qman122/thesetupedit/c5-shroud/mockup/renders/2_head_on_sleepy.png

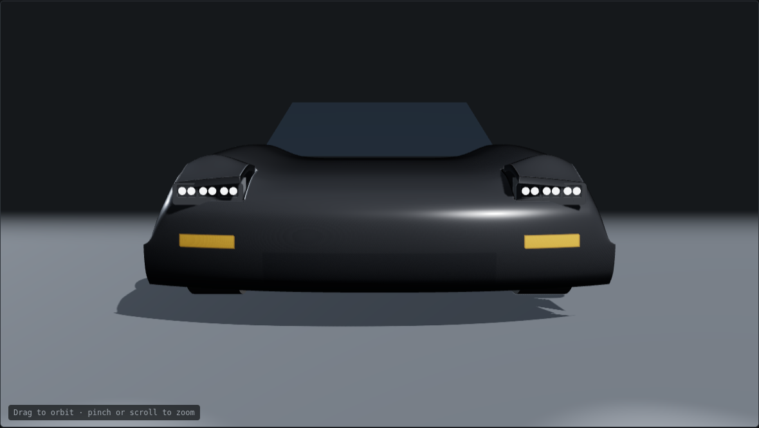
c5-shroud/mockup/renders/2_head_on_sleepy.png
