qman122/thesetupedit/c5-shroud/mockup/renders/4_close_up_full_up.png

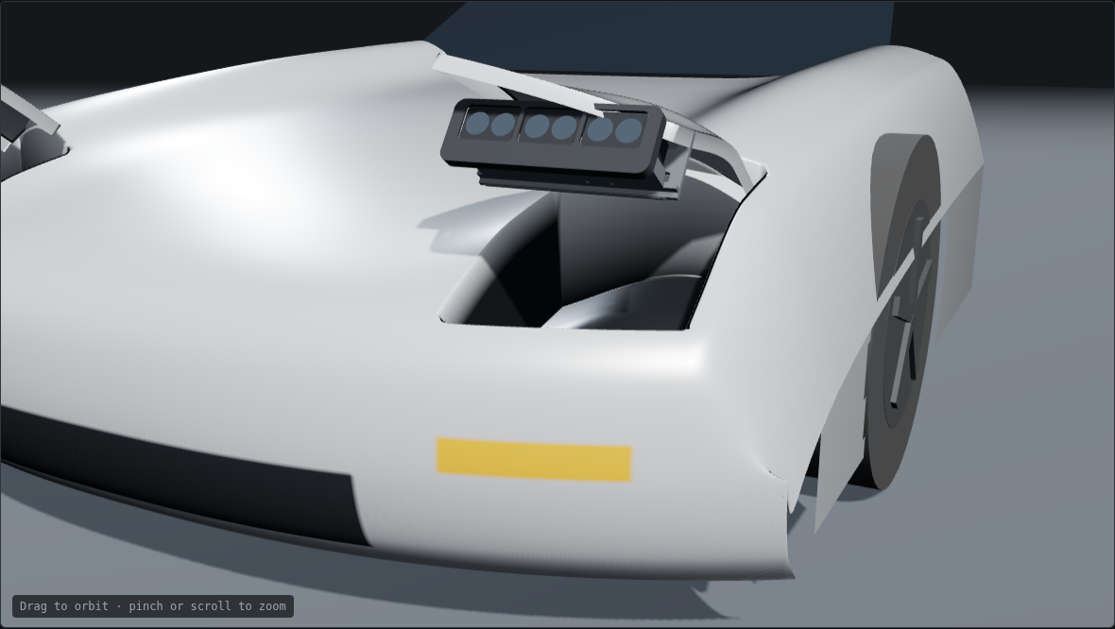
c5-shroud/mockup/renders/4_close_up_full_up.png
