qman122/thesetupedit/c5-shroud/preview/bezel_concepts.png

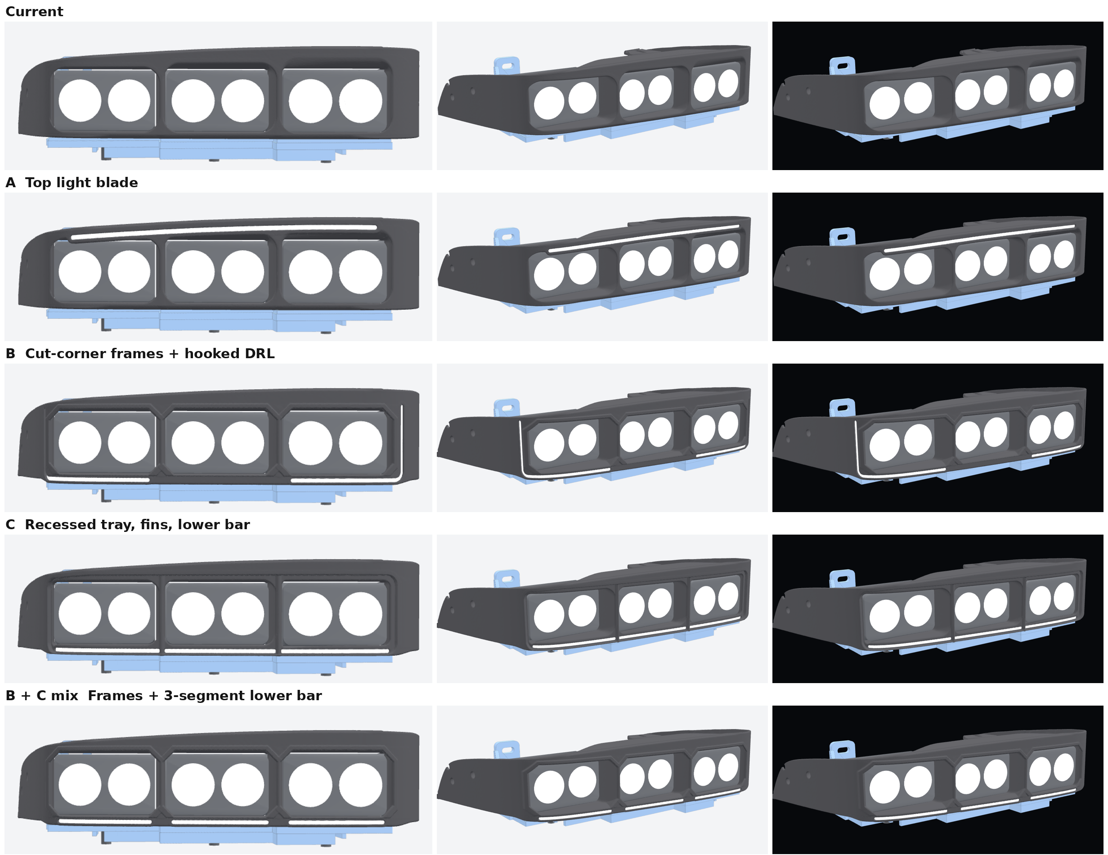
c5-shroud/preview/bezel_concepts.png
