qman122/thesetupedit/docs/img/cable.jpg

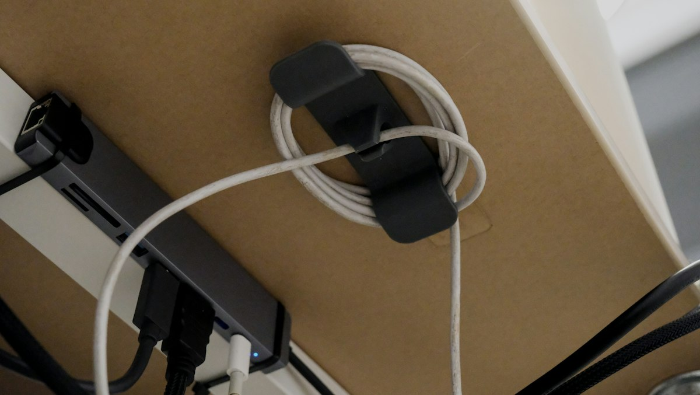
docs/img/cable.jpg
