qman122/thesetupedit/docs/img/hero.jpg

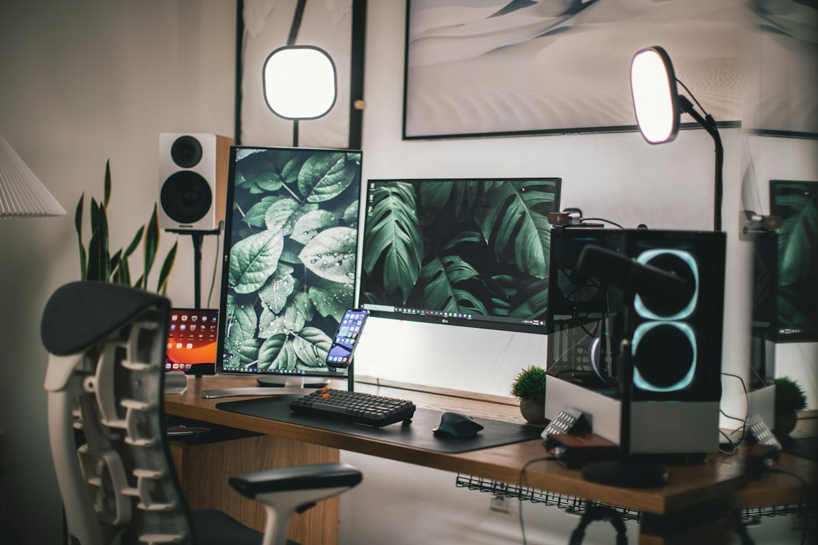
docs/img/hero.jpg
