qman122/thesetupedit/docs/img/minimal.jpg

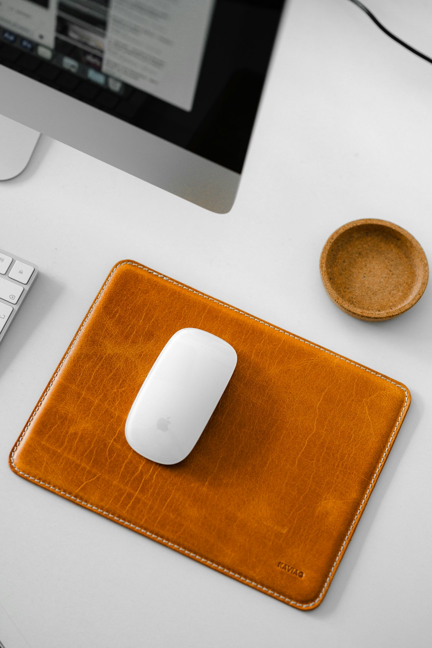
docs/img/minimal.jpg
