qman122/thesetupedit/docs/img/web/backlight-800.jpg

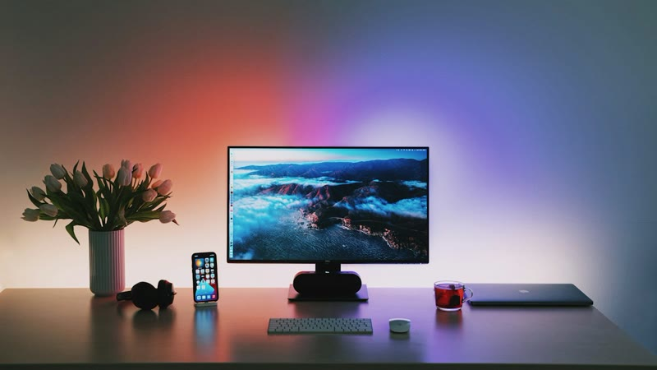
docs/img/web/backlight-800.jpg
