qman122/thesetupedit/docs/img/web/bedroom-480.jpg

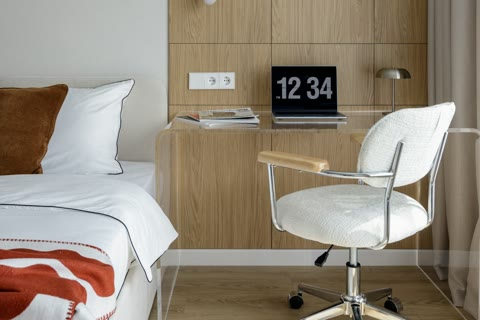
docs/img/web/bedroom-480.jpg
