qman122/thesetupedit/docs/img/web/clean-desk-480.webp

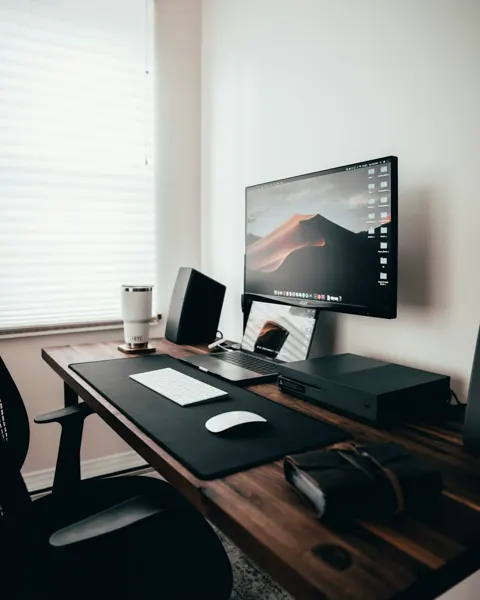
docs/img/web/clean-desk-480.webp
