qman122/thesetupedit/docs/img/web/desk-lamp-480.webp

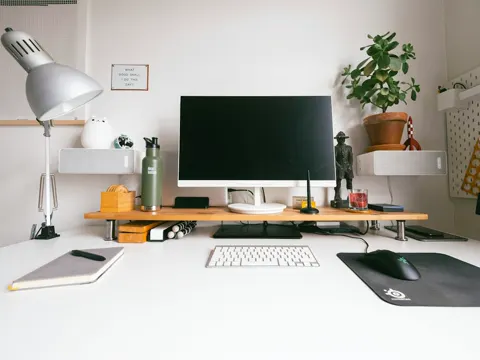
docs/img/web/desk-lamp-480.webp
