qman122/thesetupedit/docs/img/web/small-480.webp

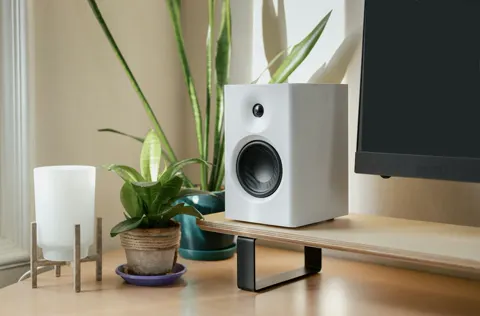
docs/img/web/small-480.webp
