qman122/thesetupedit/docs/img/web/standing-480.jpg

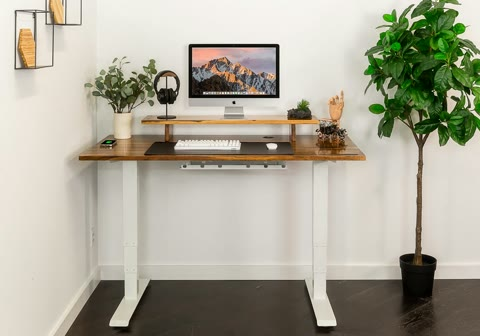
docs/img/web/standing-480.jpg
