qman122/thesetupedit/docs/img/web/trading-800.webp

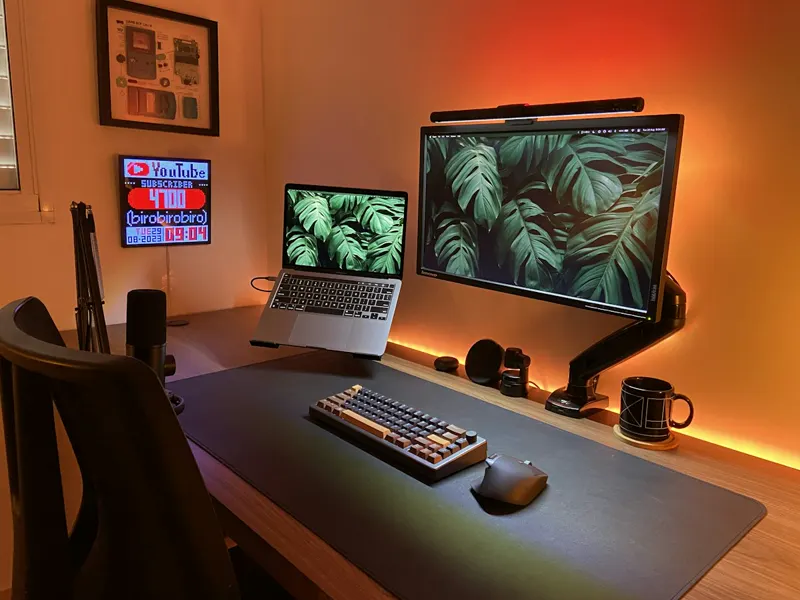
docs/img/web/trading-800.webp
