qman122/thesetupedit/docs/img/web/video-call-480.jpg

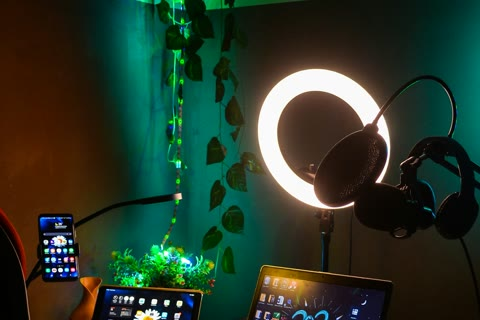
docs/img/web/video-call-480.jpg
