qman122/thesetupedit/docs/img/web/wrist-480.jpg

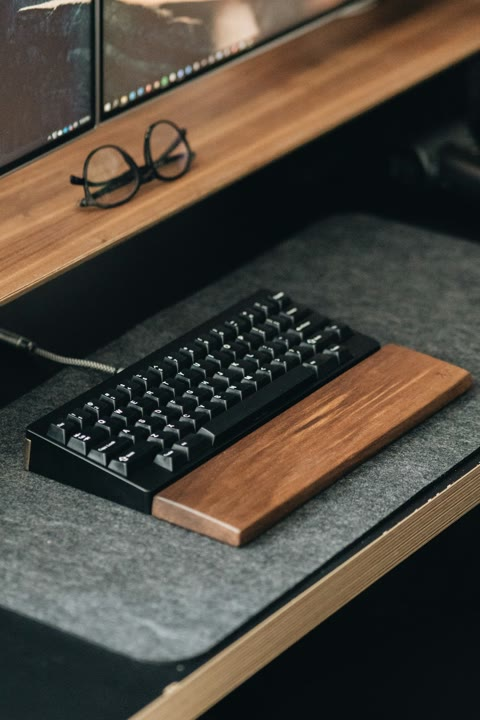
docs/img/web/wrist-480.jpg
