qman122/thesetupedit/docs/media/b3/b3-01-wood-monitor-riser.png

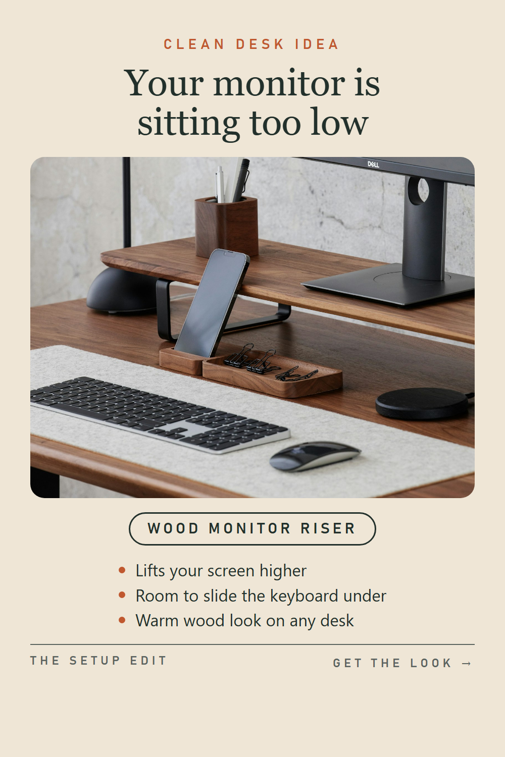
docs/media/b3/b3-01-wood-monitor-riser.png
