qman122/thesetupedit/docs/media/b3/b3-03-ba-stop-hiding-cables.png

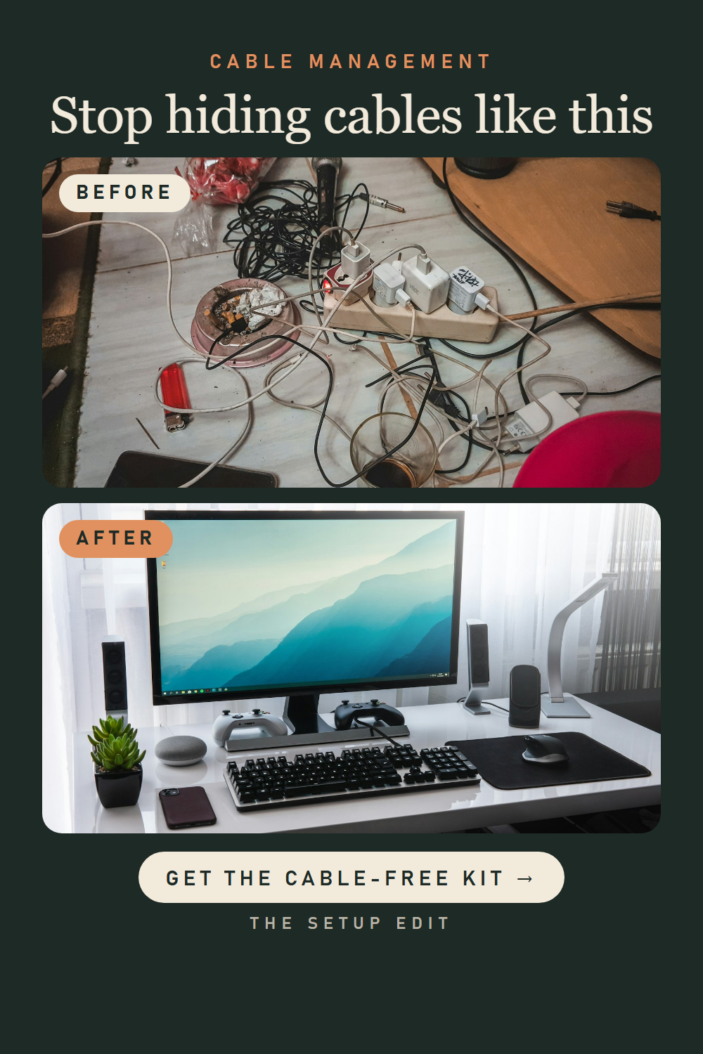
docs/media/b3/b3-03-ba-stop-hiding-cables.png
