qman122/thesetupedit/docs/media/b3/b3-04-75-wireless-keyboard.png

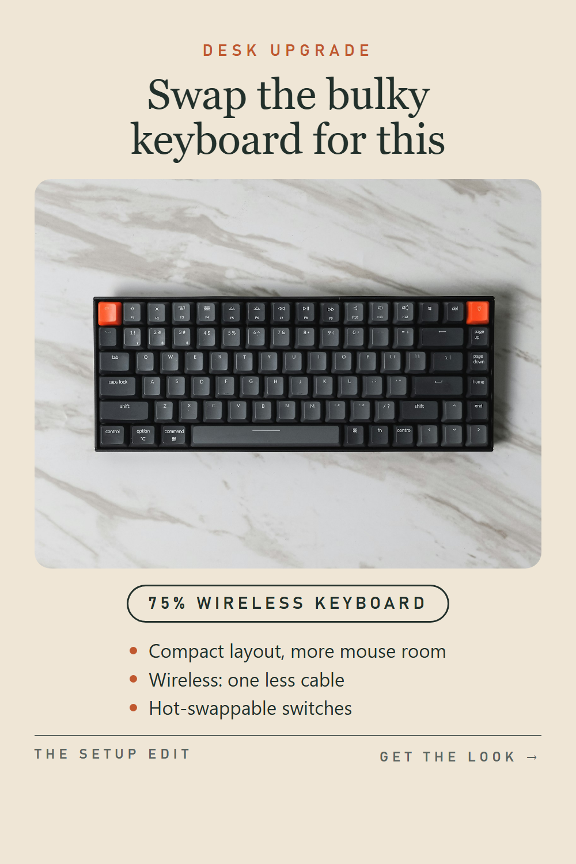
docs/media/b3/b3-04-75-wireless-keyboard.png
