qman122/thesetupedit/docs/media/b3/b3-05-split-cable-sleeve.png

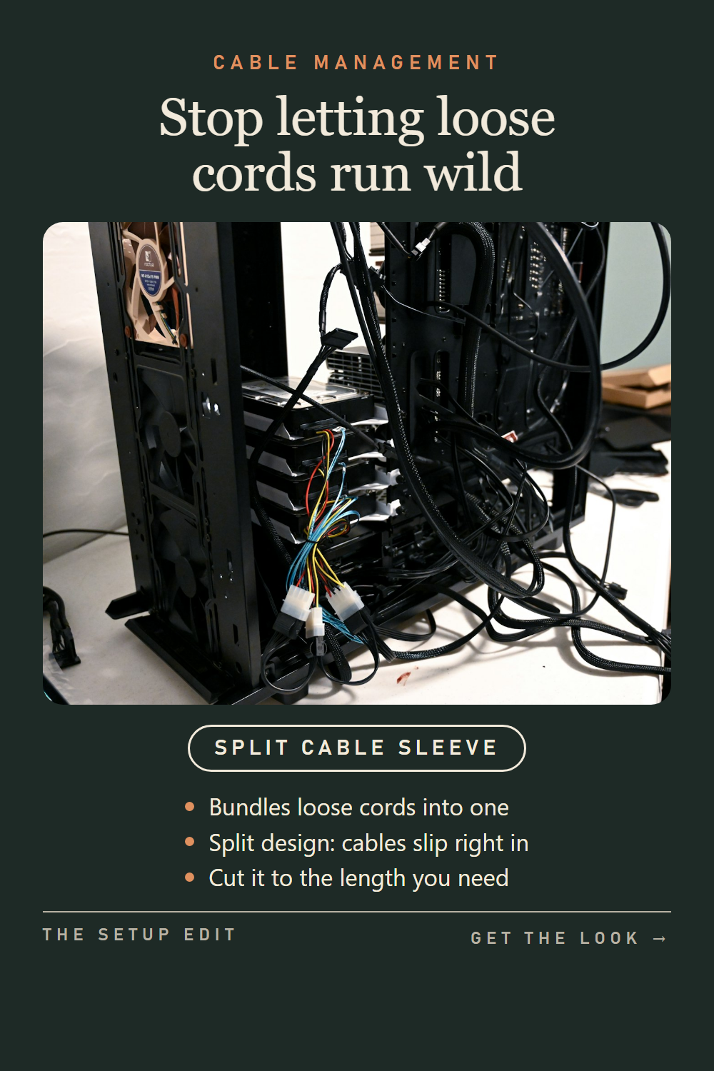
docs/media/b3/b3-05-split-cable-sleeve.png
