qman122/thesetupedit/docs/media/b3/b3-06-small-wall-desk.png

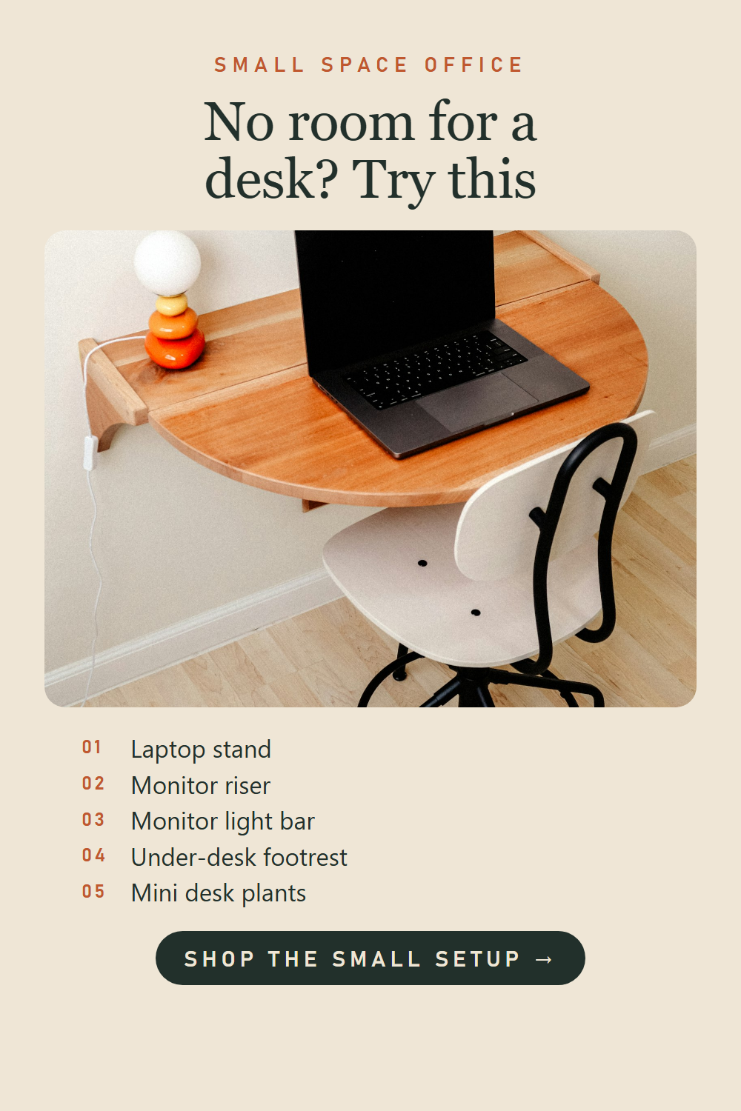
docs/media/b3/b3-06-small-wall-desk.png
