qman122/thesetupedit/docs/media/b3/b3-08-felt-desk-mat.png

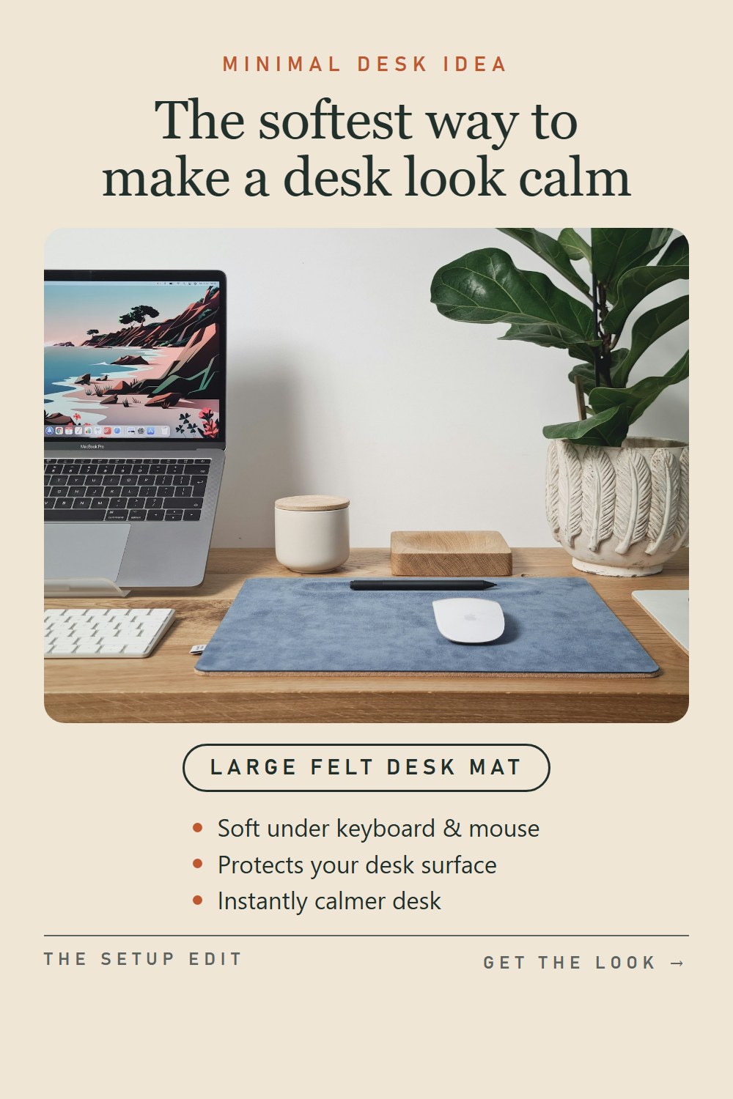
docs/media/b3/b3-08-felt-desk-mat.png
