qman122/thesetupedit/docs/media/b3/b3-14-clean-minimal-desk.png

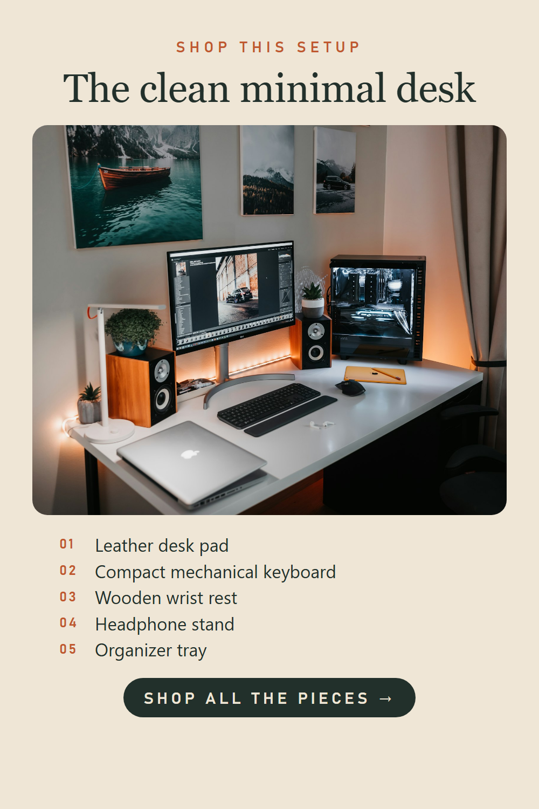
docs/media/b3/b3-14-clean-minimal-desk.png
