qman122/thesetupedit/docs/media/b3/b3-18-trader-checklist.png

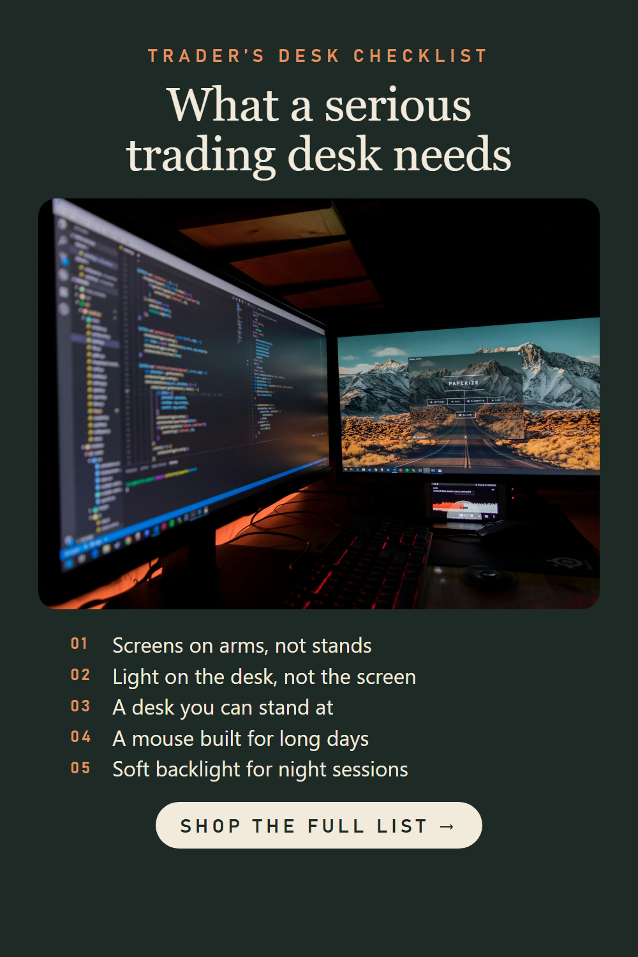
docs/media/b3/b3-18-trader-checklist.png
