qman122/thesetupedit/docs/media/b3/b3-21-bedroom-office.png

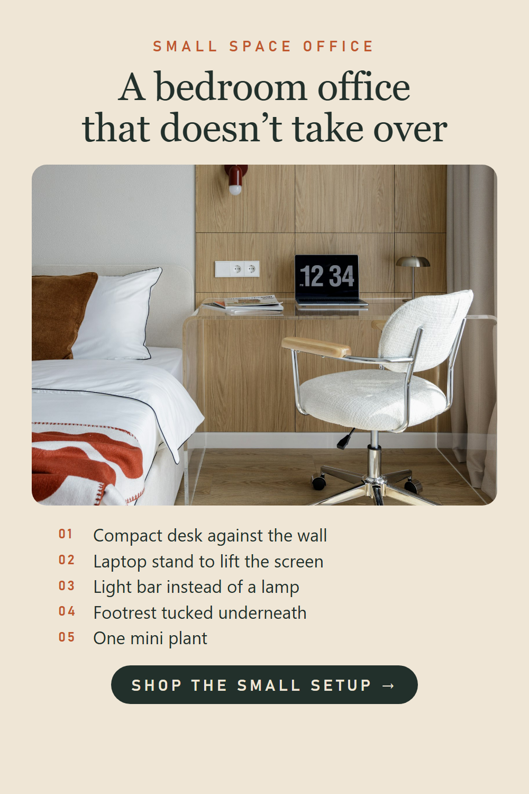
docs/media/b3/b3-21-bedroom-office.png
