qman122/thesetupedit/docs/media/b3/b3-23-two-tier-organizer.png

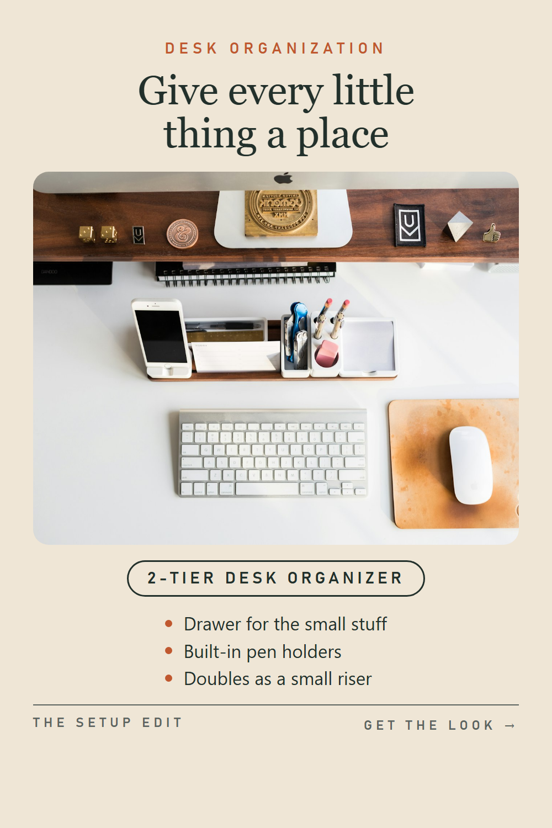
docs/media/b3/b3-23-two-tier-organizer.png
