qman122/thesetupedit/docs/media/b3/b3-24-ba-chaos-to-calm.png

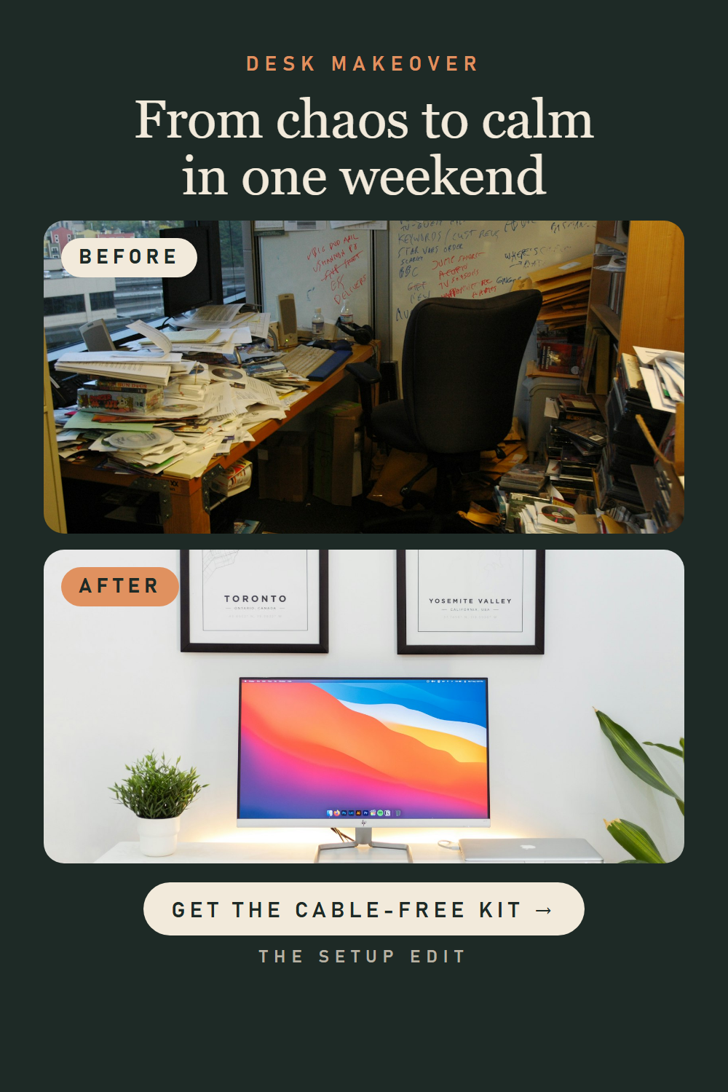
docs/media/b3/b3-24-ba-chaos-to-calm.png
