qman122/thesetupedit/docs/media/b3/b3-25-monitor-light-bar.png

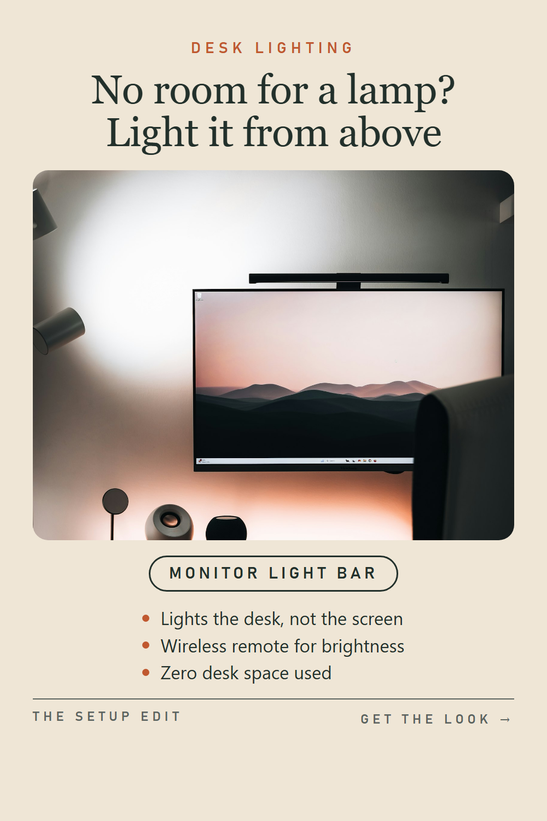
docs/media/b3/b3-25-monitor-light-bar.png
