qman122/thesetupedit/docs/media/b3/b3-26-triple-monitor-base.png

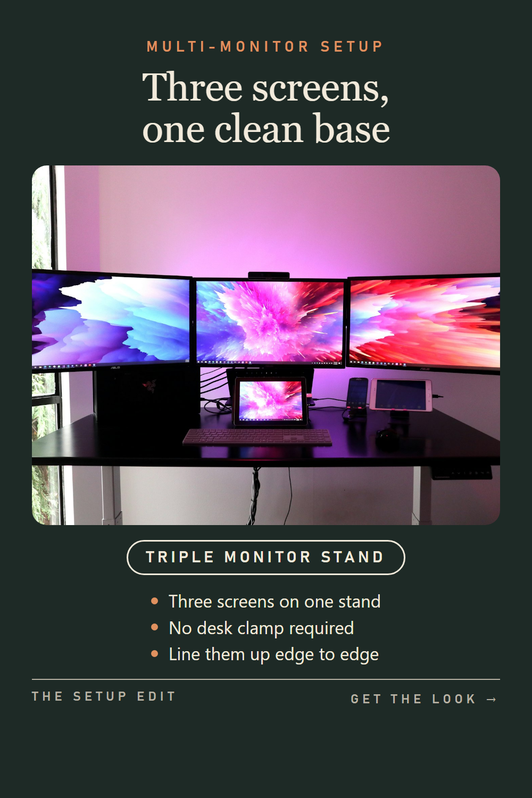
docs/media/b3/b3-26-triple-monitor-base.png
