qman122/thesetupedit/docs/media/b3/b3-28-multi-device-mouse.png

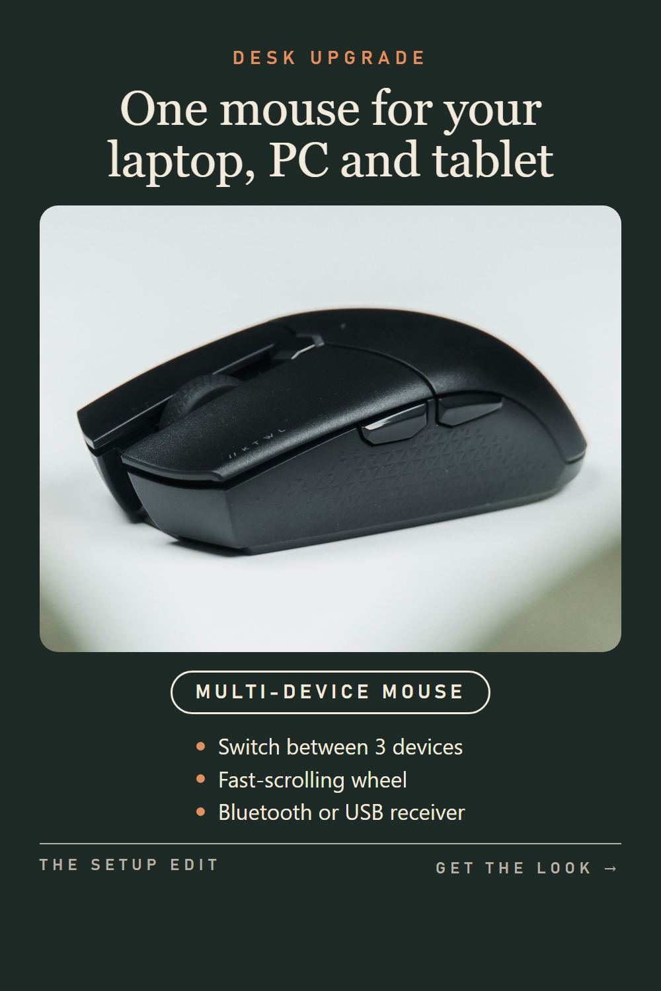
docs/media/b3/b3-28-multi-device-mouse.png
