qman122/thesetupedit/docs/media/b3/b3-30-1080p-webcam.png

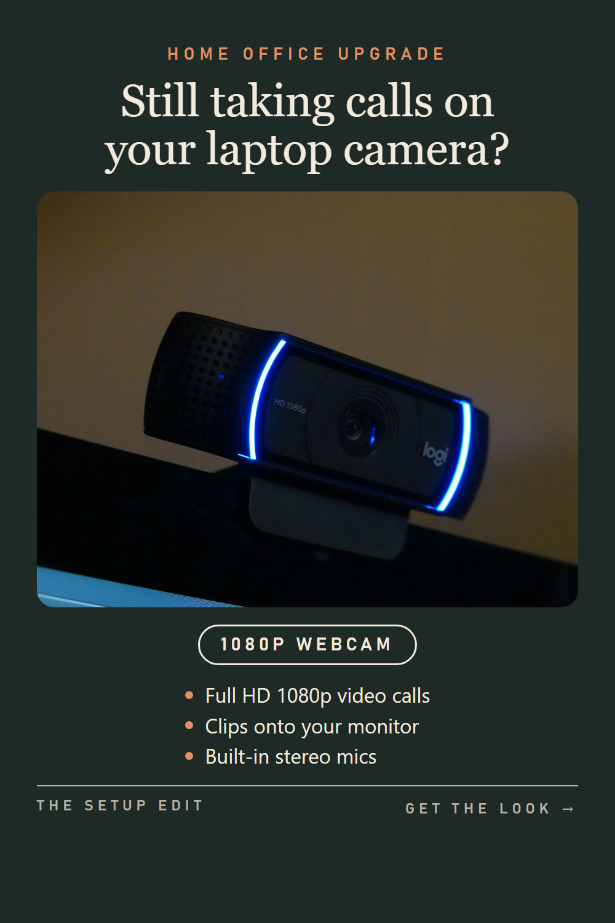
docs/media/b3/b3-30-1080p-webcam.png
