qman122/thesetupedit/docs/media/b3/b3-31-desk-clamp-power-strip.png

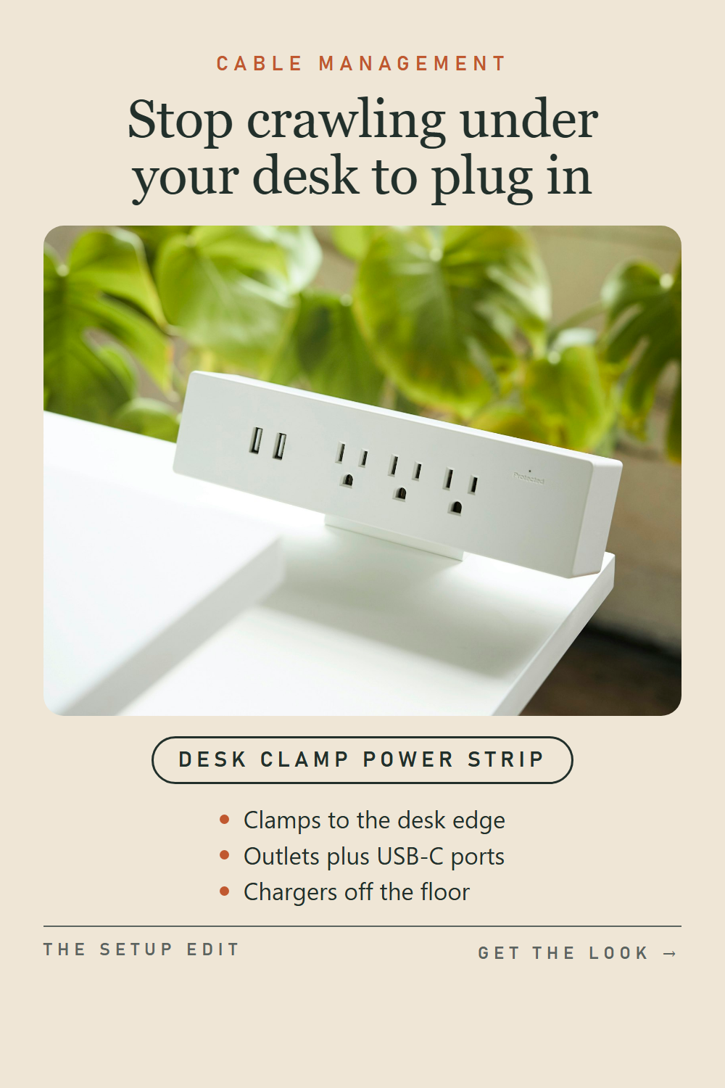
docs/media/b3/b3-31-desk-clamp-power-strip.png
