qman122/thesetupedit/docs/media/b3/b3-33-calm-home-office.png

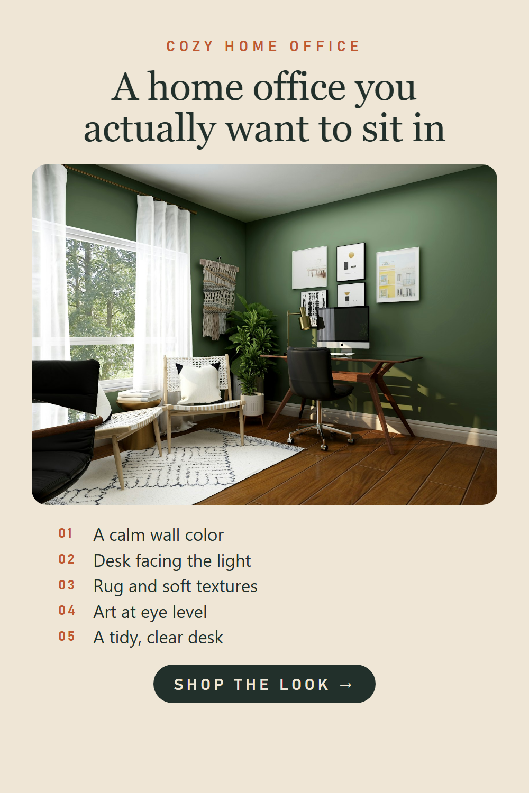
docs/media/b3/b3-33-calm-home-office.png
