qman122/thesetupedit/docs/media/b3/b3-39-home-office-desk-lamp.png

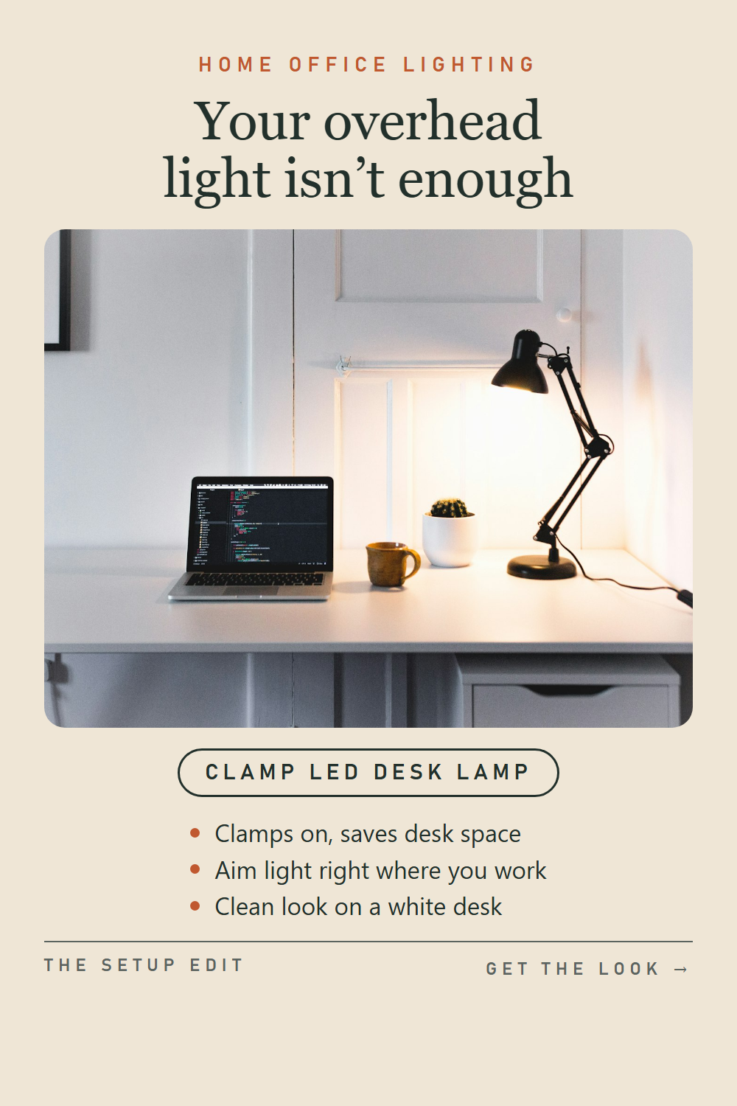
docs/media/b3/b3-39-home-office-desk-lamp.png
