qman122/thesetupedit/docs/media/b3/b3-40-phone-charging-stand.png

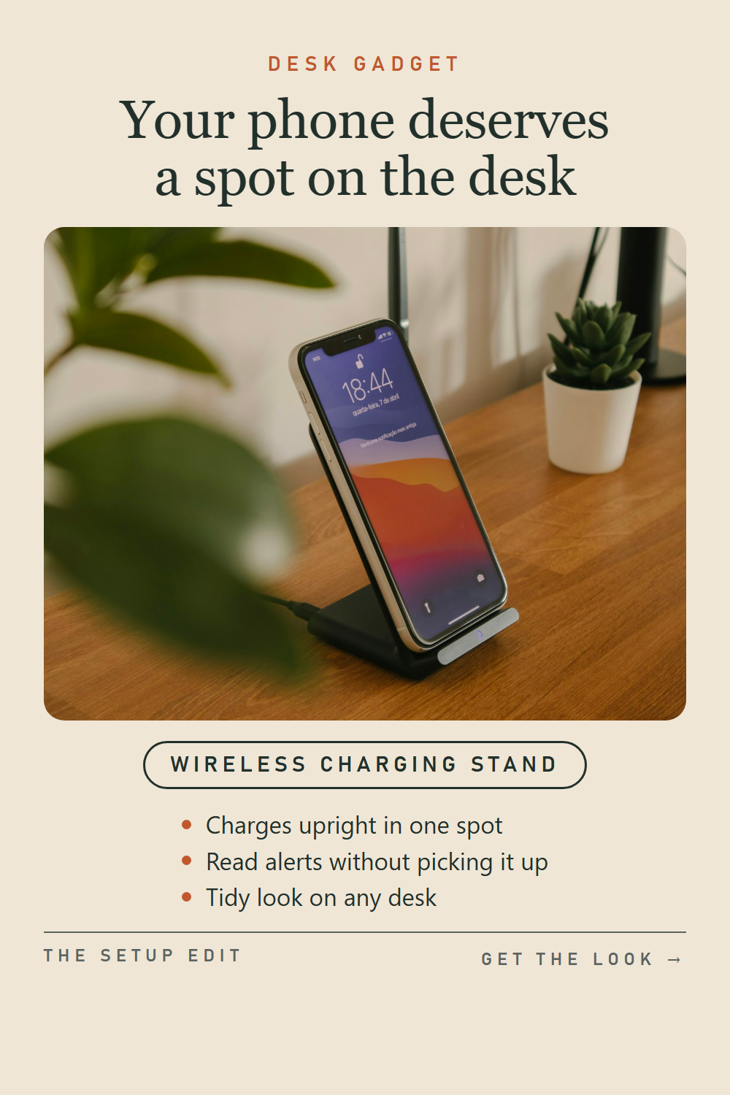
docs/media/b3/b3-40-phone-charging-stand.png
