qman122/thesetupedit/docs/media/b4/b4-01-ergonomic-mesh-chair.png

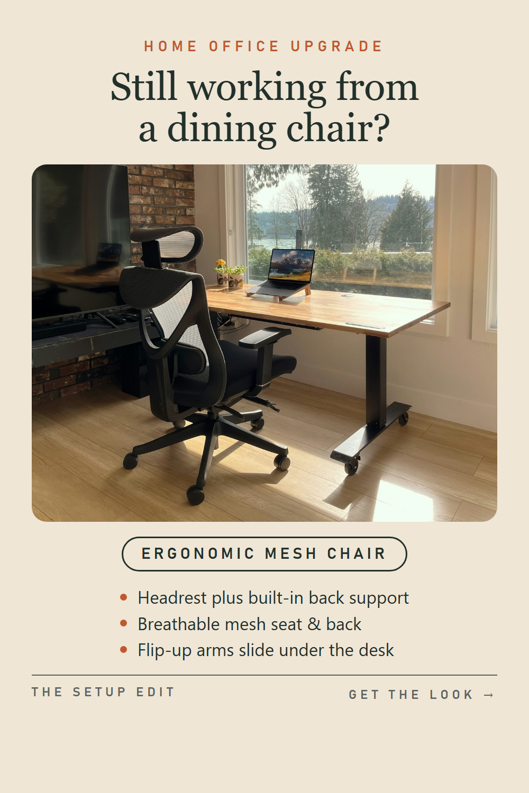
docs/media/b4/b4-01-ergonomic-mesh-chair.png
