qman122/thesetupedit/docs/media/b4/b4-10-keyboard-under-riser.png

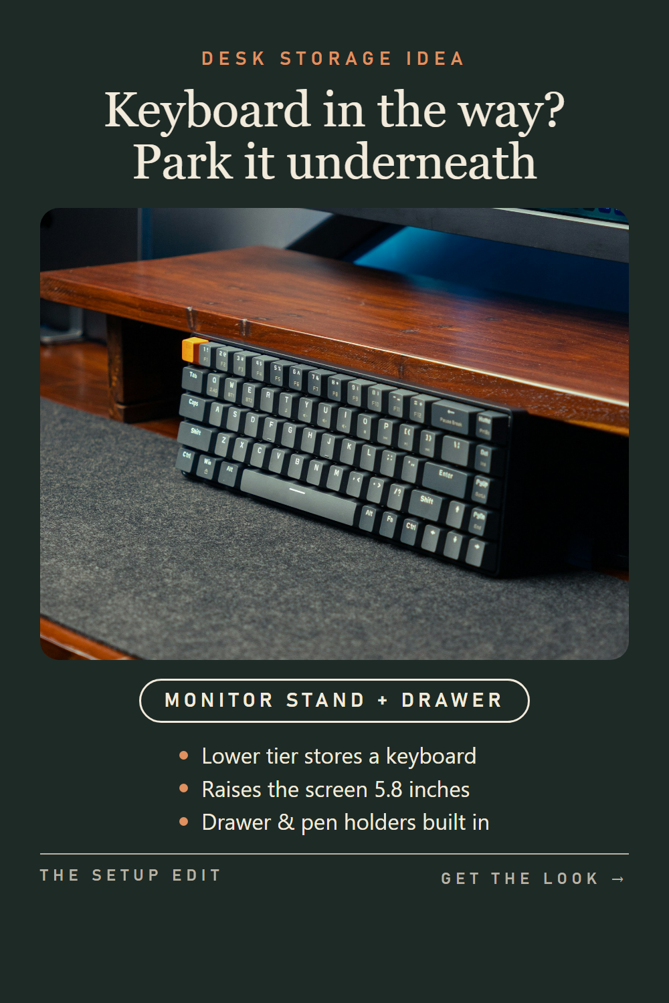
docs/media/b4/b4-10-keyboard-under-riser.png
