qman122/thesetupedit/docs/media/b4/b4-11-free-cable-checklist.png

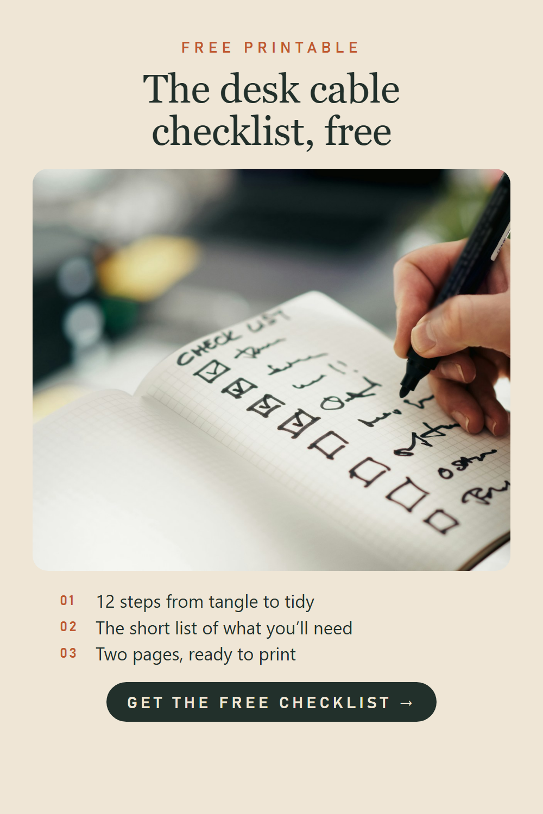
docs/media/b4/b4-11-free-cable-checklist.png
