qman122/thesetupedit/docs/media/b4/b4-12-floating-shelves-above-desk.png

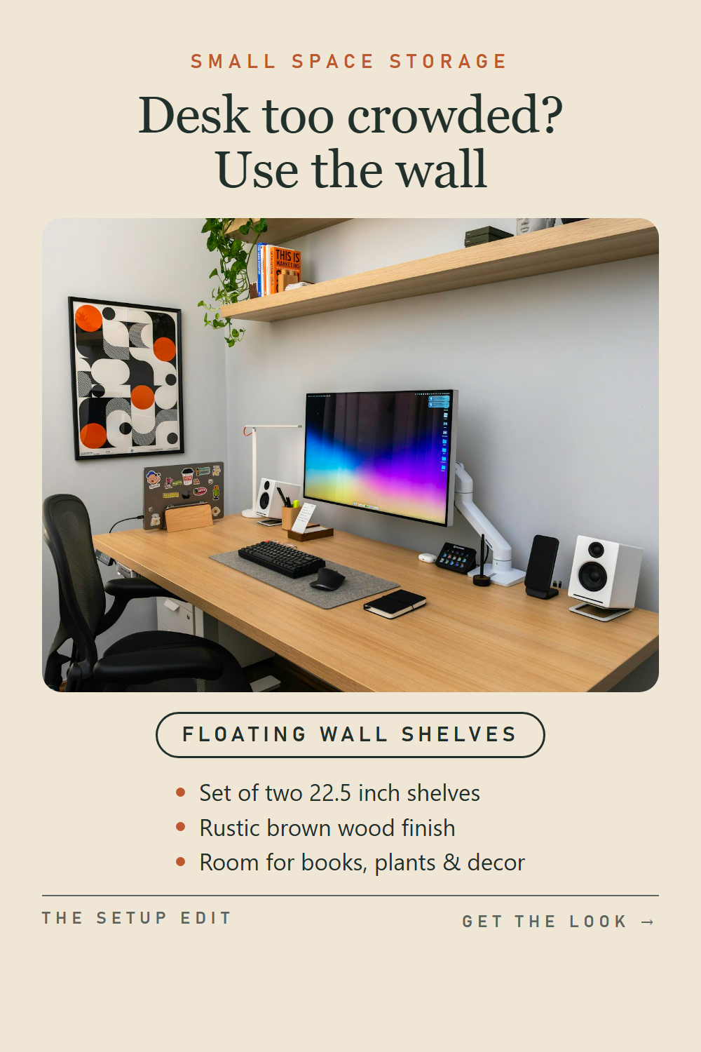
docs/media/b4/b4-12-floating-shelves-above-desk.png
