qman122/thesetupedit/docs/media/b4/b4-17-black-minimal-desk.png

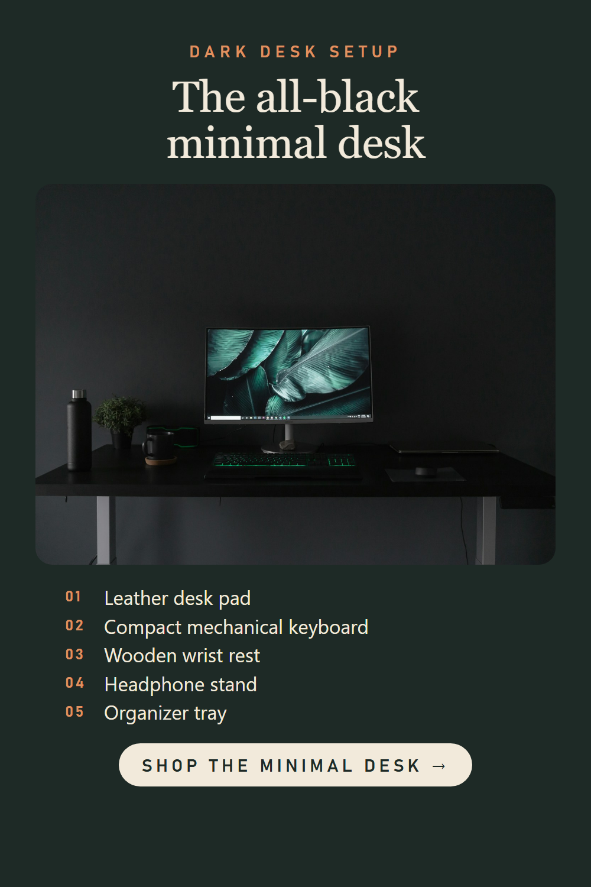
docs/media/b4/b4-17-black-minimal-desk.png
