qman122/thesetupedit/docs/media/b4/b4-19-clip-on-desk-fan.png

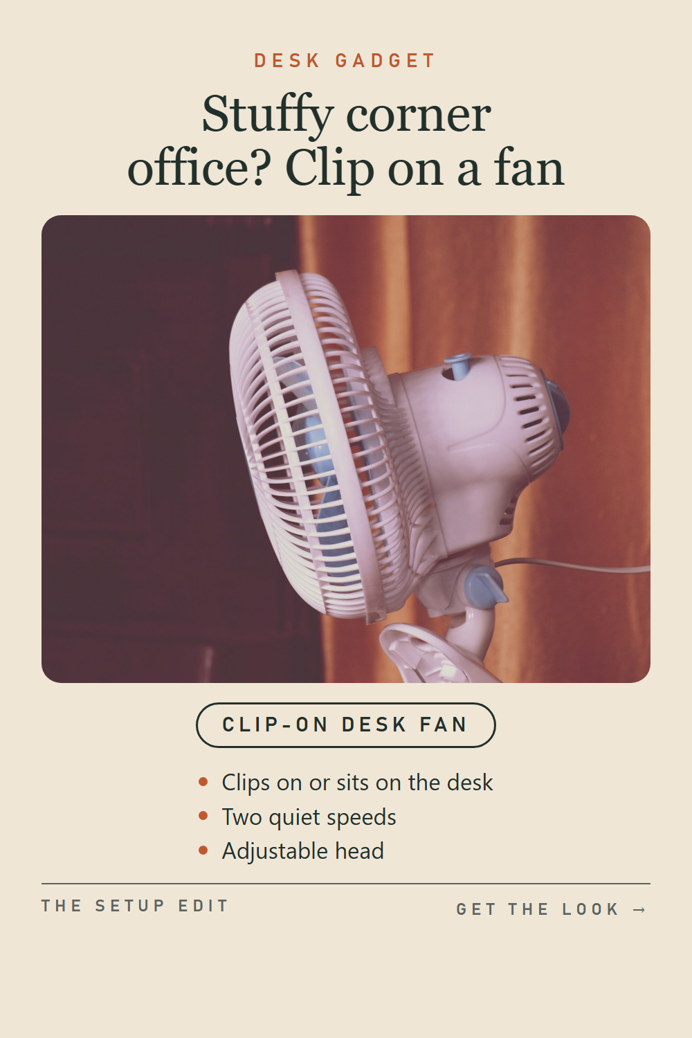
docs/media/b4/b4-19-clip-on-desk-fan.png
