qman122/thesetupedit/docs/media/b4/b4-22-small-air-purifier.png

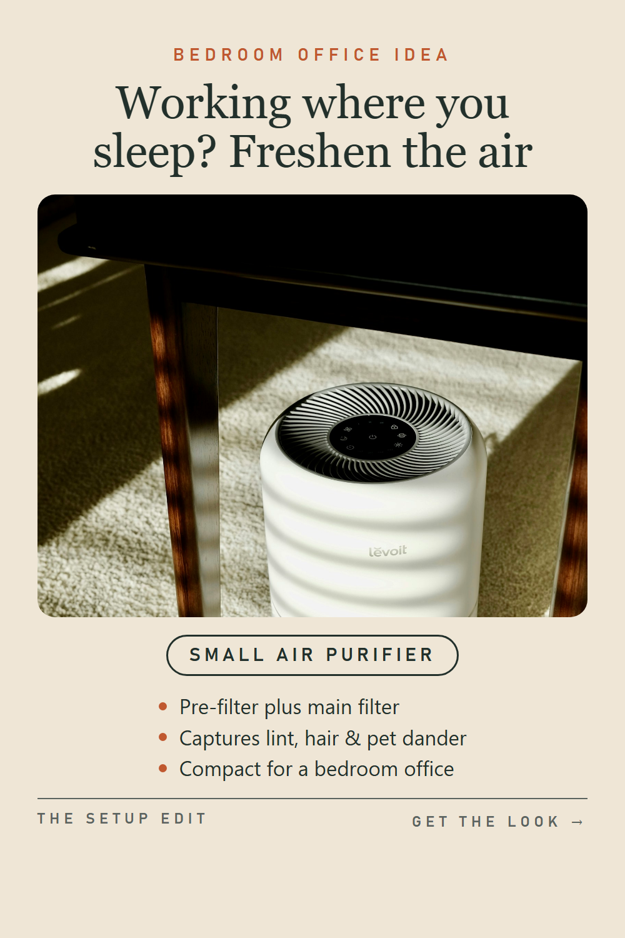
docs/media/b4/b4-22-small-air-purifier.png
