qman122/thesetupedit/docs/media/b4/b4-26-where-cables-hide.png

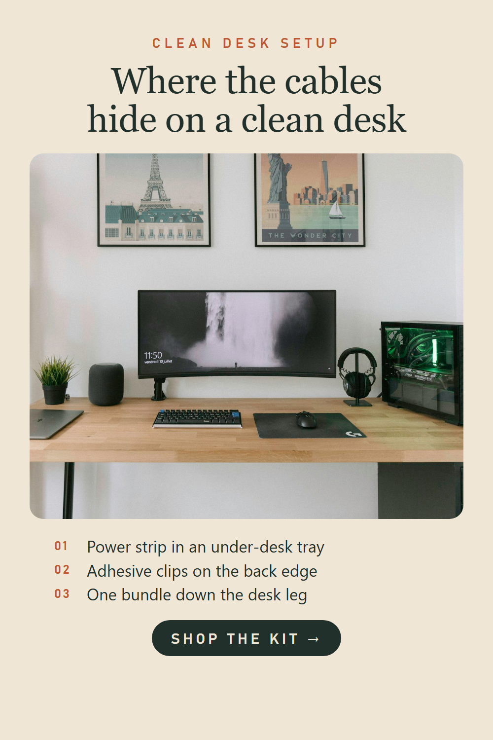
docs/media/b4/b4-26-where-cables-hide.png
