qman122/thesetupedit/docs/media/b4/b4-30-clamp-on-keyboard-tray.png

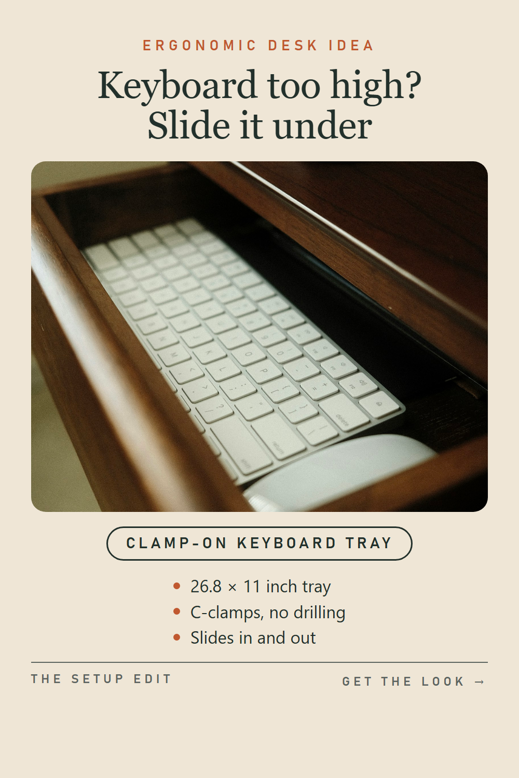
docs/media/b4/b4-30-clamp-on-keyboard-tray.png
