qman122/thesetupedit/docs/media/b4/b4-35-ba-cable-pile.png

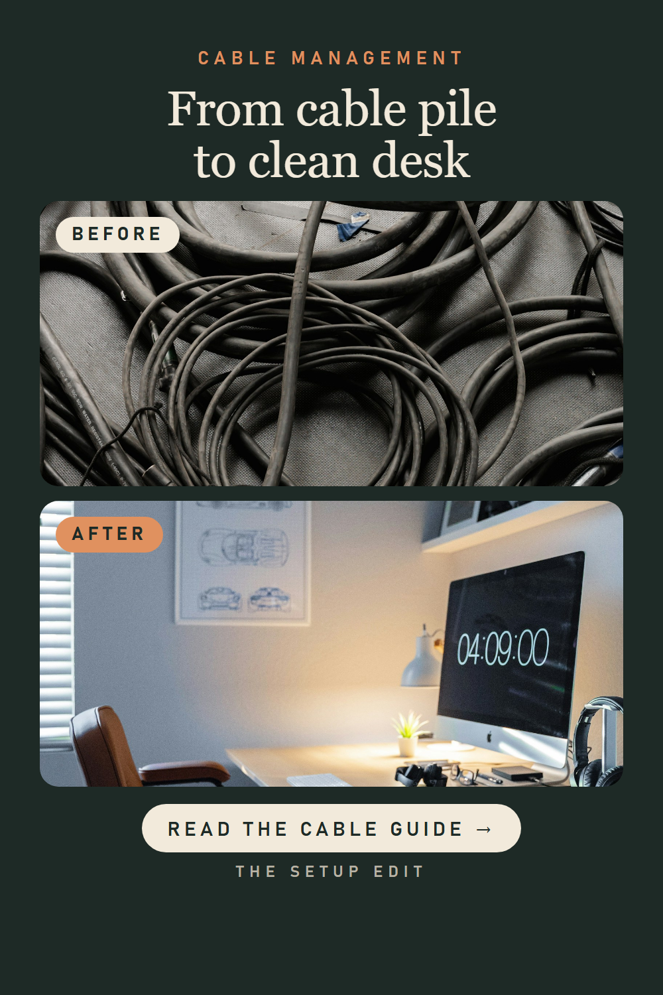
docs/media/b4/b4-35-ba-cable-pile.png
