qman122/thesetupedit/docs/media/b4/b4-36-anc-headphones-deep-work.png

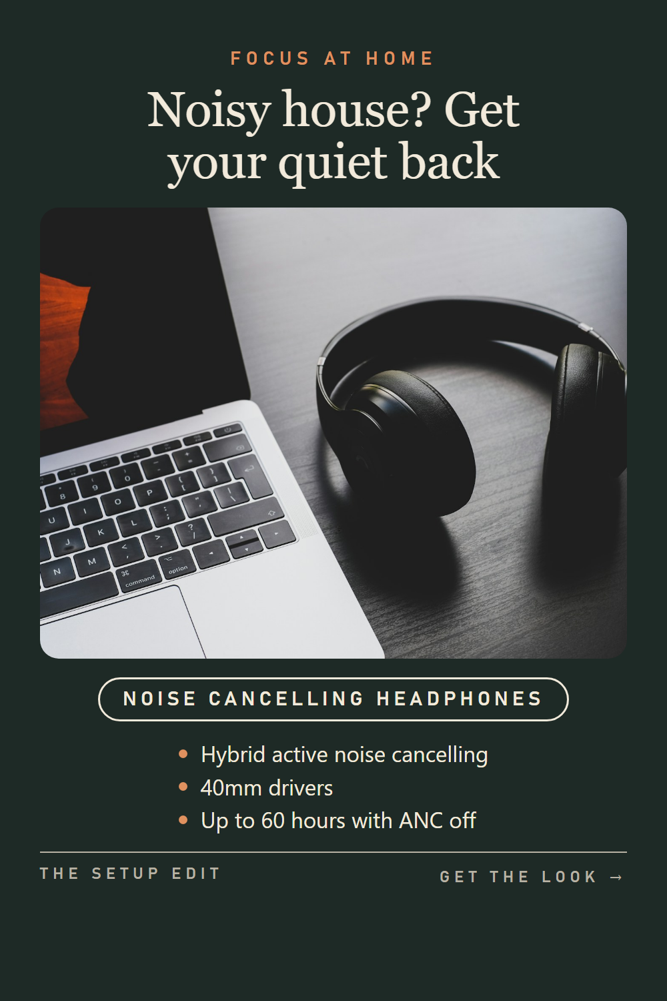
docs/media/b4/b4-36-anc-headphones-deep-work.png
