qman122/thesetupedit/docs/media/b4/b4-37-light-bar-dark-desk.png

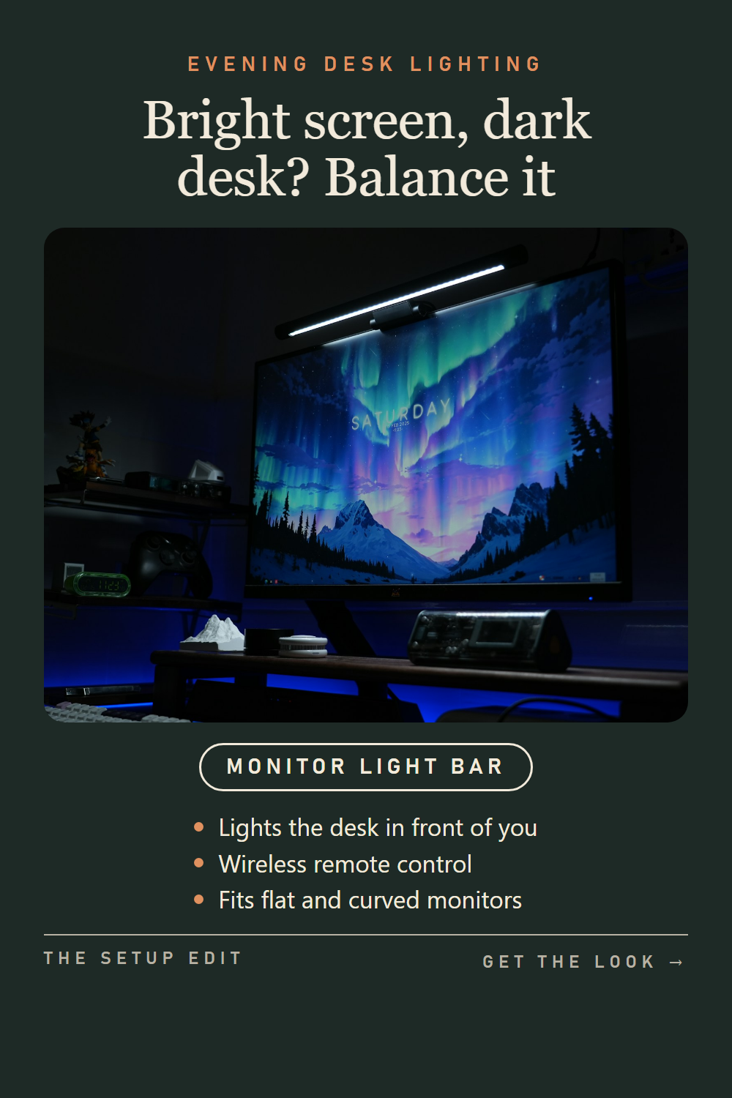
docs/media/b4/b4-37-light-bar-dark-desk.png
