qman122/thesetupedit/docs/media/b4/b4-38-laptop-to-trading-desk.png

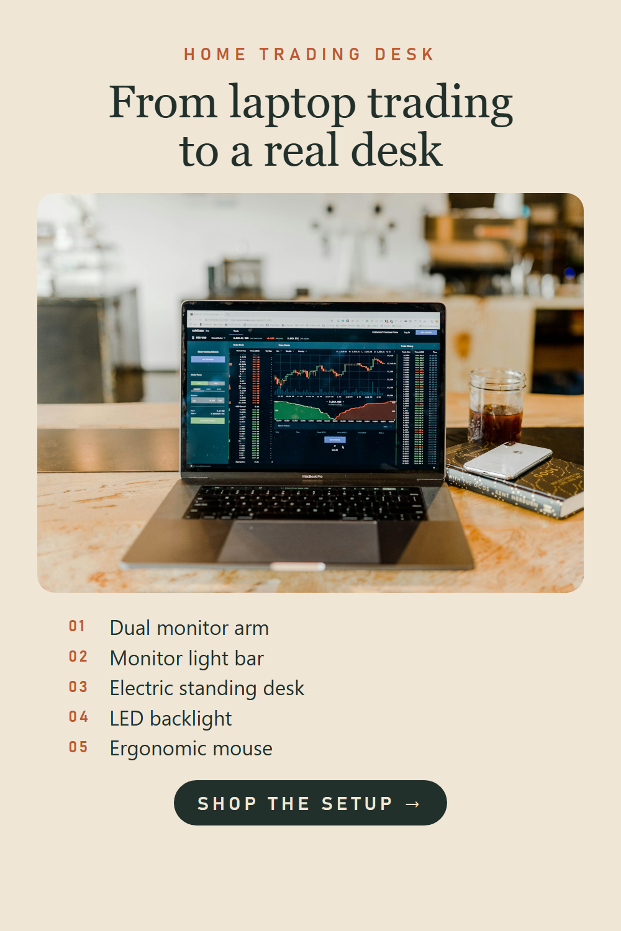
docs/media/b4/b4-38-laptop-to-trading-desk.png
