qman122/thesetupedit/docs/media/b5/b5-07-monitor-arm-desk-refresh.png

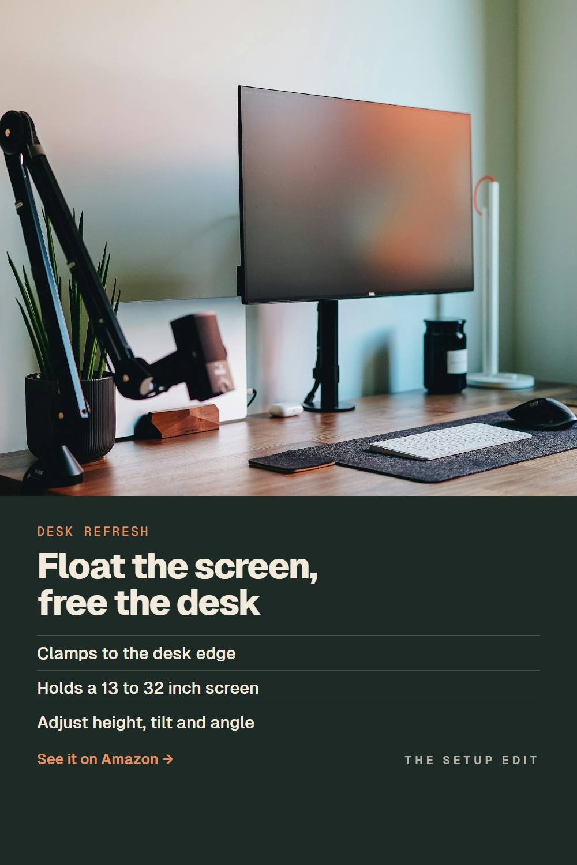
docs/media/b5/b5-07-monitor-arm-desk-refresh.png
