qman122/thesetupedit/docs/media/b5/b5-08-ba-power-strip-clean-desk.png

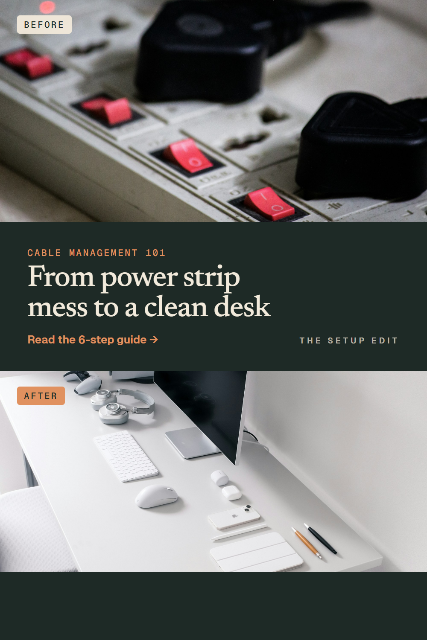
docs/media/b5/b5-08-ba-power-strip-clean-desk.png
