qman122/thesetupedit/docs/media/b5/b5-09-faux-plants-grey-days.png

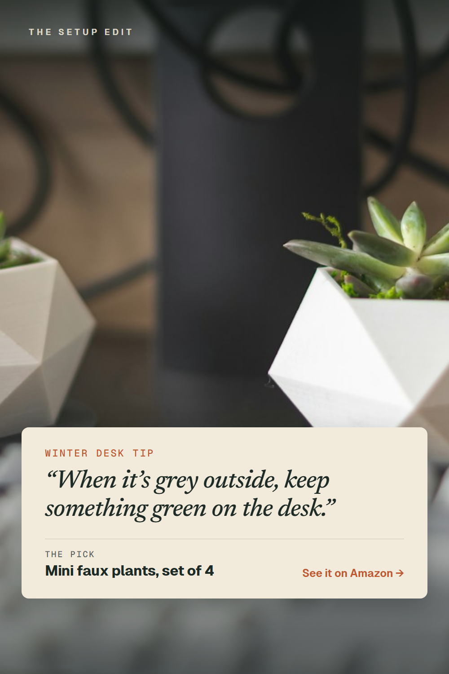
docs/media/b5/b5-09-faux-plants-grey-days.png
