qman122/thesetupedit/docs/media/b5/b5-13-dual-arm-eye-level-tip.png

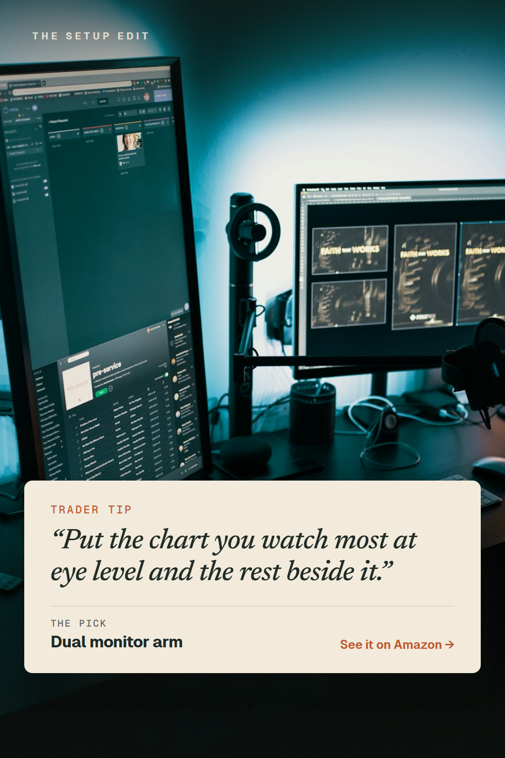
docs/media/b5/b5-13-dual-arm-eye-level-tip.png
