qman122/thesetupedit/docs/media/b5/b5-14-minimal-desk-reset.png

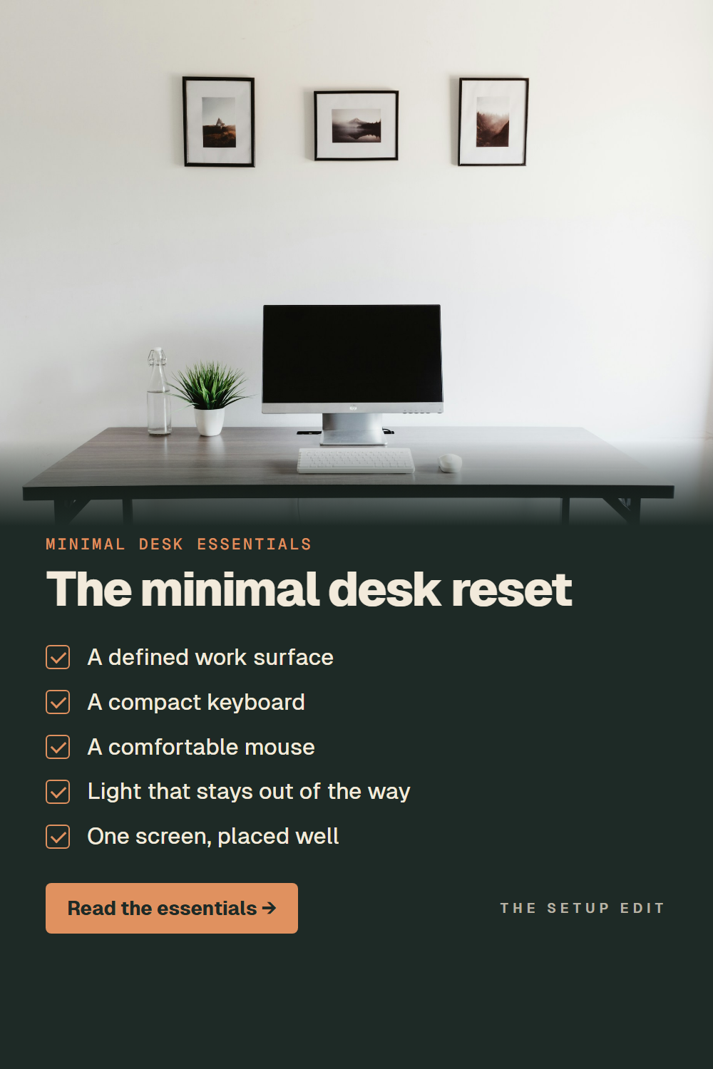
docs/media/b5/b5-14-minimal-desk-reset.png
