qman122/thesetupedit/docs/media/b5/b5-17-trading-desk-one-piece.png

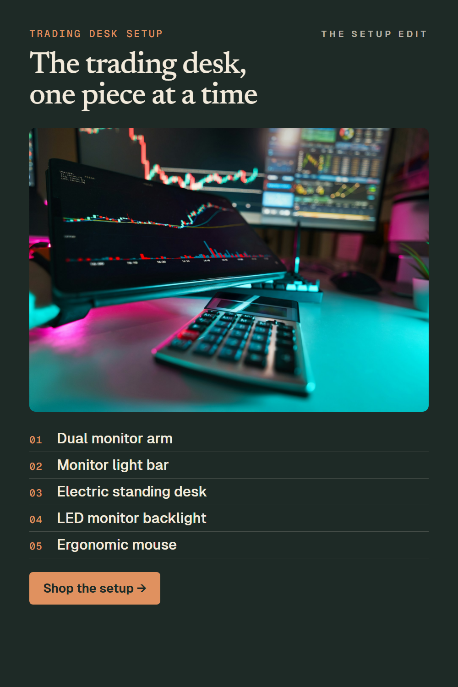
docs/media/b5/b5-17-trading-desk-one-piece.png
