qman122/thesetupedit/docs/media/b5/b5-23-free-checklist-new-year.png

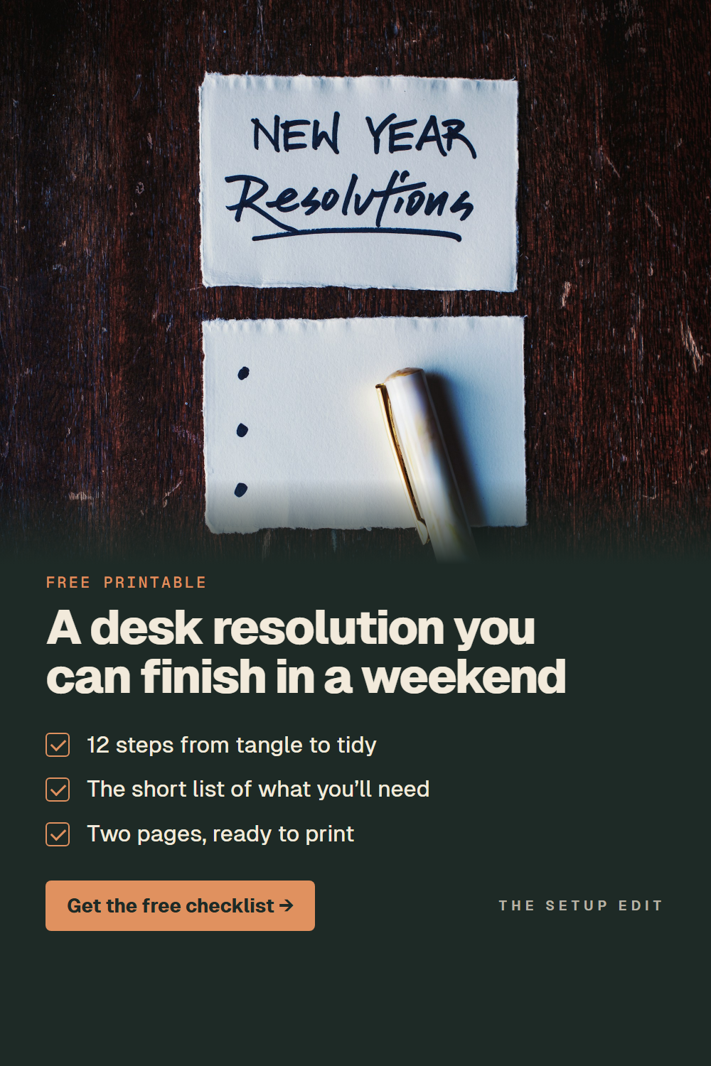
docs/media/b5/b5-23-free-checklist-new-year.png
