qman122/thesetupedit/docs/media/b5/b5-25-aluminum-laptop-stand-small.png

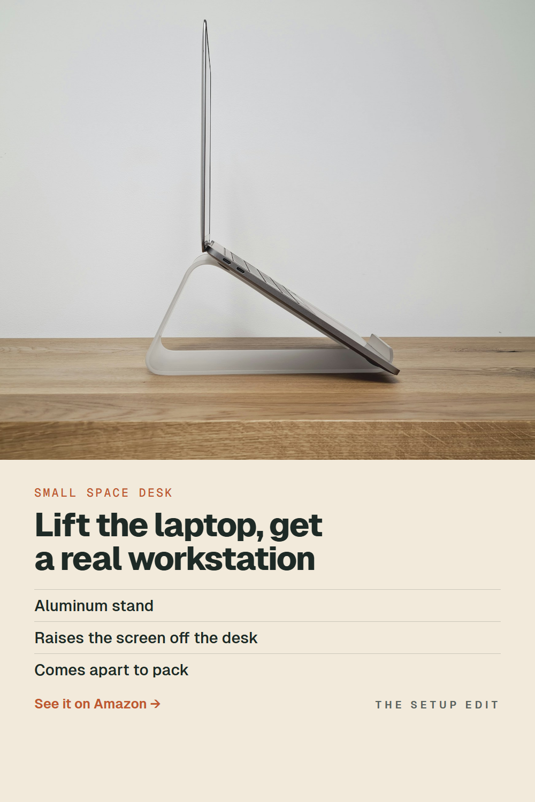
docs/media/b5/b5-25-aluminum-laptop-stand-small.png
