qman122/thesetupedit/docs/media/b5/b5-29-ba-tangle-to-tidy.png

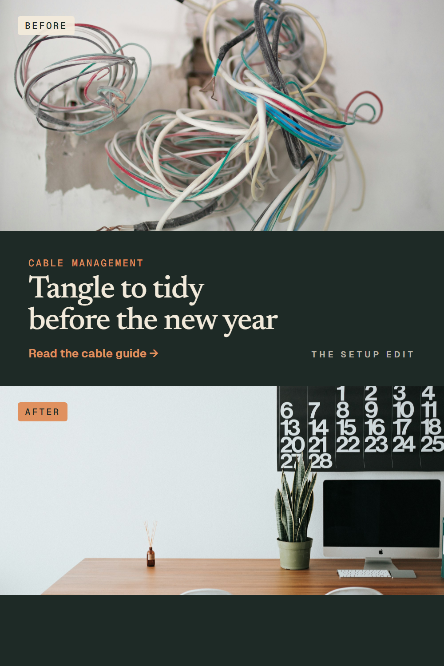
docs/media/b5/b5-29-ba-tangle-to-tidy.png
