qman122/thesetupedit/docs/media/b5/b5-31-felt-mat-calm-desk-tip.png

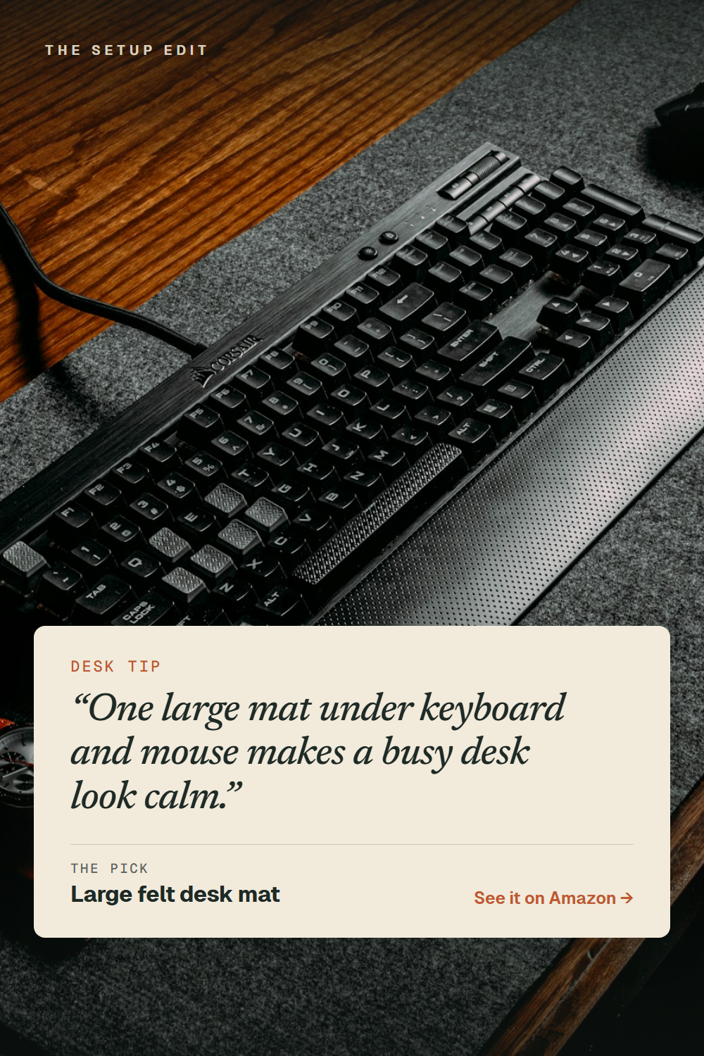
docs/media/b5/b5-31-felt-mat-calm-desk-tip.png
