qman122/thesetupedit/docs/media/b5/b5-36-lamp-early-dark-tip.png

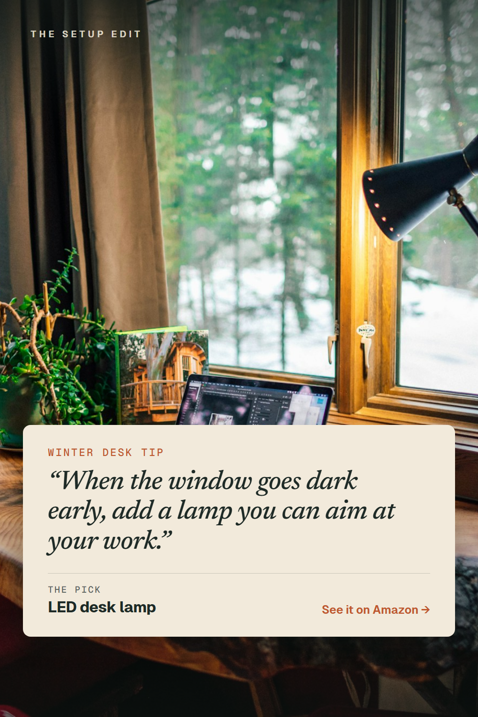
docs/media/b5/b5-36-lamp-early-dark-tip.png
