qman122/thesetupedit/docs/media/b5/b5-37-charging-stand-tidy-gift.png

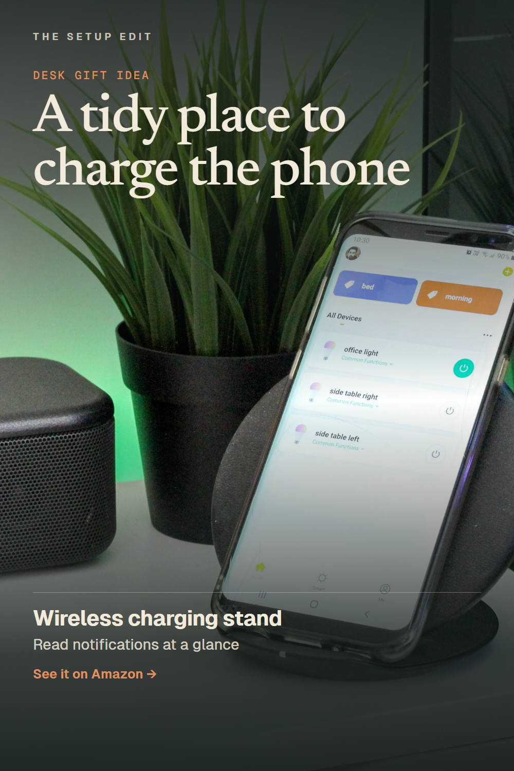
docs/media/b5/b5-37-charging-stand-tidy-gift.png
