qman122/thesetupedit/docs/media/b5/b5-38-gift-ideas-for-traders.png

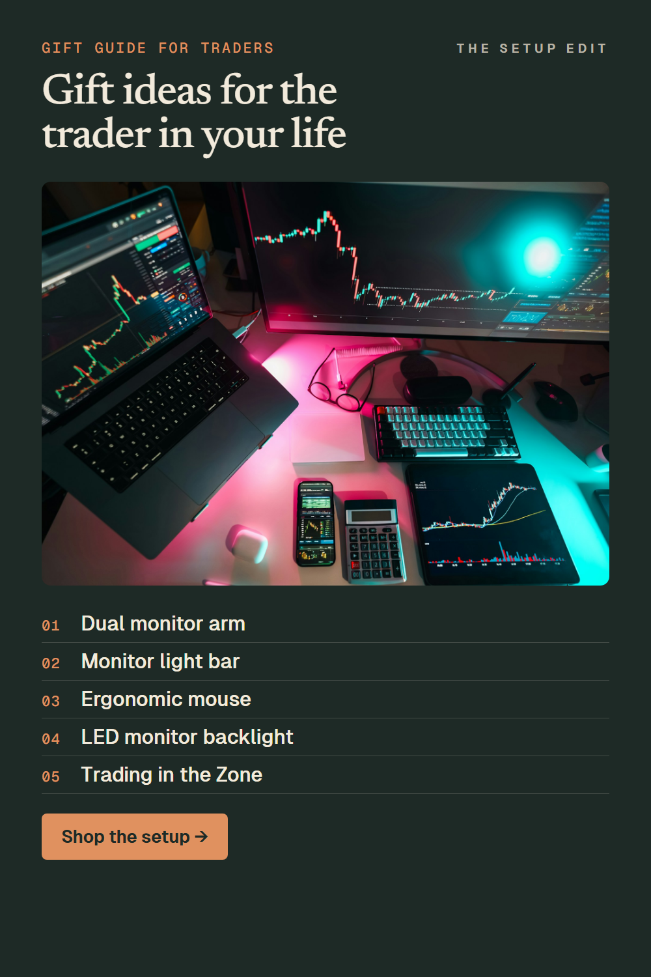
docs/media/b5/b5-38-gift-ideas-for-traders.png
