qman122/thesetupedit/docs/media/b5/b5-39-monitor-arm-trading-notes.png

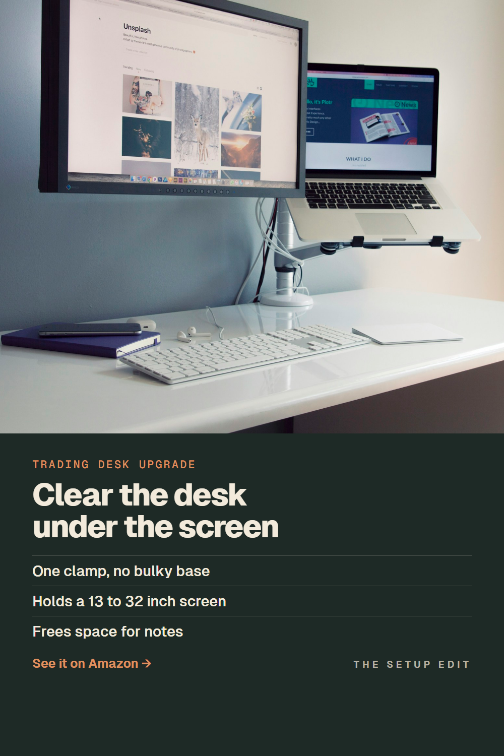
docs/media/b5/b5-39-monitor-arm-trading-notes.png
