qman122/thesetupedit/docs/media/b5/b5-40-dark-pad-white-desk-tip.png

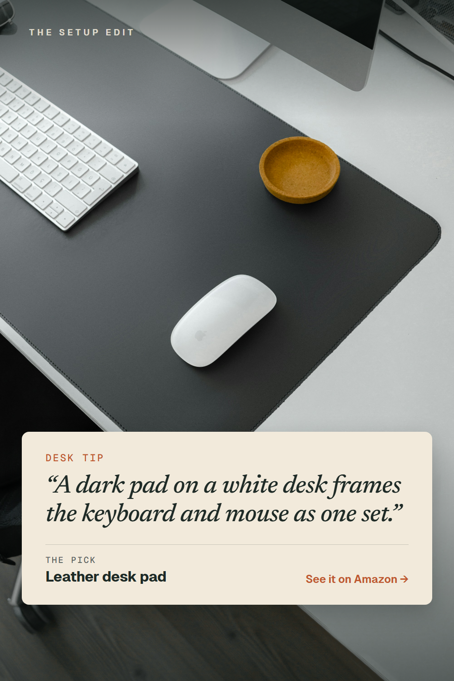
docs/media/b5/b5-40-dark-pad-white-desk-tip.png
