qman122/thesetupedit/docs/media/b5/b5-41-where-power-strip-lives.png

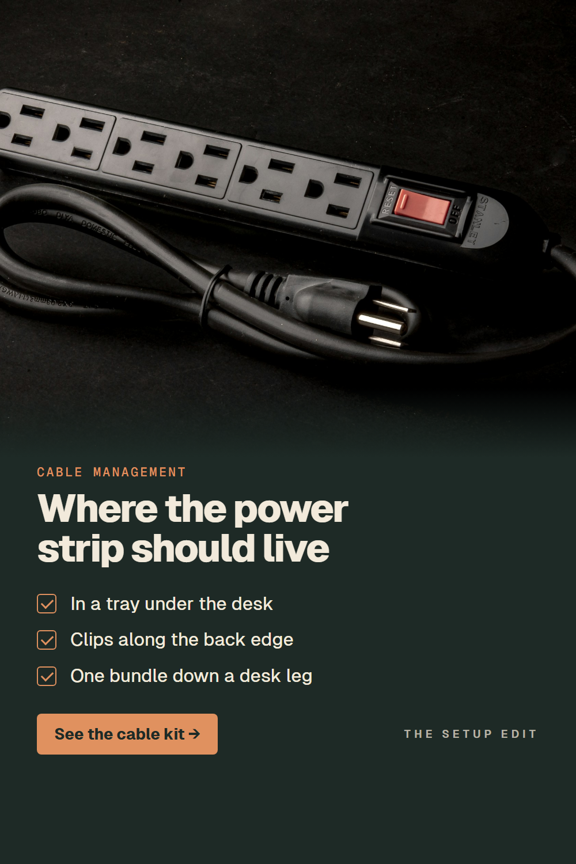
docs/media/b5/b5-41-where-power-strip-lives.png
