qman122/thesetupedit/media/b3/b3-07-triple-monitor-stand.png

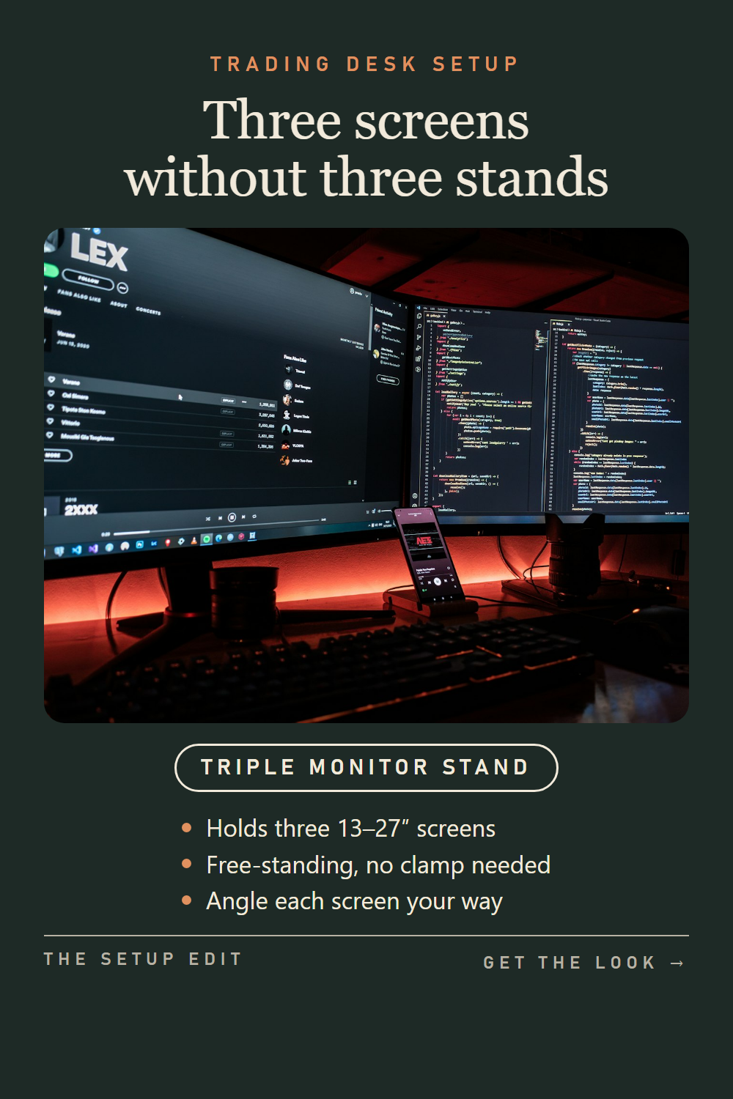
media/b3/b3-07-triple-monitor-stand.png
