qman122/thesetupedit/media/b3/b3-10-wireless-charging-stand.png

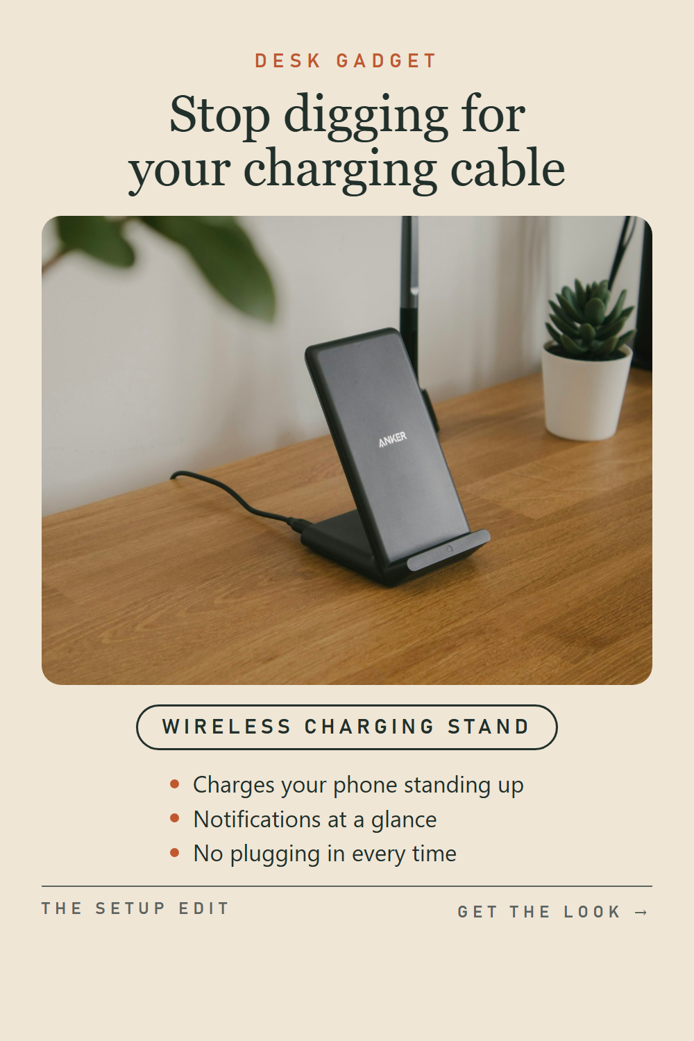
media/b3/b3-10-wireless-charging-stand.png
