qman122/thesetupedit/media/b3/b3-16-usb-desk-speakers.png

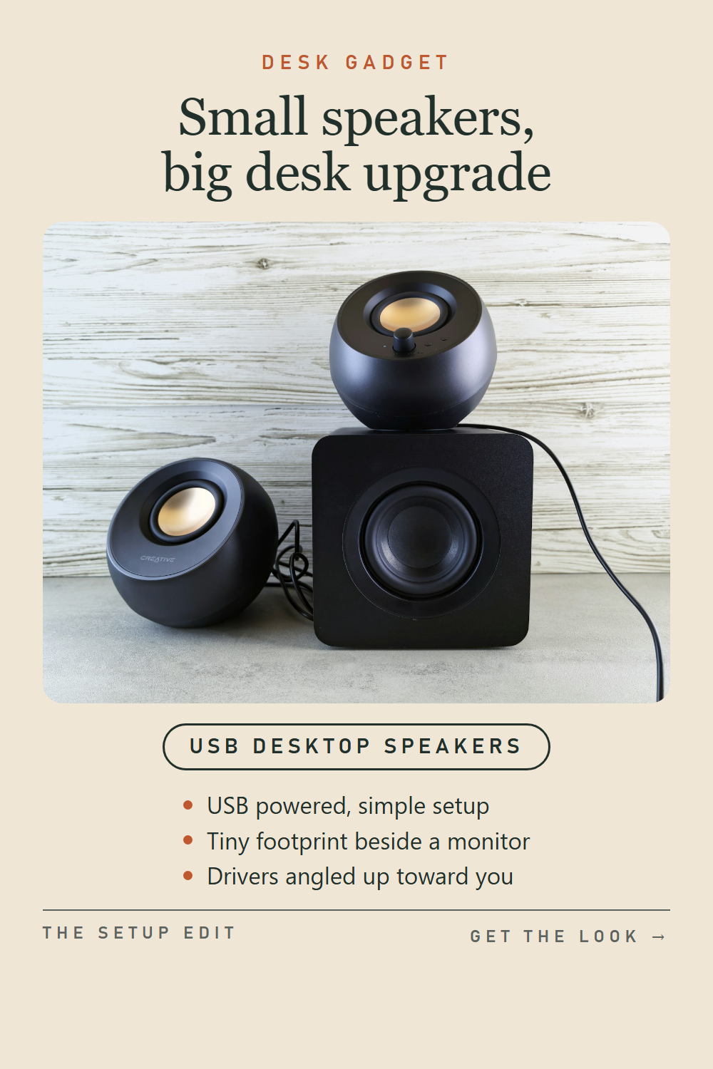
media/b3/b3-16-usb-desk-speakers.png
