qman122/thesetupedit/media/b3/b3-17-adjustable-laptop-stand.png

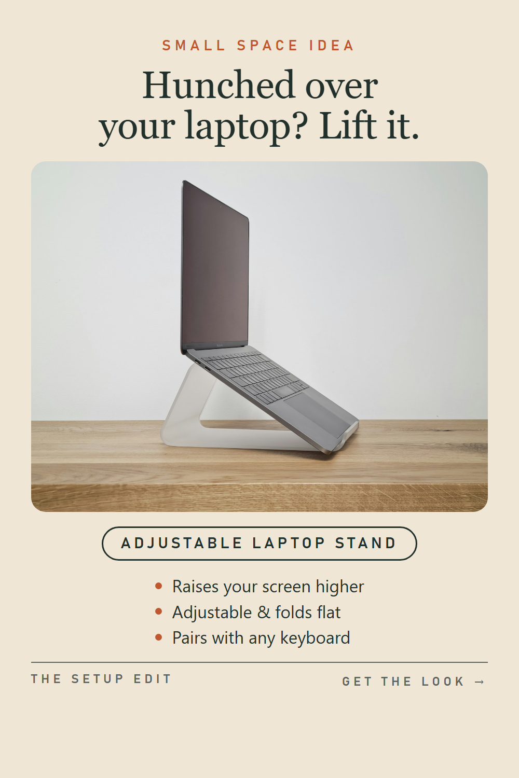
media/b3/b3-17-adjustable-laptop-stand.png
