qman122/thesetupedit/media/b3/b3-34-desk-mat-aesthetic.png

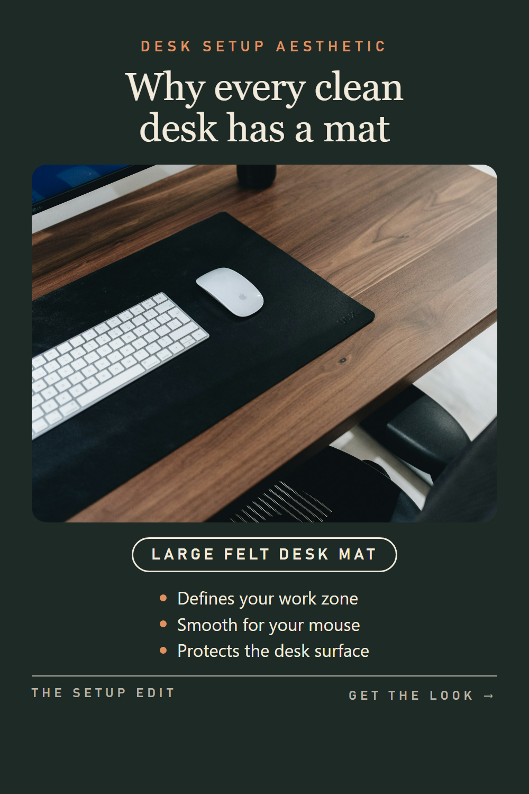
media/b3/b3-34-desk-mat-aesthetic.png
