qman122/thesetupedit/media/b3/b3-41-home-trading-desk.png

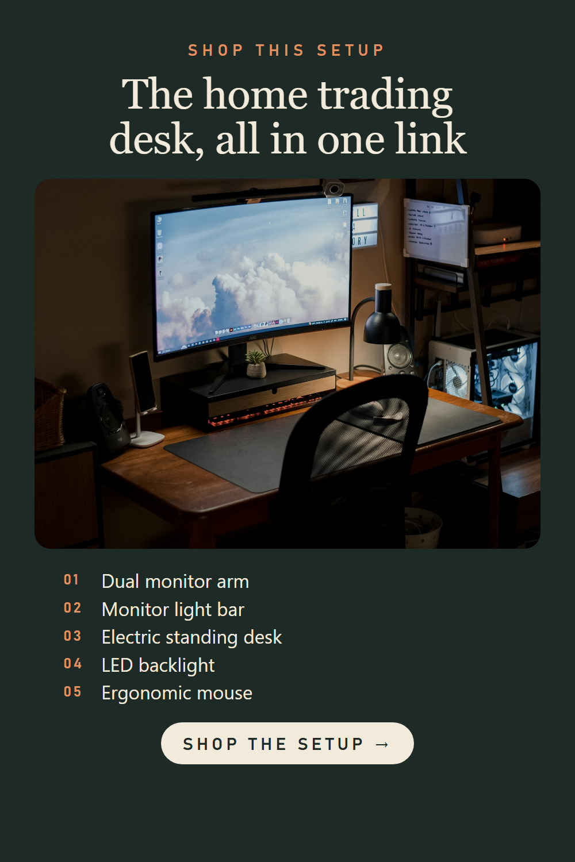
media/b3/b3-41-home-trading-desk.png
