qman122/thesetupedit/media/b4/b4-03-mini-faux-desk-plants.png

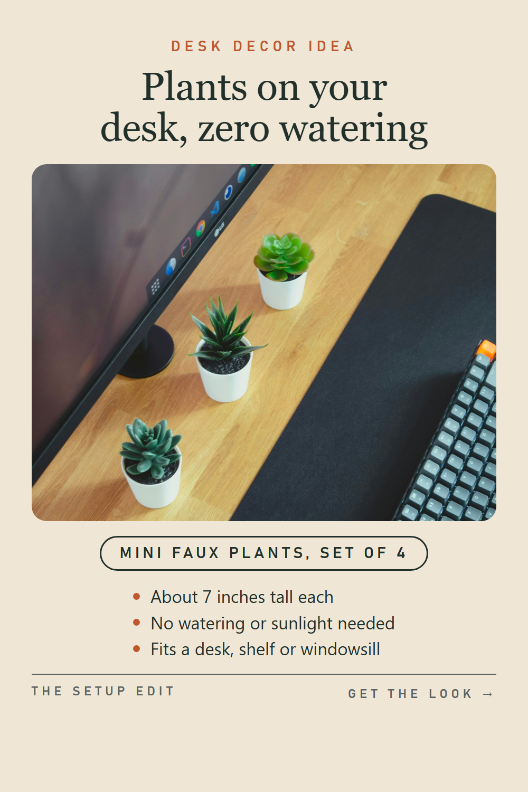
media/b4/b4-03-mini-faux-desk-plants.png
