qman122/thesetupedit/media/b4/b4-05-ba-hide-desk-cables.png

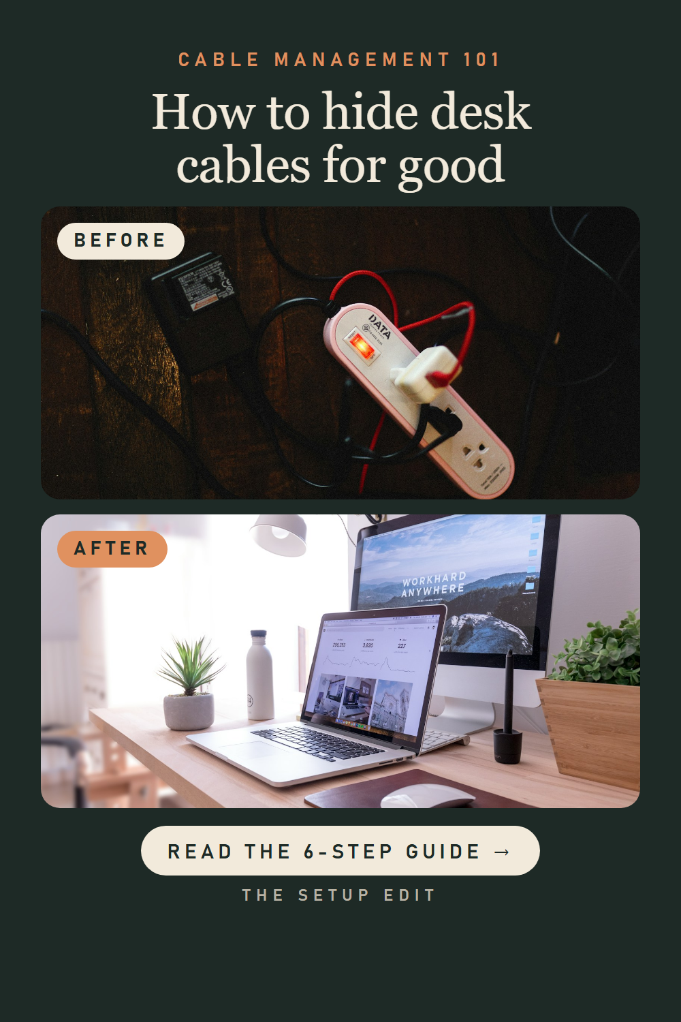
media/b4/b4-05-ba-hide-desk-cables.png
