qman122/thesetupedit/media/b4/b4-07-felt-desk-mat-keyboard.png

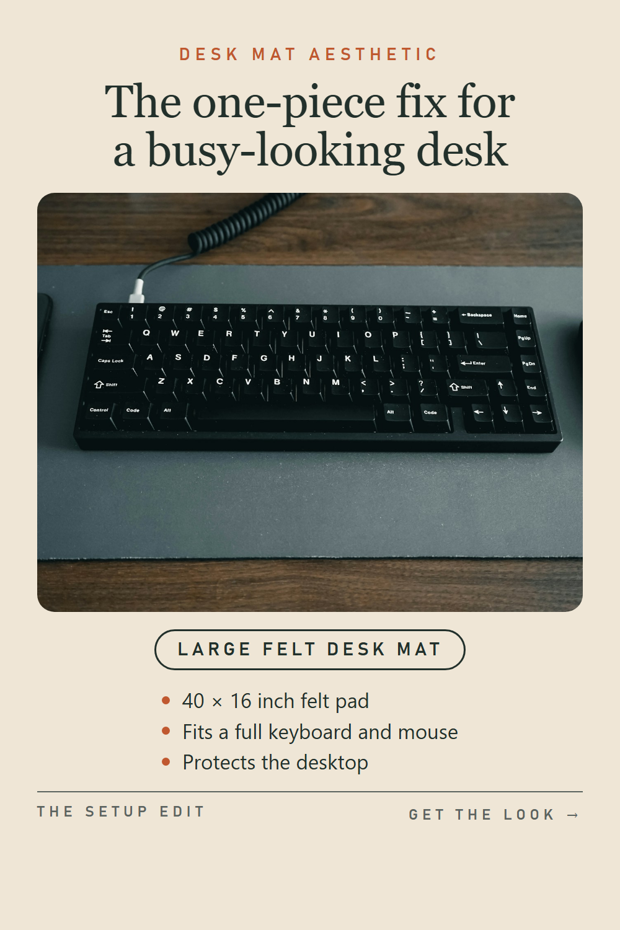
media/b4/b4-07-felt-desk-mat-keyboard.png
