qman122/thesetupedit/media/b4/b4-08-desk-ring-light.png

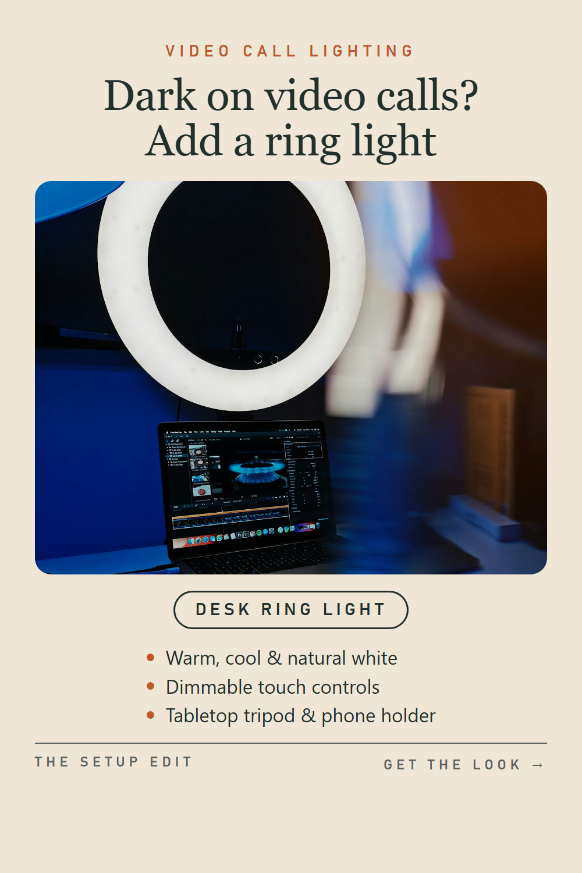
media/b4/b4-08-desk-ring-light.png
