qman122/thesetupedit/media/b4/b4-09-trading-desk-essentials.png

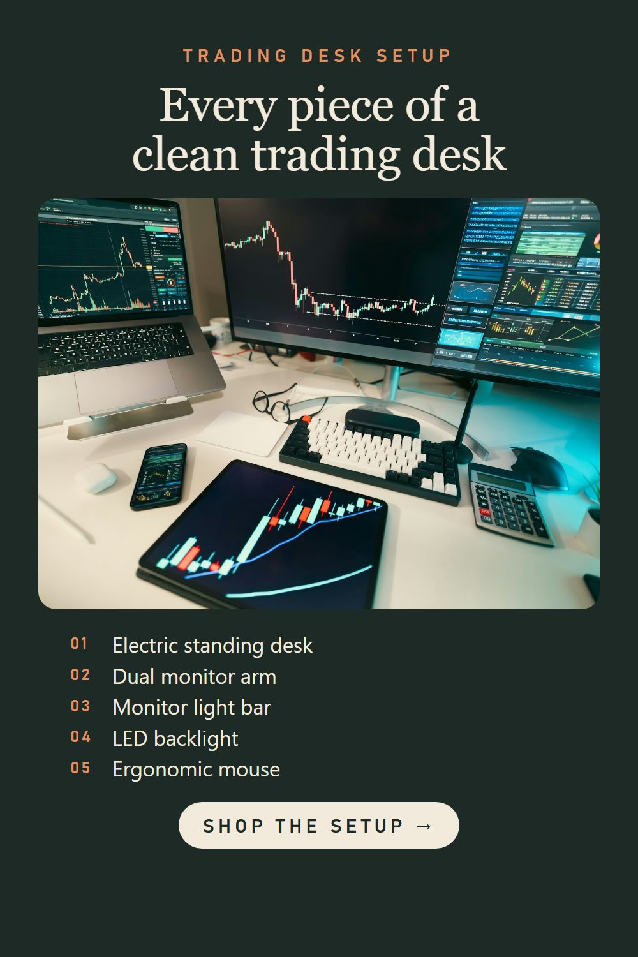
media/b4/b4-09-trading-desk-essentials.png
