qman122/thesetupedit/media/b4/b4-13-technical-analysis-book.png

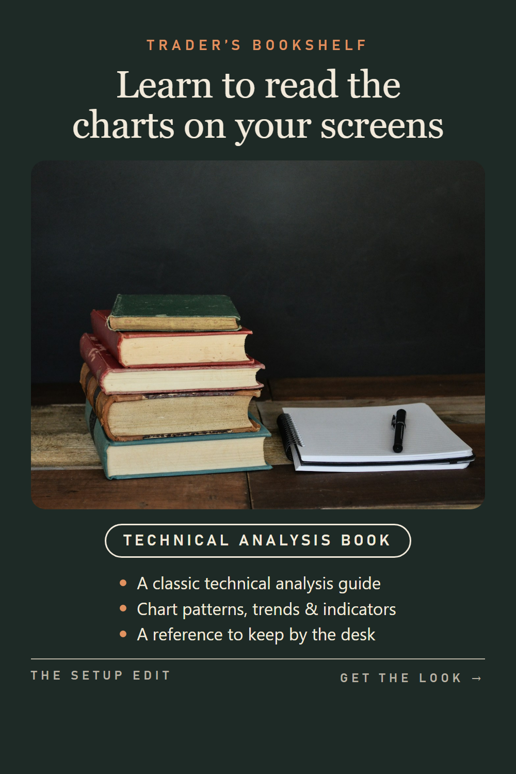
media/b4/b4-13-technical-analysis-book.png
