qman122/thesetupedit/media/b4/b4-16-monitor-stand-drawer.png

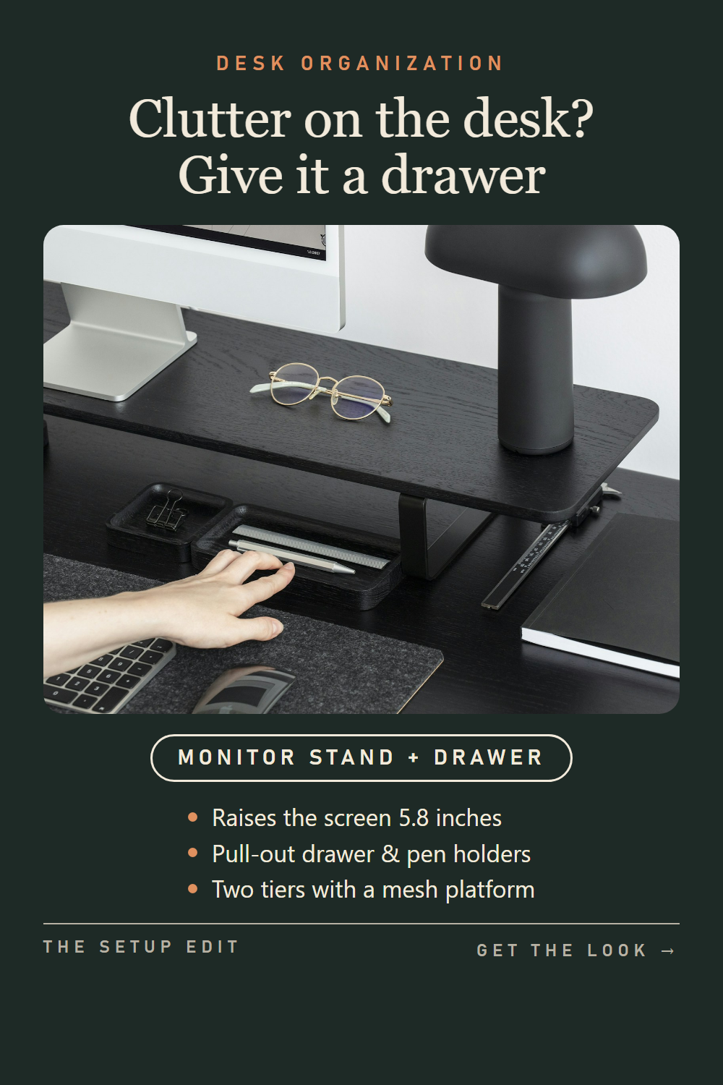
media/b4/b4-16-monitor-stand-drawer.png
