qman122/thesetupedit/media/b4/b4-25-high-back-office-chair.png

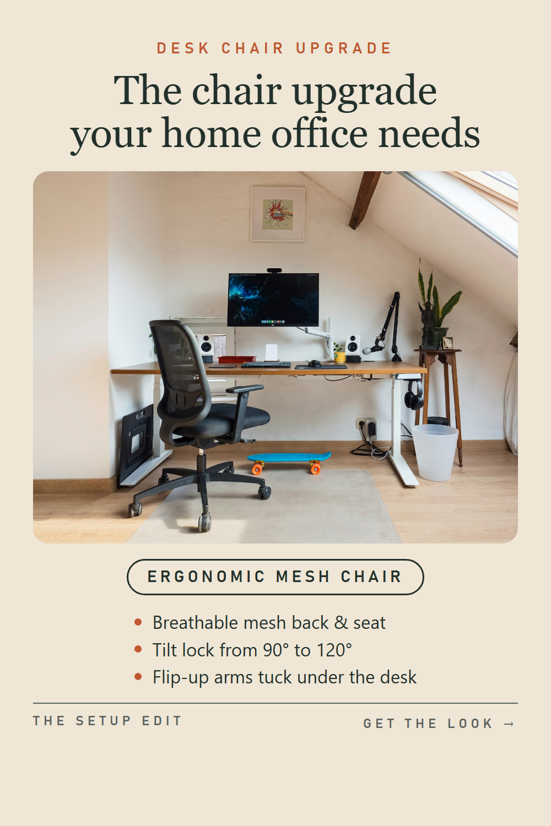
media/b4/b4-25-high-back-office-chair.png
