qman122/thesetupedit/media/b4/b4-28-stock-operator-book.png

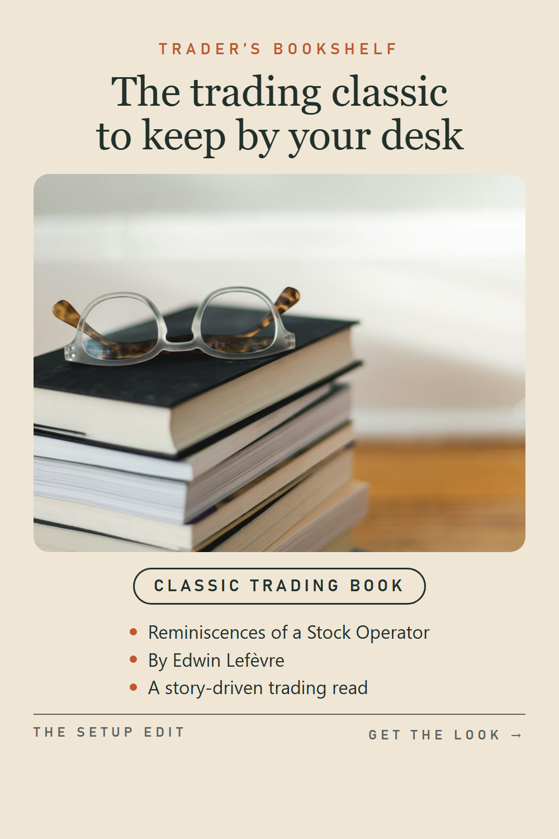
media/b4/b4-28-stock-operator-book.png
