qman122/thesetupedit/media/b4/b4-34-minimal-floating-shelf.png

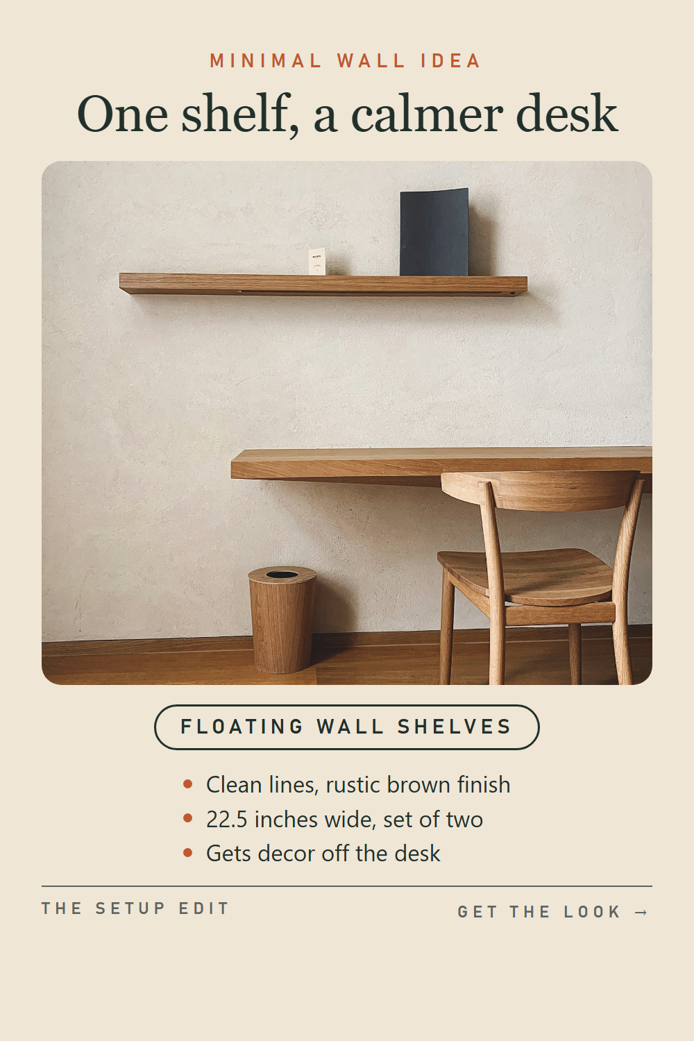
media/b4/b4-34-minimal-floating-shelf.png
