qman122/thesetupedit/media/b4/b4-39-dual-monitor-desk-mount.png

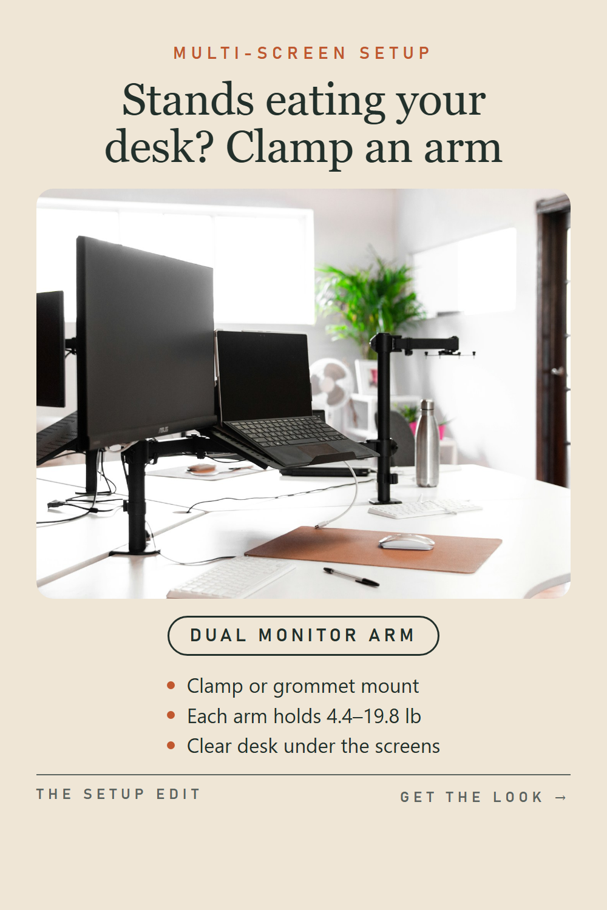
media/b4/b4-39-dual-monitor-desk-mount.png
