qman122/thesetupedit/media/b5/b5-01-desk-lamp-dark-evenings.png

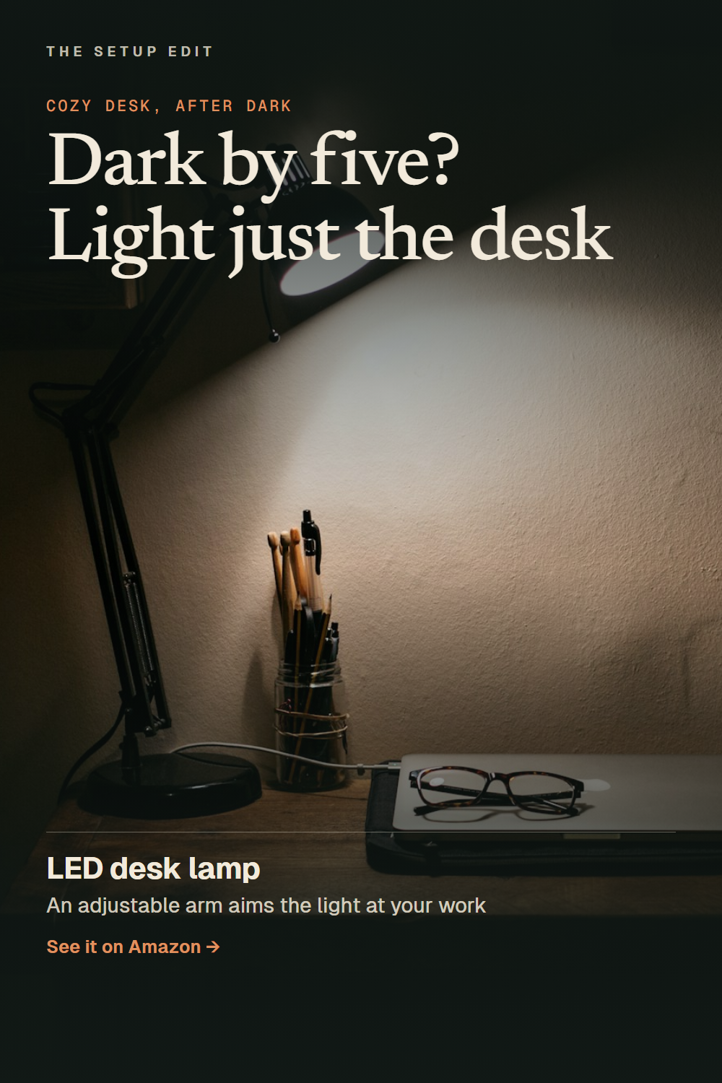
media/b5/b5-01-desk-lamp-dark-evenings.png
