qman122/thesetupedit/media/b5/b5-02-small-office-one-corner.png

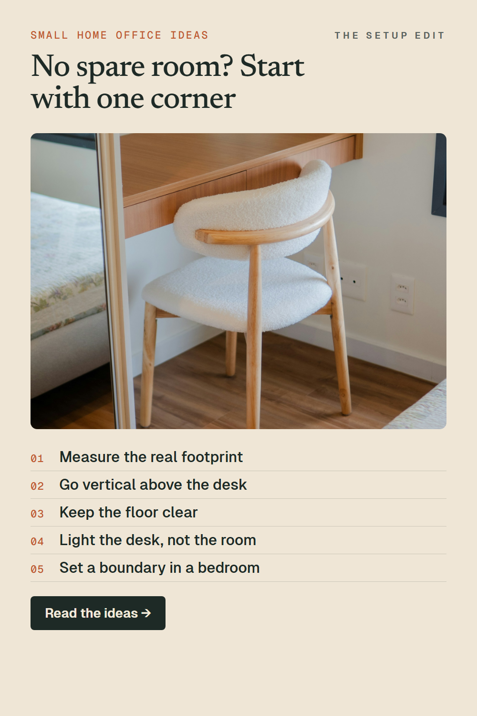
media/b5/b5-02-small-office-one-corner.png
