qman122/thesetupedit/media/b5/b5-04-walnut-wrist-rest-tip.png

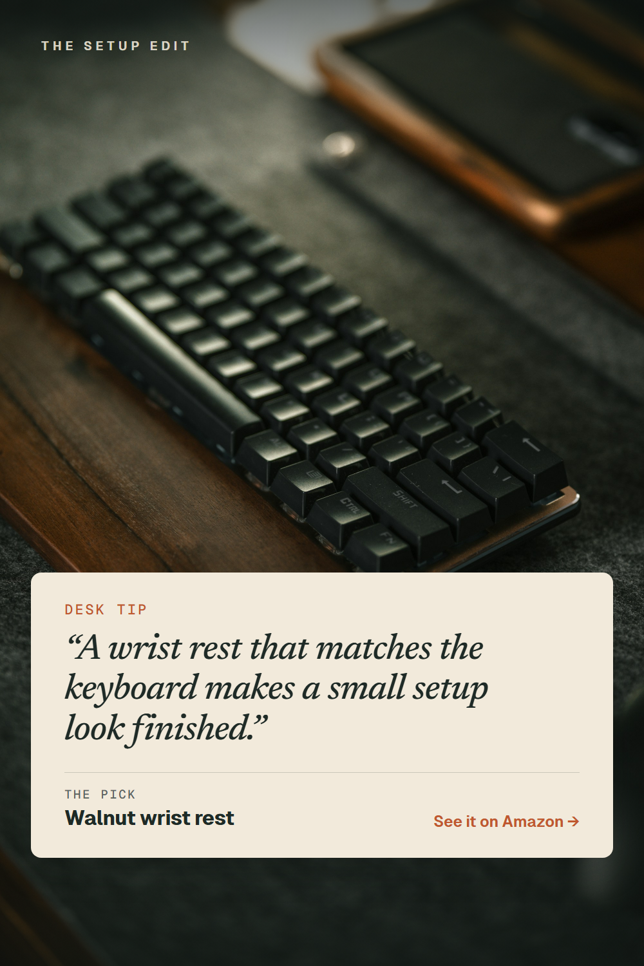
media/b5/b5-04-walnut-wrist-rest-tip.png
