qman122/thesetupedit/media/b5/b5-06-gift-compact-keyboard.png

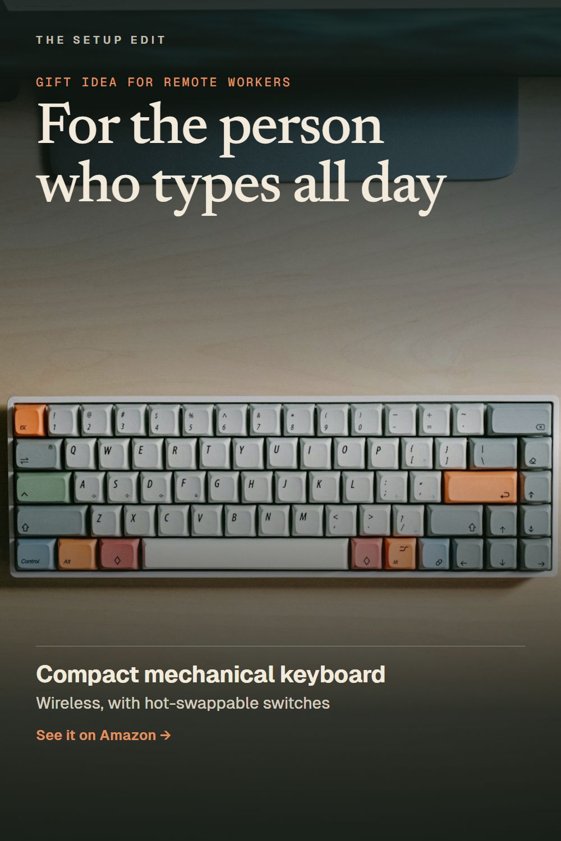
media/b5/b5-06-gift-compact-keyboard.png
