qman122/thesetupedit/media/b5/b5-10-stocking-stuffer-charger.png

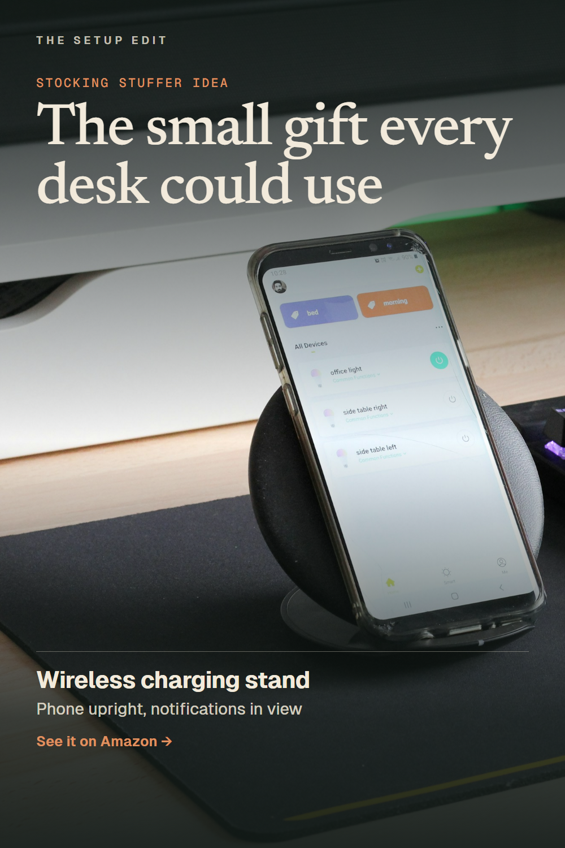
media/b5/b5-10-stocking-stuffer-charger.png
