qman122/thesetupedit/media/b5/b5-12-leather-desk-pad-warmer.png

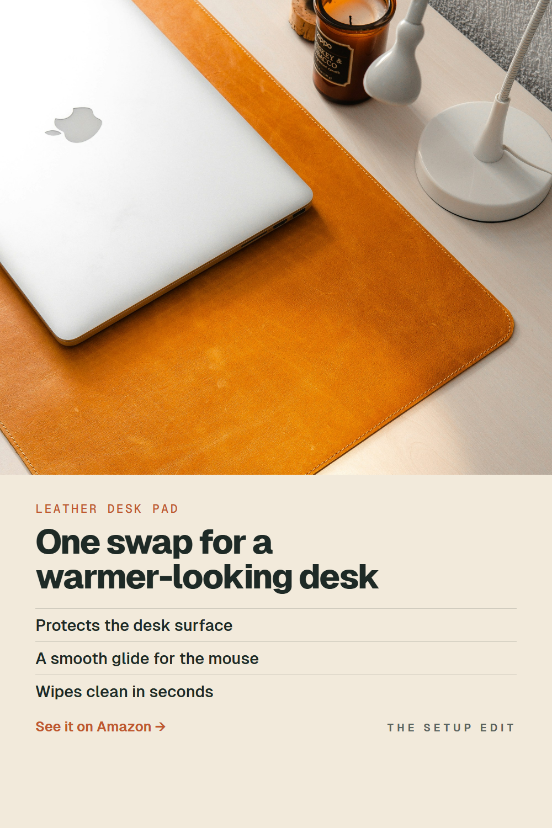
media/b5/b5-12-leather-desk-pad-warmer.png
