qman122/thesetupedit/media/b5/b5-18-ergonomic-mouse-gift-tip.png

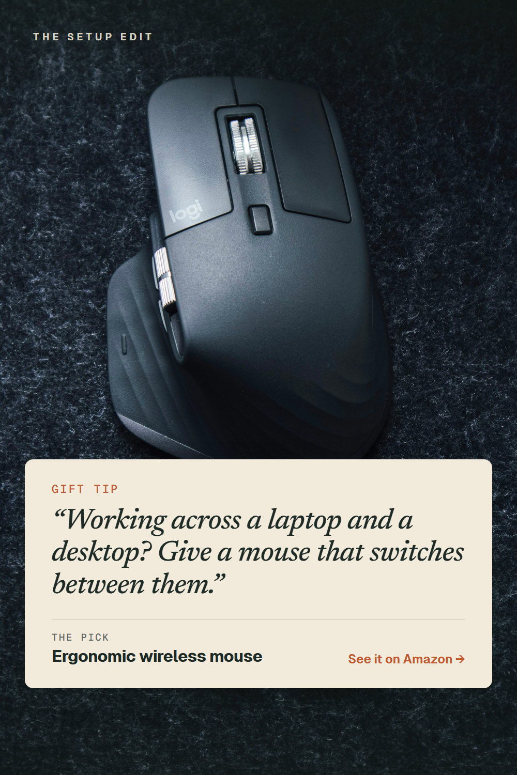
media/b5/b5-18-ergonomic-mouse-gift-tip.png
