qman122/thesetupedit/media/b5/b5-20-ba-cords-off-floor.png

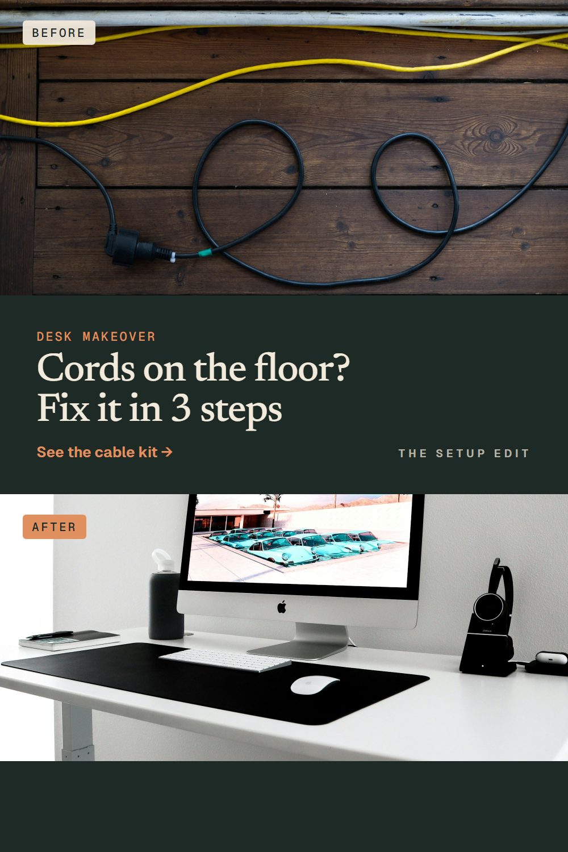
media/b5/b5-20-ba-cords-off-floor.png
