qman122/thesetupedit/media/b5/b5-24-gift-book-new-traders.png

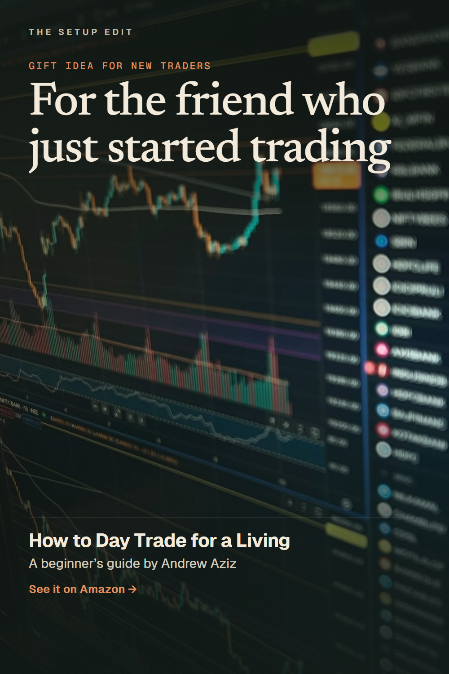
media/b5/b5-24-gift-book-new-traders.png
