qman122/thesetupedit/media/b5/b5-27-mesh-chair-first-upgrade.png

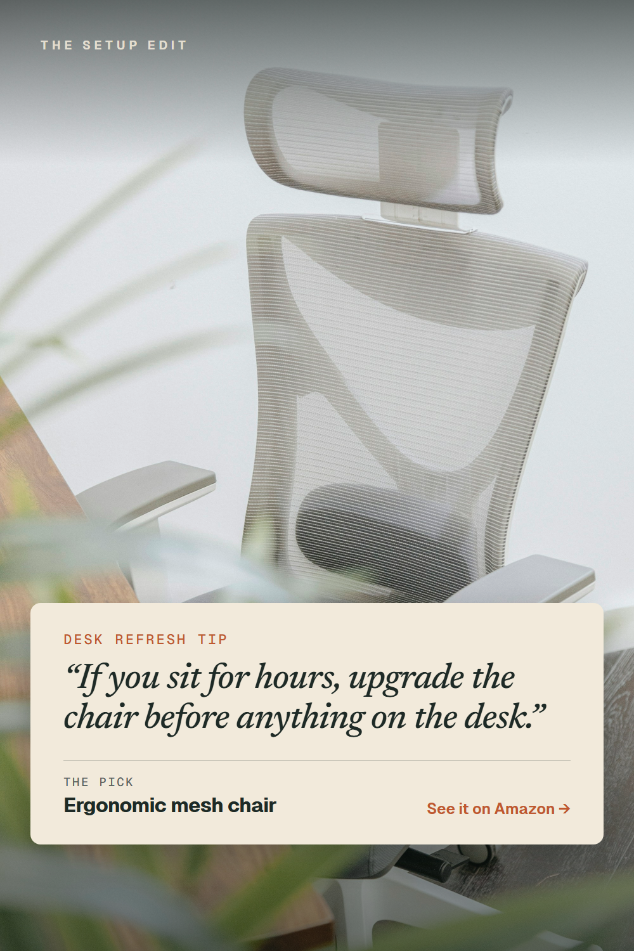
media/b5/b5-27-mesh-chair-first-upgrade.png
