qman122/thesetupedit/media/b5/b5-30-headphone-stand-own-spot.png

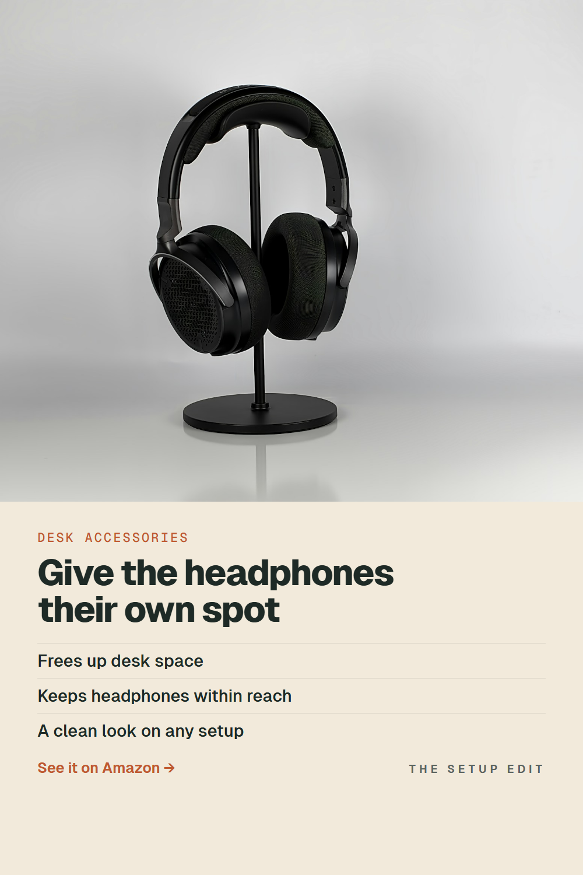
media/b5/b5-30-headphone-stand-own-spot.png
