qman122/thesetupedit/media/b5/b5-33-anc-headphones-focus-gift.png

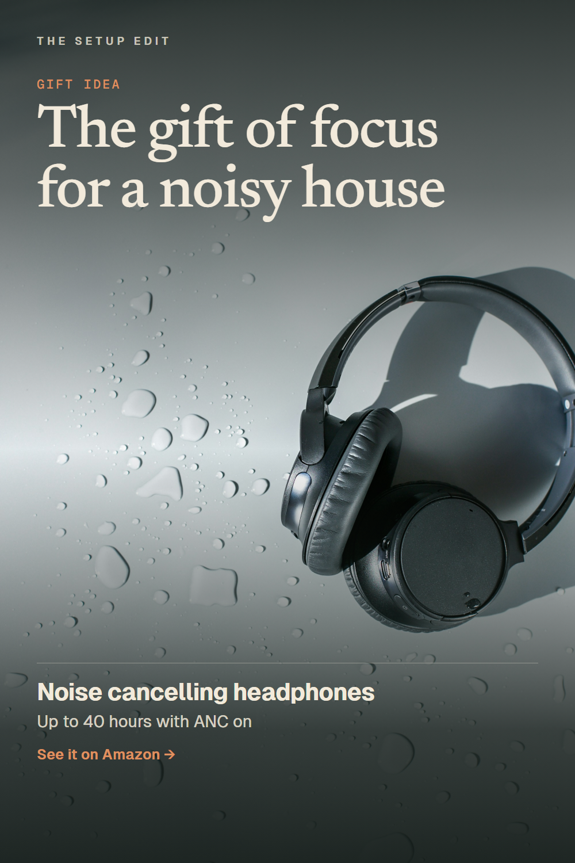
media/b5/b5-33-anc-headphones-focus-gift.png
