qman122/thesetupedit/media/b5/b5-42-night-owl-light-bar-gift.png

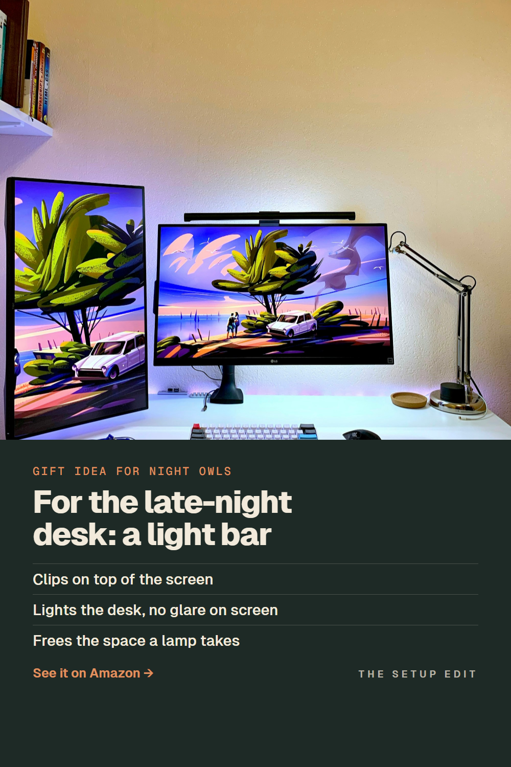
media/b5/b5-42-night-owl-light-bar-gift.png
