qman122/thesetupedit/media/b6/b6-001-dual-monitor-arm.jpg

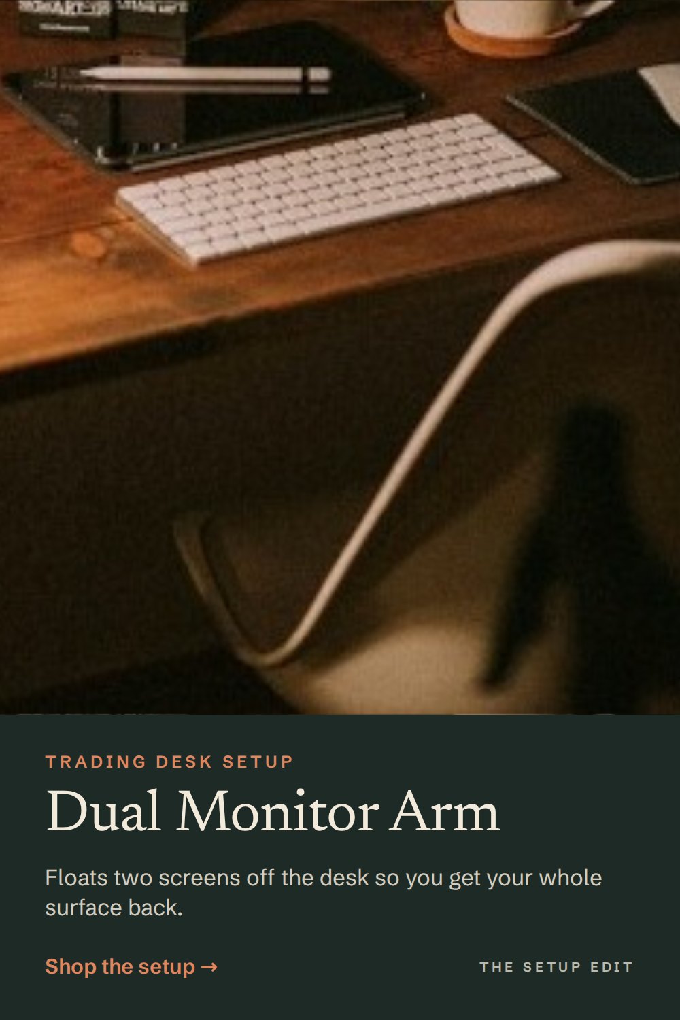
media/b6/b6-001-dual-monitor-arm.jpg
