qman122/thesetupedit/media/b6/b6-005-monitor-riser.jpg

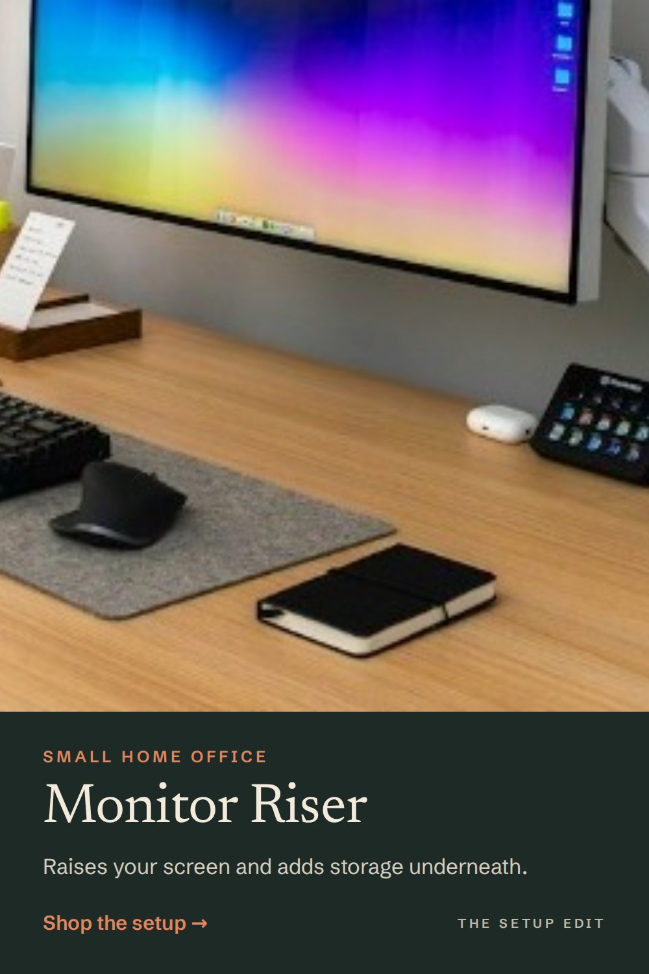
media/b6/b6-005-monitor-riser.jpg
