qman122/thesetupedit/media/b6/b6-006-light-your-desk-for-video-calls.jpg

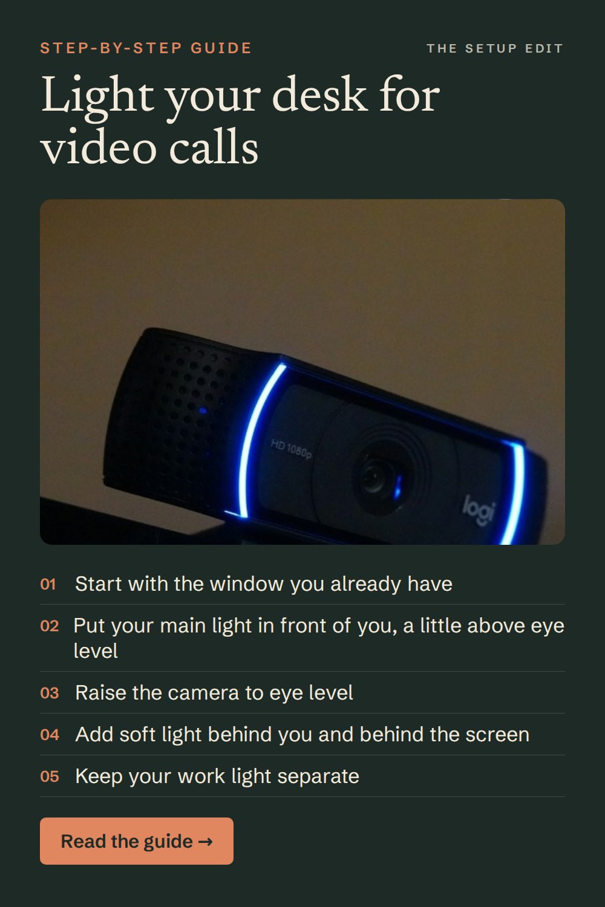
media/b6/b6-006-light-your-desk-for-video-calls.jpg
