qman122/thesetupedit/media/b6/b6-009-the-case-for-the-dual-monitor-arm.jpg

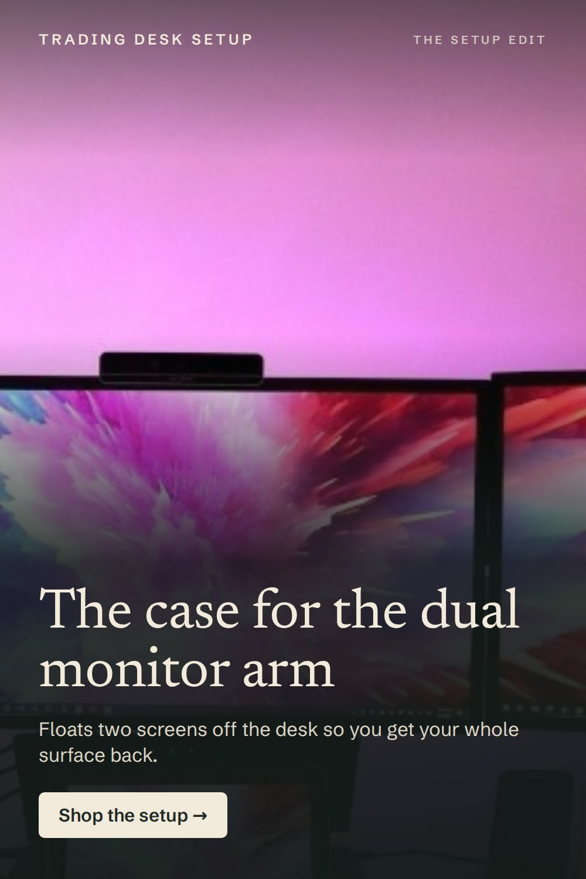
media/b6/b6-009-the-case-for-the-dual-monitor-arm.jpg
