qman122/thesetupedit/media/b6/b6-010-better-light-no-glare.jpg

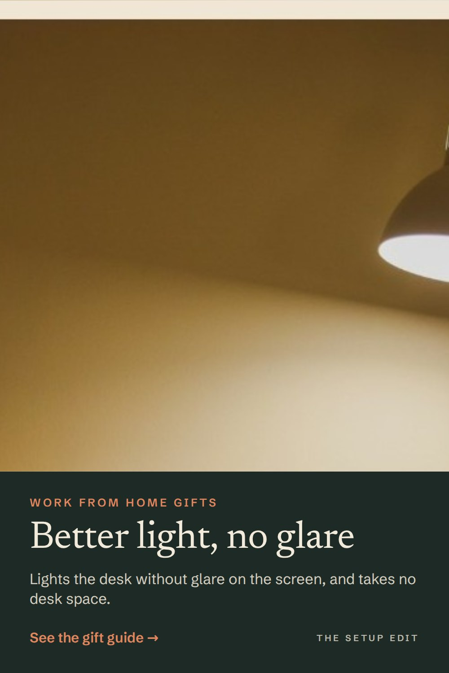
media/b6/b6-010-better-light-no-glare.jpg
