qman122/thesetupedit/media/b6/b6-012-the-case-for-the-monitor-riser.jpg

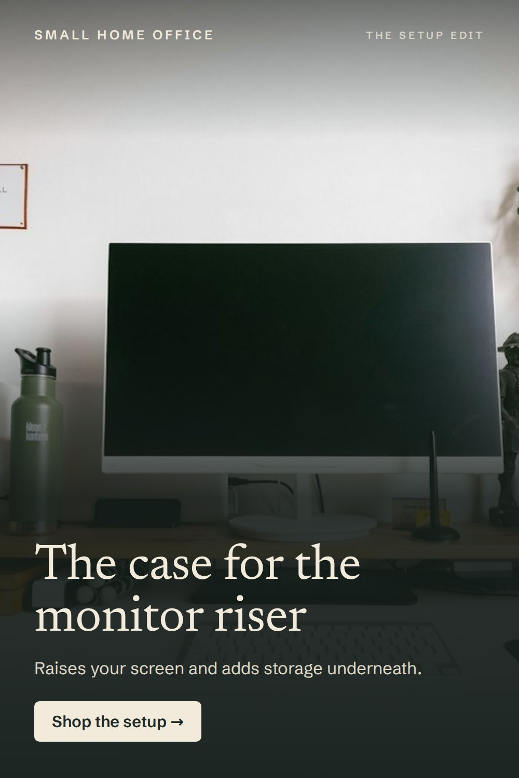
media/b6/b6-012-the-case-for-the-monitor-riser.jpg
