qman122/thesetupedit/media/b6/b6-017-laptop-stand.jpg

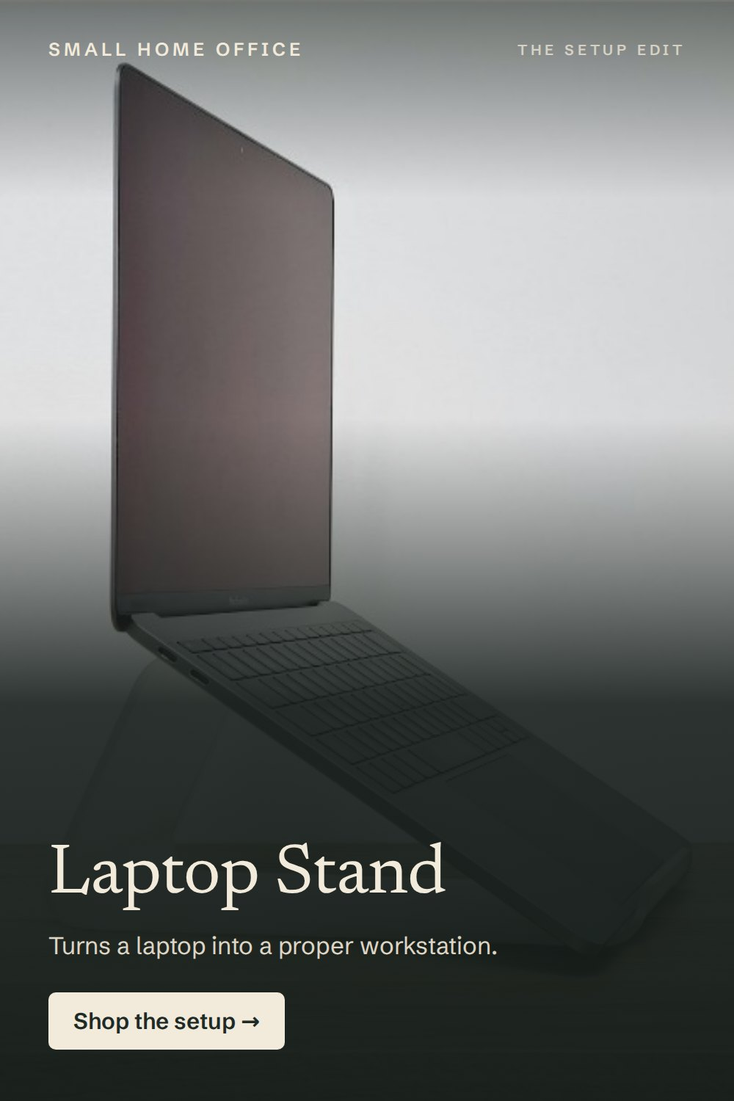
media/b6/b6-017-laptop-stand.jpg
