qman122/thesetupedit/media/b6/b6-018-cables-that-stay-put.jpg

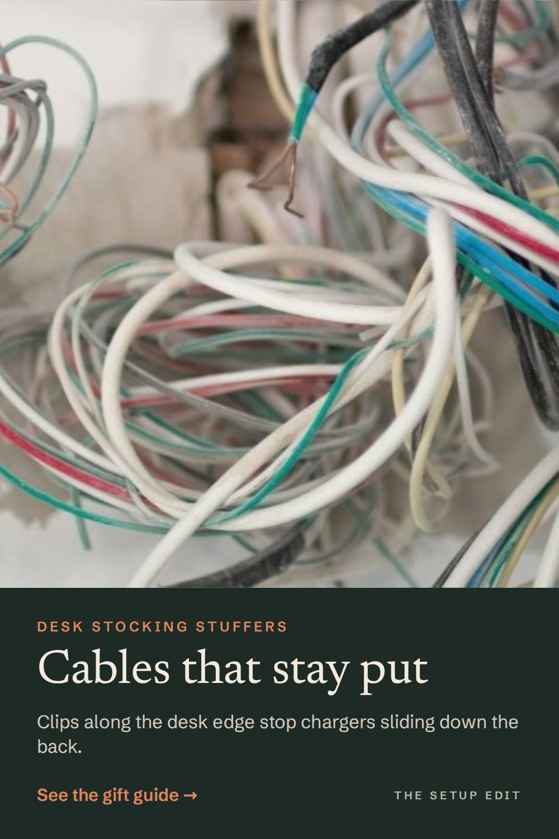
media/b6/b6-018-cables-that-stay-put.jpg
