qman122/thesetupedit/media/b6/b6-021-monitor-light-bar-light-for-late-sessions.jpg

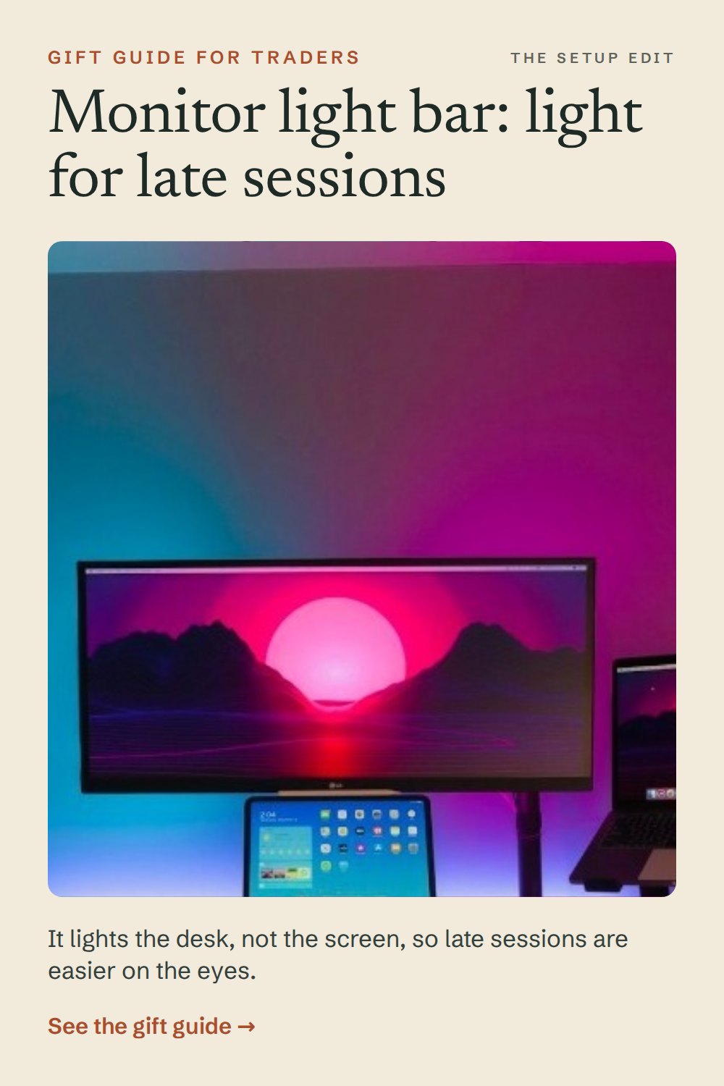
media/b6/b6-021-monitor-light-bar-light-for-late-sessions.jpg
