qman122/thesetupedit/media/b6/b6-022-the-case-for-the-laptop-stand.jpg

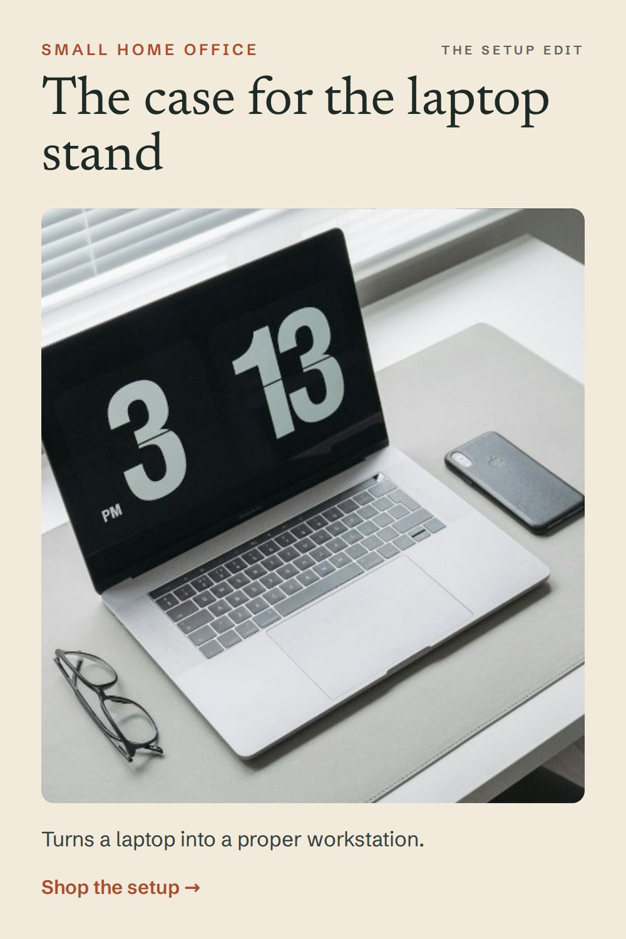
media/b6/b6-022-the-case-for-the-laptop-stand.jpg
