qman122/thesetupedit/media/b6/b6-023-an-evening-glow.jpg

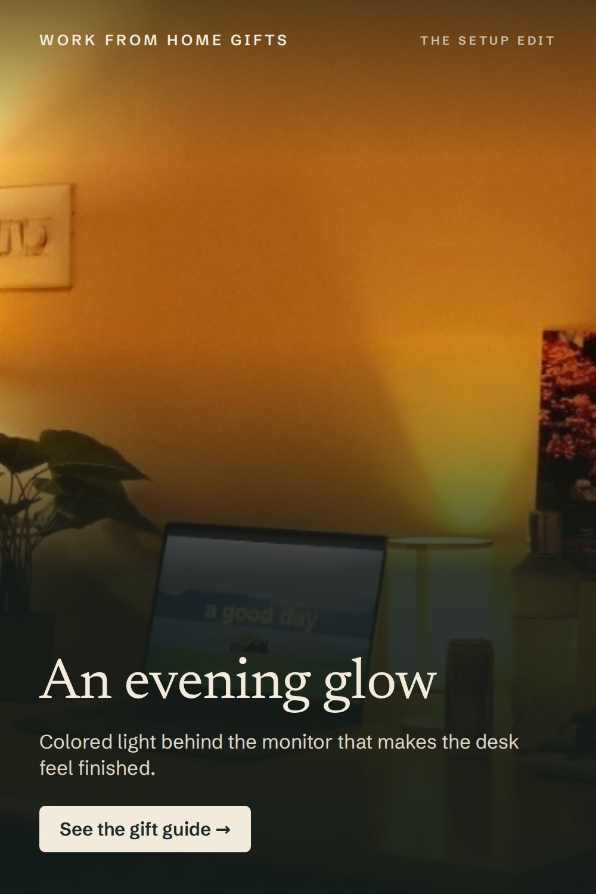
media/b6/b6-023-an-evening-glow.jpg
