qman122/thesetupedit/media/b6/b6-025-gift-idea-adhesive-cable-clips.jpg

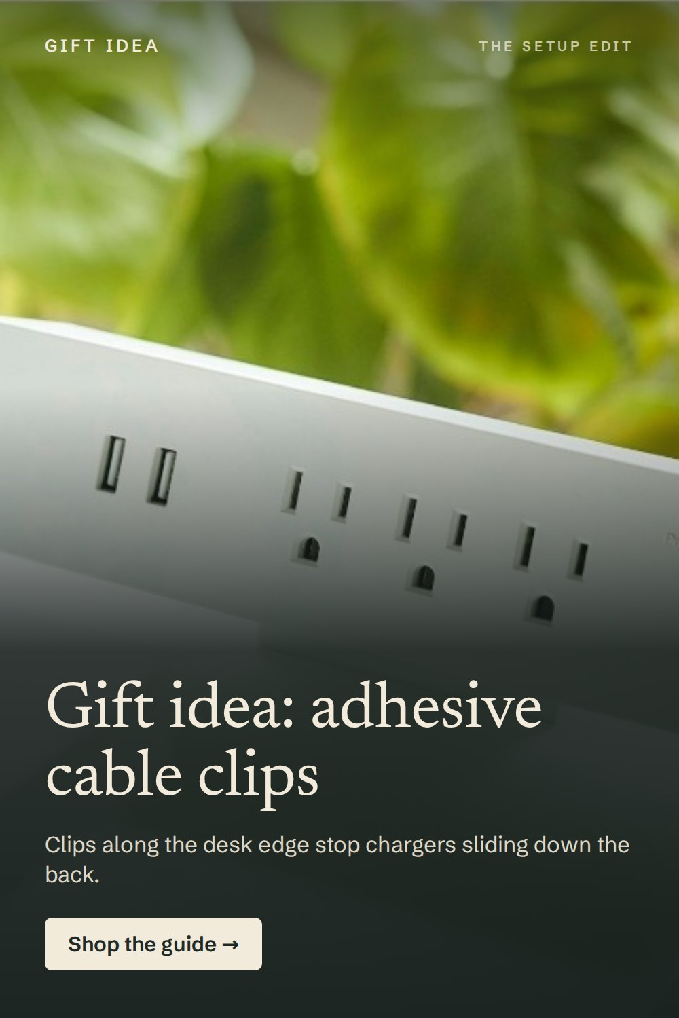
media/b6/b6-025-gift-idea-adhesive-cable-clips.jpg
