qman122/thesetupedit/media/b6/b6-026-gift-idea-smart-light-bars.jpg

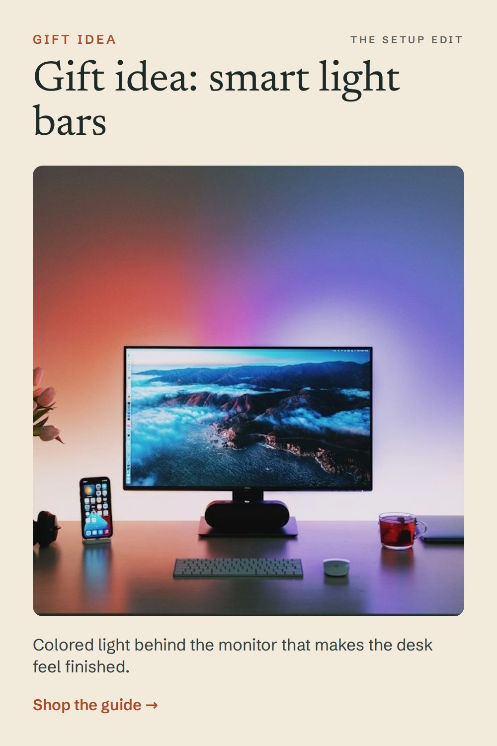
media/b6/b6-026-gift-idea-smart-light-bars.jpg
