qman122/thesetupedit/media/b6/b6-031-1080p-webcam-clearer-video-calls.jpg

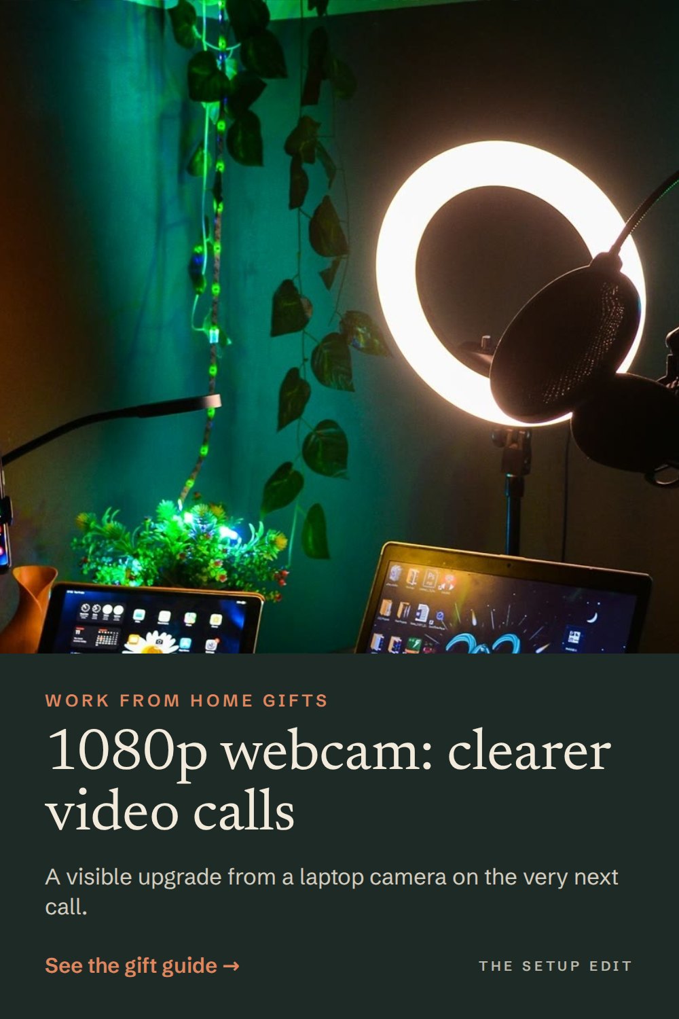
media/b6/b6-031-1080p-webcam-clearer-video-calls.jpg
