qman122/thesetupedit/media/b6/b6-039-the-case-for-the-electric-standing-desk.jpg

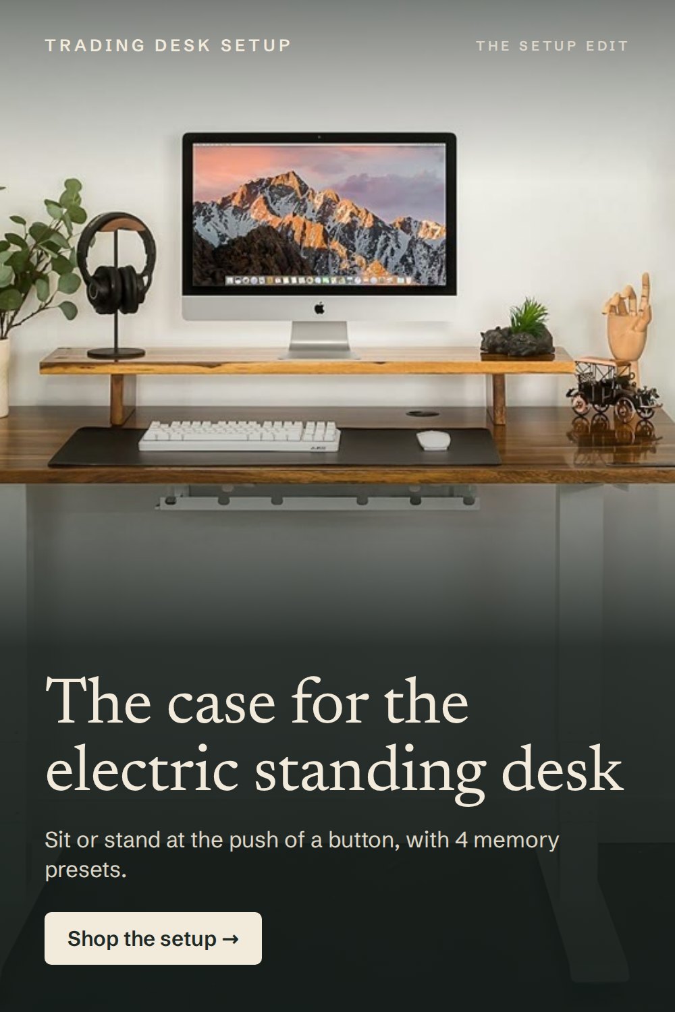
media/b6/b6-039-the-case-for-the-electric-standing-desk.jpg
