qman122/thesetupedit/media/b6/b6-042-floating-shelves.jpg

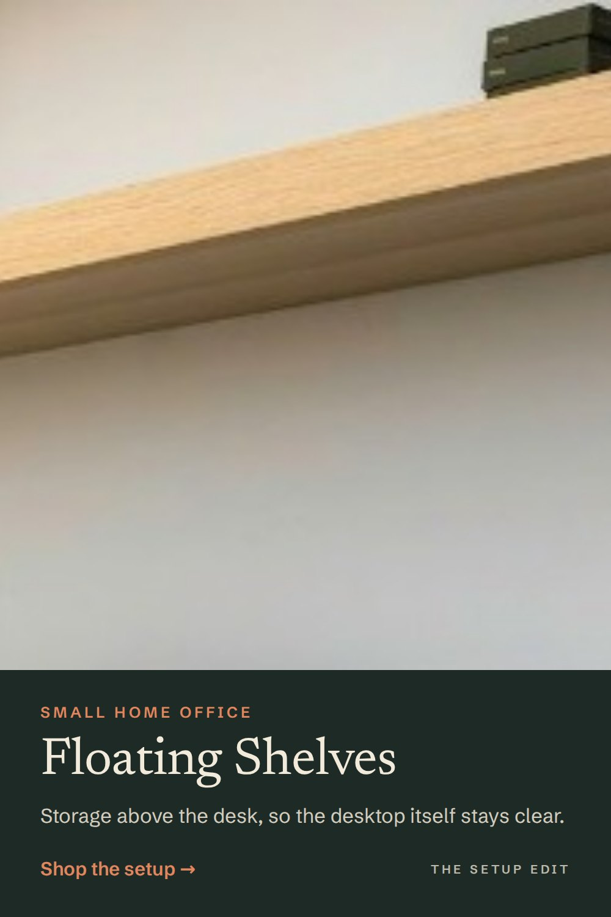
media/b6/b6-042-floating-shelves.jpg
