qman122/thesetupedit/media/b6/b6-045-gift-idea-a-wireless-charging-stand.jpg

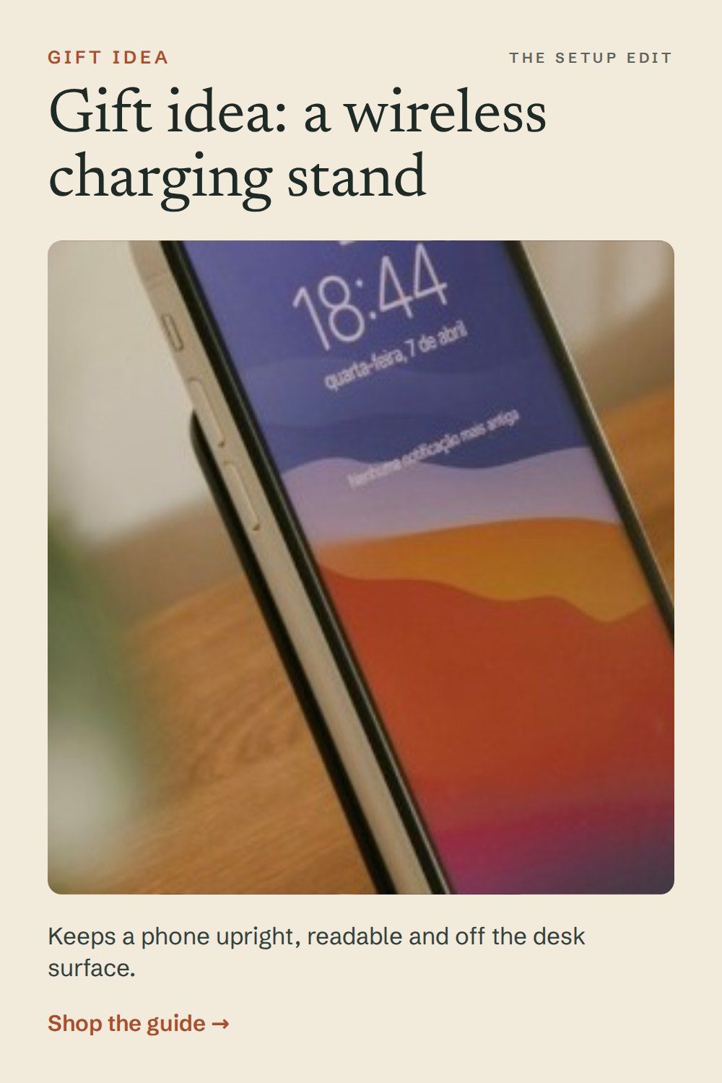
media/b6/b6-045-gift-idea-a-wireless-charging-stand.jpg
