qman122/thesetupedit/media/b6/b6-047-choose-a-frame-that-suits-what-sits-on-it.jpg

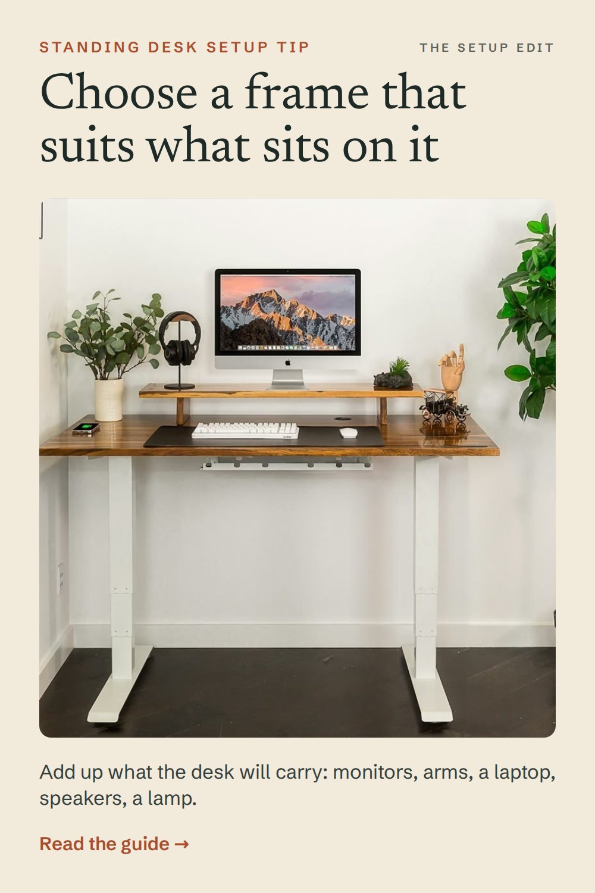
media/b6/b6-047-choose-a-frame-that-suits-what-sits-on-it.jpg
