qman122/thesetupedit/media/b6/b6-049-the-case-for-the-led-monitor-backlight.jpg

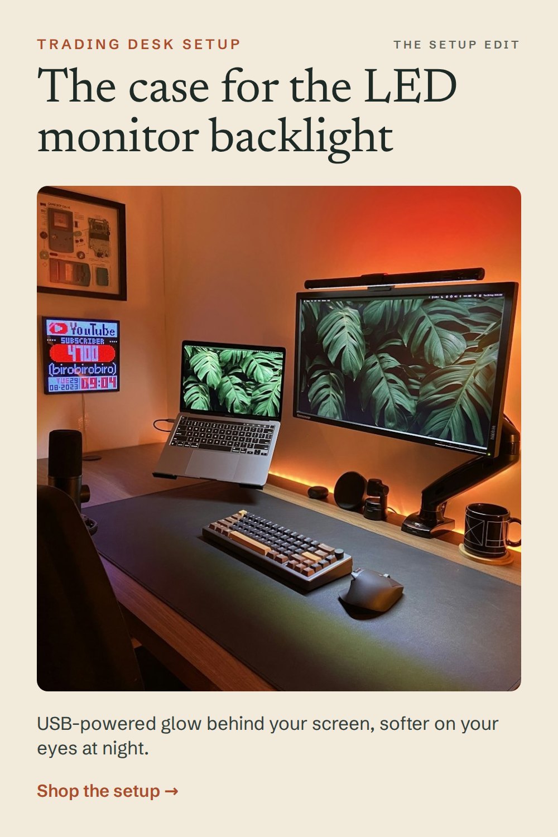
media/b6/b6-049-the-case-for-the-led-monitor-backlight.jpg
