qman122/thesetupedit/media/b6/b6-051-leather-desk-pad-the-desk-put-together.jpg

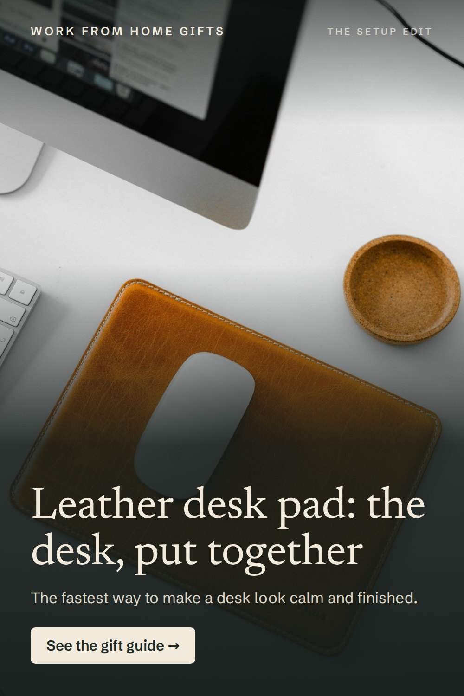
media/b6/b6-051-leather-desk-pad-the-desk-put-together.jpg
