qman122/thesetupedit/media/b6/b6-053-quiet-for-market-open.jpg

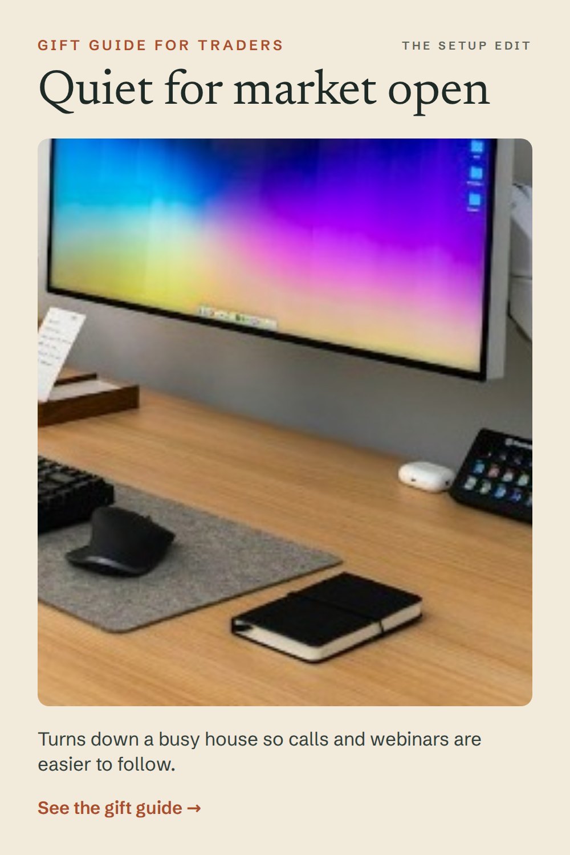
media/b6/b6-053-quiet-for-market-open.jpg
