qman122/thesetupedit/media/b6/b6-055-gift-idea-a-bamboo-organizer-tray.jpg

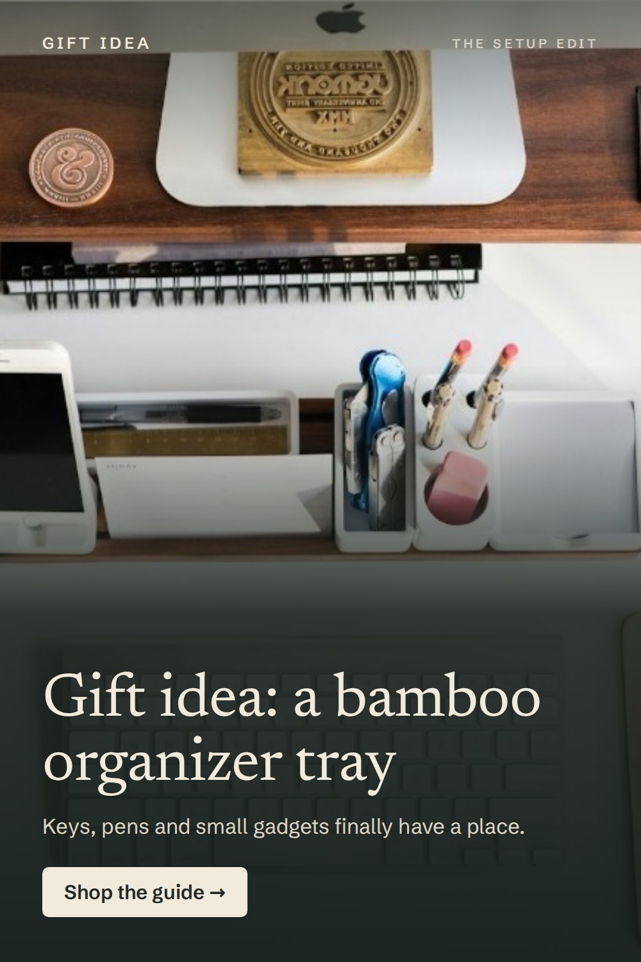
media/b6/b6-055-gift-idea-a-bamboo-organizer-tray.jpg
