qman122/thesetupedit/media/b6/b6-058-gift-idea-noise-cancelling-headphones.jpg

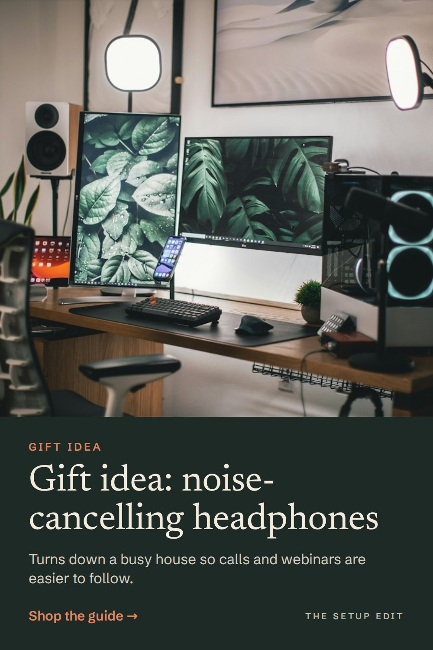
media/b6/b6-058-gift-idea-noise-cancelling-headphones.jpg
