qman122/thesetupedit/media/b6/b6-061-more-room-one-less-cable.jpg

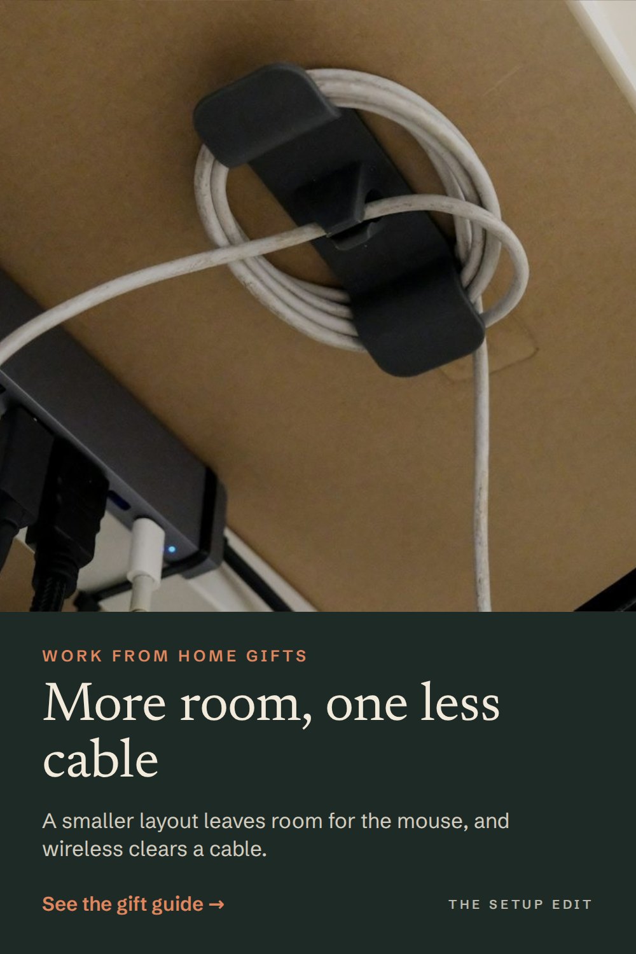
media/b6/b6-061-more-room-one-less-cable.jpg
