qman122/thesetupedit/media/b6/b6-063-wireless-charging-stand-alerts-always-in-view.jpg

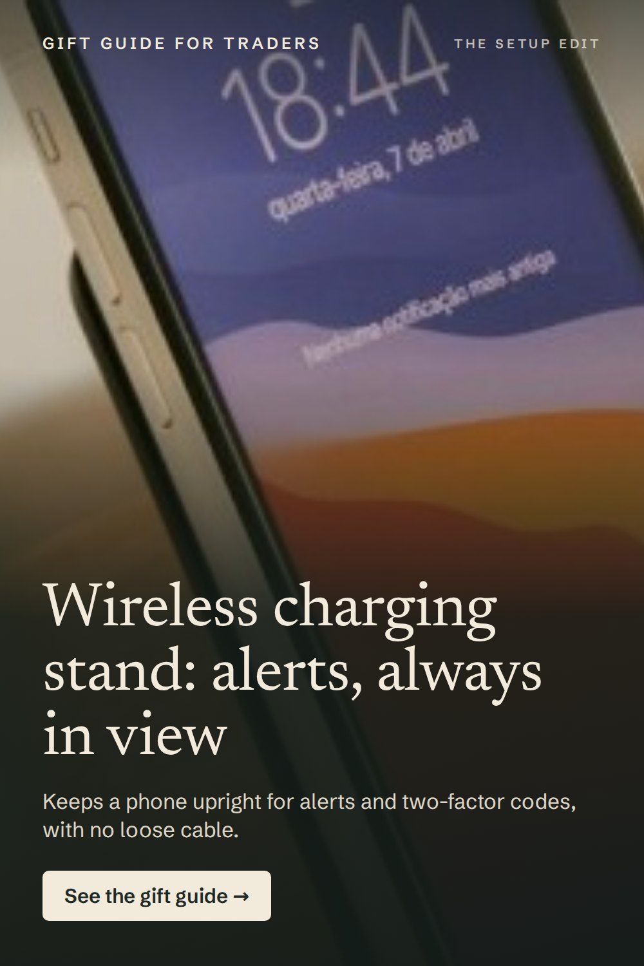
media/b6/b6-063-wireless-charging-stand-alerts-always-in-view.jpg
