qman122/thesetupedit/media/b6/b6-064-the-case-for-the-floating-shelves.jpg

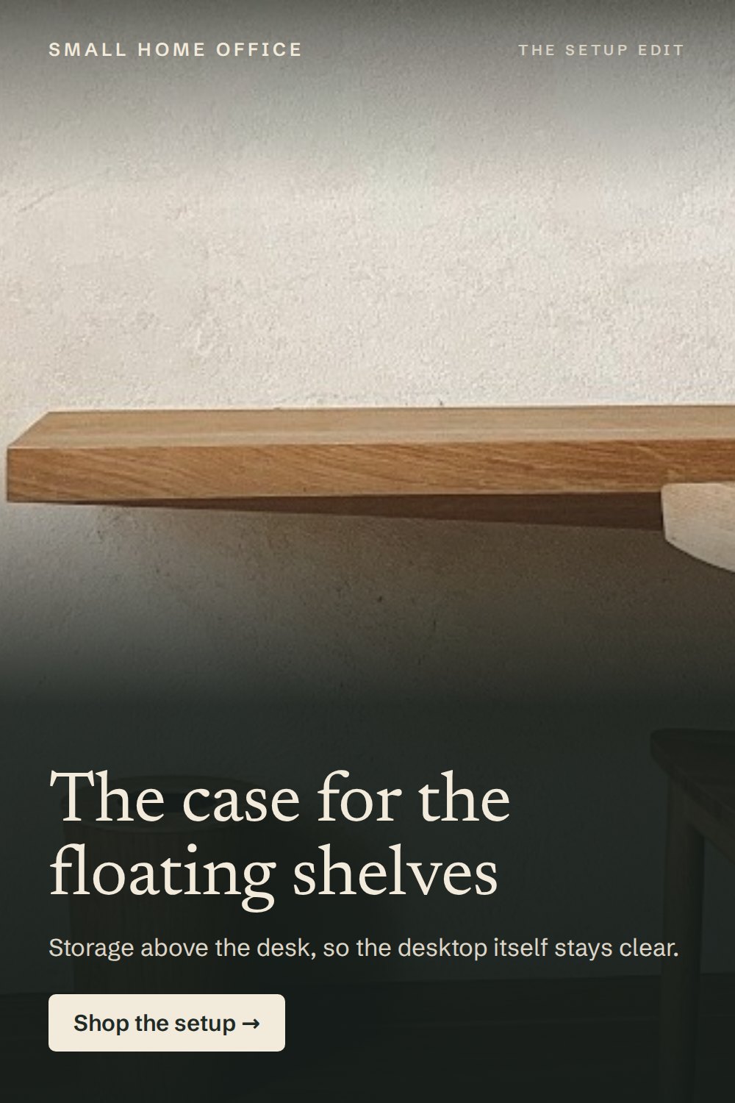
media/b6/b6-064-the-case-for-the-floating-shelves.jpg
