qman122/thesetupedit/media/b6/b6-065-gift-idea-a-headphone-stand.jpg

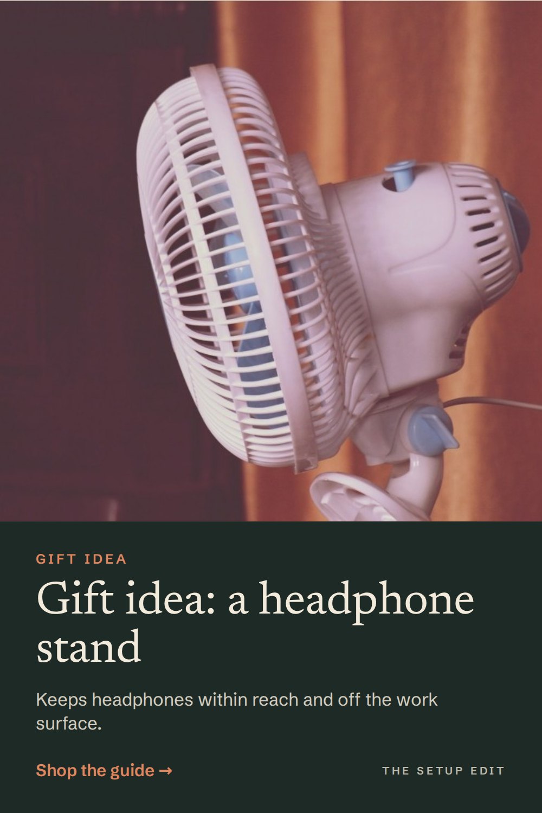
media/b6/b6-065-gift-idea-a-headphone-stand.jpg
