qman122/thesetupedit/media/b6/b6-067-find-your-two-heights.jpg

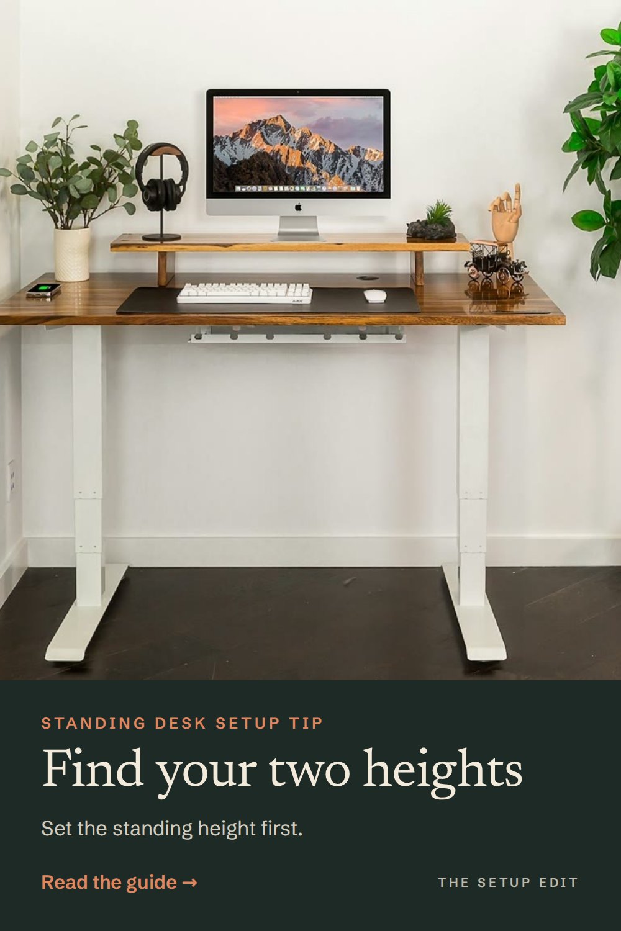
media/b6/b6-067-find-your-two-heights.jpg
