qman122/thesetupedit/media/b6/b6-069-pick-a-desk-that-can-carry-the-load.jpg

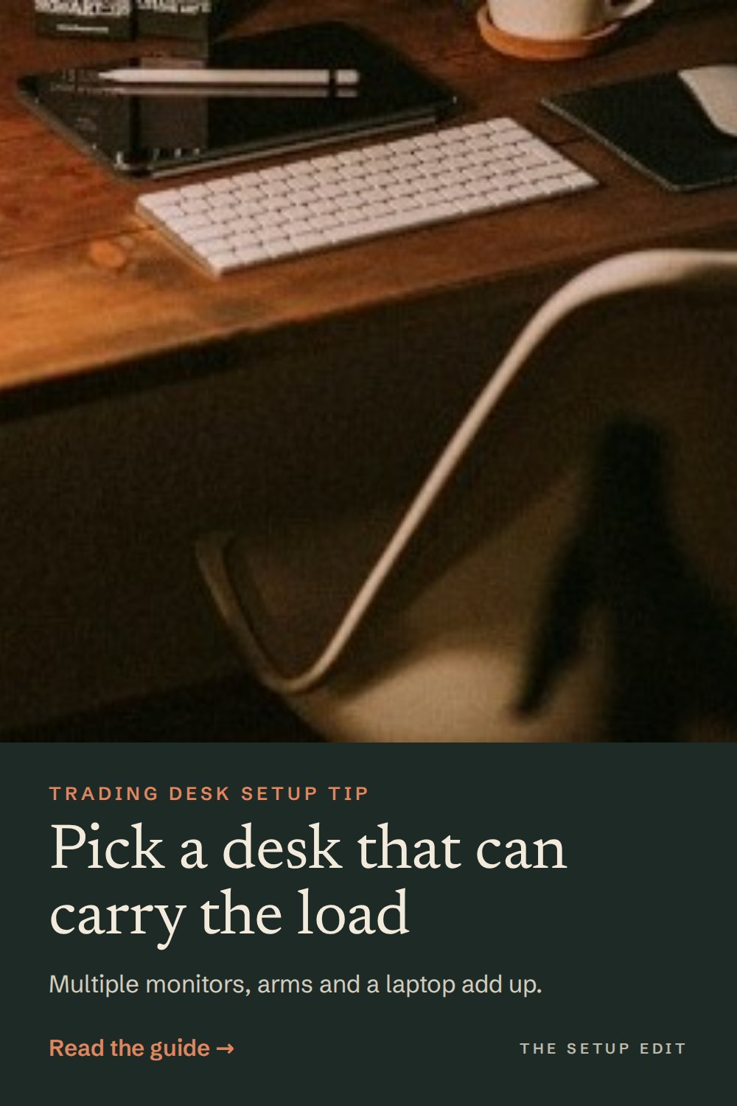
media/b6/b6-069-pick-a-desk-that-can-carry-the-load.jpg
