qman122/thesetupedit/media/b6/b6-072-the-psychology-classic.jpg

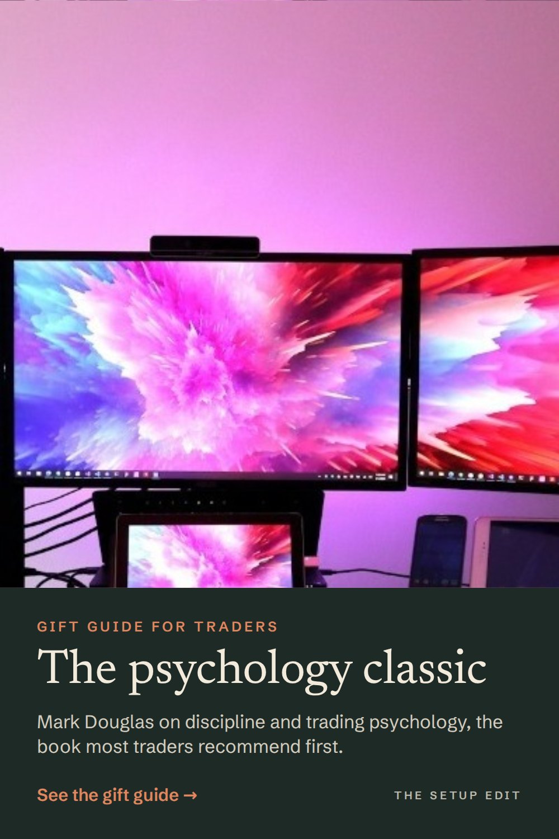
media/b6/b6-072-the-psychology-classic.jpg
