qman122/thesetupedit/media/b6/b6-075-gift-idea-a-walnut-headphone-stand.jpg

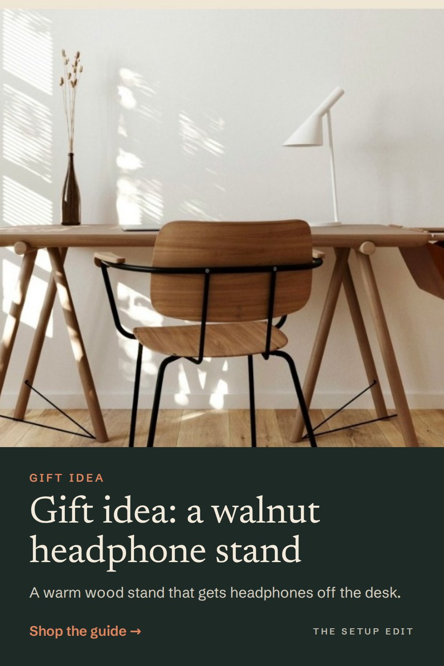
media/b6/b6-075-gift-idea-a-walnut-headphone-stand.jpg
