qman122/thesetupedit/media/b6/b6-076-gift-idea-trading-in-the-zone.jpg

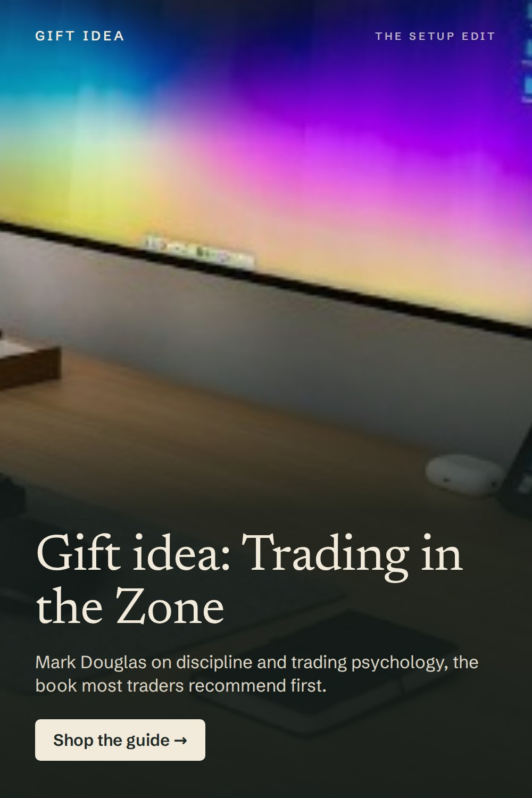
media/b6/b6-076-gift-idea-trading-in-the-zone.jpg
