qman122/thesetupedit/media/b6/b6-079-pick-the-spot-before-you-pick-the-desk.jpg

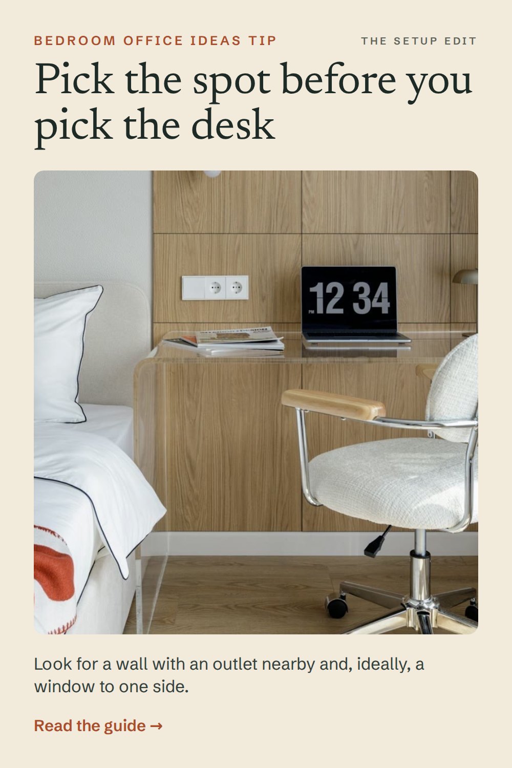
media/b6/b6-079-pick-the-spot-before-you-pick-the-desk.jpg
