qman122/thesetupedit/media/b6/b6-081-gift-idea-a-clip-on-fan.jpg

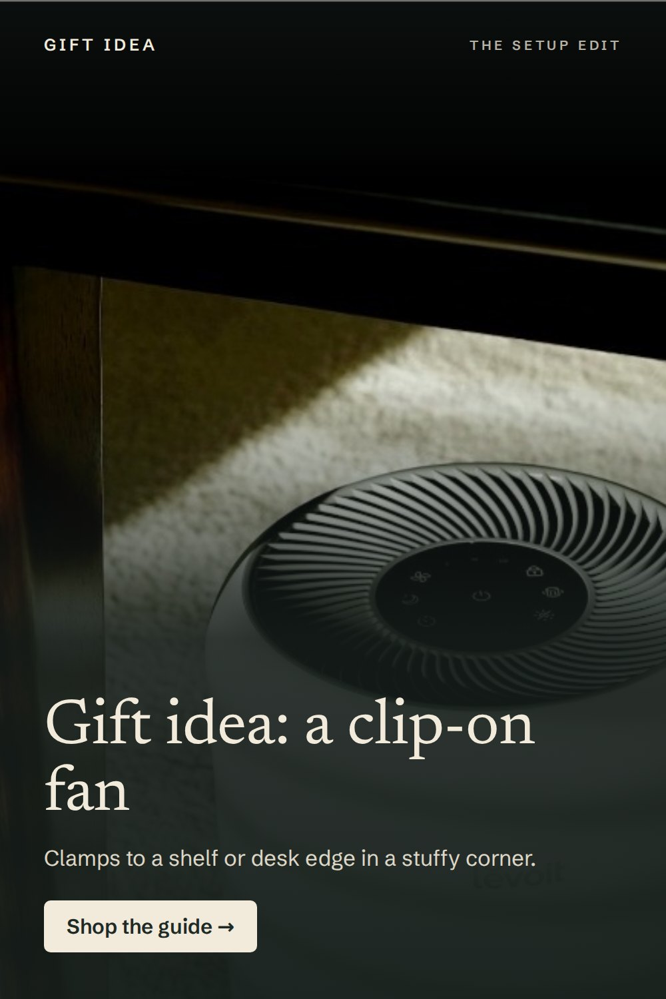
media/b6/b6-081-gift-idea-a-clip-on-fan.jpg
