qman122/thesetupedit/media/b6/b6-085-mini-faux-plants-green-nothing-to-water.jpg

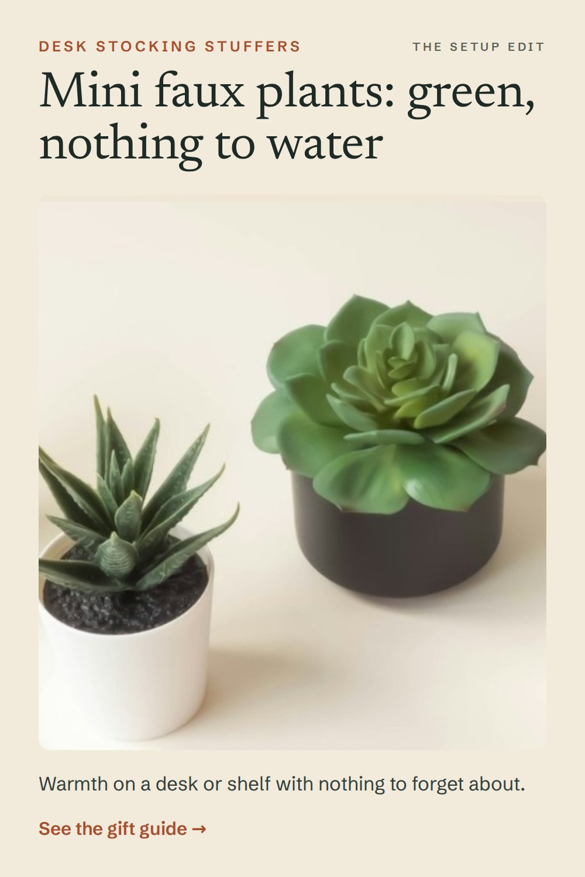
media/b6/b6-085-mini-faux-plants-green-nothing-to-water.jpg
