qman122/thesetupedit/media/b6/b6-086-multi-device-mouse-one-mouse-three-devices.jpg

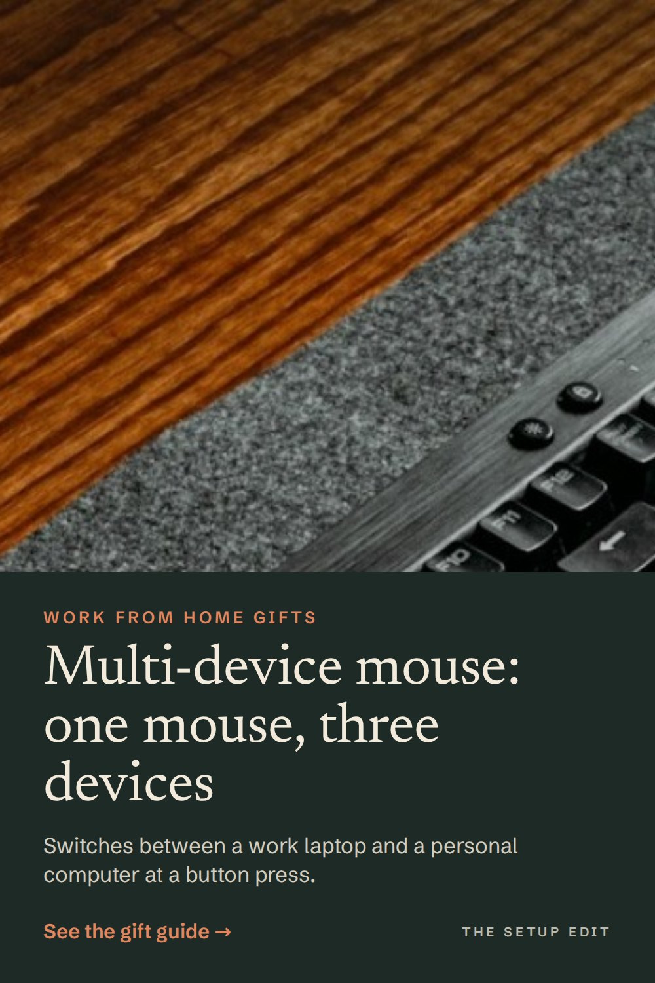
media/b6/b6-086-multi-device-mouse-one-mouse-three-devices.jpg
