qman122/thesetupedit/media/b6/b6-088-gift-idea-mini-faux-plants.jpg

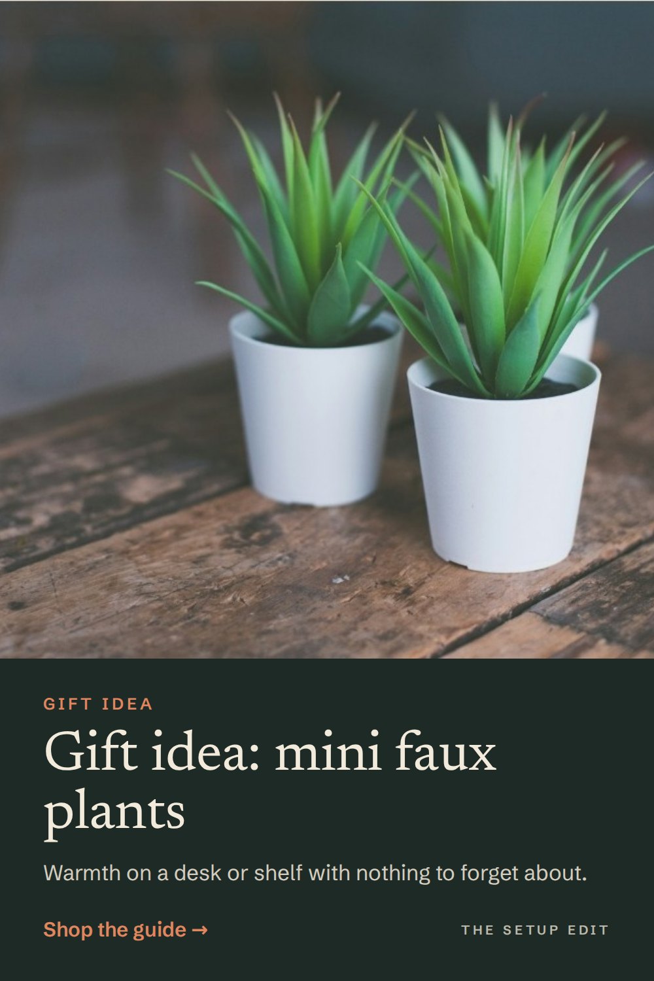
media/b6/b6-088-gift-idea-mini-faux-plants.jpg
