qman122/thesetupedit/media/b6/b6-089-minimalist-desk-essentials.jpg

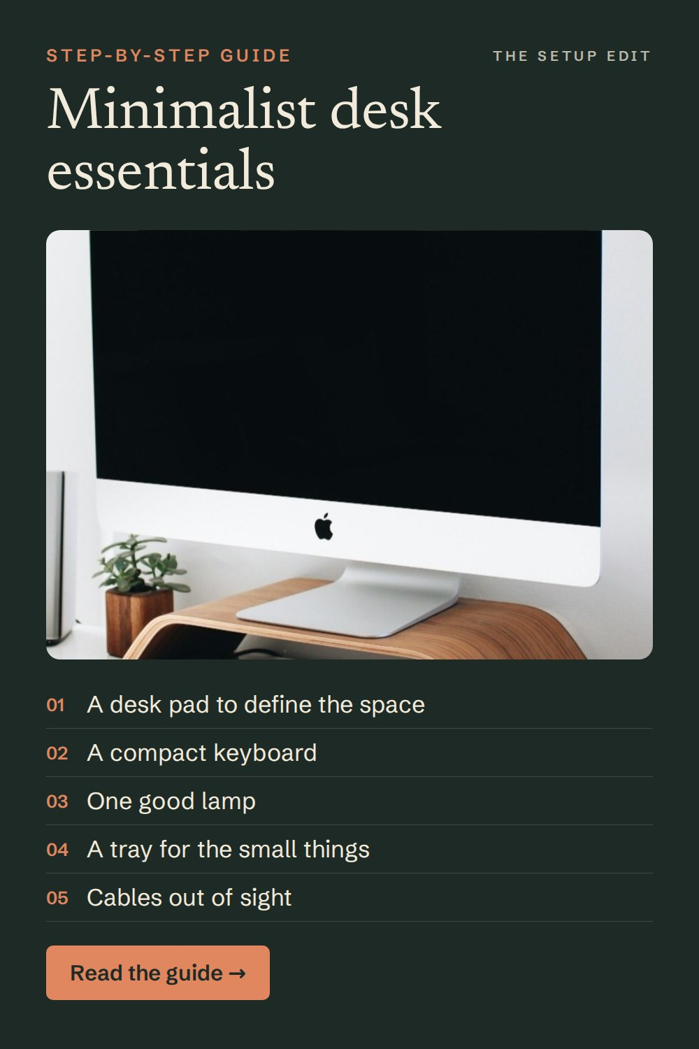
media/b6/b6-089-minimalist-desk-essentials.jpg
