qman122/thesetupedit/media/b6/b6-090-gift-idea-a-multi-device-mouse.jpg

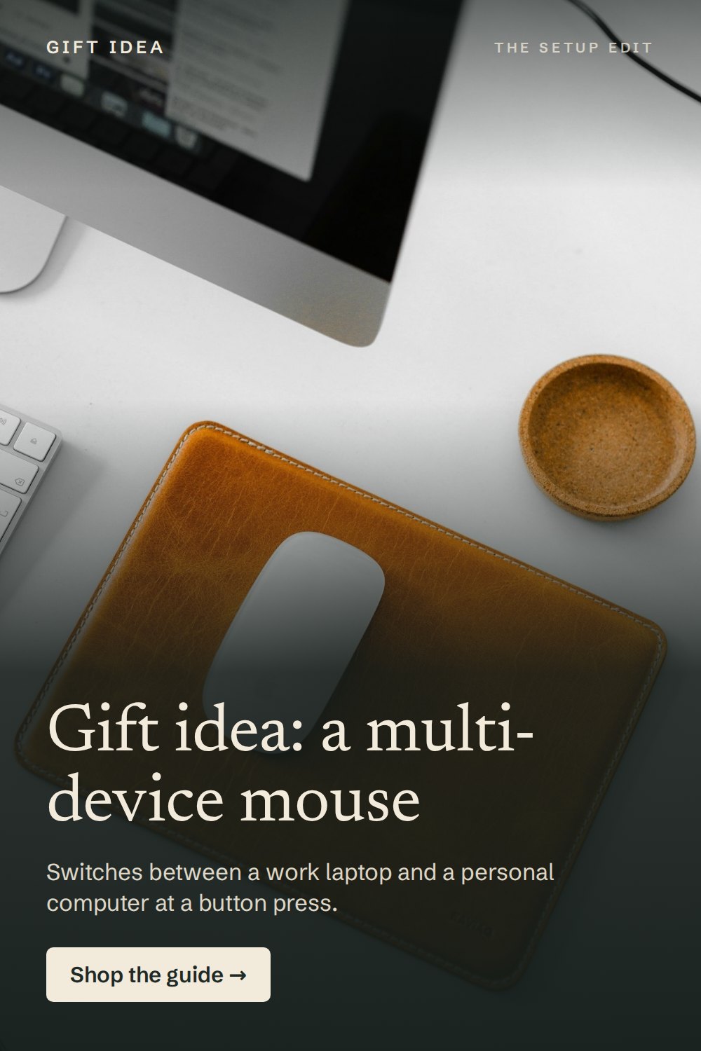
media/b6/b6-090-gift-idea-a-multi-device-mouse.jpg
