qman122/thesetupedit/media/b6/b6-094-ergonomic-mesh-chair.jpg

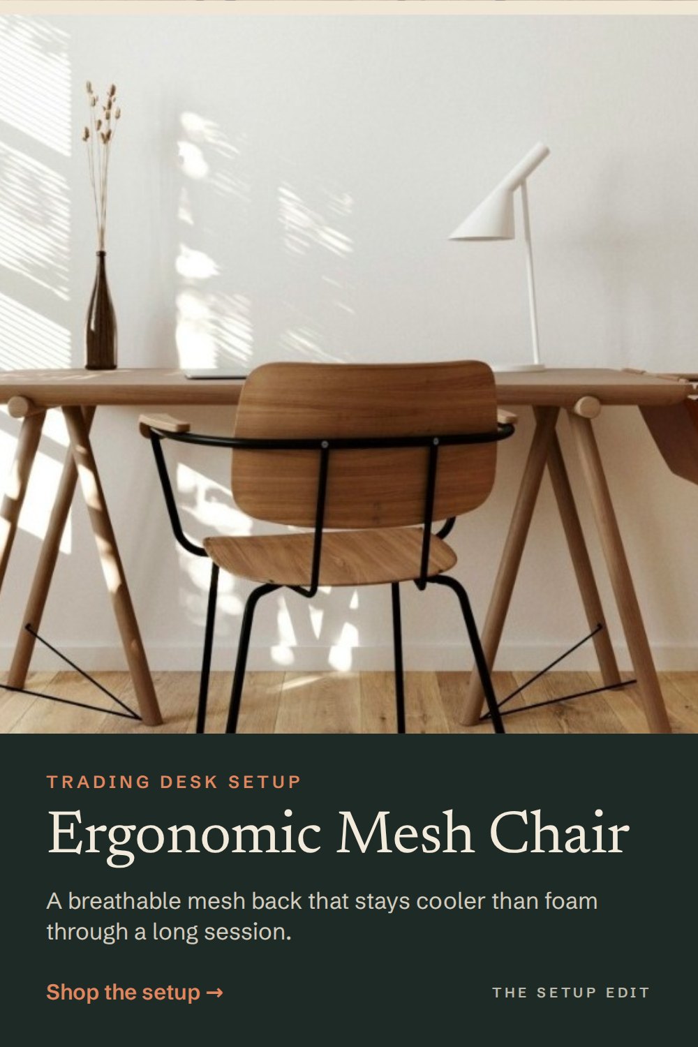
media/b6/b6-094-ergonomic-mesh-chair.jpg
