qman122/thesetupedit/media/b6/b6-095-technical-analysis-of-the-financial-markets-the-.jpg

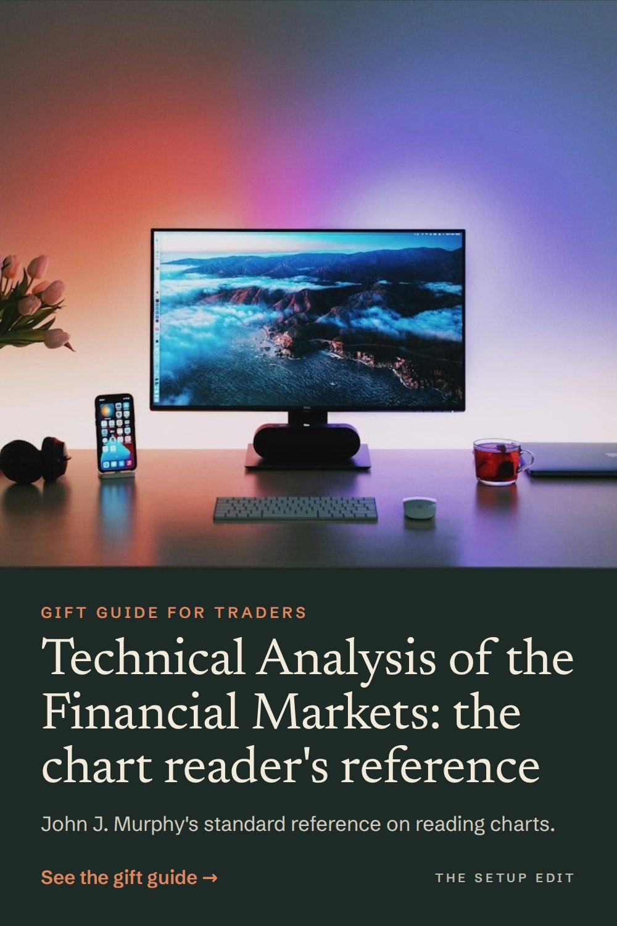
media/b6/b6-095-technical-analysis-of-the-financial-markets-the-.jpg
