qman122/thesetupedit/media/b6/b6-098-gift-idea-technical-analysis-of-the-financial-ma.jpg

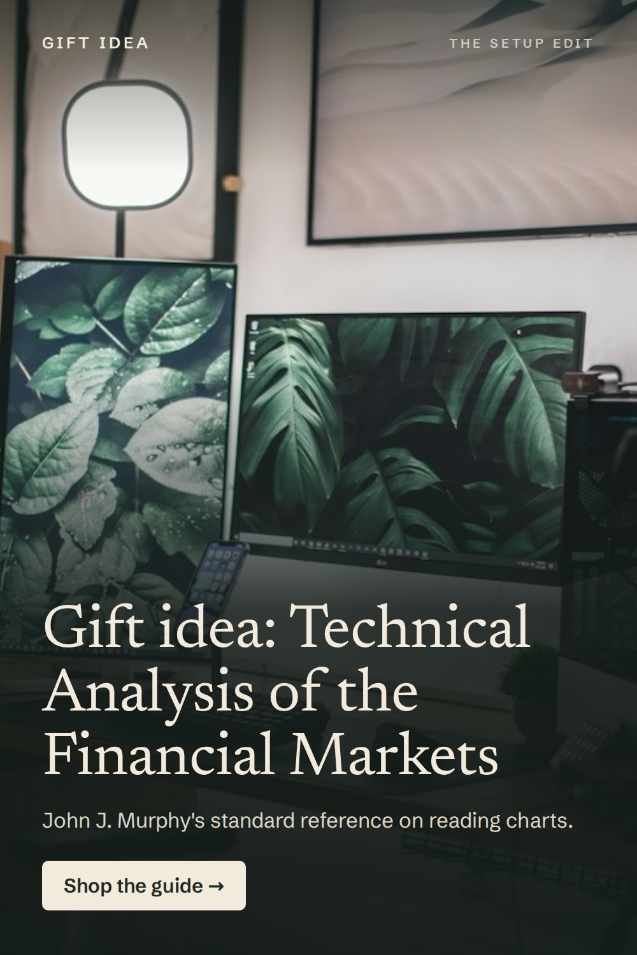
media/b6/b6-098-gift-idea-technical-analysis-of-the-financial-ma.jpg
