qman122/thesetupedit/media/b6/b6-100-stocking-stuffers-for-a-better-desk.jpg

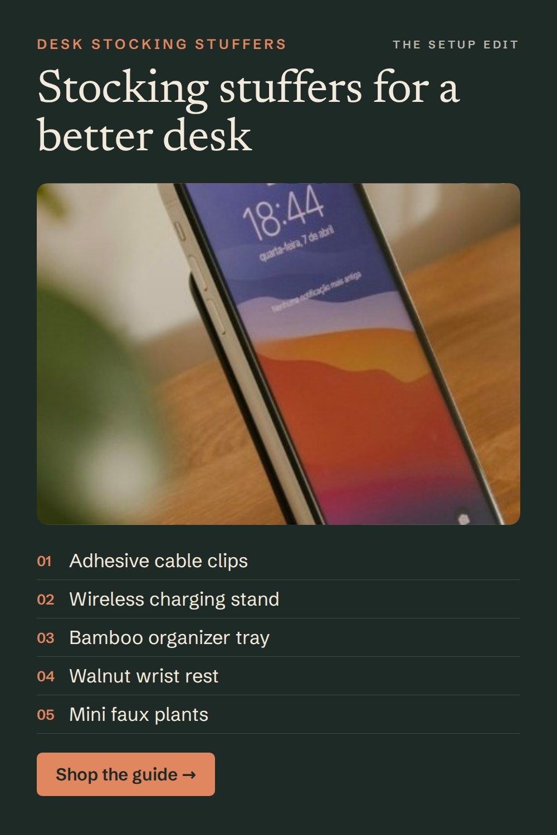
media/b6/b6-100-stocking-stuffers-for-a-better-desk.jpg
