qman122/thesetupedit/media/b6/b6-103-small-desk-gifts-they-will-actually-use.jpg

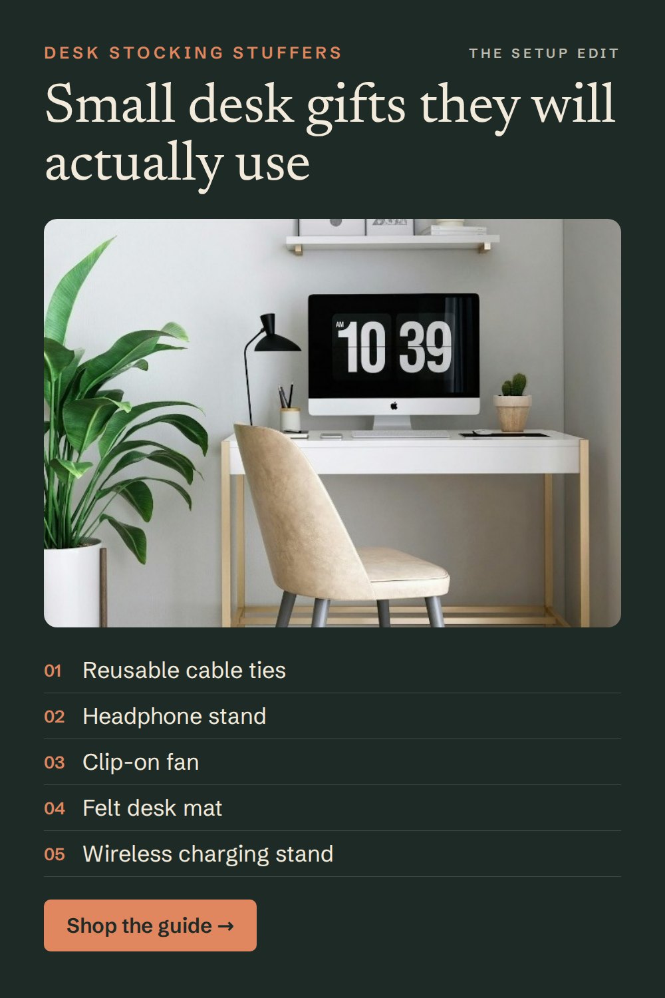
media/b6/b6-103-small-desk-gifts-they-will-actually-use.jpg
