qman122/thesetupedit/media/b6/b6-107-stocking-stuffers-for-a-messy-desk.jpg

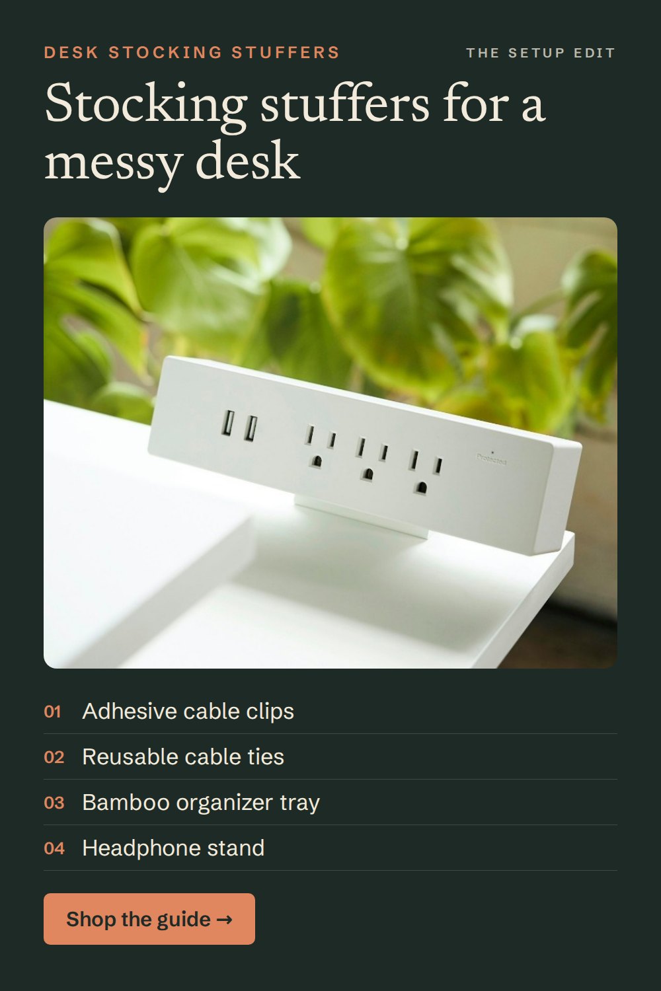
media/b6/b6-107-stocking-stuffers-for-a-messy-desk.jpg
