qman122/thesetupedit/media/b6/b6-110-4-books-to-gift-a-trader.jpg

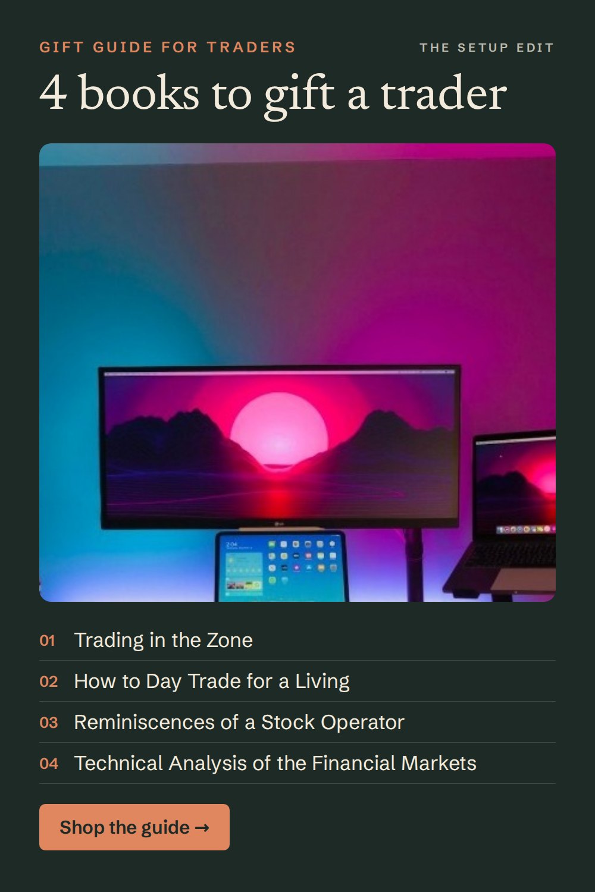
media/b6/b6-110-4-books-to-gift-a-trader.jpg
