qman122/thesetupedit/media/b6/b6-116-gift-ideas-for-remote-workers.jpg

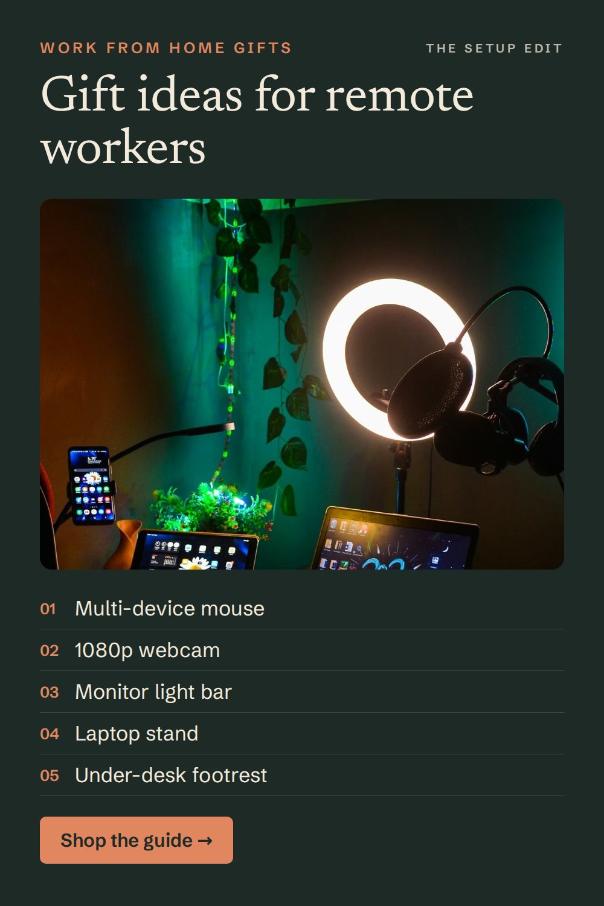
media/b6/b6-116-gift-ideas-for-remote-workers.jpg
