qman122/thesetupedit/media/b6/b6-118-small-gifts-for-anyone-with-a-desk.jpg

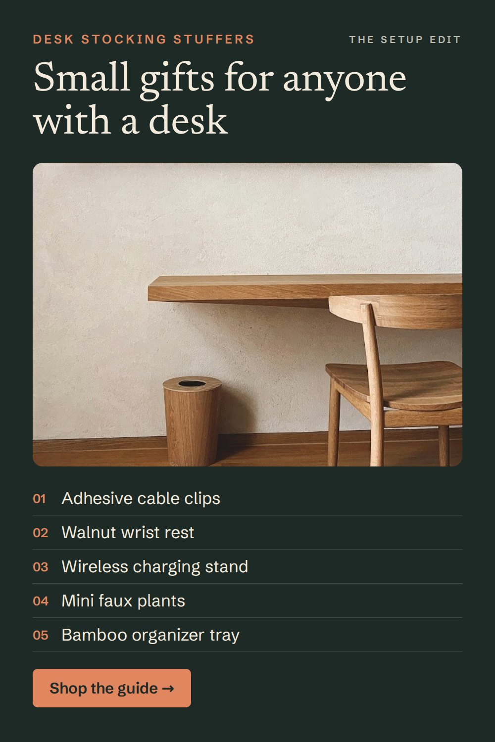
media/b6/b6-118-small-gifts-for-anyone-with-a-desk.jpg
