qman122/thesetupedit/media/b6/b6-125-not-sure-what-to-get-a-trader.jpg

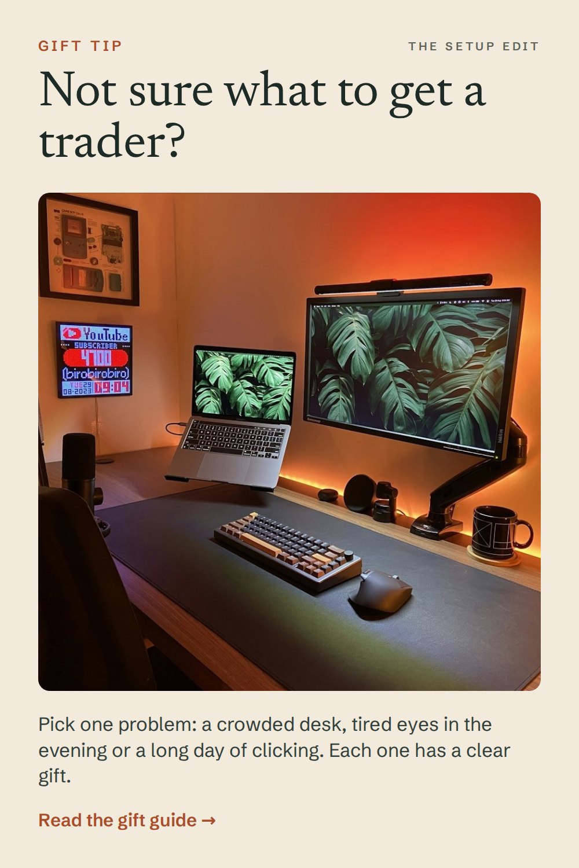
media/b6/b6-125-not-sure-what-to-get-a-trader.jpg
