qman122/thesetupedit/media/b6/b6-127-skip-the-furniture.jpg

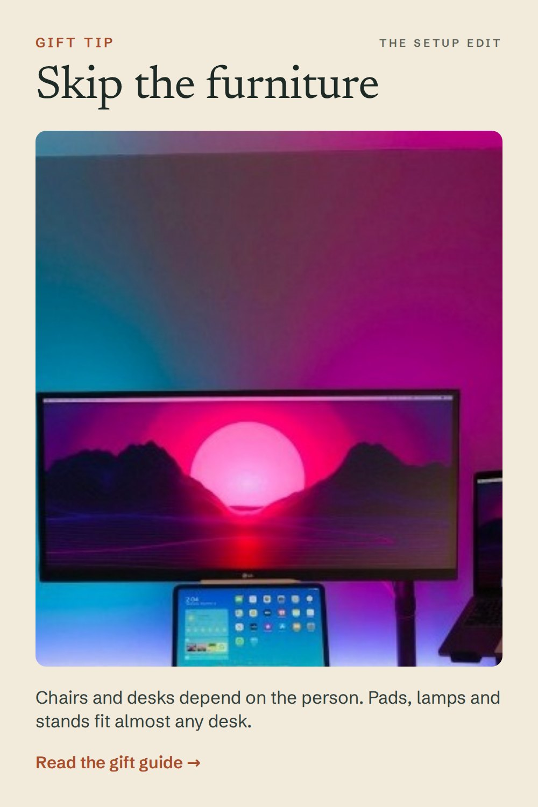
media/b6/b6-127-skip-the-furniture.jpg
