qman122/thesetupedit/media/b6/b6-129-the-principle-function-first-then-fewer-and-bett.jpg

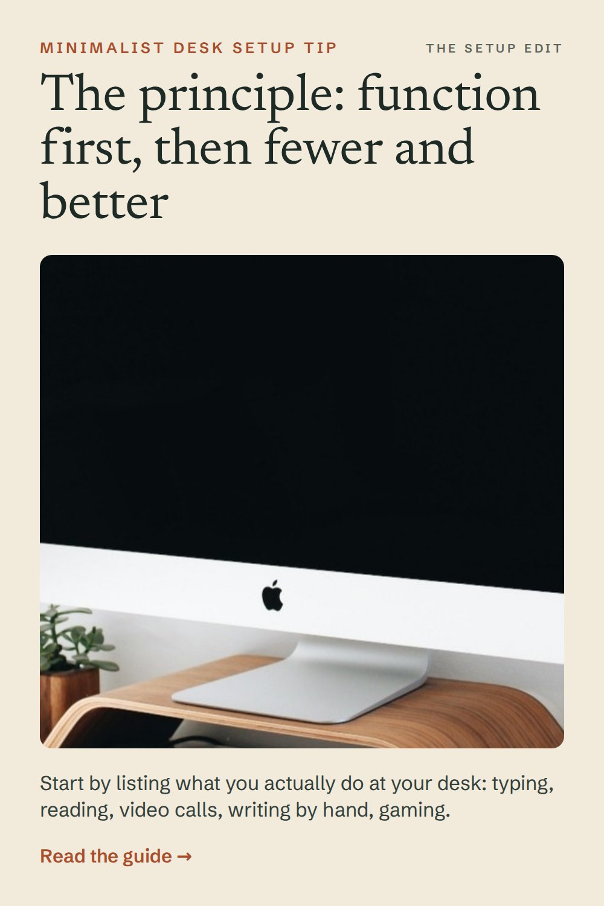
media/b6/b6-129-the-principle-function-first-then-fewer-and-bett.jpg
