qman122/thesetupedit/media/b6/b6-130-stick-to-neutral-colors.jpg

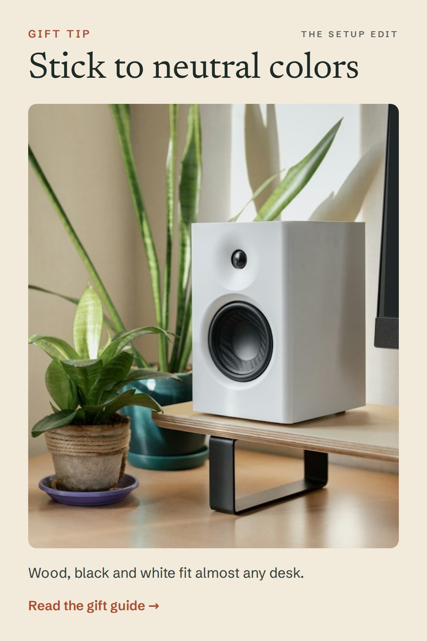
media/b6/b6-130-stick-to-neutral-colors.jpg
