qman122/thesetupedit/media/b6/b6-133-the-stocking-stuffer-they-will-use-daily.jpg

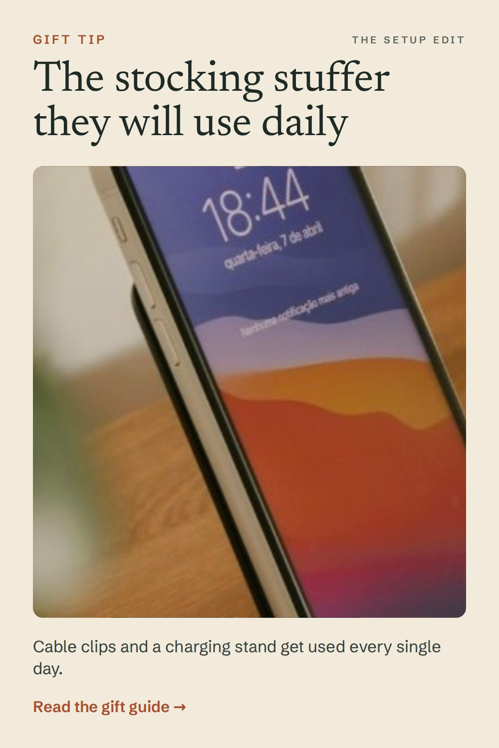
media/b6/b6-133-the-stocking-stuffer-they-will-use-daily.jpg
