qman122/thesetupedit/media/b6/b6-136-trader-gifts-that-are-not-gadgets.jpg

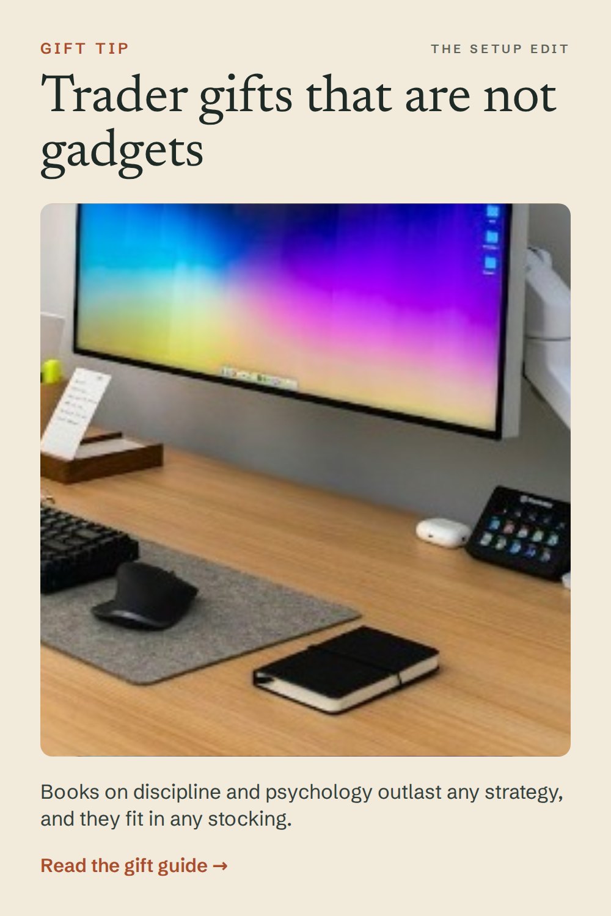
media/b6/b6-136-trader-gifts-that-are-not-gadgets.jpg
