qman122/thesetupedit/media/b6/b6-139-keep-the-keyboard-at-elbow-height.jpg

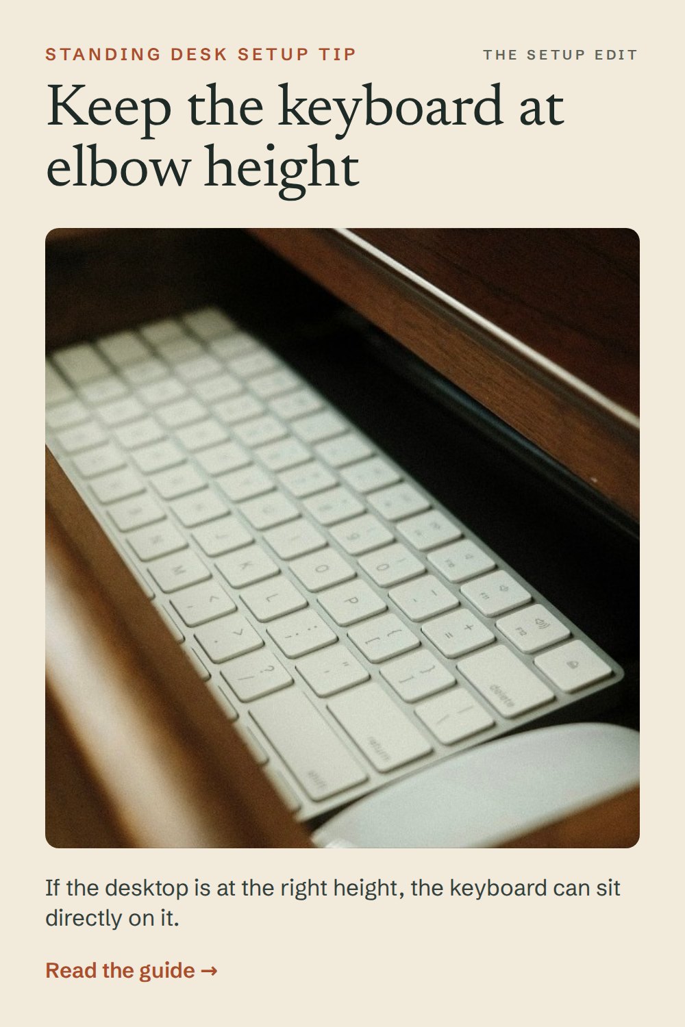
media/b6/b6-139-keep-the-keyboard-at-elbow-height.jpg
