qman122/thesetupedit/media/b6/b6-141-add-soft-light-behind-you-and-behind-the-screen.jpg

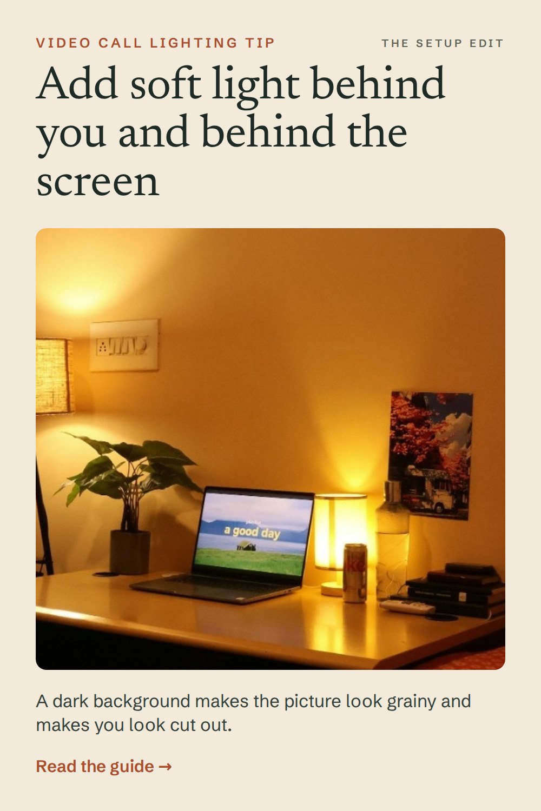
media/b6/b6-141-add-soft-light-behind-you-and-behind-the-screen.jpg
