qman122/thesetupedit/media/b6/b6-145-trading-in-the-zone.jpg

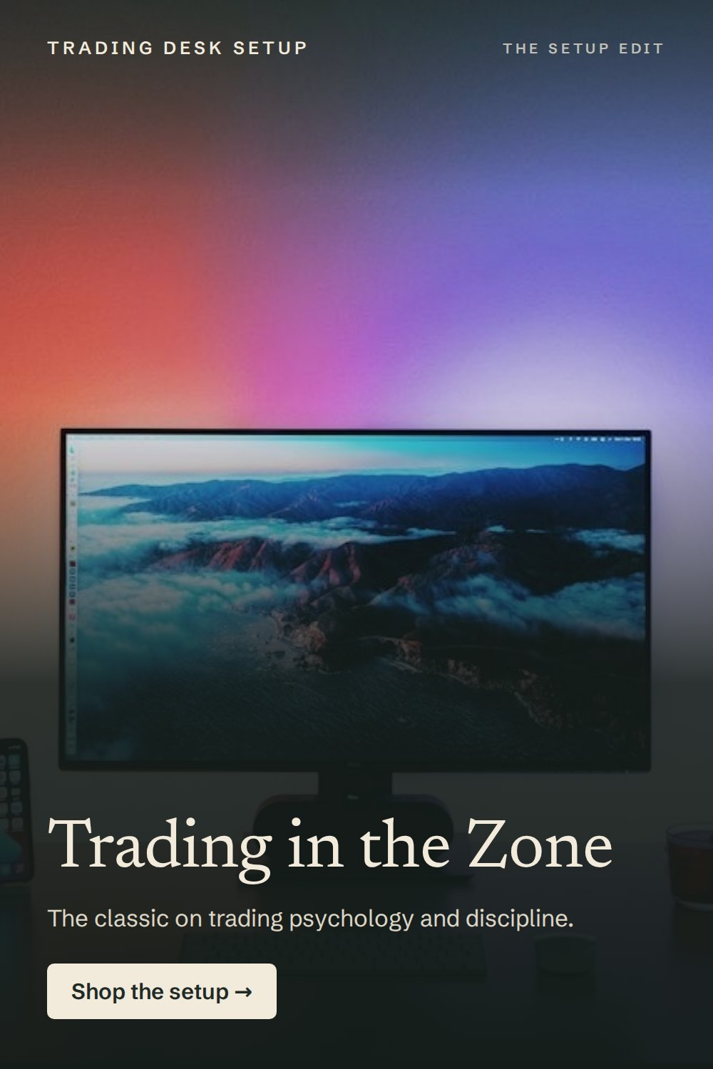
media/b6/b6-145-trading-in-the-zone.jpg
