qman122/thesetupedit/media/b6/b6-150-light-the-desk-not-the-bed.jpg

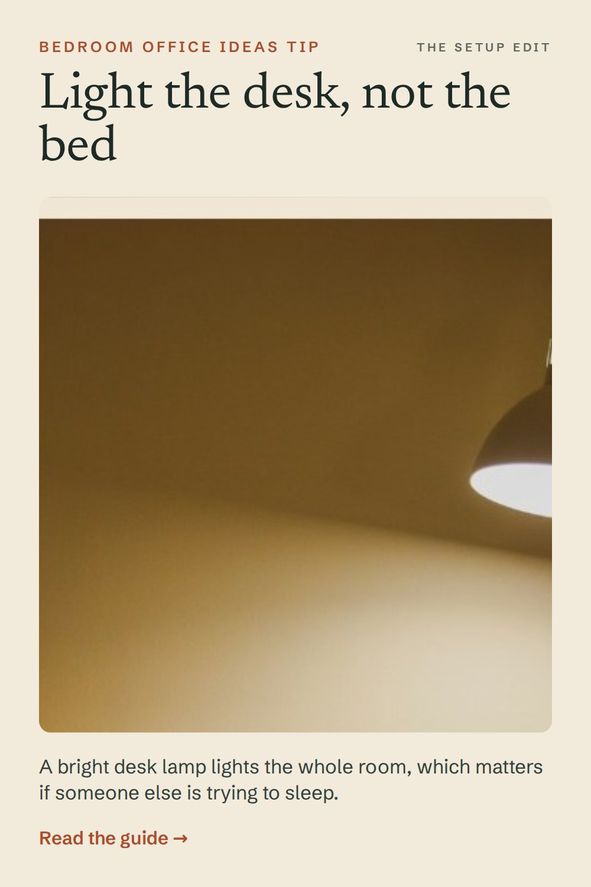
media/b6/b6-150-light-the-desk-not-the-bed.jpg
