qman122/thesetupedit/media/b6/b6-151-add-comfort-you-do-not-have-to-look-at.jpg

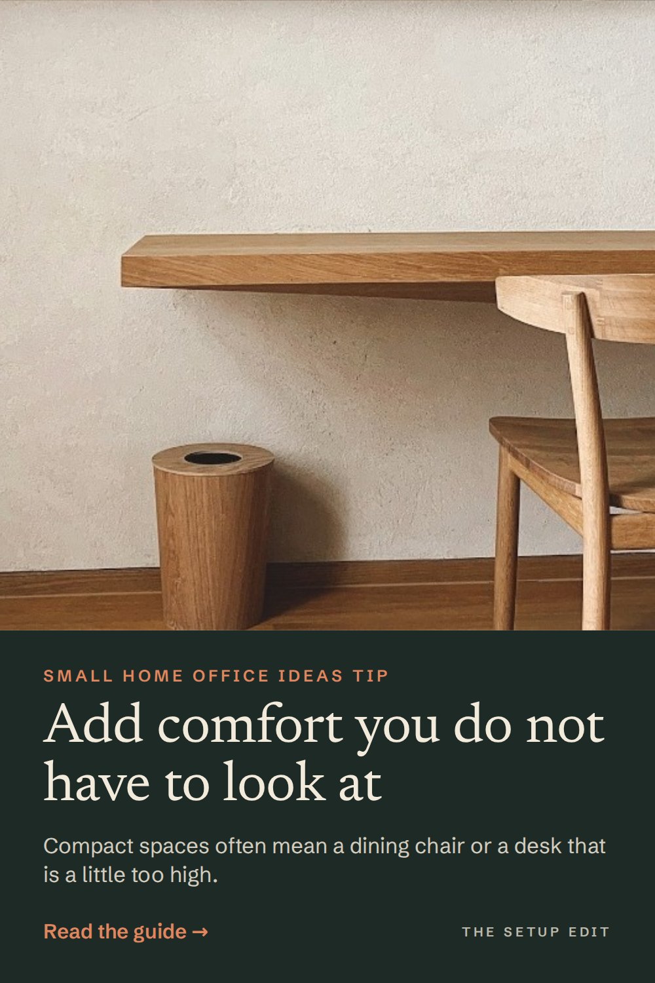
media/b6/b6-151-add-comfort-you-do-not-have-to-look-at.jpg
