qman122/thesetupedit/media/b6/b6-153-read-this-before-your-next-trade.jpg

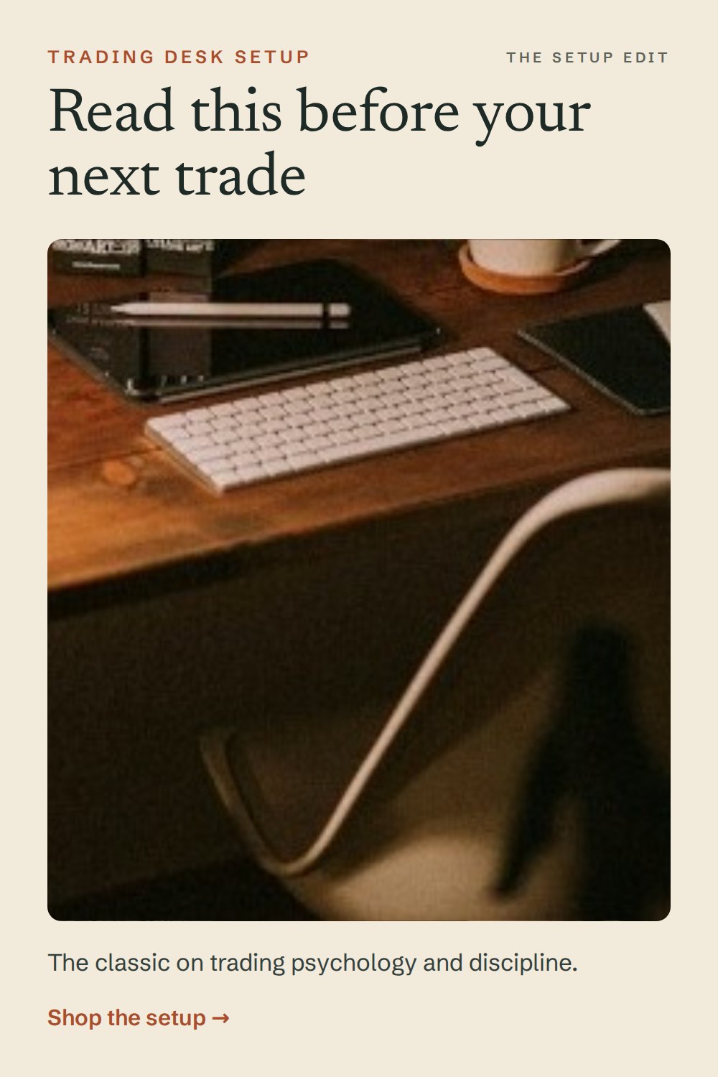
media/b6/b6-153-read-this-before-your-next-trade.jpg
