qman122/thesetupedit/media/b6/b6-154-the-case-for-the-mini-desk-plants.jpg

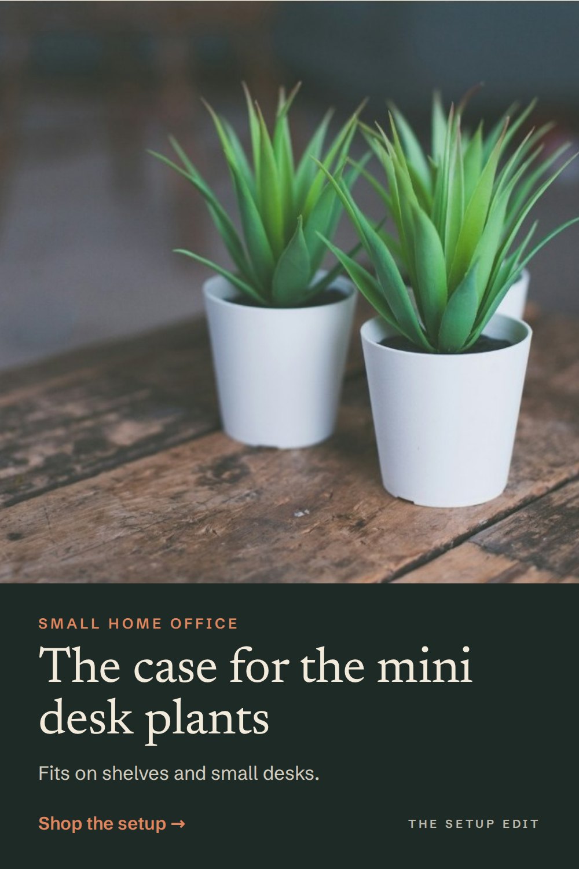
media/b6/b6-154-the-case-for-the-mini-desk-plants.jpg
