qman122/thesetupedit/media/b6/b6-155-do-not-skip-the-chair.jpg

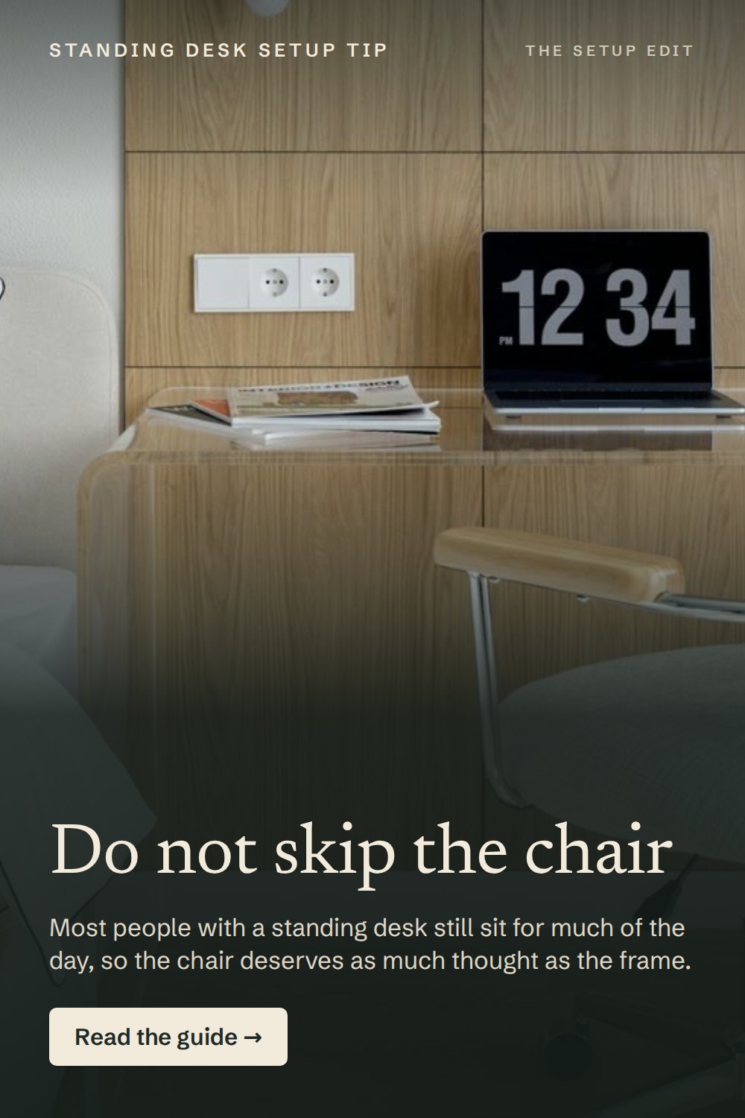
media/b6/b6-155-do-not-skip-the-chair.jpg
