qman122/thesetupedit/media/b6/b6-163-75-mechanical-keyboard.jpg

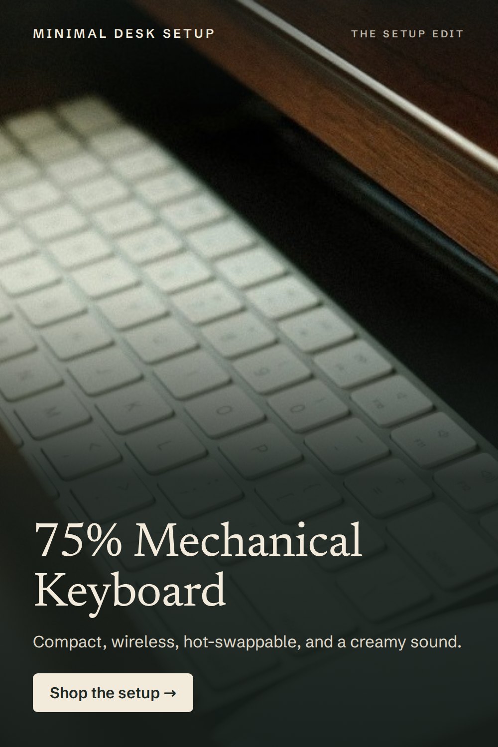
media/b6/b6-163-75-mechanical-keyboard.jpg
