qman122/thesetupedit/media/b6/b6-165-the-case-for-the-75-mechanical-keyboard.jpg

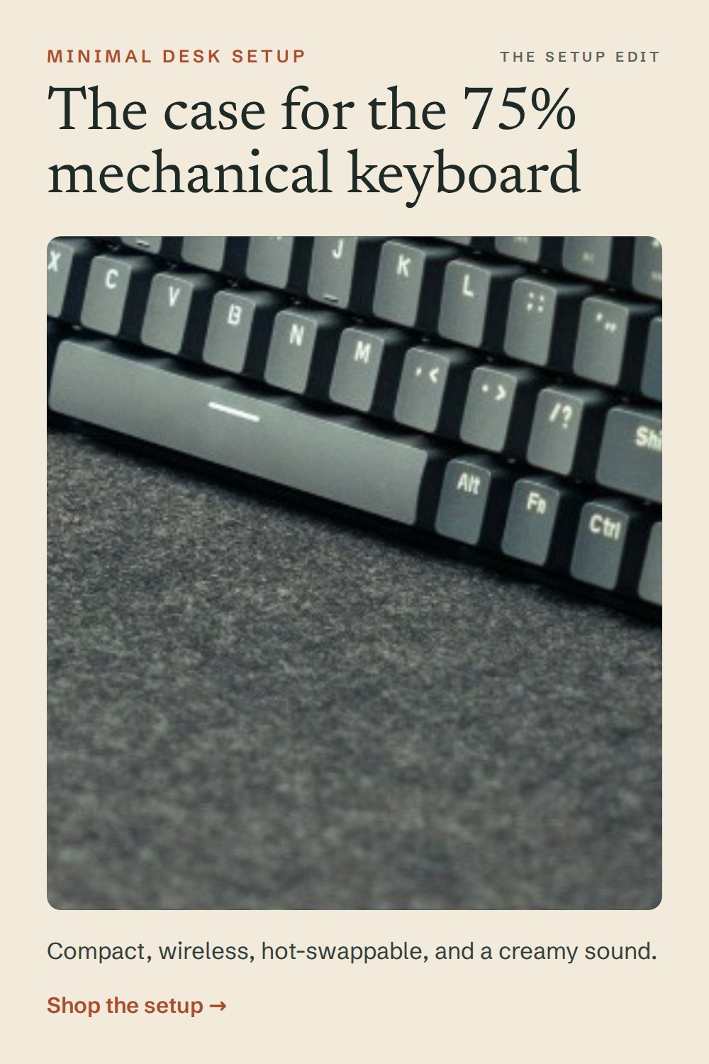
media/b6/b6-165-the-case-for-the-75-mechanical-keyboard.jpg
