qman122/thesetupedit/media/b6/b6-167-wooden-wrist-rest.jpg

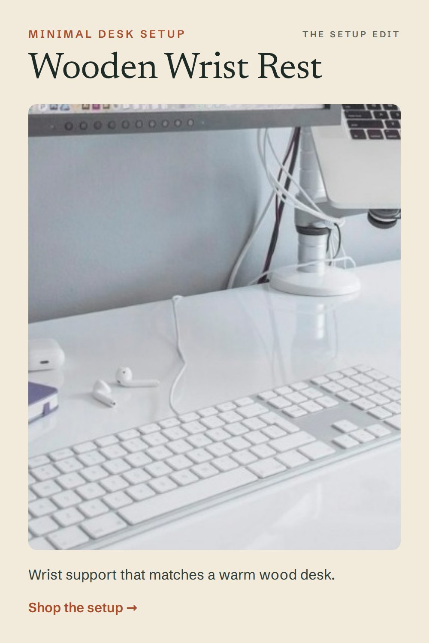
media/b6/b6-167-wooden-wrist-rest.jpg
