qman122/thesetupedit/media/b6/b6-168-a-clean-desk-for-the-new-year.jpg

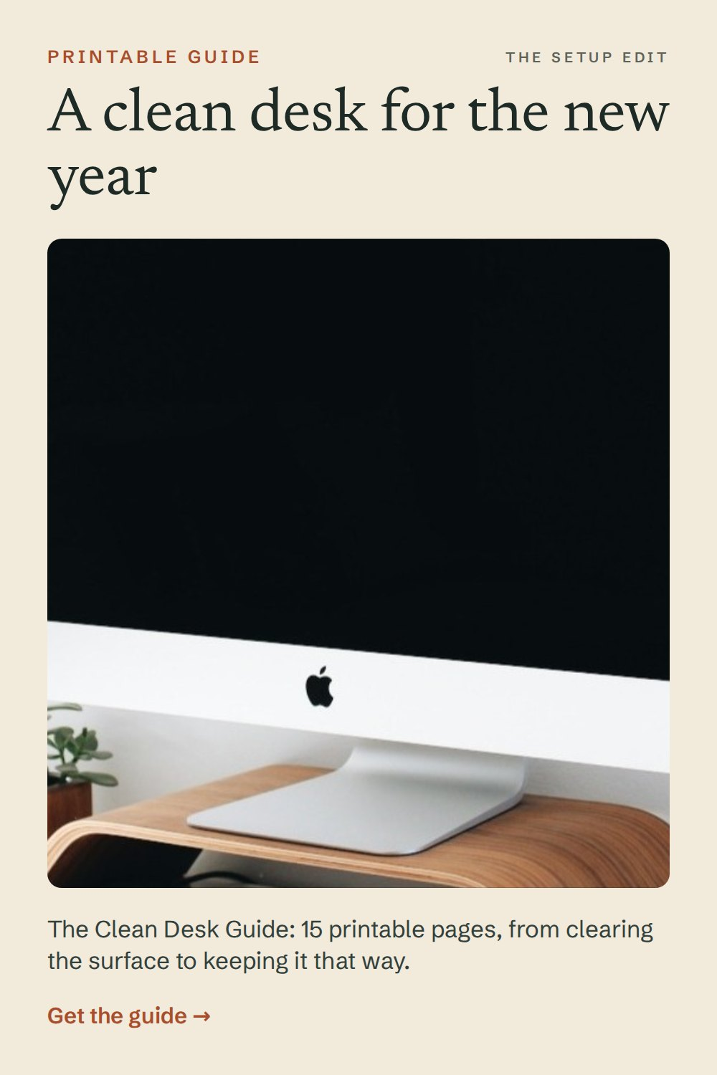
media/b6/b6-168-a-clean-desk-for-the-new-year.jpg
