qman122/thesetupedit/media/b6/b6-174-unplug-everything-and-take-stock.jpg

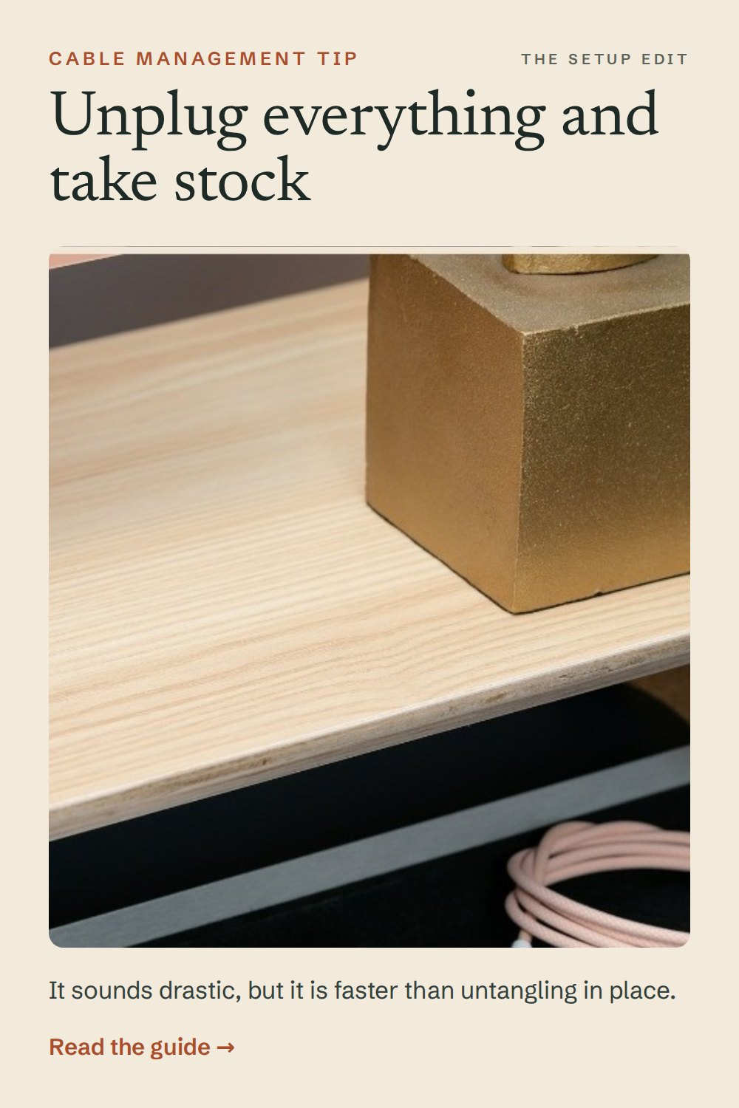
media/b6/b6-174-unplug-everything-and-take-stock.jpg
