qman122/thesetupedit/media/b6/b6-175-bamboo-organizer-tray.jpg

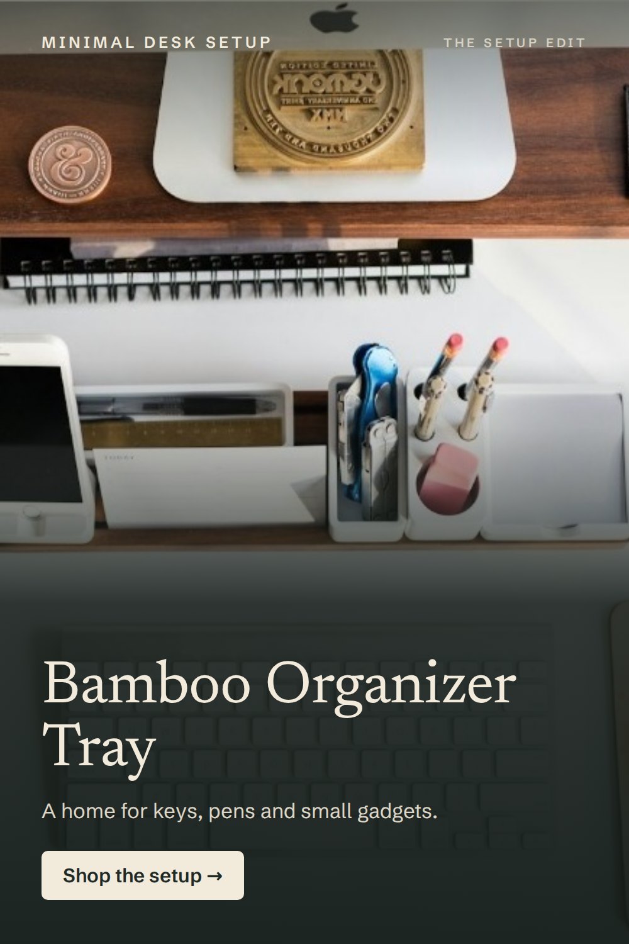
media/b6/b6-175-bamboo-organizer-tray.jpg
