qman122/thesetupedit/media/b6/b6-176-start-with-the-adhesive-cable-clips.jpg

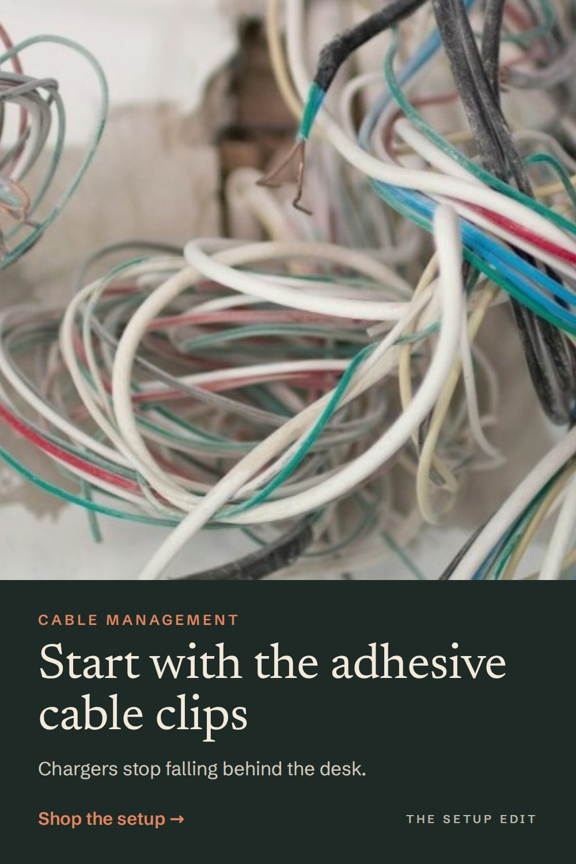
media/b6/b6-176-start-with-the-adhesive-cable-clips.jpg
