qman122/thesetupedit/media/b6/b6-180-the-case-for-the-bamboo-organizer-tray.jpg

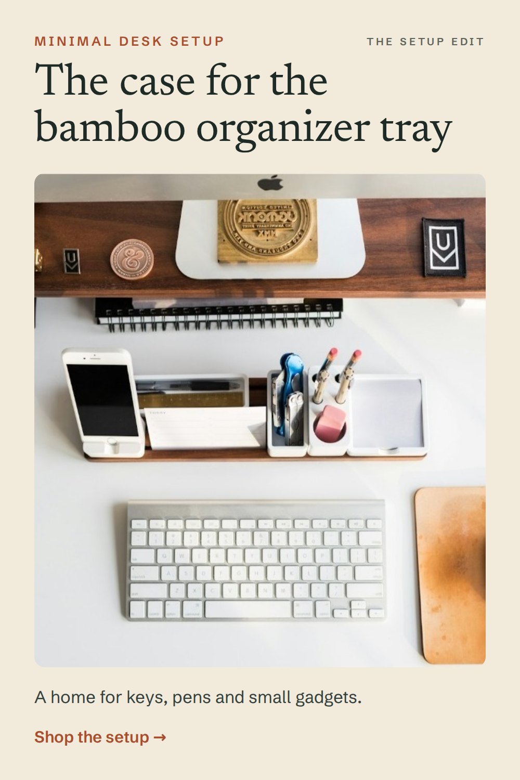
media/b6/b6-180-the-case-for-the-bamboo-organizer-tray.jpg
