qman122/thesetupedit/media/b6/b6-182-start-the-year-at-a-calm-desk.jpg

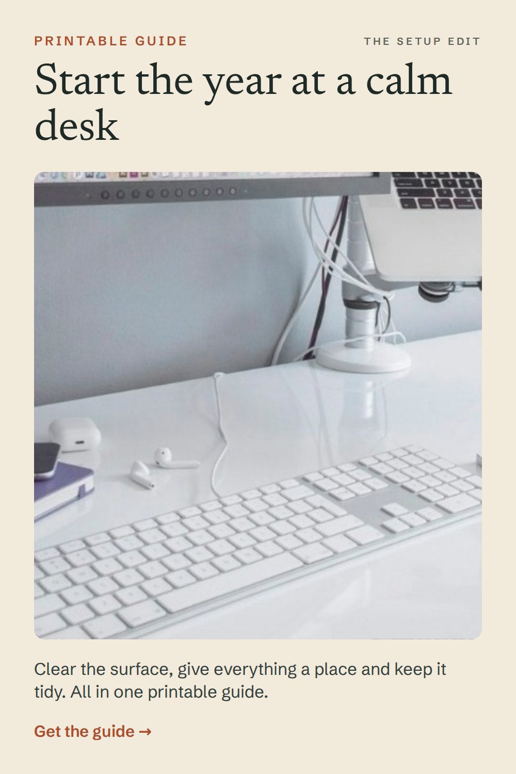
media/b6/b6-182-start-the-year-at-a-calm-desk.jpg
