qman122/thesetupedit/media/b6/b6-183-route-everything-along-one-path.jpg

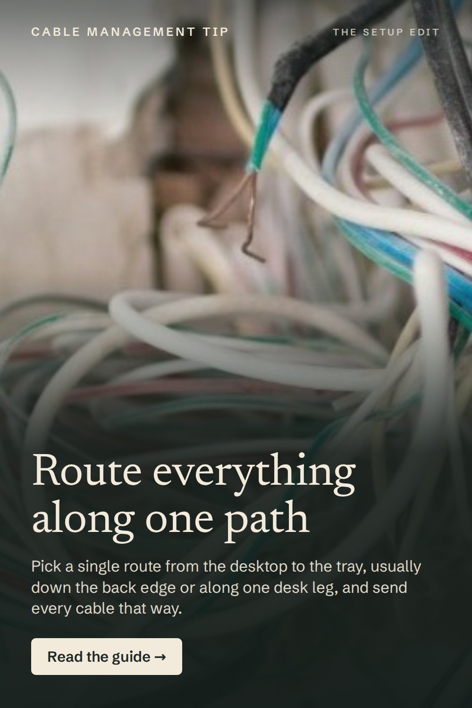
media/b6/b6-183-route-everything-along-one-path.jpg
