qman122/thesetupedit/media/b6/b6-185-quiet-wallpapers-for-a-calm-desk.jpg

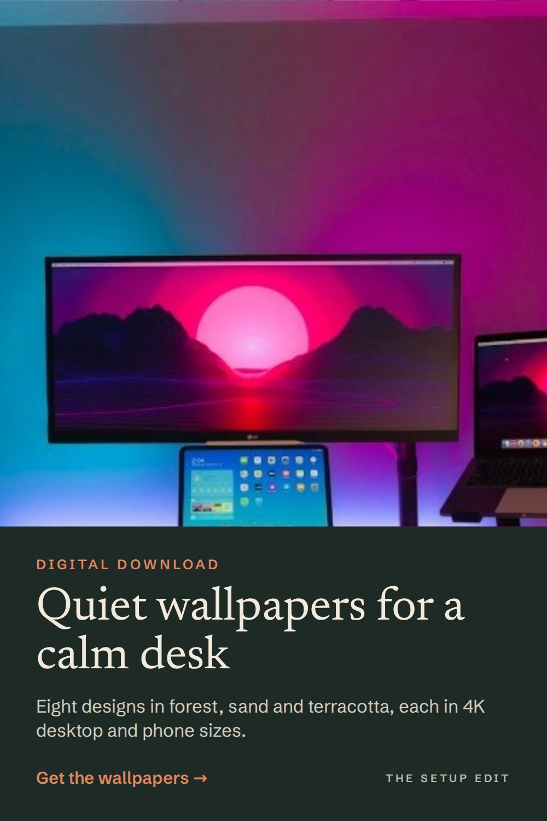
media/b6/b6-185-quiet-wallpapers-for-a-calm-desk.jpg
