qman122/thesetupedit/media/b6/b6-190-a-tidy-desk-for-the-new-year-free.jpg

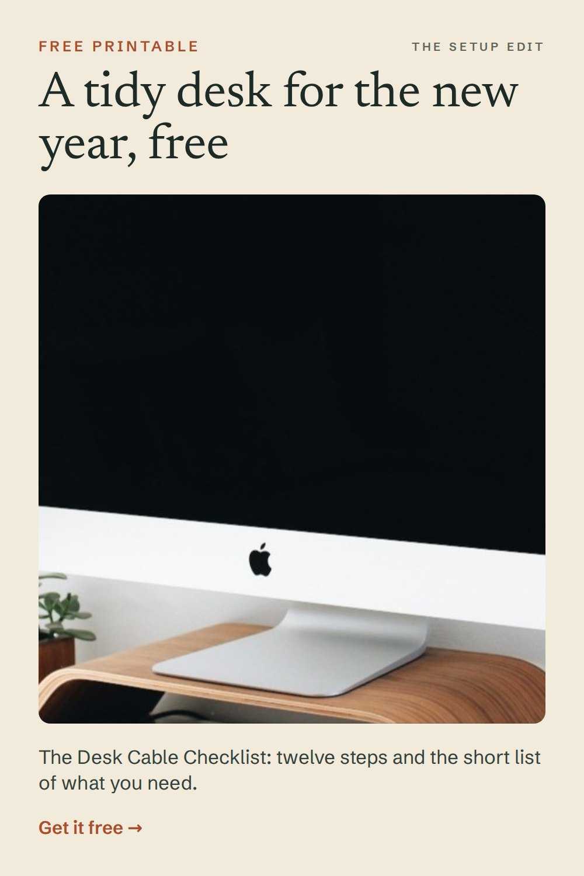
media/b6/b6-190-a-tidy-desk-for-the-new-year-free.jpg
