qman122/thesetupedit/media/b6/b6-191-a-new-wallpaper-for-a-new-year.jpg

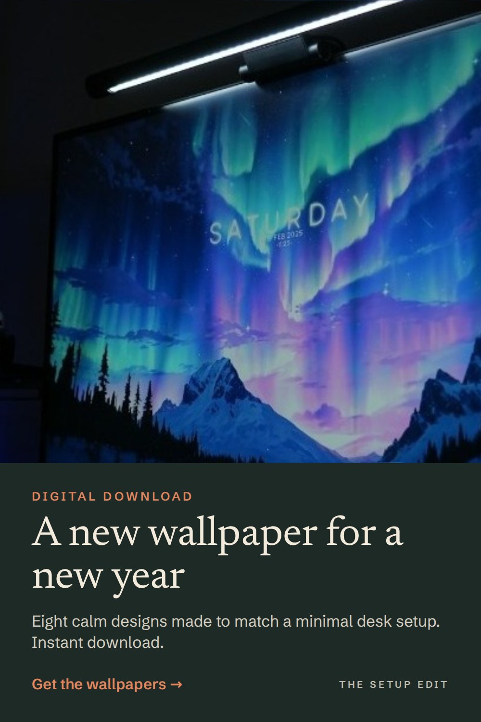
media/b6/b6-191-a-new-wallpaper-for-a-new-year.jpg
