qman122/thesetupedit/media/b6/b6-193-the-cheapest-desk-upgrade.jpg

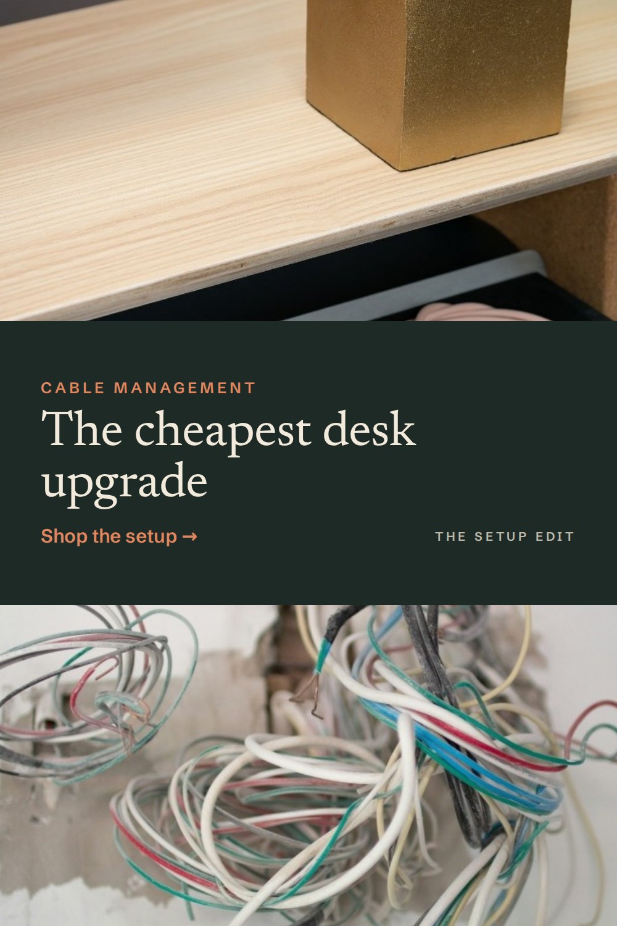
media/b6/b6-193-the-cheapest-desk-upgrade.jpg
