qman122/thesetupedit/media/b6/b6-194-a-calm-desk-in-15-pages.jpg

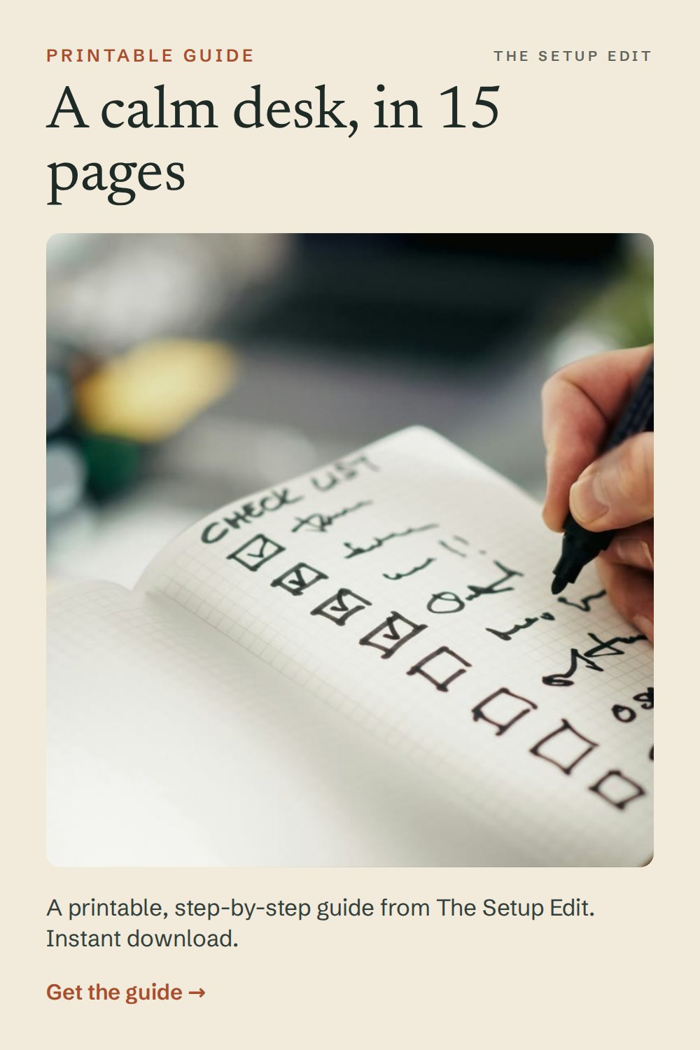
media/b6/b6-194-a-calm-desk-in-15-pages.jpg
