qman122/thesetupedit/media/b6/b6-200-declutter-your-desk-this-weekend.jpg

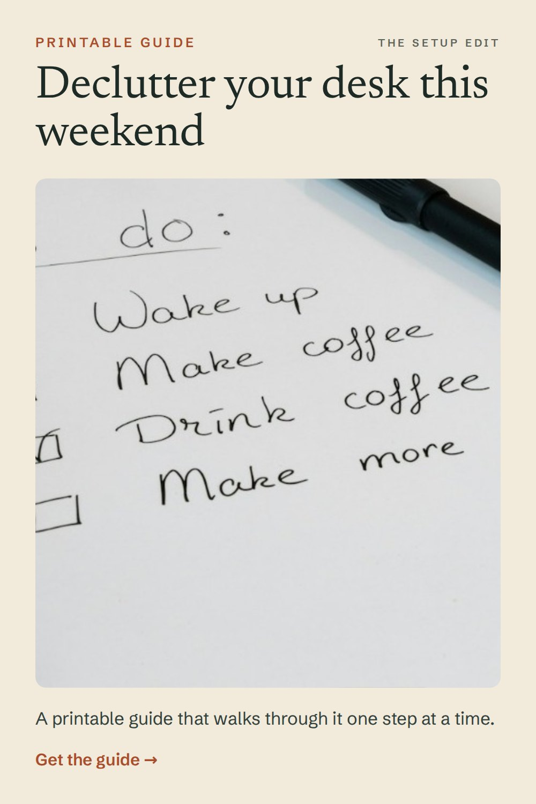
media/b6/b6-200-declutter-your-desk-this-weekend.jpg
