qman122/thesetupedit/media/b6/b6-201-label-and-leave-some-slack.jpg

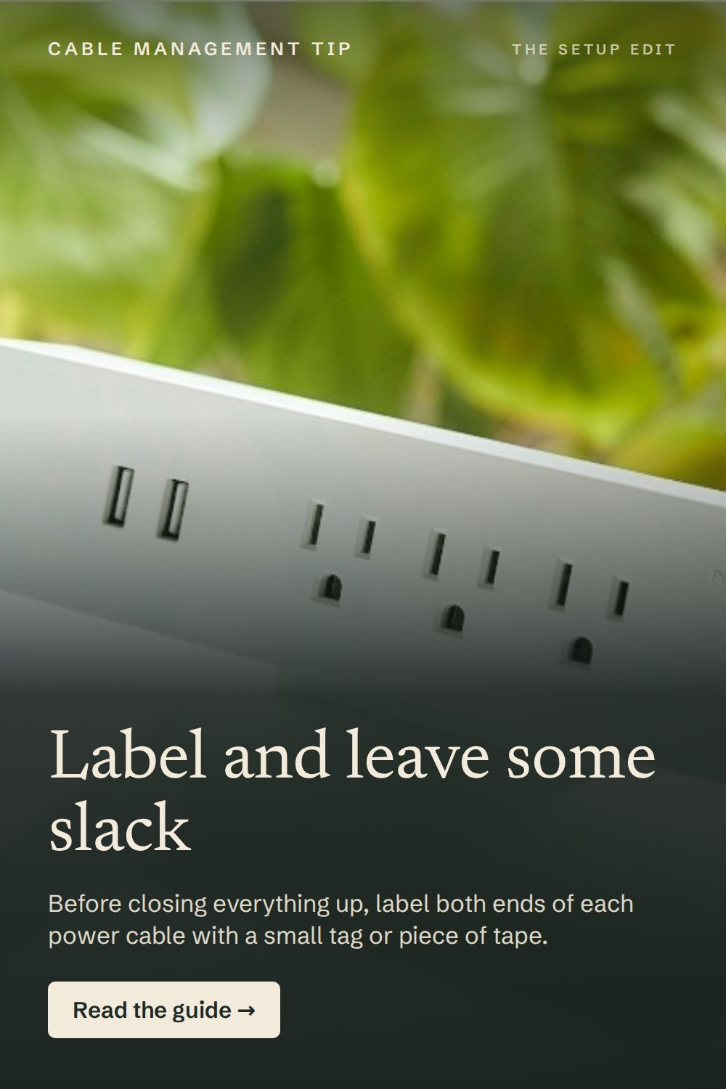
media/b6/b6-201-label-and-leave-some-slack.jpg
