qman122/thesetupedit/media/pin-s07-cable-free-desk.png

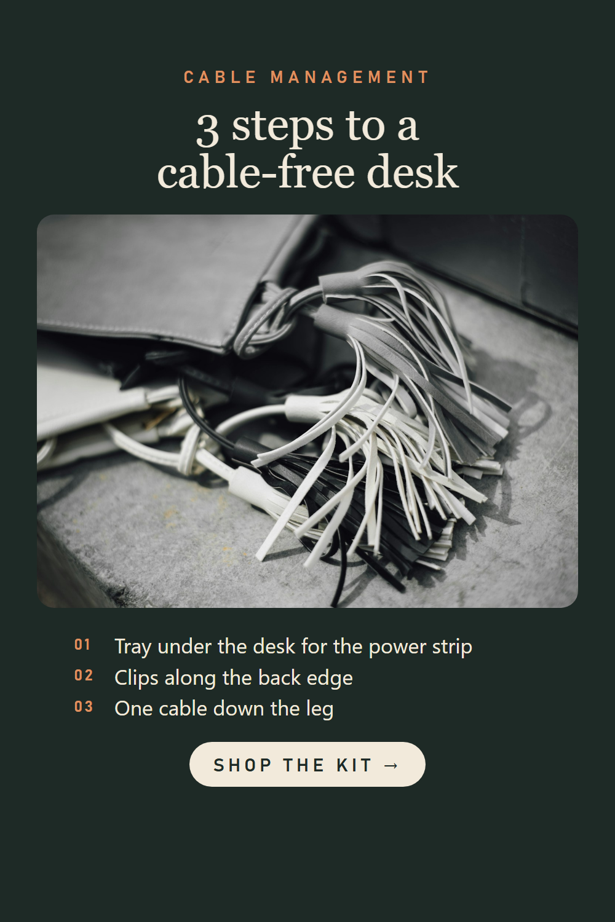
media/pin-s07-cable-free-desk.png
