qman122/thesetupedit/c5-shroud/mockup/renders/3_close_up_parts_highlighted.png

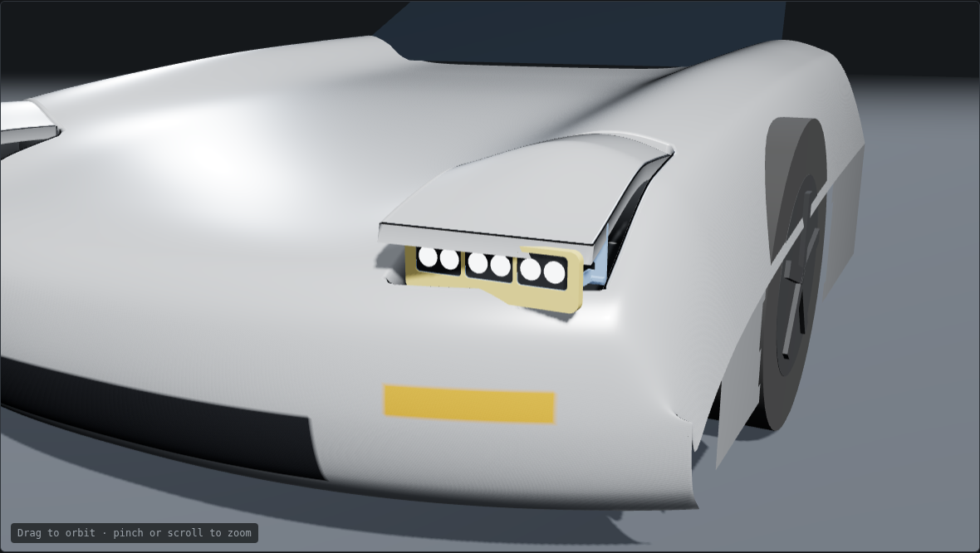
c5-shroud/mockup/renders/3_close_up_parts_highlighted.png
