qman122/thesetupedit/media/b6/b6-131-match-the-materials.jpg

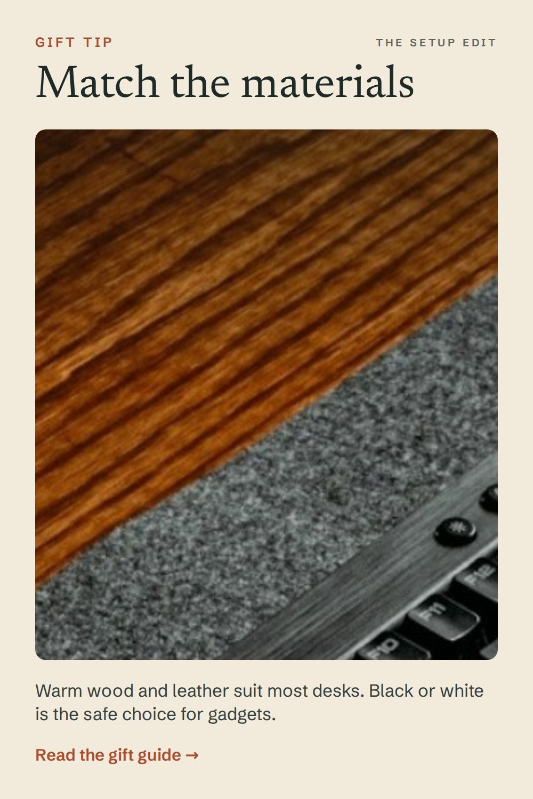
media/b6/b6-131-match-the-materials.jpg
