qman122/thesetupedit/media/b6/b6-187-two-parts-one-tidy-desk.jpg

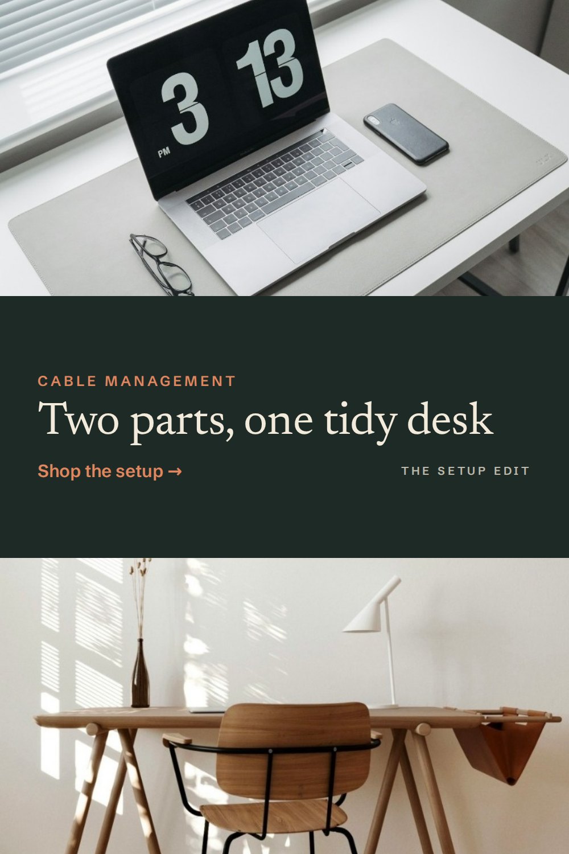
media/b6/b6-187-two-parts-one-tidy-desk.jpg
