qman122/thesetupedit/c5-shroud/stl/assembled/assembly_passenger.stl

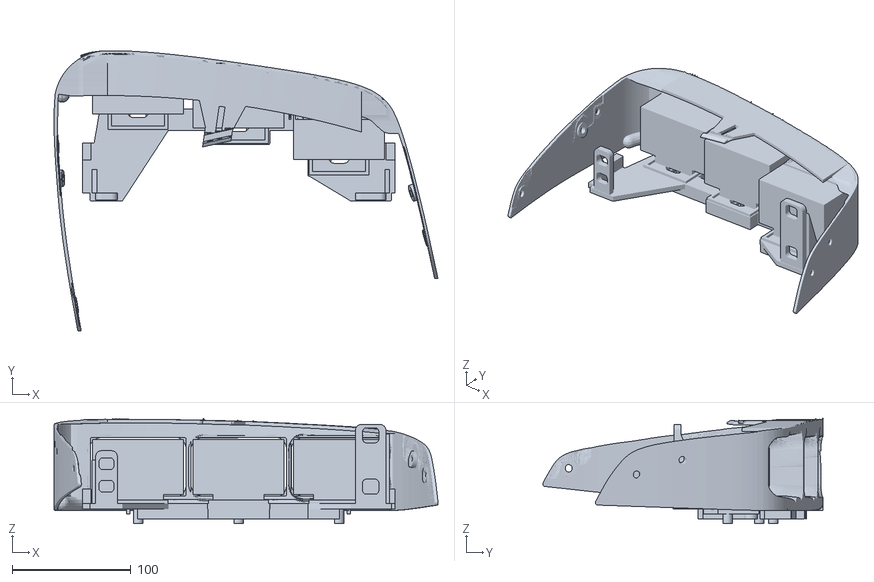
[picture p184: CAD file, 2026-09-29]
c5-shroud/stl/assembled/assembly_passenger.stl
323.1 x 236.0 x 88.4
