qman122/thesetupedit/c5-shroud/stl/cad/drl_inserts_passenger_P3D.stl

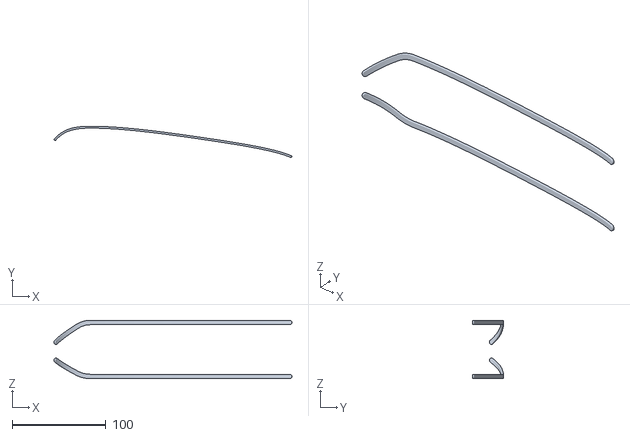
[picture p185: CAD file, 2026-10-03]
c5-shroud/stl/cad/drl_inserts_passenger_P3D.stl
254.2 x 33.6 x 62.3
