qman122/thesetupedit/c5-shroud/stl/fit_test_blade_passenger_one_piece.stl

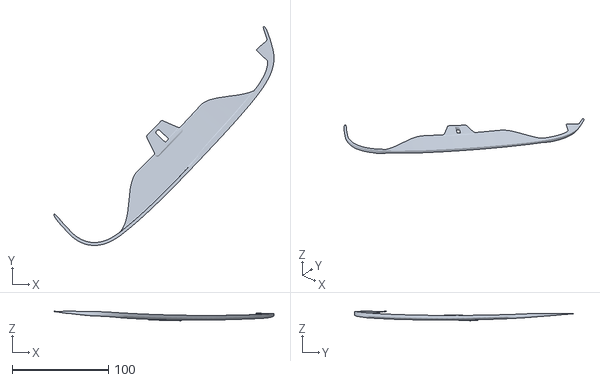
[picture p186: CAD file, 2026-10-02]
c5-shroud/stl/fit_test_blade_passenger_one_piece.stl
228.7 x 227.5 x 9.91
