qman122/thesetupedit/c5-shroud/stl/projectors_P3C/bezel_passenger_hood_piece.stl

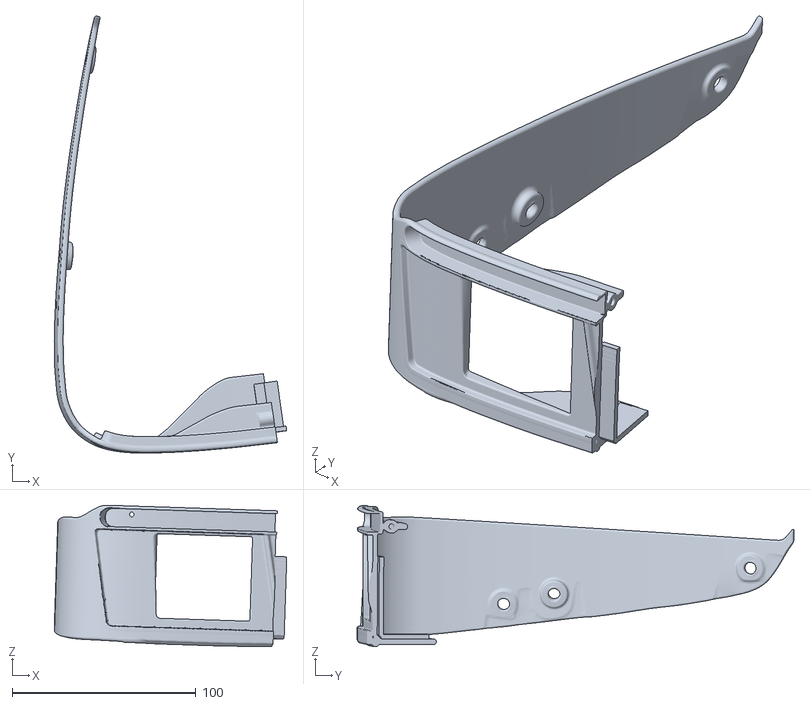
[picture p187: CAD file, 2026-10-03]
c5-shroud/stl/projectors_P3C/bezel_passenger_hood_piece.stl
126.6 x 237.9 x 77.0
