qman122/thesetupedit/c5-shroud/stl/projectors_P3D/bezel_joint_test_driver.stl

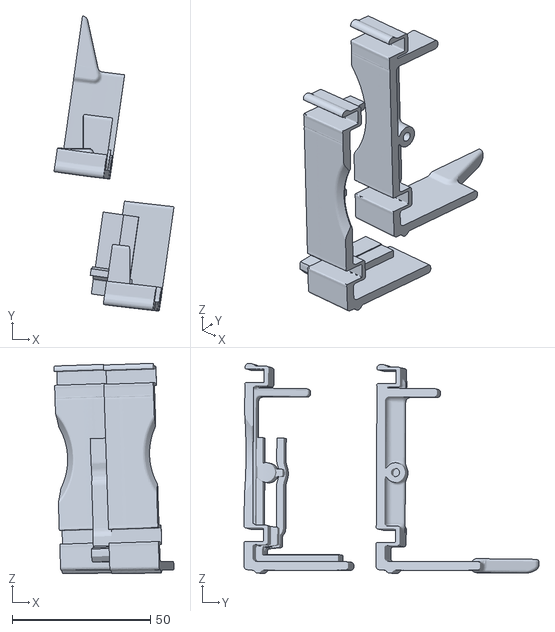
[picture p188: CAD file, 2026-10-03]
c5-shroud/stl/projectors_P3D/bezel_joint_test_driver.stl
43.4 x 106.9 x 76.2
