qman122/thesetupedit/c5-shroud/stl/projectors_P3R/bezel_driver_hood_piece.stl

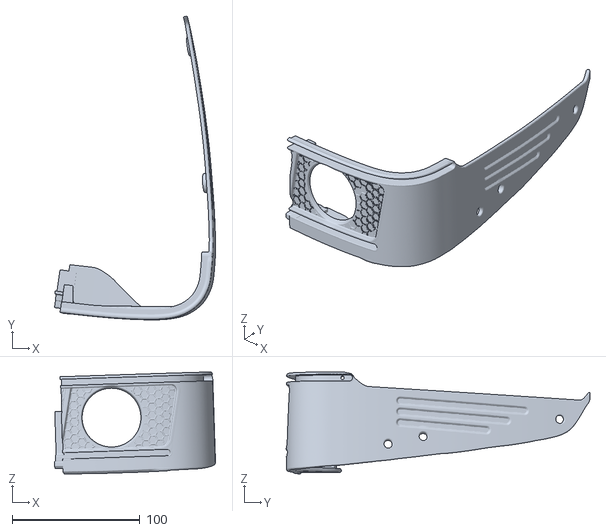
[picture p189: CAD file, 2026-10-03]
c5-shroud/stl/projectors_P3R/bezel_driver_hood_piece.stl
126.2 x 238.0 x 79.9
