qman122/thesetupedit/c5-shroud/stl/bezel_passenger_hood_piece.stl

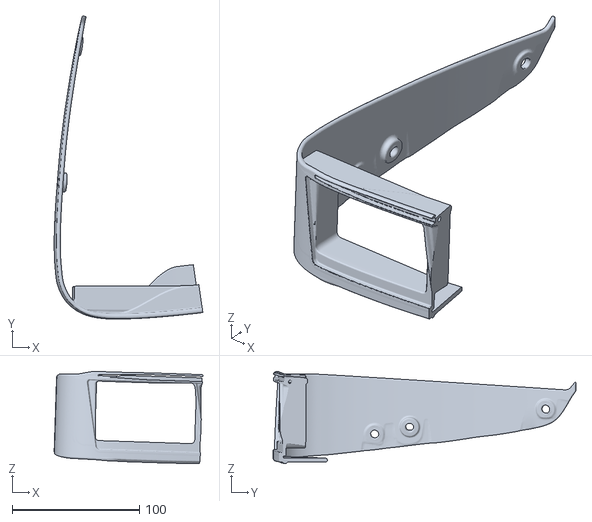
[picture p191: CAD file, 2026-10-02]
c5-shroud/stl/bezel_passenger_hood_piece.stl
116.8 x 237.9 x 72.3
