qman122/thesetupedit/c5-shroud/stl/cad/drl_inserts_passenger_P3J.stl

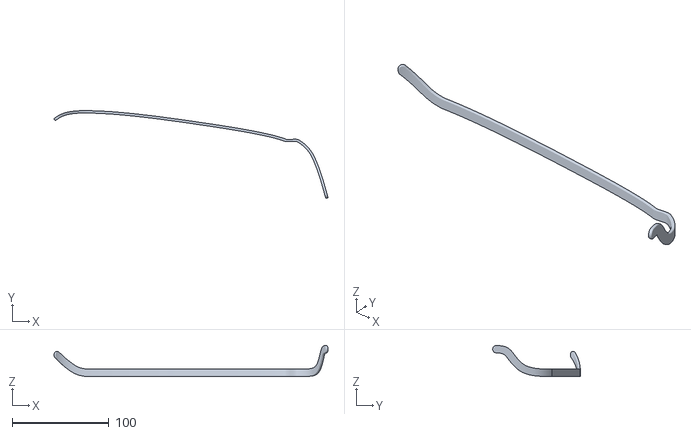
[picture p192: CAD file, 2026-10-02]
c5-shroud/stl/cad/drl_inserts_passenger_P3J.stl
283.3 x 90.6 x 32.2
