qman122/thesetupedit/c5-shroud/stl/projectors_P3D/bezel_passenger_hood_piece.stl

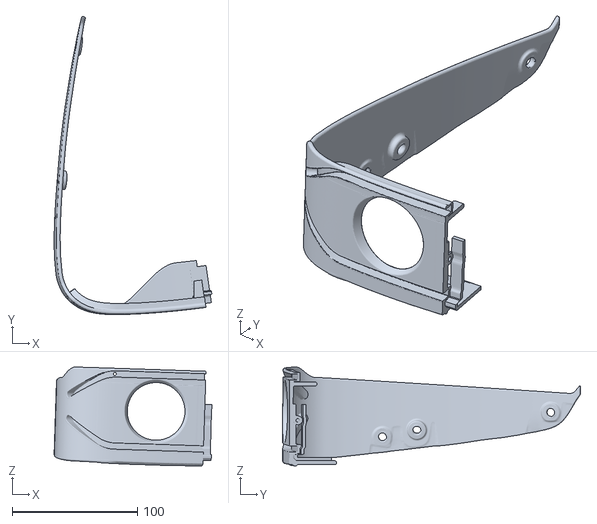
[picture p193: CAD file, 2026-10-03]
c5-shroud/stl/projectors_P3D/bezel_passenger_hood_piece.stl
126.0 x 237.9 x 79.0
