qman122/thesetupedit/c5-shroud/stl/projectors_P3J/bezel_joint_test_passenger.stl

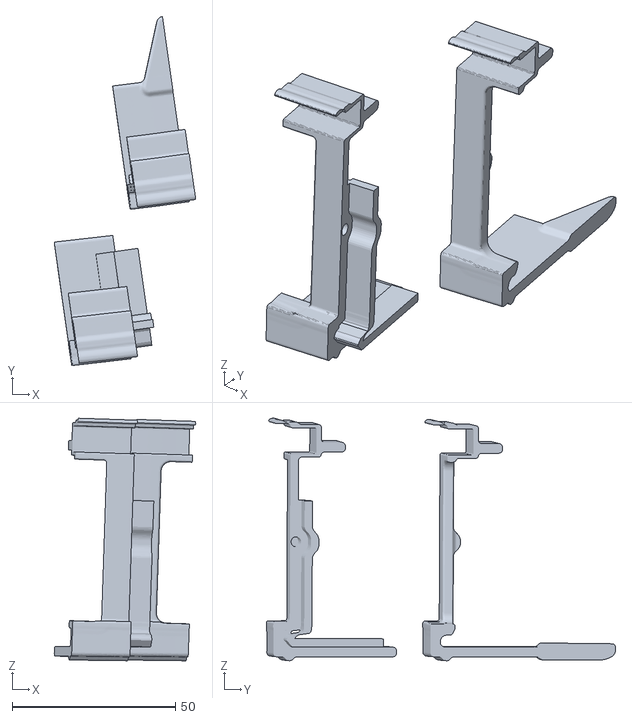
[picture p194: CAD file, 2026-10-03]
c5-shroud/stl/projectors_P3J/bezel_joint_test_passenger.stl
43.3 x 106.9 x 74.3
