qman122/thesetupedit/c5-shroud/stl/projectors_P3R/bezel_passenger_fender_piece.stl

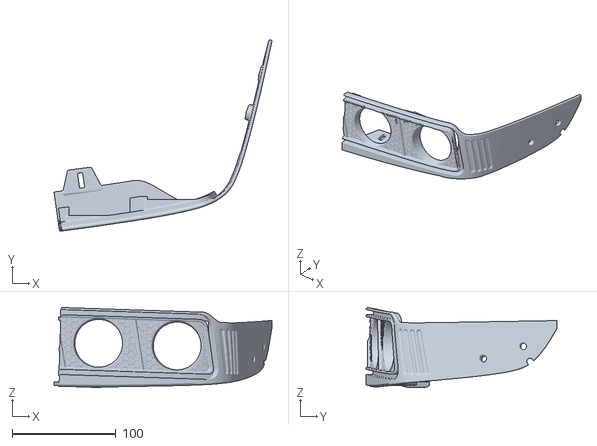
[picture p195: CAD file, 2026-10-03]
c5-shroud/stl/projectors_P3R/bezel_passenger_fender_piece.stl
210.2 x 184.5 x 77.2
