qman122/thesetupedit/c5-shroud/stl/projectors_P3V/bezel_passenger_hood_piece.stl

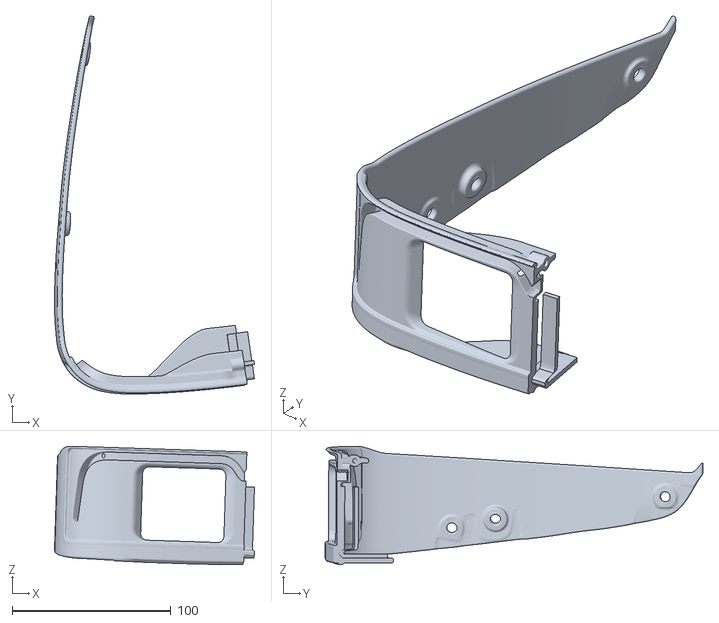
[picture p196: CAD file, 2026-10-03]
c5-shroud/stl/projectors_P3V/bezel_passenger_hood_piece.stl
125.9 x 238.0 x 74.6
