qman122/thesetupedit/c5-shroud/stl/cad/drl_inserts_passenger_P3V.stl

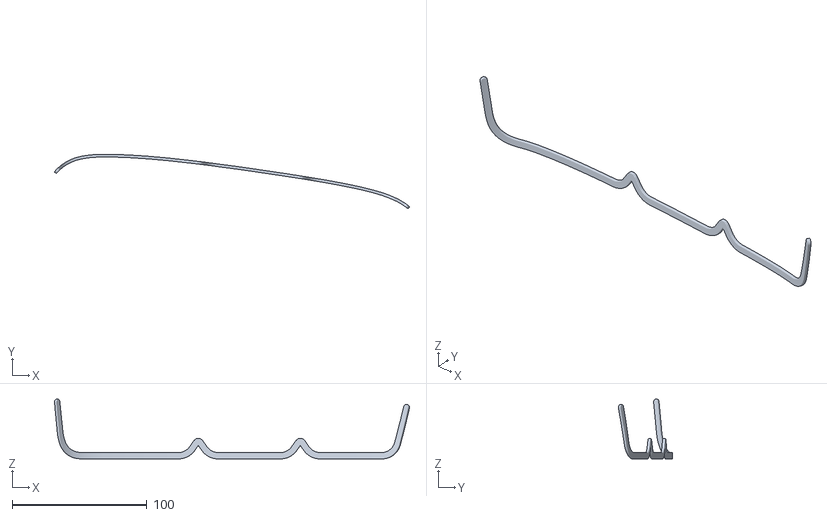
[picture p197: CAD file, 2026-10-02]
c5-shroud/stl/cad/drl_inserts_passenger_P3V.stl
263.1 x 40.2 x 44.4
