qman122/thesetupedit/c5-shroud/stl/drl_diffusers_passenger.stl

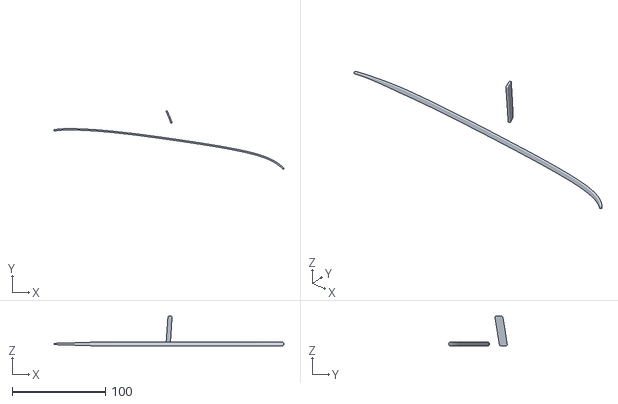
[picture p198: CAD file, 2026-10-02]
c5-shroud/stl/drl_diffusers_passenger.stl
246.9 x 63.0 x 31.8
