qman122/thesetupedit/c5-shroud/stl/projectors_P3C/bezel_joint_test_driver.stl

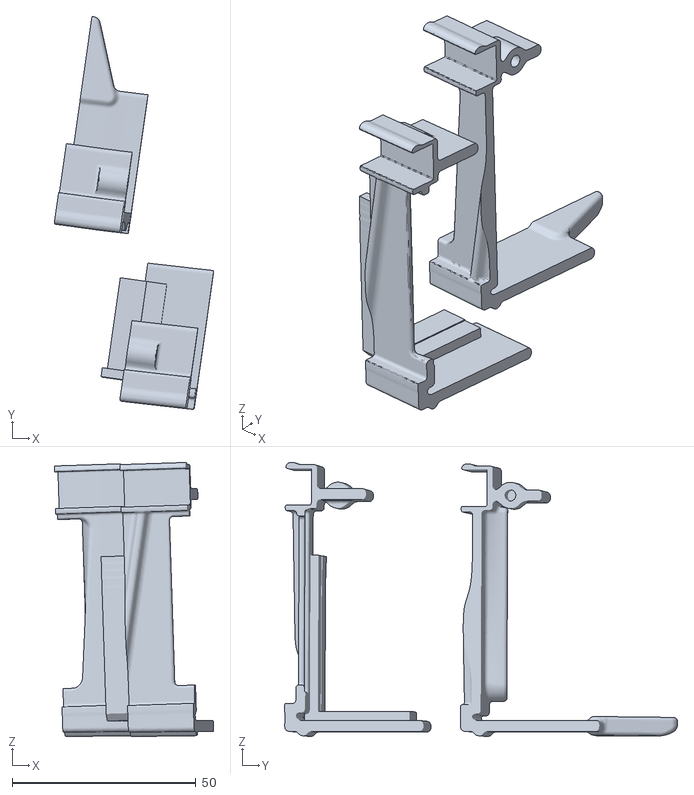
[picture p199: CAD file, 2026-10-03]
c5-shroud/stl/projectors_P3C/bezel_joint_test_driver.stl
43.4 x 106.9 x 74.6
