qman122/thesetupedit/c5-shroud/stl/cad/drl_inserts_passenger.stl

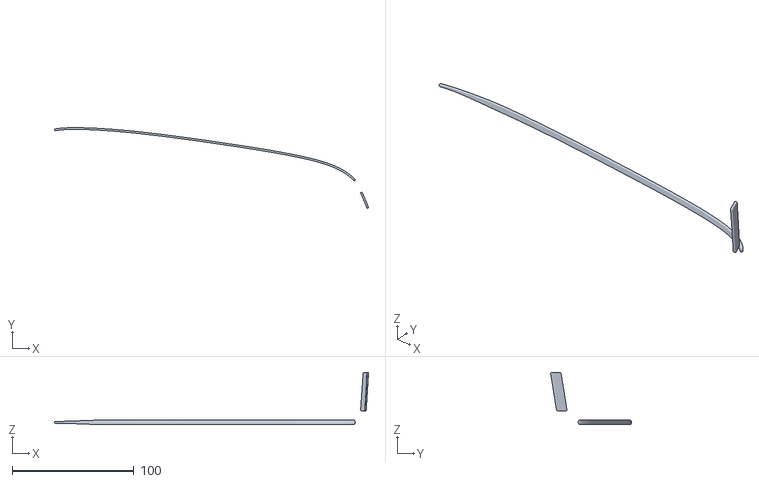
[picture p200: CAD file, 2026-10-02]
c5-shroud/stl/cad/drl_inserts_passenger.stl
257.7 x 66.2 x 43.0
