qman122/thesetupedit/c5-shroud/stl/fit_test_blade_passenger_fender_piece.stl

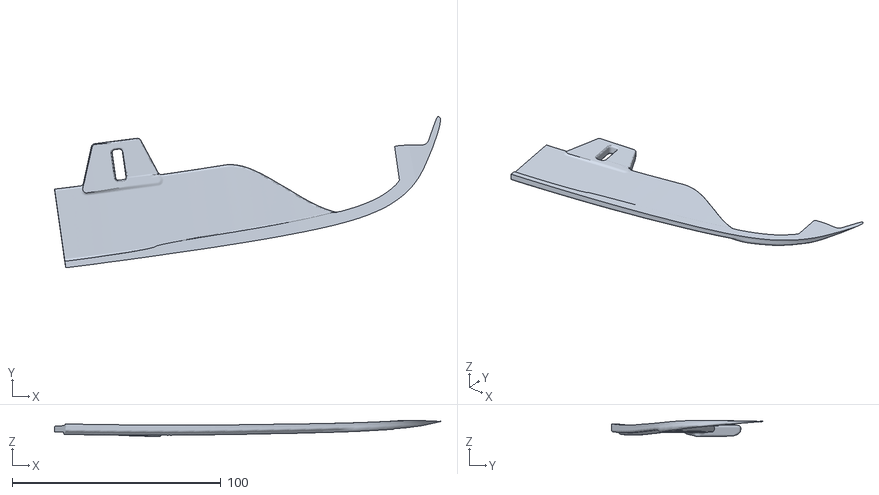
[picture p201: CAD file, 2026-10-02]
c5-shroud/stl/fit_test_blade_passenger_fender_piece.stl
185.1 x 72.6 x 7.77
