qman122/thesetupedit/c5-shroud/stl/projectors_P3R/bezel_joint_test_driver.stl

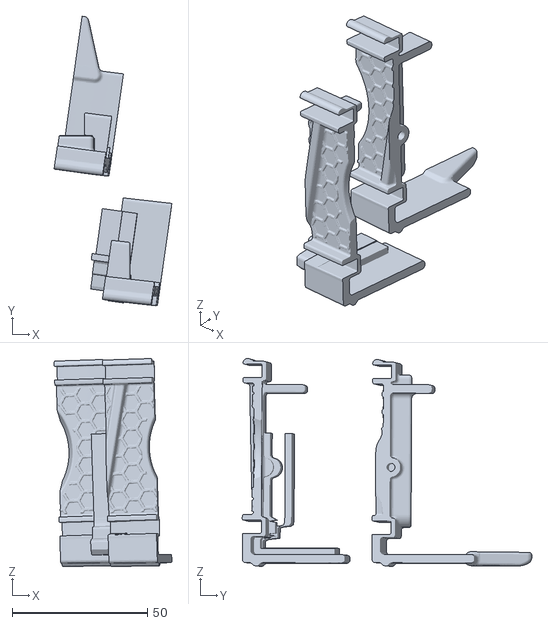
[picture p202: CAD file, 2026-10-03]
c5-shroud/stl/projectors_P3R/bezel_joint_test_driver.stl
43.5 x 106.9 x 76.8
