qman122/thesetupedit/c5-shroud/stl/projectors_P3C/carrier_passenger.stl

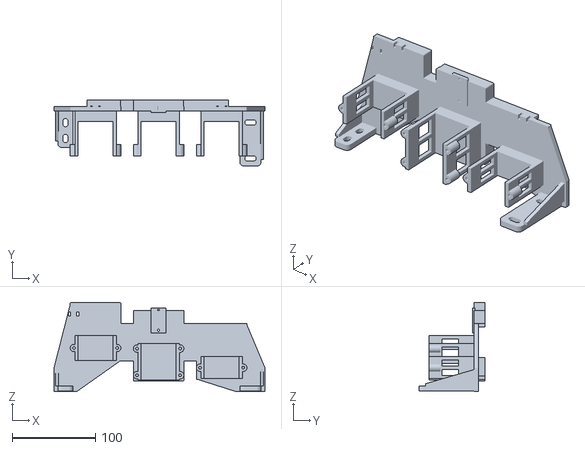
[picture p203: CAD file, 2026-10-02]
c5-shroud/stl/projectors_P3C/carrier_passenger.stl
253.5 x 79.3 x 107.4
