qman122/thesetupedit/c5-shroud/stl/projectors_P3D/drl_diffusers_driver.stl

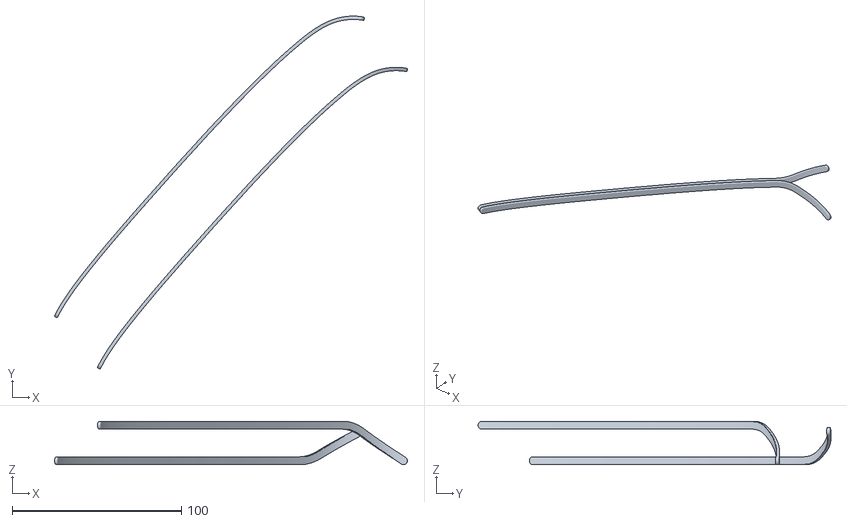
[picture p204: CAD file, 2026-10-03]
c5-shroud/stl/projectors_P3D/drl_diffusers_driver.stl
208.8 x 208.7 x 25.7
