qman122/thesetupedit/c5-shroud/stl/projectors_P3V/bezel_driver_fender_piece.stl

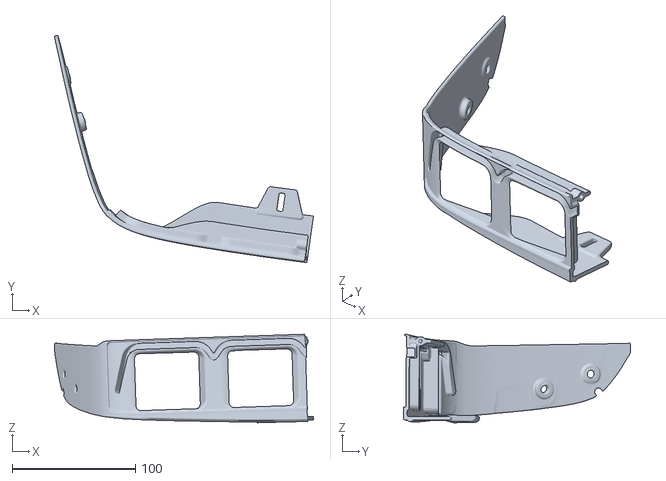
[picture p205: CAD file, 2026-10-02]
c5-shroud/stl/projectors_P3V/bezel_driver_fender_piece.stl
210.5 x 184.5 x 72.0
