qman122/thesetupedit/c5-shroud/stl/fit_test_blade_passenger_hood_piece.stl

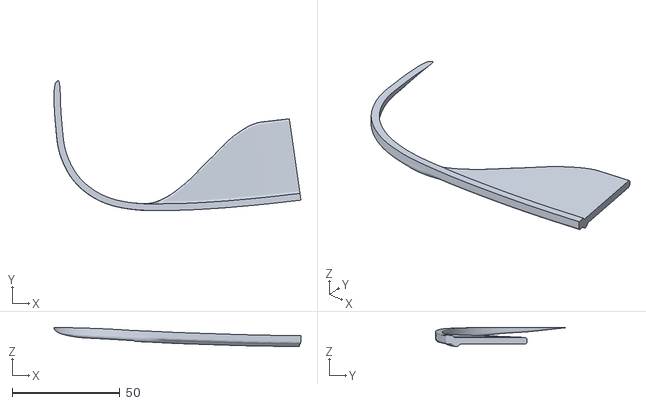
[picture p206: CAD file, 2026-10-02]
c5-shroud/stl/fit_test_blade_passenger_hood_piece.stl
114.6 x 60.4 x 8.90
