qman122/thesetupedit/c5-shroud/stl/projectors_P3J/projector_straps_driver.stl

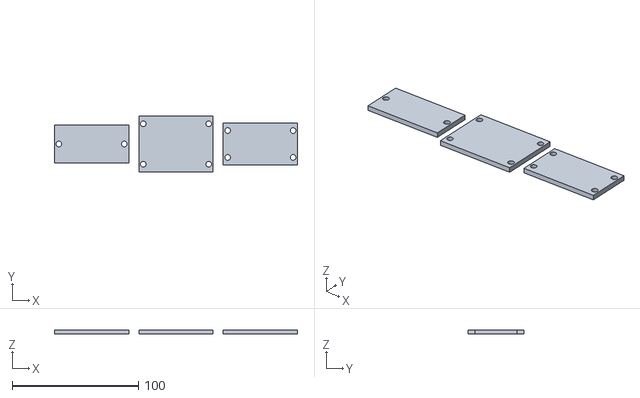
[picture p207: CAD file, 2026-10-02]
c5-shroud/stl/projectors_P3J/projector_straps_driver.stl
192.4 x 44.0 x 3.50
