qman122/thesetupedit/c5-shroud/stl/projectors_P3V/drl_diffusers_passenger.stl

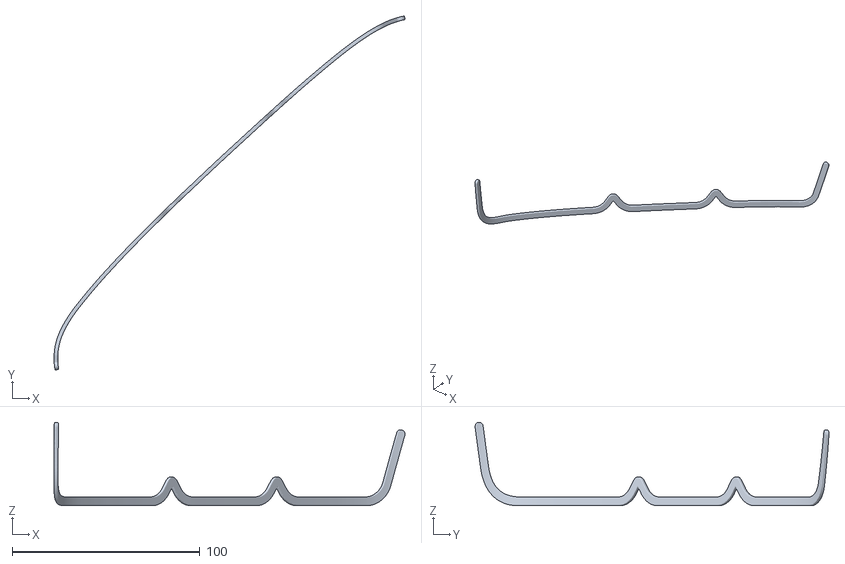
[picture p208: CAD file, 2026-10-02]
c5-shroud/stl/projectors_P3V/drl_diffusers_passenger.stl
186.8 x 188.3 x 44.4
