qman122/thesetupedit/c5-shroud/stl/bezel_passenger_fender_piece.stl

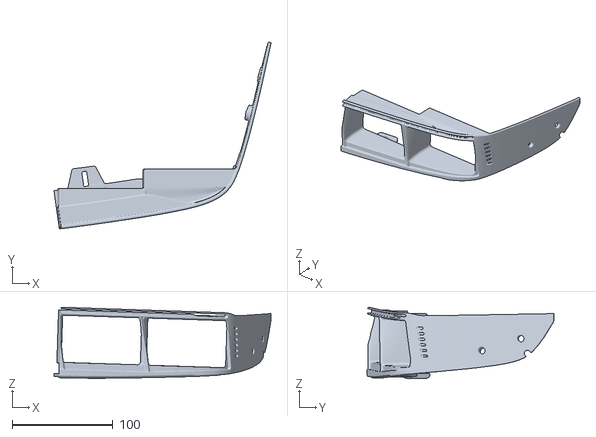
[picture p209: CAD file, 2026-10-02]
c5-shroud/stl/bezel_passenger_fender_piece.stl
215.0 x 185.1 x 70.9
