qman122/thesetupedit/c5-shroud/stl/projectors_P3D/bezel_passenger_fender_piece.stl

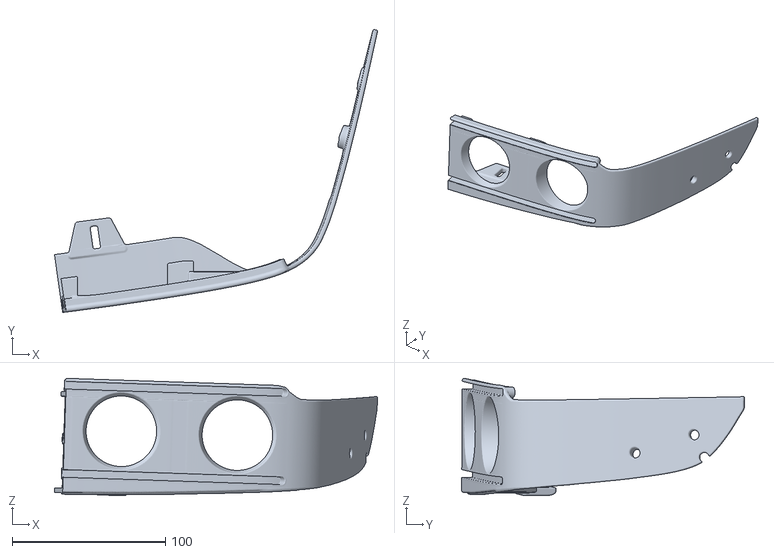
[picture p210: CAD file, 2026-10-02]
c5-shroud/stl/projectors_P3D/bezel_passenger_fender_piece.stl
210.8 x 184.5 x 76.6
