qman122/thesetupedit/c5-shroud/stl/projectors_P3R/projector_straps_passenger.stl

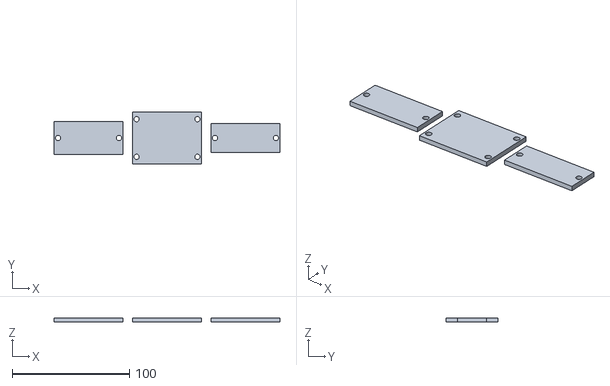
[picture p211: CAD file, 2026-10-03]
c5-shroud/stl/projectors_P3R/projector_straps_passenger.stl
192.4 x 44.0 x 3.50
