qman122/thesetupedit/c5-shroud/stl/carrier_passenger.stl

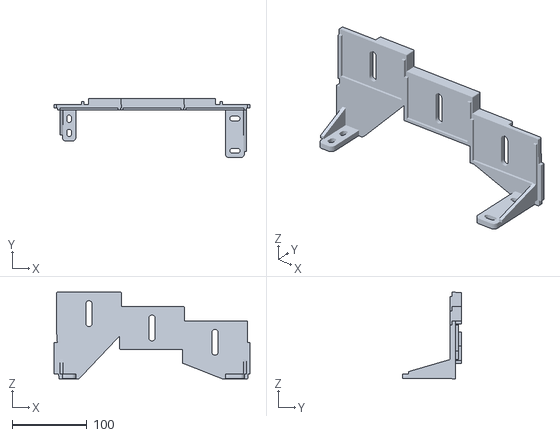
[picture p212: CAD file, 2026-10-02]
c5-shroud/stl/carrier_passenger.stl
262.8 x 79.3 x 116.2
