qman122/thesetupedit/c5-shroud/stl/projectors_P3R/carrier_driver.stl

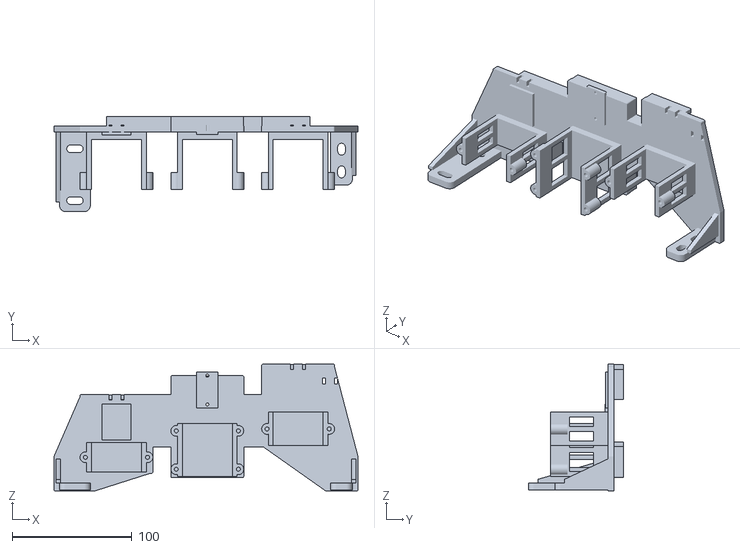
[picture p213: CAD file, 2026-10-03]
c5-shroud/stl/projectors_P3R/carrier_driver.stl
253.5 x 79.3 x 105.6
