qman122/thesetupedit/c5-shroud/stl/projectors_P3D/carrier_driver.stl

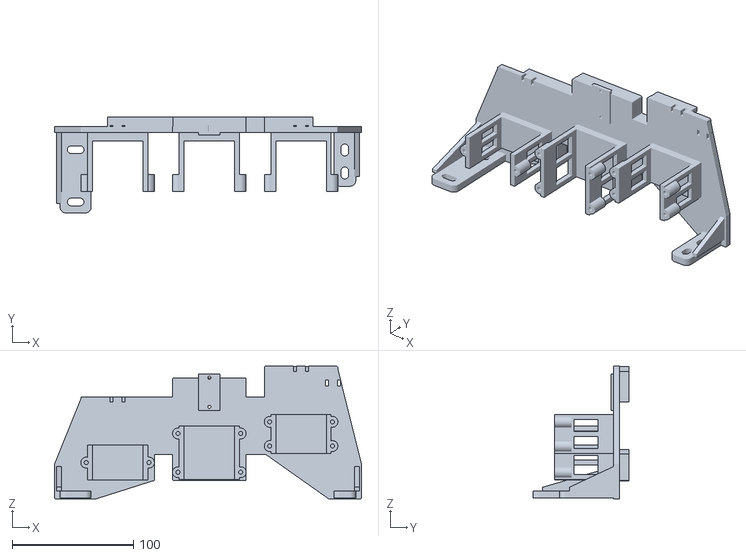
[picture p214: CAD file, 2026-10-02]
c5-shroud/stl/projectors_P3D/carrier_driver.stl
253.5 x 79.3 x 109.6
