qman122/thesetupedit/c5-shroud/stl/projectors_P3J/drl_diffusers_driver.stl

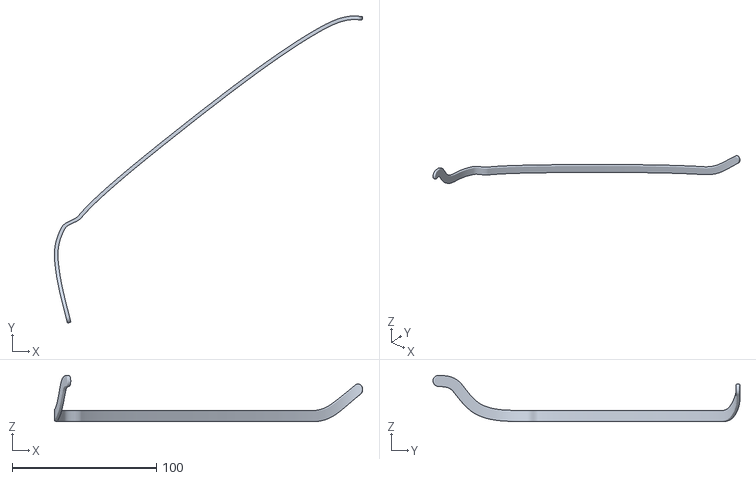
[picture p215: CAD file, 2026-10-02]
c5-shroud/stl/projectors_P3J/drl_diffusers_driver.stl
213.8 x 212.9 x 32.2
