qman122/thesetupedit/c5-shroud/stl/projectors_P3J/bezel_driver_fender_piece.stl

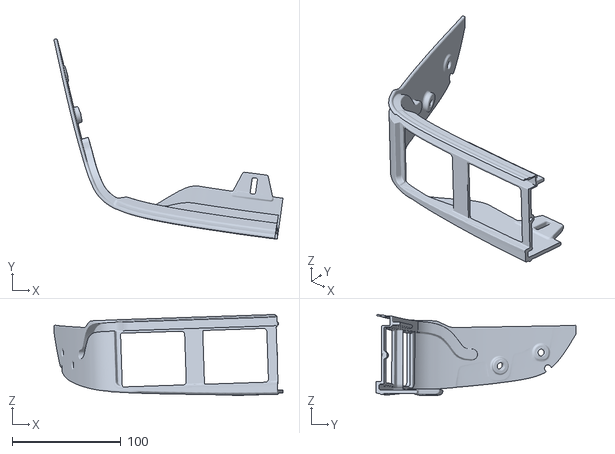
[picture p216: CAD file, 2026-10-02]
c5-shroud/stl/projectors_P3J/bezel_driver_fender_piece.stl
210.9 x 184.6 x 74.7
