qman122/thesetupedit/c5-shroud/stl/projectors_P3V/projector_straps_passenger.stl

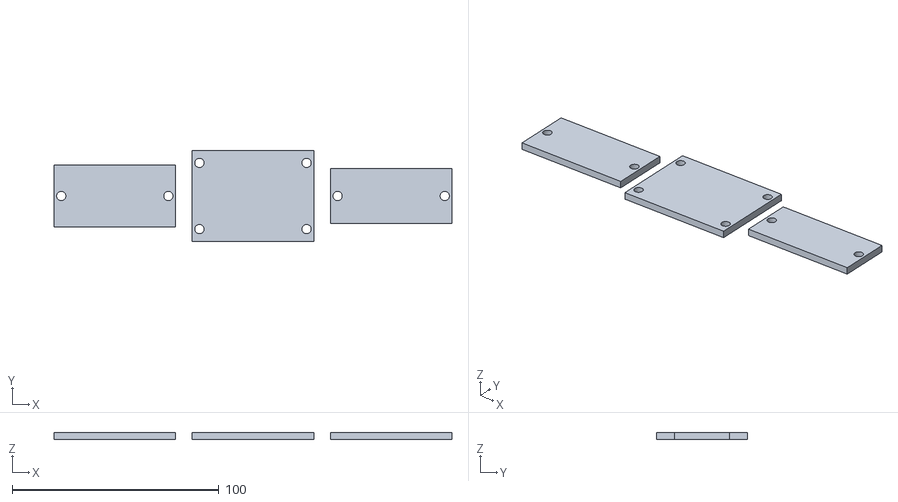
[picture p217: CAD file, 2026-10-02]
c5-shroud/stl/projectors_P3V/projector_straps_passenger.stl
192.4 x 44.0 x 3.50
