qman122/thesetupedit/c5-shroud/stl/fit_test_mount_passenger.stl

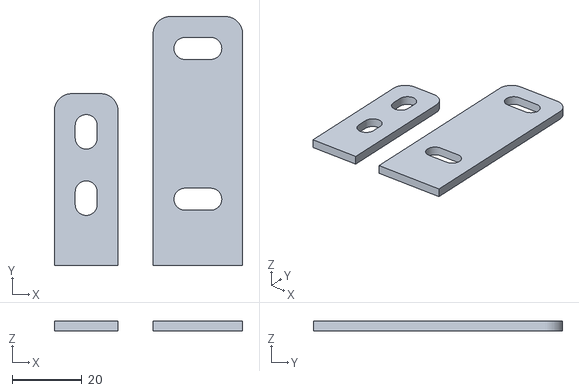
[picture p218: CAD file, 2026-09-29]
c5-shroud/stl/fit_test_mount_passenger.stl
54.0 x 71.3 x 3.00
