qman122/thesetupedit/c5-shroud/stl/bezel_driver_one_piece.stl

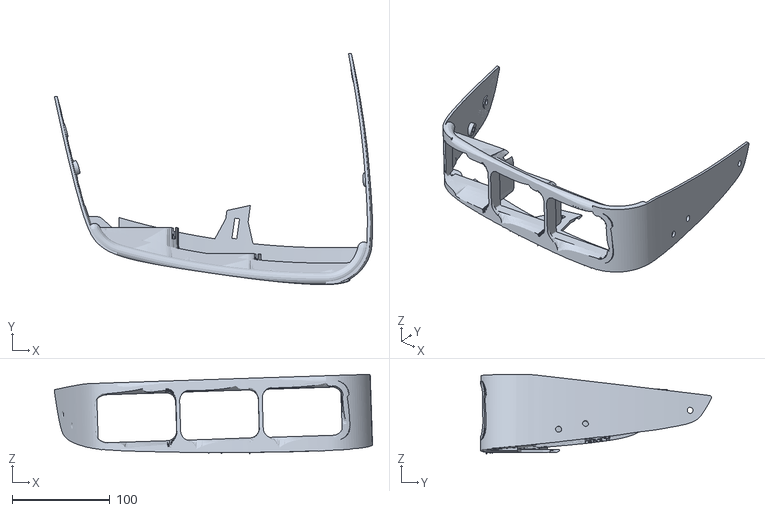
[picture p219: CAD file, 2026-09-29]
c5-shroud/stl/bezel_driver_one_piece.stl
325.0 x 236.2 x 80.9
