qman122/thesetupedit/c5-shroud/stl/fit_test_window.stl

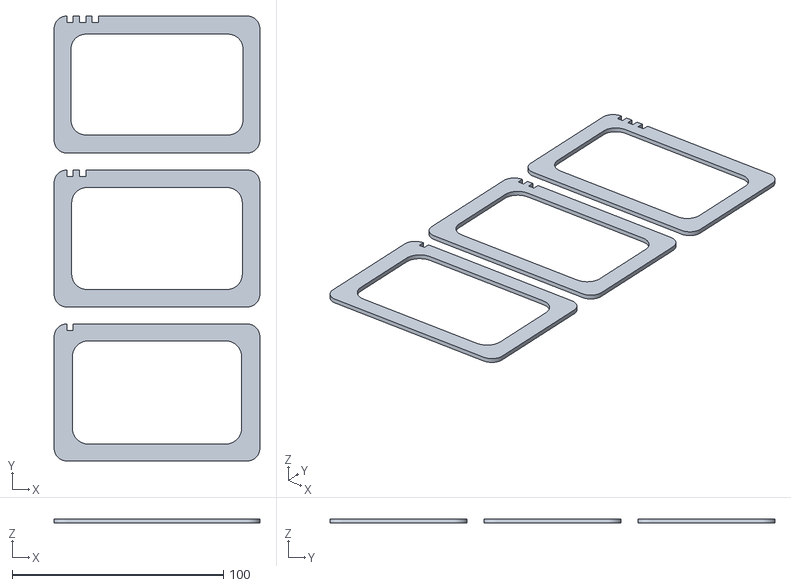
[picture p220: CAD file, 2026-09-28]
c5-shroud/stl/fit_test_window.stl
97.4 x 210.7 x 2.00
