qman122/thesetupedit/(list of files, cad)

Other CAD files:
c5-shroud/stl/assembled/assembly_driver.stl
c5-shroud/stl/projectors_P3J/bezel_passenger_hood_piece.stl
c5-shroud/stl/projectors_P3C/bezel_driver_hood_piece.stl
c5-shroud/stl/projectors_P3D/bezel_joint_test_passenger.stl
c5-shroud/stl/projectors_P3J/bezel_driver_hood_piece.stl
c5-shroud/stl/projectors_P3R/bezel_passenger_hood_piece.stl
c5-shroud/stl/projectors_P3V/bezel_driver_hood_piece.stl
c5-shroud/stl/projectors_P3C/bezel_joint_test_passenger.stl
c5-shroud/stl/projectors_P3D/bezel_driver_hood_piece.stl
c5-shroud/stl/projectors_P3J/bezel_joint_test_driver.stl
c5-shroud/stl/projectors_P3V/bezel_joint_test_driver.stl
c5-shroud/stl/fit_test_blade_driver_one_piece.stl
c5-shroud/stl/projectors_P3J/carrier_driver.stl
c5-shroud/stl/projectors_P3R/bezel_driver_fender_piece.stl
c5-shroud/stl/projectors_P3C/carrier_driver.stl
c5-shroud/stl/projectors_P3D/drl_diffusers_passenger.stl
c5-shroud/stl/projectors_P3R/bezel_joint_test_passenger.stl
c5-shroud/stl/projectors_P3J/projector_straps_passenger.stl
c5-shroud/stl/projectors_P3V/bezel_passenger_fender_piece.stl
c5-shroud/stl/projectors_P3D/bezel_driver_fender_piece.stl
c5-shroud/stl/projectors_P3J/carrier_passenger.stl
c5-shroud/stl/projectors_P3V/drl_diffusers_driver.stl
c5-shroud/stl/fit_test_blade_driver_hood_piece.stl
c5-shroud/stl/projectors_P3R/projector_straps_driver.stl
c5-shroud/stl/fit_test_blade_driver_fender_piece.stl
c5-shroud/stl/projectors_P3D/carrier_passenger.stl
c5-shroud/stl/projectors_P3R/carrier_passenger.stl
c5-shroud/stl/projectors_P3V/carrier_driver.stl
c5-shroud/stl/carrier_driver.stl
c5-shroud/stl/projectors_P3J/drl_diffusers_passenger.stl
c5-shroud/stl/drl_diffusers_driver.stl
c5-shroud/stl/projectors_P3J/bezel_passenger_fender_piece.stl
c5-shroud/stl/projectors_P3V/projector_straps_driver.stl
c5-shroud/stl/bezel_driver_hood_piece.stl
c5-shroud/stl/bezel_driver_fender_piece.stl
c5-shroud/stl/fit_test_mount_driver.stl
c5-shroud/stl/bezel_passenger_one_piece.stl
c5-shroud/stl/spacer_washers.stl
