qman122/thesetupedit/docs/setups/cable-management.html

Skip to content Free printable: the 12-step desk cable checklist. Get the free checklist: 12 steps, 2 pages ↗ (https://payhip.com/b/XAPfb)

The Setup Edit

# The Cable Management Kit

Hide the mess in an afternoon. The cheapest upgrade with the biggest before-and-after.

Shop the list of 2 picks

Disclosure. The Setup Edit is reader-supported. As an Amazon Associate I earn from qualifying purchases. Links to Amazon are affiliate links: if you buy through them, I may earn a small commission at no extra cost to you.

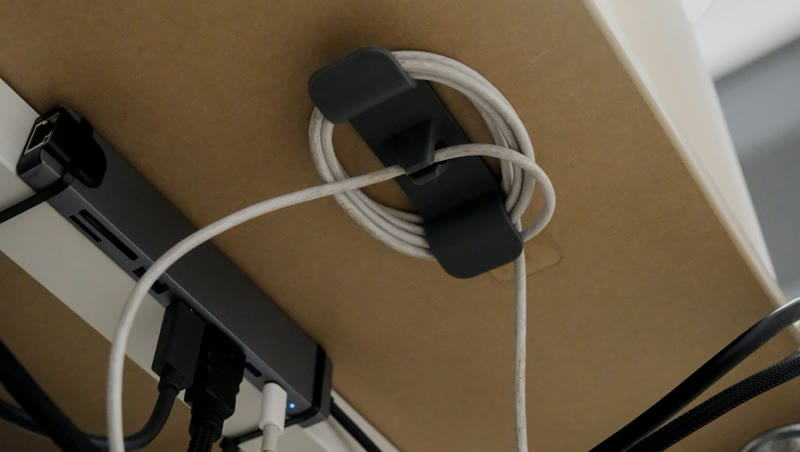
[picture p221: docs/img/web/cable-800.jpg]
Cables coiled and clipped to the underside of a desk


Products shown in photos may differ from the linked items.Photo: Bedirhan Gül (https://unsplash.com/photos/I_3D0pVrMhY) on Unsplash

## How this desk works

Two parts do most of the work. A tray under the desk holds the power strip and the chargers, so only one cable runs down to the wall. Clips along the desk edge keep the cables you touch every day from sliding off the back.

The rest is method: route every cable along one path, bundle them with reusable ties and label the ends. The cable management guide walks through it, and the free checklist below puts it on paper.

Good for: Any desk with a power strip on the floor.

## The list

Research-based picks, not hands-on tested. Links go to Amazon, and as an Amazon Associate I earn from qualifying purchases.

1. Start hereCables

### Under-Desk Cable Tray

  Scanfield no-screw tray (2-pack)
  Power strips and chargers go under the desk, off the floor.
  Getting the power strip off the floor is the single biggest step, and everything else routes to it.
  View on Amazon: Under-Desk Cable Tray ↗ (https://www.amazon.com/dp/B09J5HH2LR?tag=thesetupedi0e-20)
2. Cables

### Adhesive Cable Clips

  OHill cable clips (16-pack)
  Chargers stop falling behind the desk.
  View on Amazon: Adhesive Cable Clips ↗ (https://www.amazon.com/dp/B071FXZBMV?tag=thesetupedi0e-20)

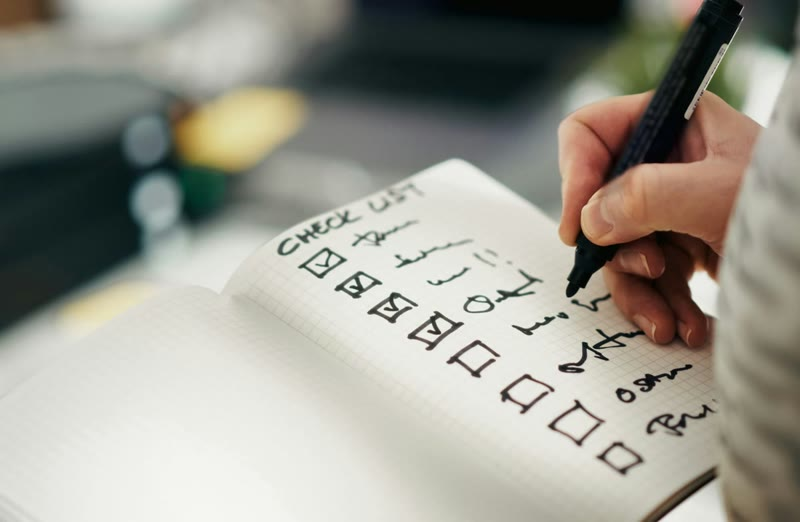
[picture p222: docs/img/web/checklist-800.jpg]
A hand ticking boxes on a handwritten checklist in a notebook


Free printable

The desk cable checklist

Twelve steps from a tangle to a tidy desk, plus the short list of what you will need. Two pages, ready to print.

Get the free checklist↗ (https://payhip.com/b/XAPfb)

## Read the guides

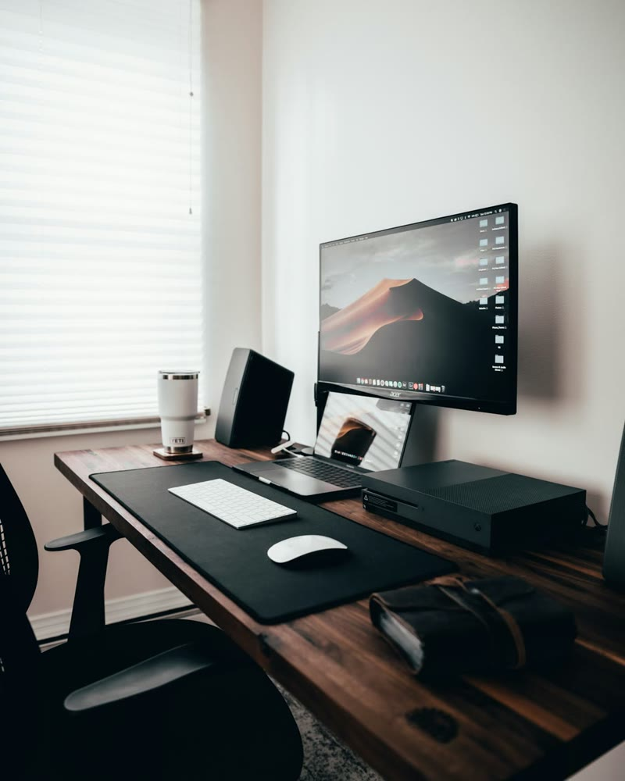
[picture p223: docs/img/web/clean-desk-800.jpg]
A clean desk with a monitor, speakers and a large desk mat
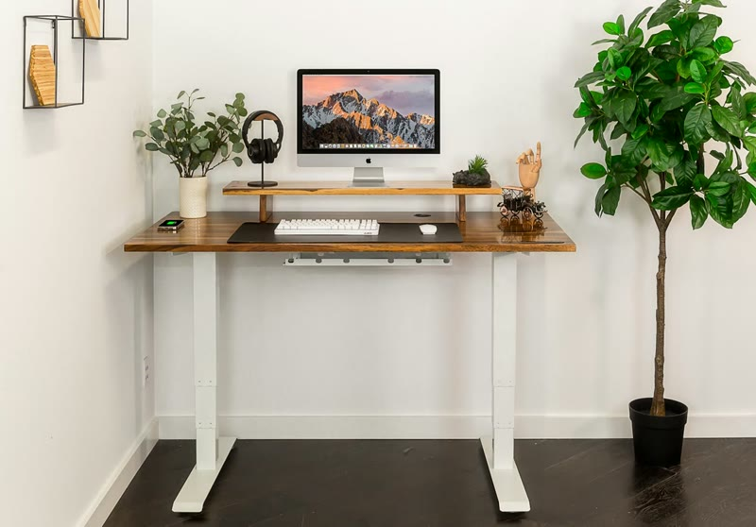
[picture p224: docs/img/web/standing-800.jpg]
A white standing desk with a monitor, a desk shelf and plants
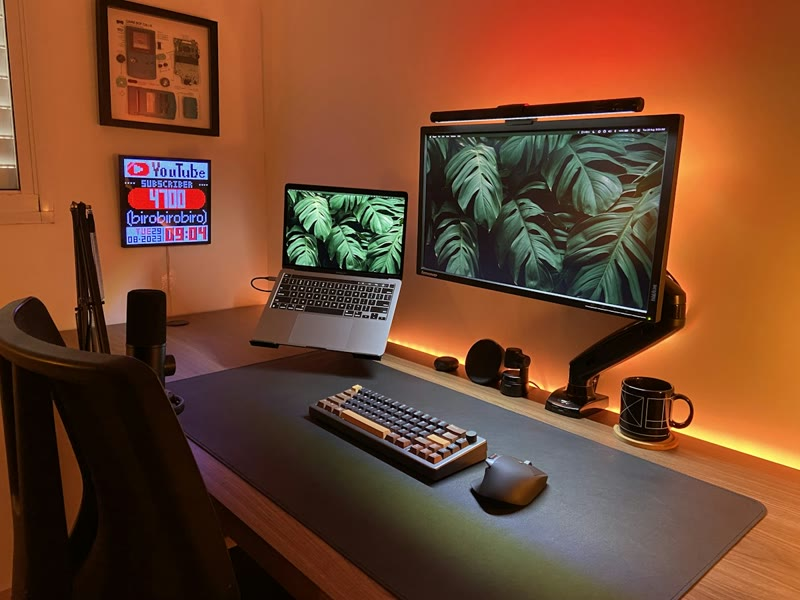
[picture p225: docs/img/web/trading-800.jpg]
A trading desk with a monitor on an arm, a laptop on a stand and warm backlighting
 Gift guide, 2 min readDesk Stocking Stuffers: Small Gifts for a Better Desk  Standing desk guide, 4 min readStanding Desk Setup Guide: Heights, Screens and Cables  Trading desk guide, 5 min readHow to Build a Trading Desk Setup (Step by Step) Cables coiled and clipped to the underside of a desk Cable management guide, 4 min readCable Management 101: How to Hide Desk Cables for Good

## More setups

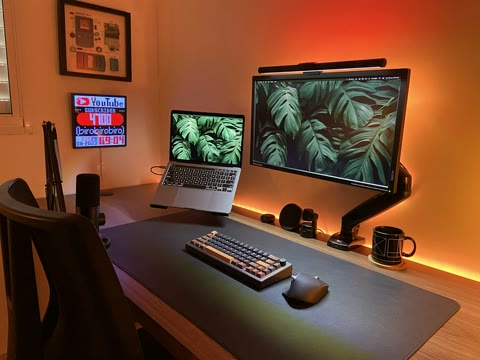
[picture p226: docs/img/web/trading-480.jpg]
A trading desk with a monitor on an arm, a laptop on a stand and warm backlighting
-  The Trading Desk Setup9 picks
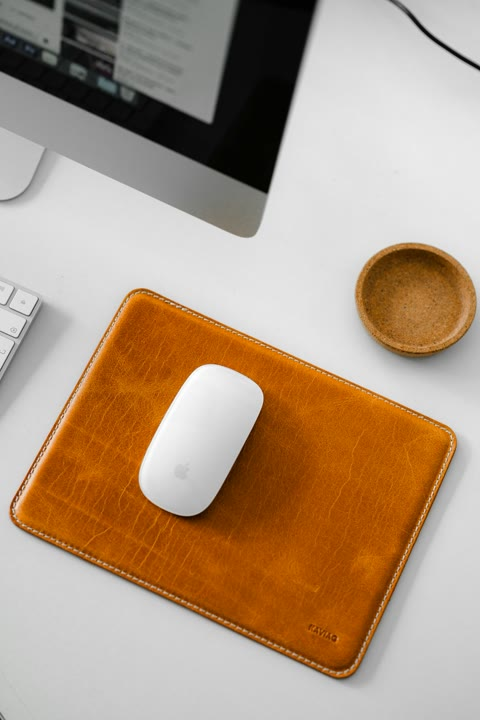
[picture p227: docs/img/web/minimal-480.jpg]
A minimal desk with a leather desk pad, a white mouse and a wooden tray
-  The Clean Minimal Desk7 picks
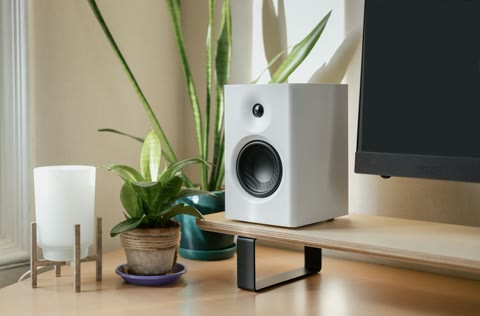
[picture p228: docs/img/web/small-480.jpg]
A compact home office desk with a raised monitor in a small room
-  The Small Space Office6 picks

The Setup Edit

Curated desk setups, home office ideas and trading desks, researched and written by one independent editor.

Setups

- The Trading Desk Setup
- The Clean Minimal Desk
- The Small Space Office
- The Cable Management Kit

Guides

- Gift Ideas for Traders
- Work From Home Gift Ideas That Upgrade Their Desk
- Desk Stocking Stuffers
- Standing Desk Setup Guide
- How to Light a Desk for Video Calls
- The Best Desk Setup for Small Bedrooms
- How to Build a Trading Desk Setup
- Cable Management 101
- Small Home Office Ideas That Actually Work
- Minimalist Desk Setup

Shop

- Desk Cable Checklist (https://payhip.com/b/XAPfb)
- The Clean Desk Guide (https://payhip.com/b/3MK0F)
- Minimalist Wallpaper Pack (https://payhip.com/b/XqrMo)

The Edit

- About & disclosure
- Sitemap

The Setup Edit is reader-supported. As an Amazon Associate I earn from qualifying purchases. Links to Amazon are affiliate links: if you buy through them, I may earn a small commission at no extra cost to you. Picks come from research, not hands-on testing.

Photos from Unsplash (https://unsplash.com): Roberto Nickson (https://unsplash.com/photos/Gvm2wM3V5PA), João Inácio (https://unsplash.com/photos/Wk_6p1TuhRE), Muhammet Sain (https://unsplash.com/photos/_g0SLFllfBY), Behnam Norouzi (https://unsplash.com/photos/j3b15qP-ckc), Bedirhan Gül (https://unsplash.com/photos/I_3D0pVrMhY), Aleksandra Dementeva (https://unsplash.com/photos/GzR2KS4ABYA), Adeniji Abdullahi A (https://unsplash.com/photos/F5FrFqwIKAI), EFFYDESK (https://unsplash.com/photos/aDZ-UZSvhE4), Jakub Żerdzicki (https://unsplash.com/photos/weJ7qyjHYwk), Max Andrey (https://unsplash.com/photos/-8-2YWKt8Ag). Products shown in photos may differ from the linked items.

© 2026 The Setup EditBack to top

12-step desk cable checklistFree, two pages, ready to print

Get the free checklist↗ (https://payhip.com/b/XAPfb)×
