qman122/thesetupedit/docs/setups/minimal-desk-setup.html

Skip to content Free printable: the 12-step desk cable checklist. Get the free checklist: 12 steps, 2 pages ↗ (https://payhip.com/b/XAPfb)

The Setup Edit

# The Clean Minimal Desk

Fewer things, better things. Warm materials and a desk that looks calm every time you sit down.

Shop the list of 7 picks

Disclosure. The Setup Edit is reader-supported. As an Amazon Associate I earn from qualifying purchases. Links to Amazon are affiliate links: if you buy through them, I may earn a small commission at no extra cost to you.

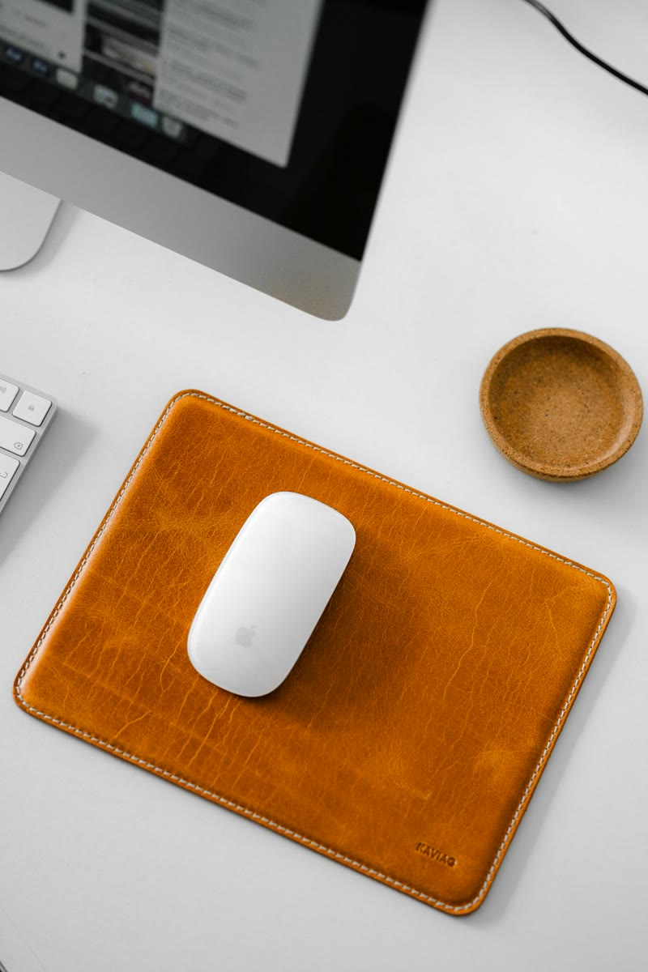
[picture p229: docs/img/web/minimal-800.jpg]
A minimal desk with a leather desk pad, a white mouse and a wooden tray


Products shown in photos may differ from the linked items.Photo: Muhammet Sain (https://unsplash.com/photos/_g0SLFllfBY) on Unsplash

## How this desk works

A calm desk is mostly about what you leave off. This one sticks to a few warm materials (leather, walnut and bamboo) and gives every loose item a place to live: a tray for the small things, a stand for the headphones.

The compact wireless keyboard and the clamp lamp keep the surface open, so the desk still looks tidy in the middle of a working day.

Good for: Anyone who wants a desk that looks calm every time they sit down.

## The list

Research-based picks, not hands-on tested. Links go to Amazon, and as an Amazon Associate I earn from qualifying purchases.

1. Start hereSurface

### Leather Desk Pad

  Aothia leather desk pad
  The fastest way to make a desk look put together.
  It defines the working area, and the rest of the desk is arranged on top of it.
  View on Amazon: Leather Desk Pad ↗ (https://www.amazon.com/dp/B082F5ZLS5?tag=thesetupedi0e-20)
2. Input

### 75% Mechanical Keyboard

  AULA F75 wireless
  Compact, wireless, hot-swappable, and a creamy sound.
  View on Amazon: 75% Mechanical Keyboard ↗ (https://www.amazon.com/dp/B0CNT61VMZ?tag=thesetupedi0e-20)
3. Comfort

### Wooden Wrist Rest

  Faluber walnut wrist rest
  Wrist support that matches a warm wood desk.
  View on Amazon: Wooden Wrist Rest ↗ (https://www.amazon.com/dp/B09DPGVPG1?tag=thesetupedi0e-20)
4. Storage

### Headphone Stand

  New Bee headphone stand
  Gets your headphones off the desk and within reach.
  View on Amazon: Headphone Stand ↗ (https://www.amazon.com/dp/B01GJQ7N94?tag=thesetupedi0e-20)
5. Storage

### Bamboo Organizer Tray

  Lipper bamboo tray
  A home for keys, pens and small gadgets.
  View on Amazon: Bamboo Organizer Tray ↗ (https://www.amazon.com/dp/B00KAZ12OS?tag=thesetupedi0e-20)
6. Greenery

### Mini Desk Plants

  Der Rose artificial plants (3-pack)
  Warmth without watering.
  View on Amazon: Mini Desk Plants ↗ (https://www.amazon.com/dp/B07VKJKFN2?tag=thesetupedi0e-20)
7. Light

### Swing Arm Desk Lamp

  LEPOWER clamp lamp
  Clamps on, saves space, and aims light where you need it.
  View on Amazon: Swing Arm Desk Lamp ↗ (https://www.amazon.com/dp/B07R56PTMS?tag=thesetupedi0e-20)

A hand ticking boxes on a handwritten checklist in a notebook

Free printable

The desk cable checklist

Twelve steps from a tangle to a tidy desk, plus the short list of what you will need. Two pages, ready to print.

Get the free checklist↗ (https://payhip.com/b/XAPfb)

## Read the guides

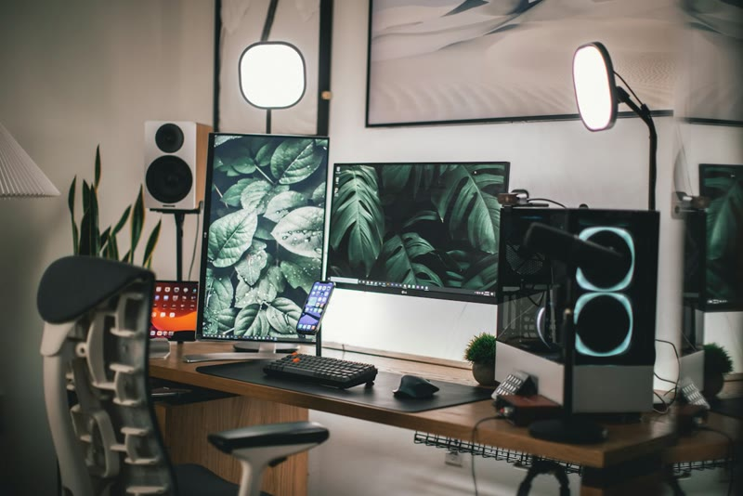
[picture p230: docs/img/web/hero-800.jpg]
A dual-monitor desk with plants, warm lamps and a wooden desktop
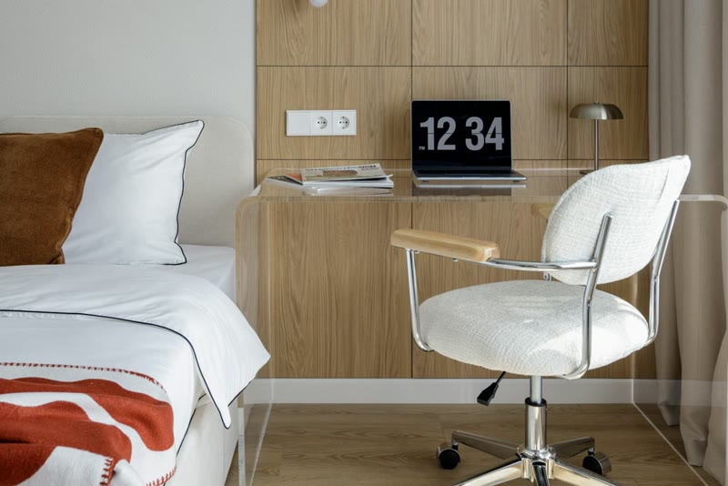
[picture p231: docs/img/web/bedroom-800.jpg]
A small bedroom desk beside a bed, with a laptop and a white chair
A trading desk with a monitor on an arm, a laptop on a stand and warm backlighting Gift guide, 3 min readGift Ideas for Traders: Desk Upgrades and Books They Will Use  Gift guide, 3 min readWork From Home Gift Ideas That Upgrade Their Desk A clean desk with a monitor, speakers and a large desk mat Gift guide, 2 min readDesk Stocking Stuffers: Small Gifts for a Better Desk  Bedroom office guide, 4 min readThe Best Desk Setup for Small Bedrooms

## More setups

- A trading desk with a monitor on an arm, a laptop on a stand and warm backlighting The Trading Desk Setup9 picks
- A compact home office desk with a raised monitor in a small room The Small Space Office6 picks
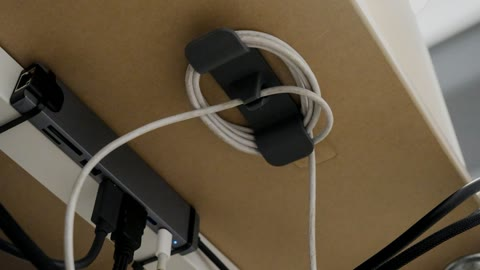
[picture p232: docs/img/web/cable-480.jpg]
Cables coiled and clipped to the underside of a desk
-  The Cable Management Kit2 picks

The Setup Edit

Curated desk setups, home office ideas and trading desks, researched and written by one independent editor.

Setups

- The Trading Desk Setup
- The Clean Minimal Desk
- The Small Space Office
- The Cable Management Kit

Guides

- Gift Ideas for Traders
- Work From Home Gift Ideas That Upgrade Their Desk
- Desk Stocking Stuffers
- Standing Desk Setup Guide
- How to Light a Desk for Video Calls
- The Best Desk Setup for Small Bedrooms
- How to Build a Trading Desk Setup
- Cable Management 101
- Small Home Office Ideas That Actually Work
- Minimalist Desk Setup

Shop

- Desk Cable Checklist (https://payhip.com/b/XAPfb)
- The Clean Desk Guide (https://payhip.com/b/3MK0F)
- Minimalist Wallpaper Pack (https://payhip.com/b/XqrMo)

The Edit

- About & disclosure
- Sitemap

The Setup Edit is reader-supported. As an Amazon Associate I earn from qualifying purchases. Links to Amazon are affiliate links: if you buy through them, I may earn a small commission at no extra cost to you. Picks come from research, not hands-on testing.

Photos from Unsplash (https://unsplash.com): Roberto Nickson (https://unsplash.com/photos/Gvm2wM3V5PA), João Inácio (https://unsplash.com/photos/Wk_6p1TuhRE), Muhammet Sain (https://unsplash.com/photos/_g0SLFllfBY), Behnam Norouzi (https://unsplash.com/photos/j3b15qP-ckc), Bedirhan Gül (https://unsplash.com/photos/I_3D0pVrMhY), Aleksandra Dementeva (https://unsplash.com/photos/GzR2KS4ABYA), Adeniji Abdullahi A (https://unsplash.com/photos/F5FrFqwIKAI), EFFYDESK (https://unsplash.com/photos/aDZ-UZSvhE4), Jakub Żerdzicki (https://unsplash.com/photos/weJ7qyjHYwk), Max Andrey (https://unsplash.com/photos/-8-2YWKt8Ag). Products shown in photos may differ from the linked items.

© 2026 The Setup EditBack to top

12-step desk cable checklistFree, two pages, ready to print

Get the free checklist↗ (https://payhip.com/b/XAPfb)×
