qman122/thesetupedit/docs/setups/small-space-office.html

Skip to content Free printable: the 12-step desk cable checklist. Get the free checklist: 12 steps, 2 pages ↗ (https://payhip.com/b/XAPfb)

The Setup Edit

# The Small Space Office

A full workstation for a corner, a bedroom or an apartment. Every item earns its space.

Shop the list of 6 picks

Disclosure. The Setup Edit is reader-supported. As an Amazon Associate I earn from qualifying purchases. Links to Amazon are affiliate links: if you buy through them, I may earn a small commission at no extra cost to you.

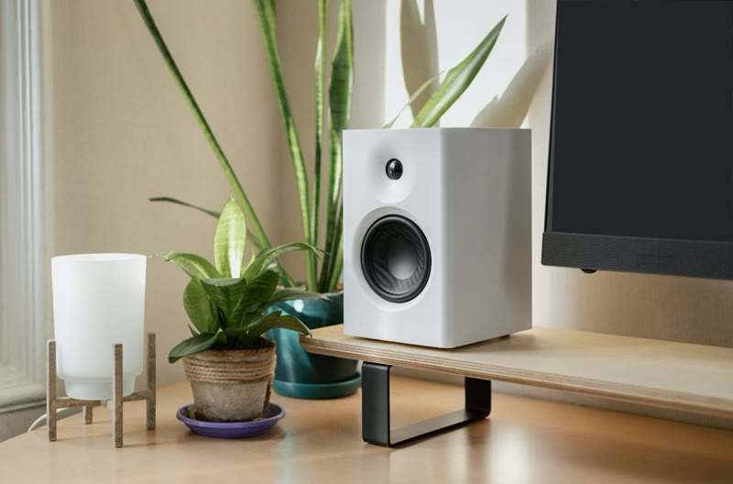
[picture p233: docs/img/web/small-800.jpg]
A compact home office desk with a raised monitor in a small room


Products shown in photos may differ from the linked items.Photo: Behnam Norouzi (https://unsplash.com/photos/j3b15qP-ckc) on Unsplash

## How this desk works

Every item here either lifts something off the desk or hides it underneath. The riser and the laptop stand raise screens to a better height and free the surface below them. The light bar and the floating shelves use space that was going to waste.

The footrest solves the usual small-space compromise: a chair or a desk that is not quite the right height.

Good for: Bedrooms, corners and apartments where the desk has to stay small.

## The list

Research-based picks, not hands-on tested. Links go to Amazon, and as an Amazon Associate I earn from qualifying purchases.

1. Start hereScreens

### Monitor Riser

  WALI adjustable monitor stand
  Raises your screen and adds storage underneath.
  It lifts the screen and adds a shelf underneath, which frees more surface than anything else here.
  View on Amazon: Monitor Riser ↗ (https://www.amazon.com/dp/B094QTGHNZ?tag=thesetupedi0e-20)
2. Screens

### Laptop Stand

  BESIGN LS03 aluminum stand
  Turns a laptop into a proper workstation.
  View on Amazon: Laptop Stand ↗ (https://www.amazon.com/dp/B08BRCT4JH?tag=thesetupedi0e-20)
3. Light

### Monitor Light Bar

  Quntis monitor lamp
  Desk light with zero footprint.
  View on Amazon: Monitor Light Bar ↗ (https://www.amazon.com/dp/B08DKQ3JG1?tag=thesetupedi0e-20)
4. Storage

### Floating Shelves

  Wall-mounted floating shelves
  Storage above the desk, so the desktop itself stays clear.
  View on Amazon: Floating Shelves ↗ (https://www.amazon.com/dp/B0DZWXJ9VZ?tag=thesetupedi0e-20)
5. Comfort

### Under-Desk Footrest

  Everlasting Comfort memory foam
  The comfort upgrade nobody sees.
  View on Amazon: Under-Desk Footrest ↗ (https://www.amazon.com/dp/B07PGLBCFG?tag=thesetupedi0e-20)
6. Greenery

### Mini Desk Plants

  Der Rose artificial plants (3-pack)
  Fits on shelves and small desks.
  View on Amazon: Mini Desk Plants ↗ (https://www.amazon.com/dp/B07VKJKFN2?tag=thesetupedi0e-20)

A hand ticking boxes on a handwritten checklist in a notebook

Free printable

The desk cable checklist

Twelve steps from a tangle to a tidy desk, plus the short list of what you will need. Two pages, ready to print.

Get the free checklist↗ (https://payhip.com/b/XAPfb)

## Read the guides

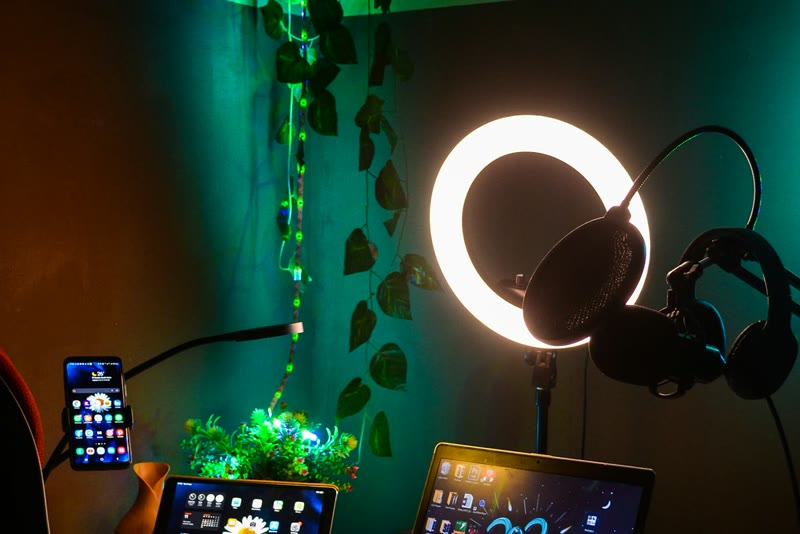
[picture p234: docs/img/web/video-call-800.jpg]
A desk lit by a ring light, with a laptop, a tablet and plants
A dual-monitor desk with plants, warm lamps and a wooden desktop Gift guide, 3 min readWork From Home Gift Ideas That Upgrade Their Desk  Lighting guide, 4 min readHow to Light a Desk for Video Calls A small bedroom desk beside a bed, with a laptop and a white chair Bedroom office guide, 4 min readThe Best Desk Setup for Small Bedrooms A compact home office desk with a raised monitor in a small room Small space guide, 4 min readSmall Home Office Ideas That Actually Work

## More setups

- A trading desk with a monitor on an arm, a laptop on a stand and warm backlighting The Trading Desk Setup9 picks
- A minimal desk with a leather desk pad, a white mouse and a wooden tray The Clean Minimal Desk7 picks
- Cables coiled and clipped to the underside of a desk The Cable Management Kit2 picks

The Setup Edit

Curated desk setups, home office ideas and trading desks, researched and written by one independent editor.

Setups

- The Trading Desk Setup
- The Clean Minimal Desk
- The Small Space Office
- The Cable Management Kit

Guides

- Gift Ideas for Traders
- Work From Home Gift Ideas That Upgrade Their Desk
- Desk Stocking Stuffers
- Standing Desk Setup Guide
- How to Light a Desk for Video Calls
- The Best Desk Setup for Small Bedrooms
- How to Build a Trading Desk Setup
- Cable Management 101
- Small Home Office Ideas That Actually Work
- Minimalist Desk Setup

Shop

- Desk Cable Checklist (https://payhip.com/b/XAPfb)
- The Clean Desk Guide (https://payhip.com/b/3MK0F)
- Minimalist Wallpaper Pack (https://payhip.com/b/XqrMo)

The Edit

- About & disclosure
- Sitemap

The Setup Edit is reader-supported. As an Amazon Associate I earn from qualifying purchases. Links to Amazon are affiliate links: if you buy through them, I may earn a small commission at no extra cost to you. Picks come from research, not hands-on testing.

Photos from Unsplash (https://unsplash.com): Roberto Nickson (https://unsplash.com/photos/Gvm2wM3V5PA), João Inácio (https://unsplash.com/photos/Wk_6p1TuhRE), Muhammet Sain (https://unsplash.com/photos/_g0SLFllfBY), Behnam Norouzi (https://unsplash.com/photos/j3b15qP-ckc), Bedirhan Gül (https://unsplash.com/photos/I_3D0pVrMhY), Aleksandra Dementeva (https://unsplash.com/photos/GzR2KS4ABYA), Adeniji Abdullahi A (https://unsplash.com/photos/F5FrFqwIKAI), EFFYDESK (https://unsplash.com/photos/aDZ-UZSvhE4), Jakub Żerdzicki (https://unsplash.com/photos/weJ7qyjHYwk), Max Andrey (https://unsplash.com/photos/-8-2YWKt8Ag). Products shown in photos may differ from the linked items.

© 2026 The Setup EditBack to top

12-step desk cable checklistFree, two pages, ready to print

Get the free checklist↗ (https://payhip.com/b/XAPfb)×
