qman122/thesetupedit/docs/setups/trading-desk-setup.html

Skip to content Free printable: the 12-step desk cable checklist. Get the free checklist: 12 steps, 2 pages ↗ (https://payhip.com/b/XAPfb)

The Setup Edit

# The Trading Desk Setup

A multi-monitor desk built for long sessions: floating screens, good light, and room to think.

Shop the list of 9 picks

Disclosure. The Setup Edit is reader-supported. As an Amazon Associate I earn from qualifying purchases. Links to Amazon are affiliate links: if you buy through them, I may earn a small commission at no extra cost to you.

A trading desk with a monitor on an arm, a laptop on a stand and warm backlighting

Products shown in photos may differ from the linked items.Photo: João Inácio (https://unsplash.com/photos/Wk_6p1TuhRE) on Unsplash

## How this desk works

This desk is built around two screens at the same height, straight in front of you, with the space under them left clear. Arms carry the monitors, a light bar lights the desk without glare, and bias lighting softens the contrast during evening sessions.

The standing frame, the chair and the mouse are there for long days. The two books are the one part of the setup that has nothing to do with hardware.

Good for: Traders, and anyone who works across two screens for hours.

## The list

Research-based picks, not hands-on tested. Links go to Amazon, and as an Amazon Associate I earn from qualifying purchases.

1. Start hereScreens

### Dual Monitor Arm

  VIVO dual monitor desk mount
  Floats two screens off the desk so you get your whole surface back.
  Everything else on this desk is placed around the screens, so mount them first.
  View on Amazon: Dual Monitor Arm ↗ (https://www.amazon.com/dp/B009S750LA?tag=thesetupedi0e-20)
2. Screens

### Single Monitor Arm

  VIVO single monitor arm
  One screen, fully adjustable height, tilt and swivel.
  View on Amazon: Single Monitor Arm ↗ (https://www.amazon.com/dp/B00B21TLQU?tag=thesetupedi0e-20)
3. Light

### Monitor Light Bar

  BenQ ScreenBar
  Lights your desk, not your screen. No glare on late-night charts.
  View on Amazon: Monitor Light Bar ↗ (https://www.amazon.com/dp/B076VNFZJG?tag=thesetupedi0e-20)
4. Desk

### Electric Standing Desk

  FLEXISPOT EN1
  Sit or stand at the push of a button, with 4 memory presets.
  View on Amazon: Electric Standing Desk ↗ (https://www.amazon.com/dp/B08BHPMYGK?tag=thesetupedi0e-20)
5. Light

### LED Monitor Backlight

  Luminoodle bias lighting
  USB-powered glow behind your screen, softer on your eyes at night.
  View on Amazon: LED Monitor Backlight ↗ (https://www.amazon.com/dp/B01LG99NW4?tag=thesetupedi0e-20)
6. Input

### Ergonomic Mouse

  Logitech MX Master 3S
  Shaped for long days, with an ultra-fast scroll wheel.
  View on Amazon: Ergonomic Mouse ↗ (https://www.amazon.com/dp/B0B11LJ69K?tag=thesetupedi0e-20)
7. Seating

### Ergonomic Mesh Chair

  Ergonomic mesh office chair
  A breathable mesh back that stays cooler than foam through a long session.
  View on Amazon: Ergonomic Mesh Chair ↗ (https://www.amazon.com/dp/B07Y8BXBX8?tag=thesetupedi0e-20)
8. Reading

### Trading in the Zone

  Book by Mark Douglas
  The classic on trading psychology and discipline.
  View on Amazon: Trading in the Zone ↗ (https://www.amazon.com/dp/0735201447?tag=thesetupedi0e-20)
9. Reading

### How to Day Trade for a Living

  Book by Andrew Aziz
  A beginner’s guide to day trading tools and risk management.
  View on Amazon: How to Day Trade for a Living ↗ (https://www.amazon.com/dp/1535585951?tag=thesetupedi0e-20)

A hand ticking boxes on a handwritten checklist in a notebook

Free printable

The desk cable checklist

Twelve steps from a tangle to a tidy desk, plus the short list of what you will need. Two pages, ready to print.

Get the free checklist↗ (https://payhip.com/b/XAPfb)

## Read the guides

A trading desk with a monitor on an arm, a laptop on a stand and warm backlighting Gift guide, 3 min readGift Ideas for Traders: Desk Upgrades and Books They Will Use A white standing desk with a monitor, a desk shelf and plants Standing desk guide, 4 min readStanding Desk Setup Guide: Heights, Screens and Cables A desk lit by a ring light, with a laptop, a tablet and plants Lighting guide, 4 min readHow to Light a Desk for Video Calls A trading desk with a monitor on an arm, a laptop on a stand and warm backlighting Trading desk guide, 5 min readHow to Build a Trading Desk Setup (Step by Step)

## More setups

- A minimal desk with a leather desk pad, a white mouse and a wooden tray The Clean Minimal Desk7 picks
- A compact home office desk with a raised monitor in a small room The Small Space Office6 picks
- Cables coiled and clipped to the underside of a desk The Cable Management Kit2 picks

The Setup Edit

Curated desk setups, home office ideas and trading desks, researched and written by one independent editor.

Setups

- The Trading Desk Setup
- The Clean Minimal Desk
- The Small Space Office
- The Cable Management Kit

Guides

- Gift Ideas for Traders
- Work From Home Gift Ideas That Upgrade Their Desk
- Desk Stocking Stuffers
- Standing Desk Setup Guide
- How to Light a Desk for Video Calls
- The Best Desk Setup for Small Bedrooms
- How to Build a Trading Desk Setup
- Cable Management 101
- Small Home Office Ideas That Actually Work
- Minimalist Desk Setup

Shop

- Desk Cable Checklist (https://payhip.com/b/XAPfb)
- The Clean Desk Guide (https://payhip.com/b/3MK0F)
- Minimalist Wallpaper Pack (https://payhip.com/b/XqrMo)

The Edit

- About & disclosure
- Sitemap

The Setup Edit is reader-supported. As an Amazon Associate I earn from qualifying purchases. Links to Amazon are affiliate links: if you buy through them, I may earn a small commission at no extra cost to you. Picks come from research, not hands-on testing.

Photos from Unsplash (https://unsplash.com): Roberto Nickson (https://unsplash.com/photos/Gvm2wM3V5PA), João Inácio (https://unsplash.com/photos/Wk_6p1TuhRE), Muhammet Sain (https://unsplash.com/photos/_g0SLFllfBY), Behnam Norouzi (https://unsplash.com/photos/j3b15qP-ckc), Bedirhan Gül (https://unsplash.com/photos/I_3D0pVrMhY), Aleksandra Dementeva (https://unsplash.com/photos/GzR2KS4ABYA), Adeniji Abdullahi A (https://unsplash.com/photos/F5FrFqwIKAI), EFFYDESK (https://unsplash.com/photos/aDZ-UZSvhE4), Jakub Żerdzicki (https://unsplash.com/photos/weJ7qyjHYwk), Max Andrey (https://unsplash.com/photos/-8-2YWKt8Ag). Products shown in photos may differ from the linked items.

© 2026 The Setup EditBack to top

12-step desk cable checklistFree, two pages, ready to print

Get the free checklist↗ (https://payhip.com/b/XAPfb)×
