qman122/thesetupedit/c5-shroud/diagrams/step_options.png

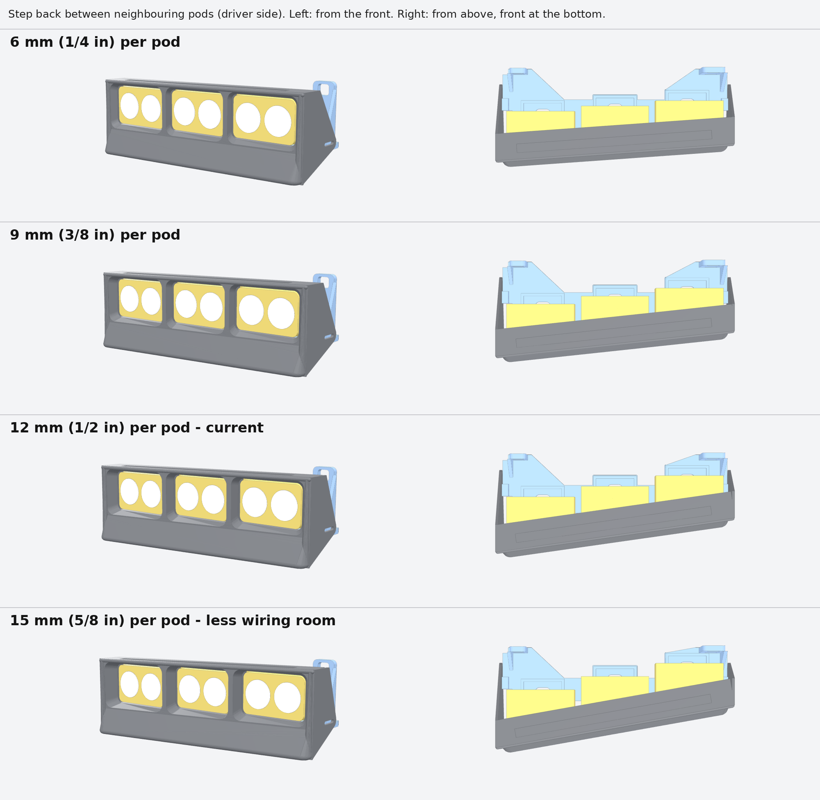
c5-shroud/diagrams/step_options.png
