qman122/thesetupedit/docs/media/b3/b3-02-trading-setup-pieces.png

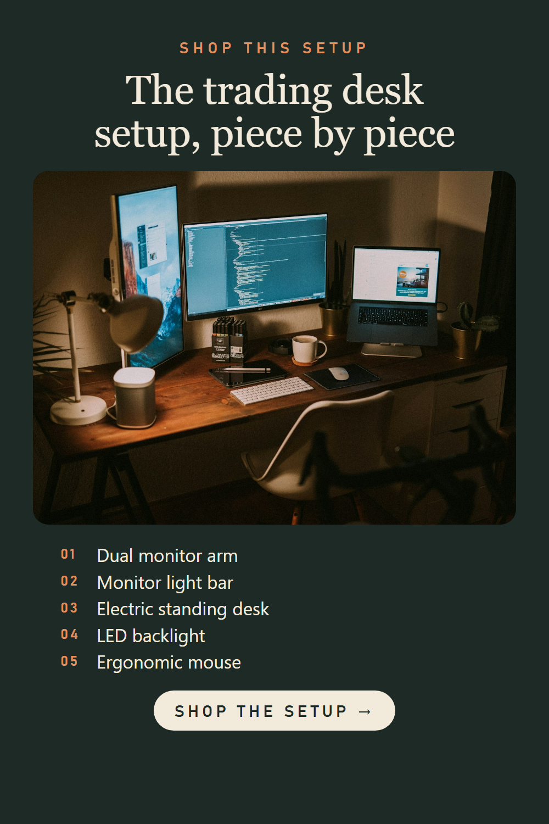
docs/media/b3/b3-02-trading-setup-pieces.png
