qman122/thesetupedit/docs/media/b3/b3-27-cable-free-3-steps.png

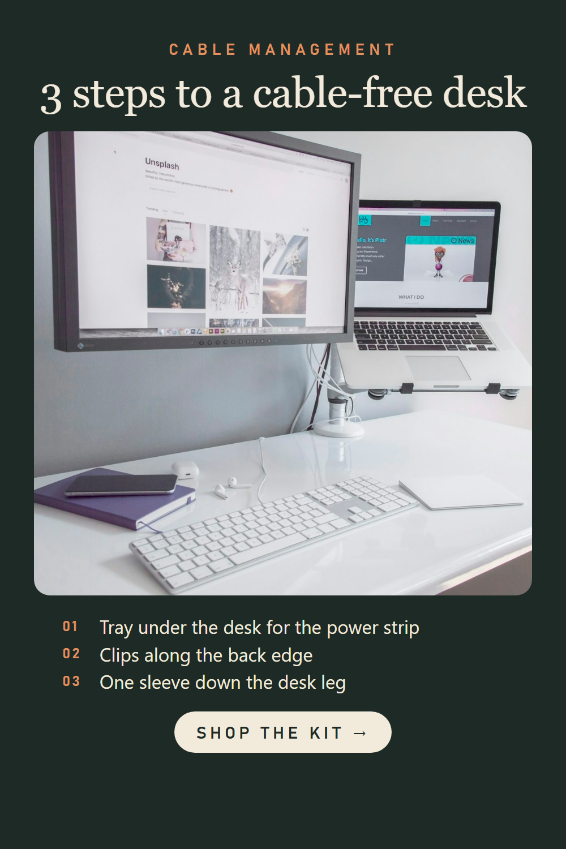
docs/media/b3/b3-27-cable-free-3-steps.png
