qman122/thesetupedit/docs/media/b3/b3-42-white-desk-setup.png

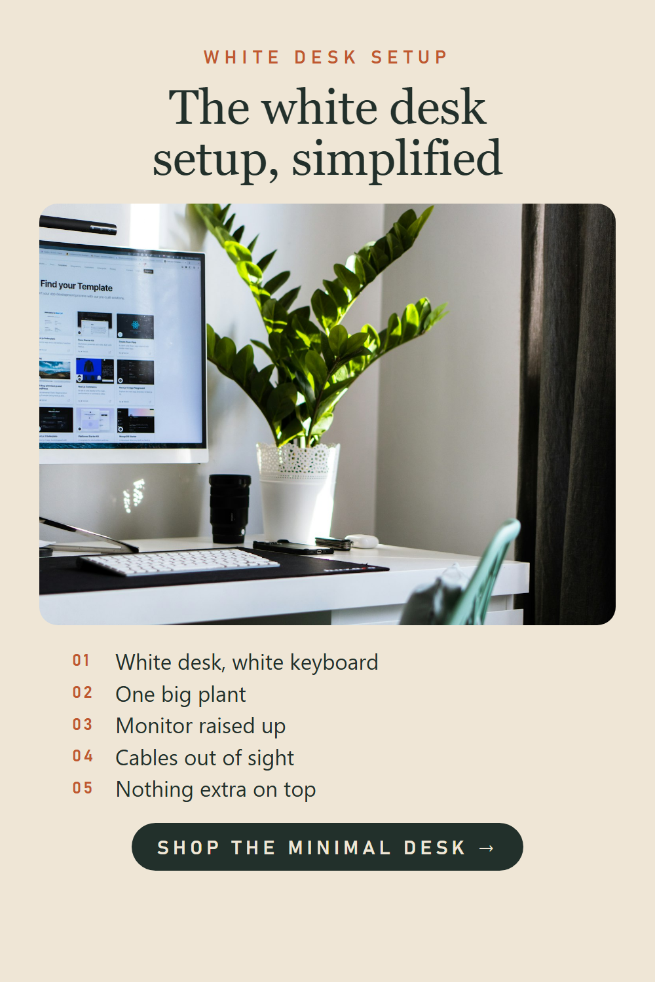
docs/media/b3/b3-42-white-desk-setup.png
