qman122/thesetupedit/docs/media/b4/b4-02-small-office-build-up.png

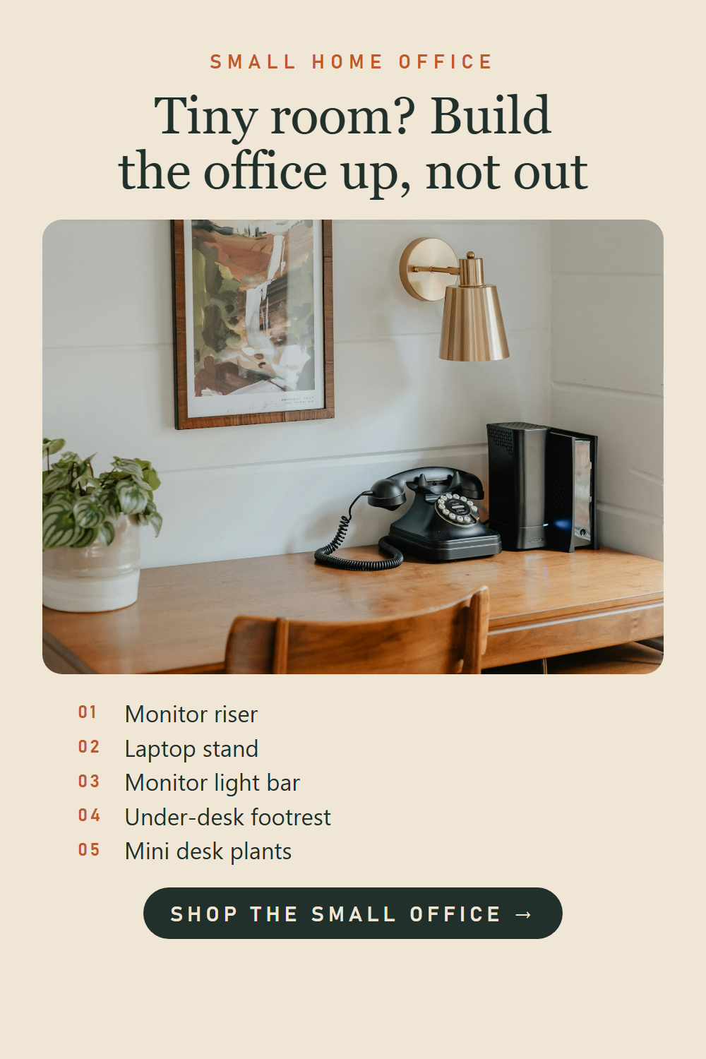
docs/media/b4/b4-02-small-office-build-up.png
