qman122/thesetupedit/docs/media/b4/b4-14-build-trading-desk-guide.png

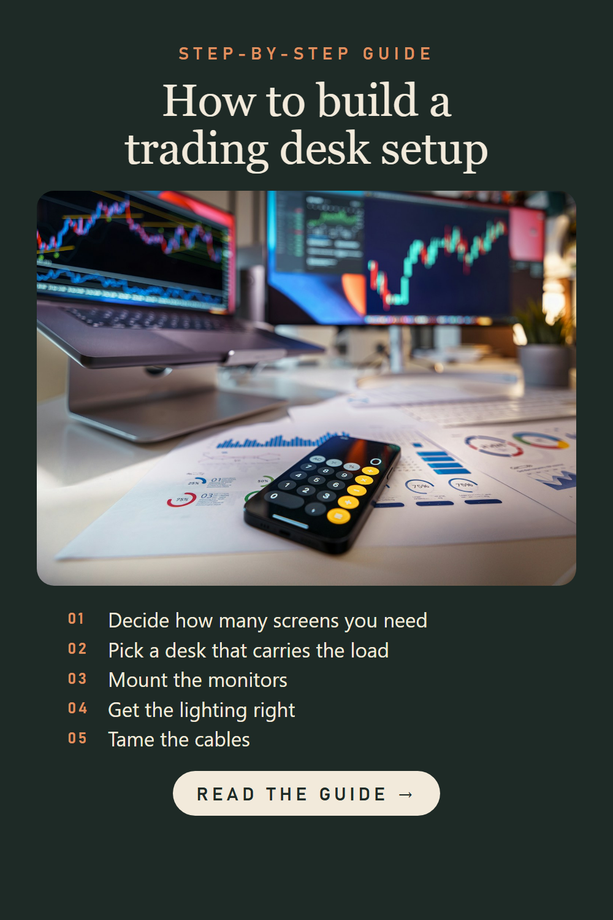
docs/media/b4/b4-14-build-trading-desk-guide.png
