qman122/thesetupedit/docs/media/b4/b4-23-small-office-ideas-guide.png

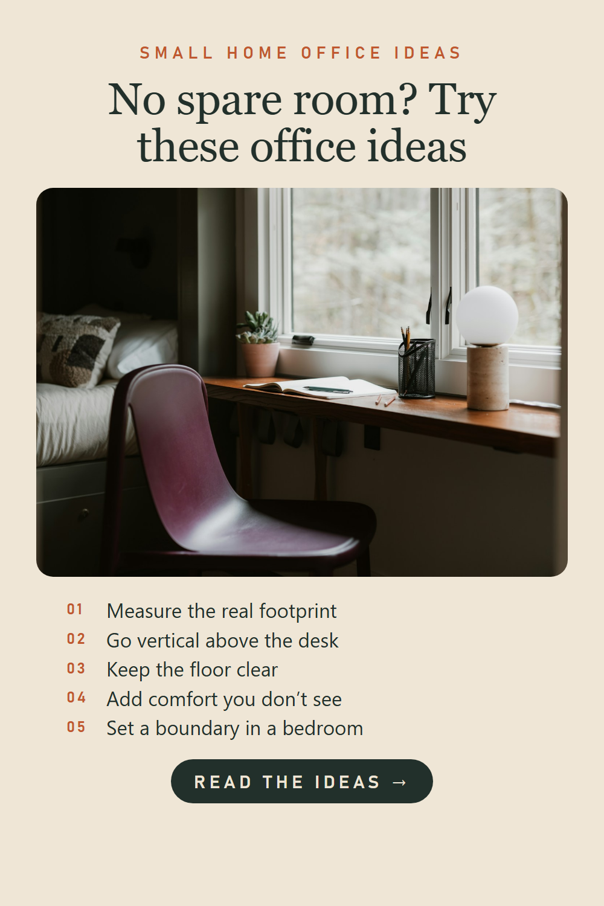
docs/media/b4/b4-23-small-office-ideas-guide.png
