qman122/thesetupedit/docs/media/b4/b4-29-minimal-essentials-guide.png

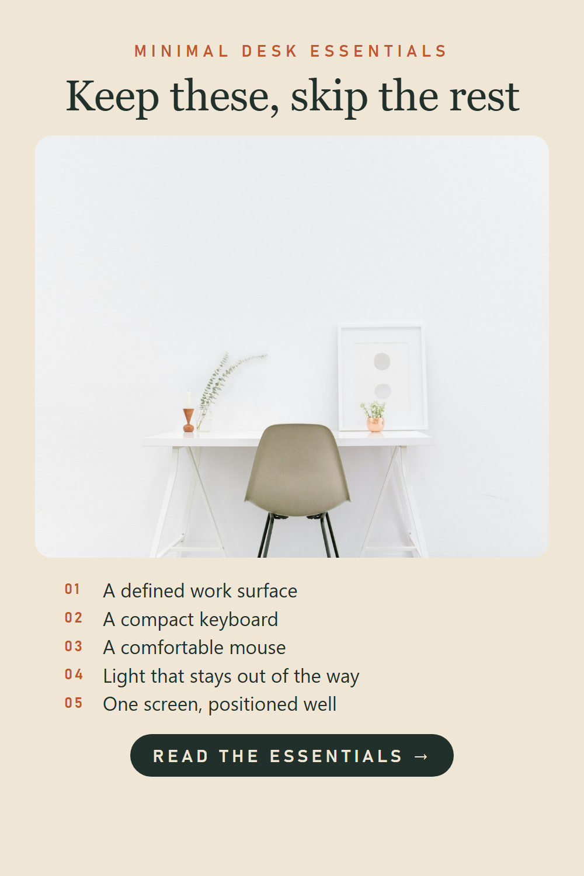
docs/media/b4/b4-29-minimal-essentials-guide.png
