qman122/thesetupedit/docs/media/b4/b4-32-checklist-12-steps.png

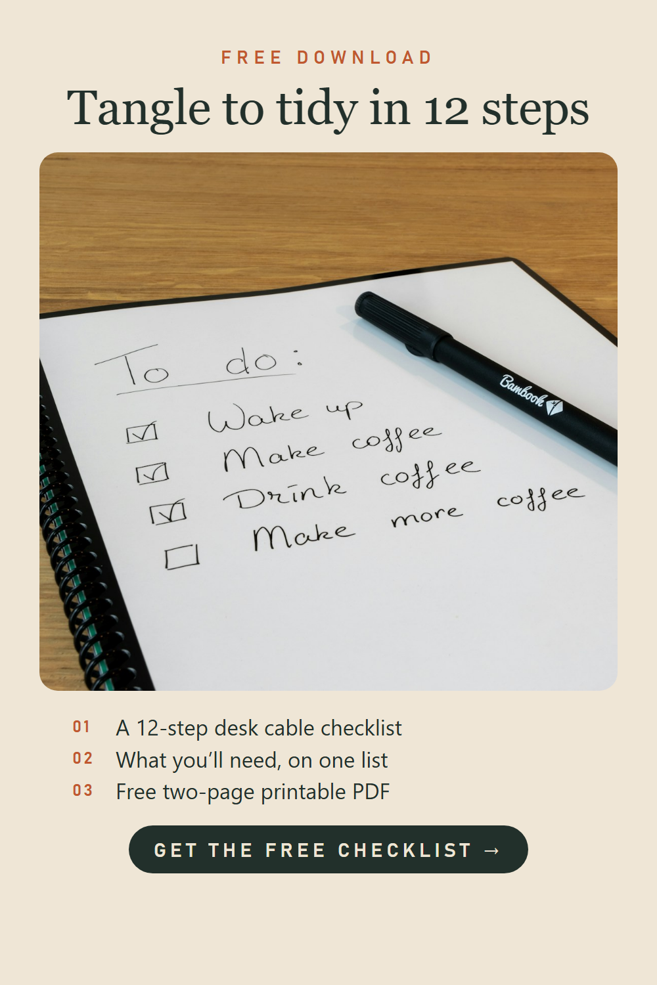
docs/media/b4/b4-32-checklist-12-steps.png
