qman122/thesetupedit/docs/media/b4/b4-40-light-bar-night-setup.png

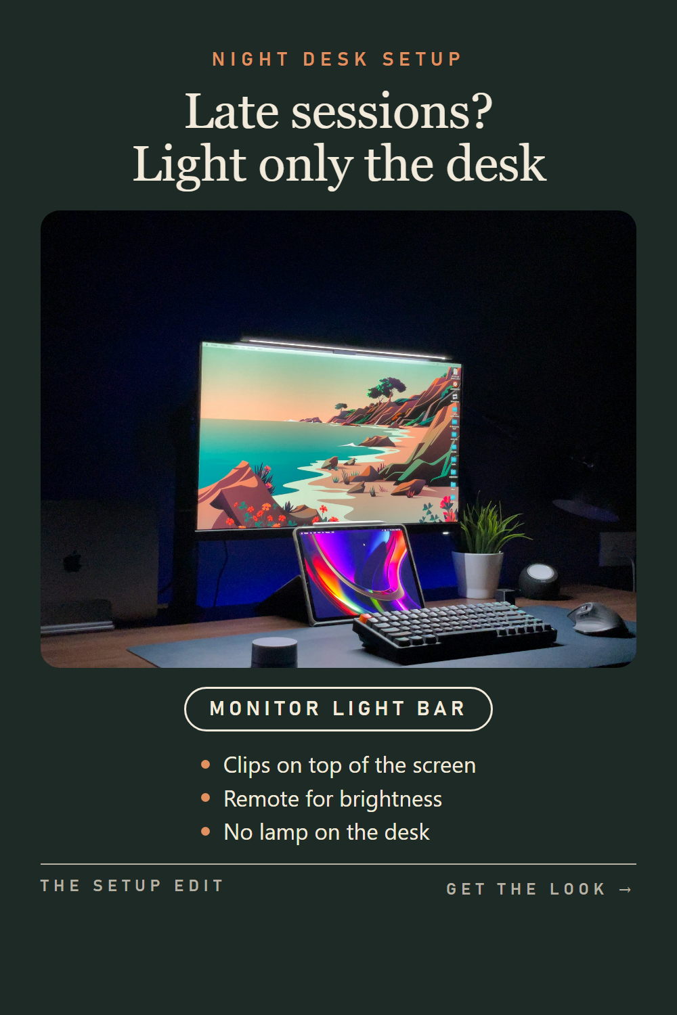
docs/media/b4/b4-40-light-bar-night-setup.png
