qman122/thesetupedit/docs/media/b5/b5-32-trading-desk-build-order.png

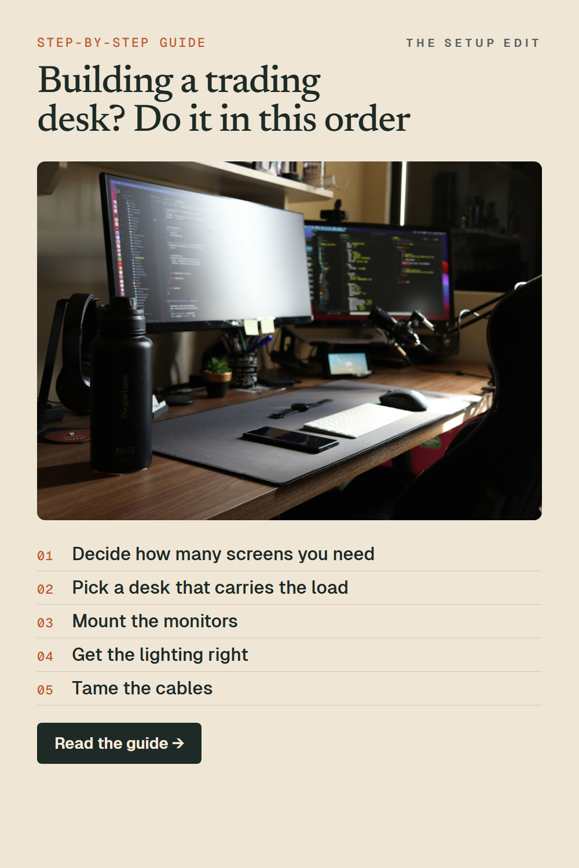
docs/media/b5/b5-32-trading-desk-build-order.png
