qman122/thesetupedit/docs/media/b5/b5-35-trading-desk-build-checklist.png

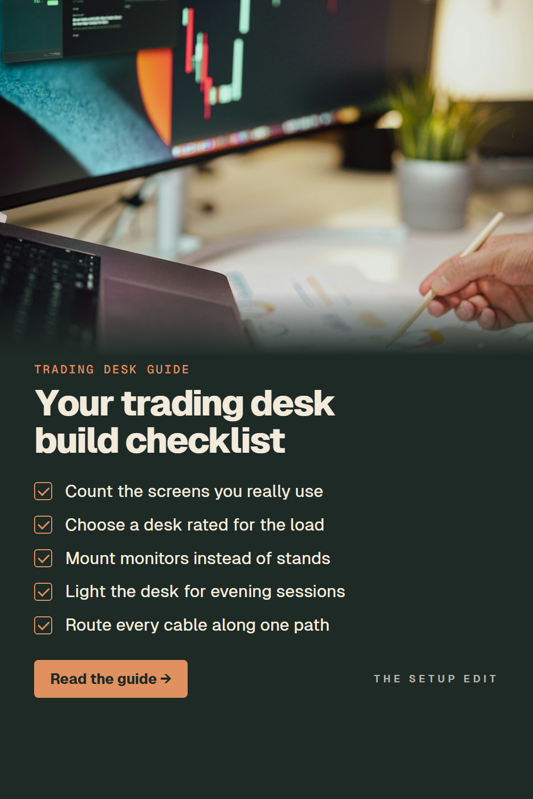
docs/media/b5/b5-35-trading-desk-build-checklist.png
