qman122/thesetupedit/media/b6/b6-002-how-to-build-a-trading-desk.jpg

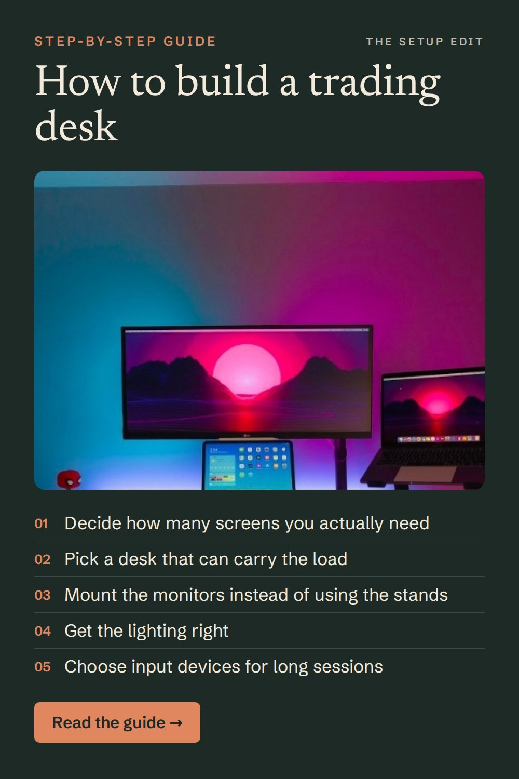
media/b6/b6-002-how-to-build-a-trading-desk.jpg
