qman122/thesetupedit/media/b6/b6-004-how-to-hide-desk-cables.jpg

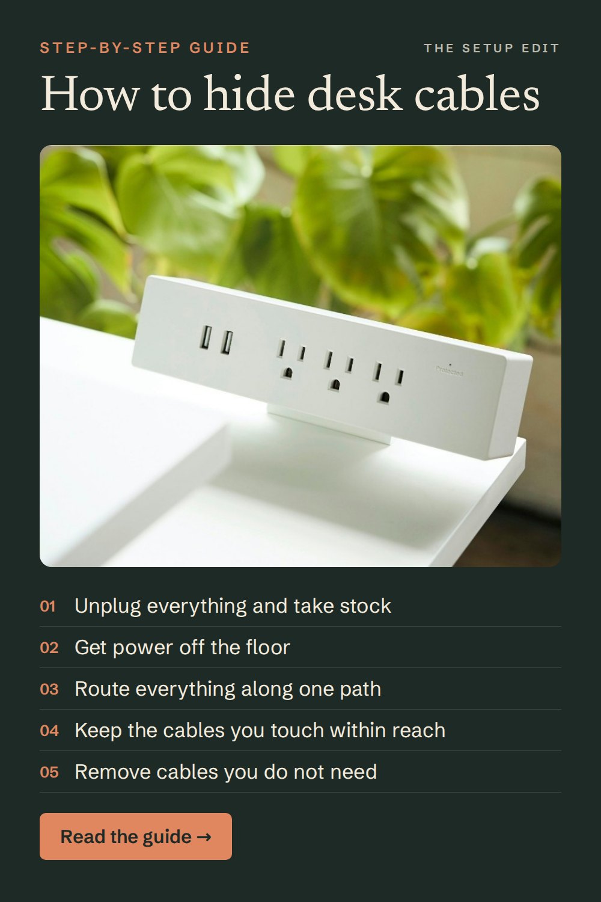
media/b6/b6-004-how-to-hide-desk-cables.jpg
