qman122/thesetupedit/media/b6/b6-059-a-desk-setup-for-a-small-bedroom.jpg

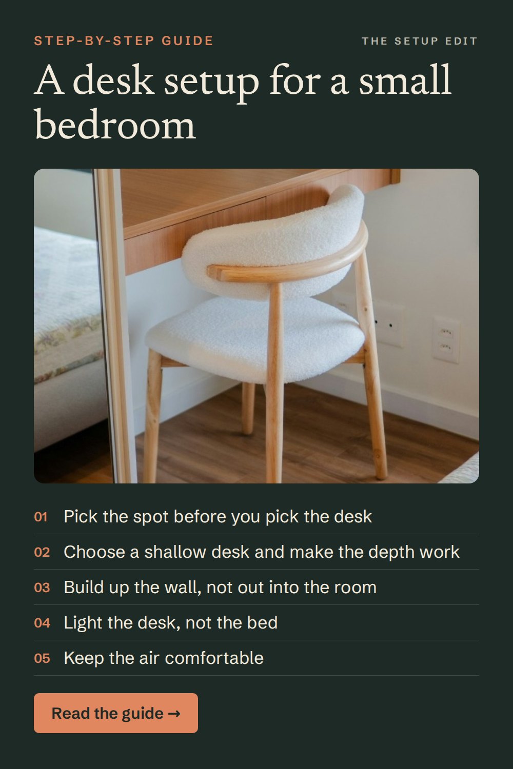
media/b6/b6-059-a-desk-setup-for-a-small-bedroom.jpg
