qman122/thesetupedit/media/b6/b6-080-how-to-day-trade-for-a-living-for-the-new-trader.jpg

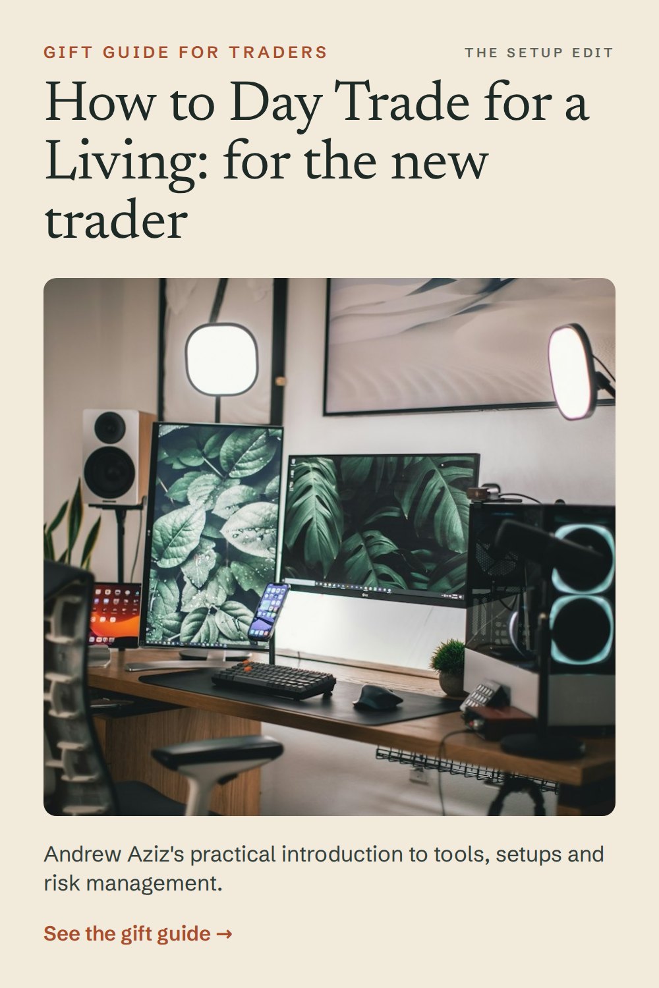
media/b6/b6-080-how-to-day-trade-for-a-living-for-the-new-trader.jpg
