qman122/thesetupedit/media/b6/b6-083-gift-idea-how-to-day-trade-for-a-living.jpg

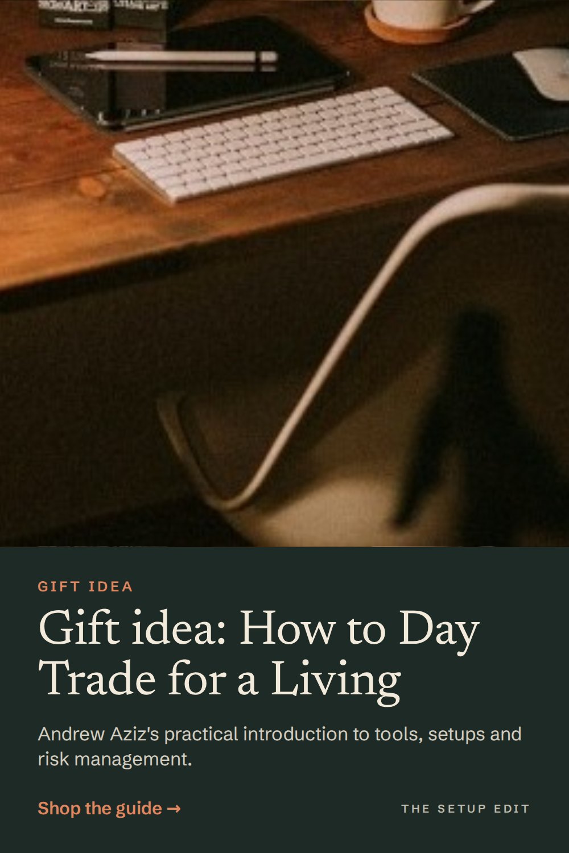
media/b6/b6-083-gift-idea-how-to-day-trade-for-a-living.jpg
