qman122/thesetupedit/media/b6/b6-119-choose-a-shallow-desk-and-make-the-depth-work.jpg

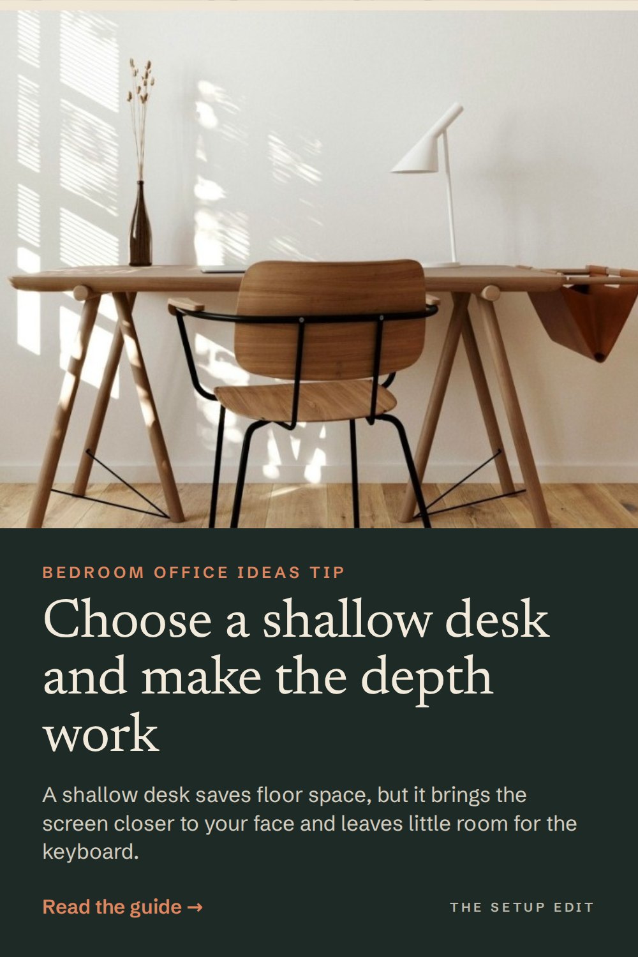
media/b6/b6-119-choose-a-shallow-desk-and-make-the-depth-work.jpg
