qman122/thesetupedit/media/b6/b6-120-desk-upgrades-that-make-great-gifts.jpg

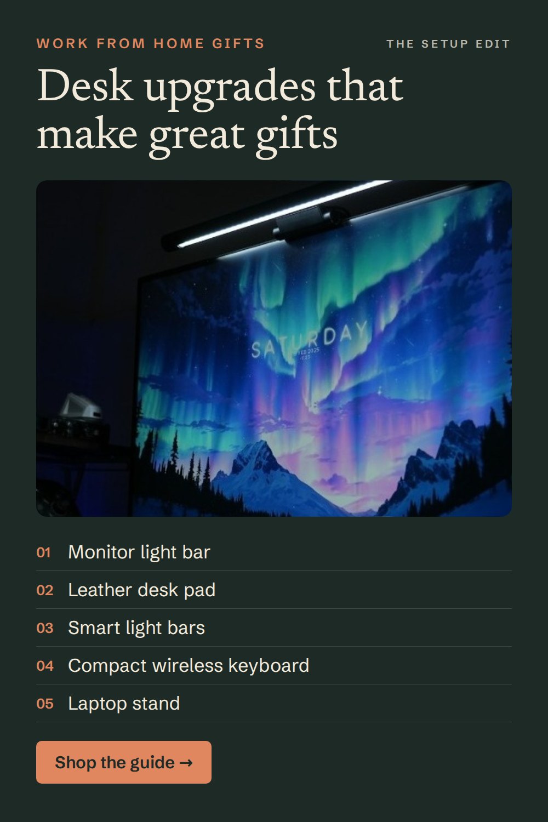
media/b6/b6-120-desk-upgrades-that-make-great-gifts.jpg
