qman122/thesetupedit/media/b6/b6-142-build-up-the-wall-not-out-into-the-room.jpg

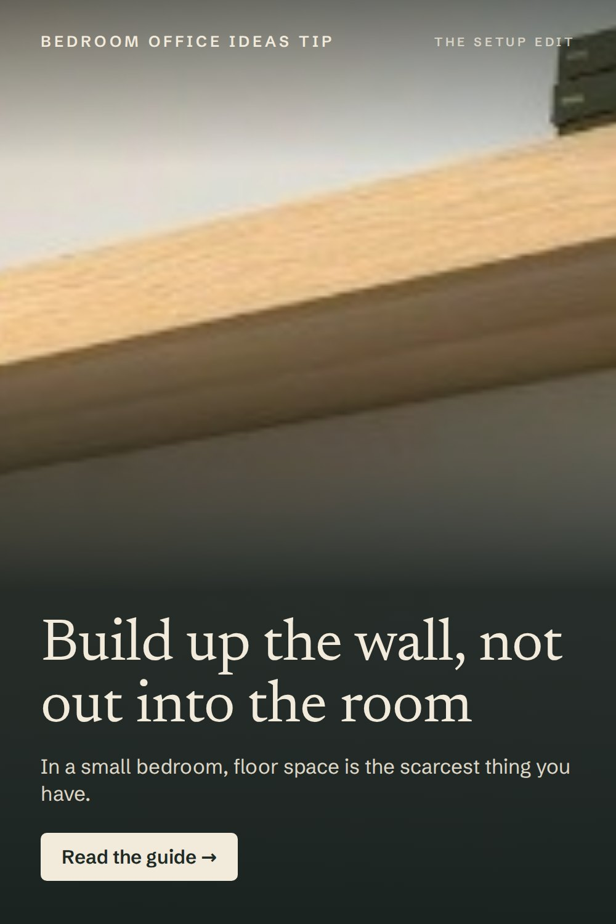
media/b6/b6-142-build-up-the-wall-not-out-into-the-room.jpg
