qman122/thesetupedit/media/b6/b6-159-make-it-feel-like-a-place-not-a-leftover-corner.jpg

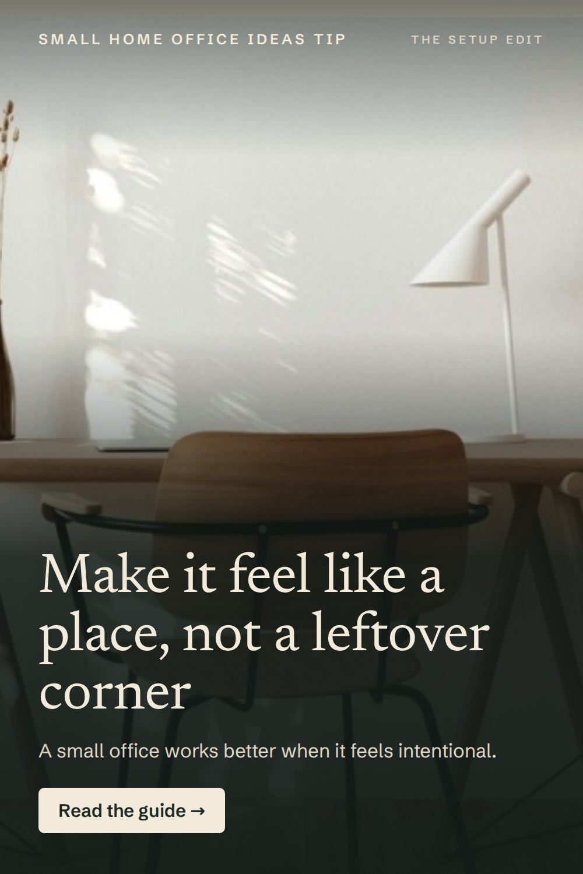
media/b6/b6-159-make-it-feel-like-a-place-not-a-leftover-corner.jpg
