qman122/thesetupedit/media/b6/b6-177-the-clean-desk-guide.jpg

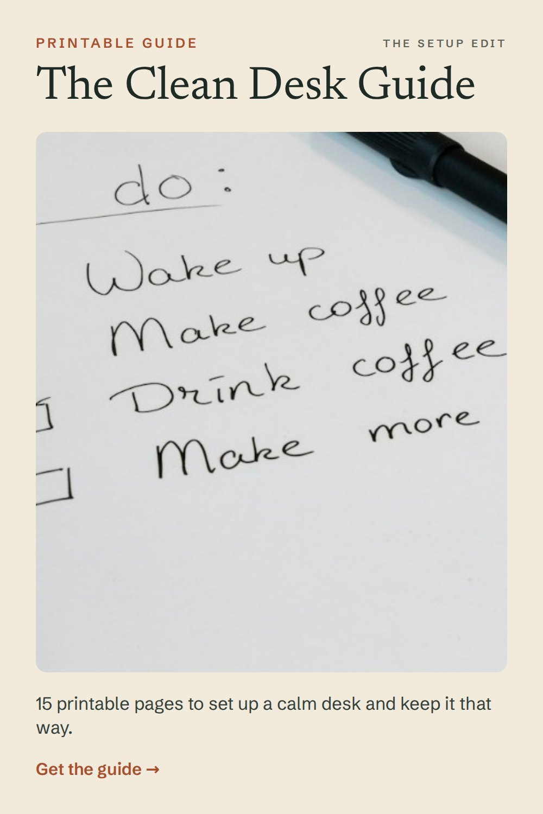
media/b6/b6-177-the-clean-desk-guide.jpg
