qman122/thesetupedit/media/b6/b6-184-tidy-desk-cables-in-12-steps.jpg

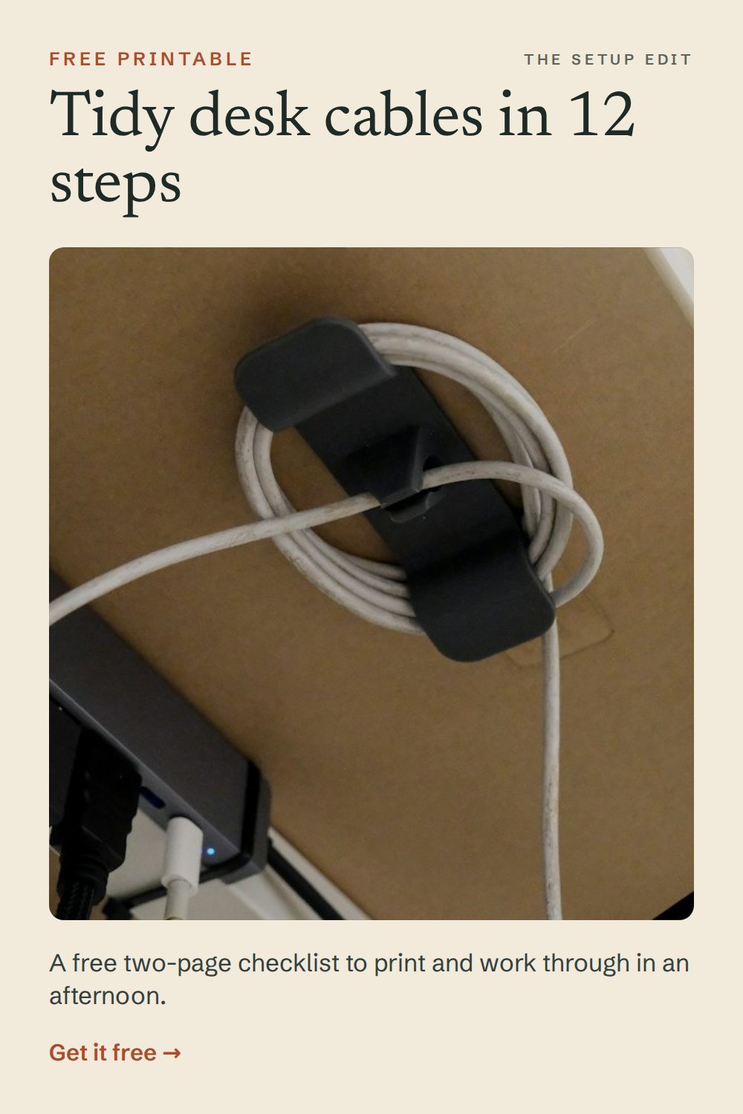
media/b6/b6-184-tidy-desk-cables-in-12-steps.jpg
