qman122/thesetupedit/media/b6/b6-188-how-to-keep-a-desk-clean.jpg

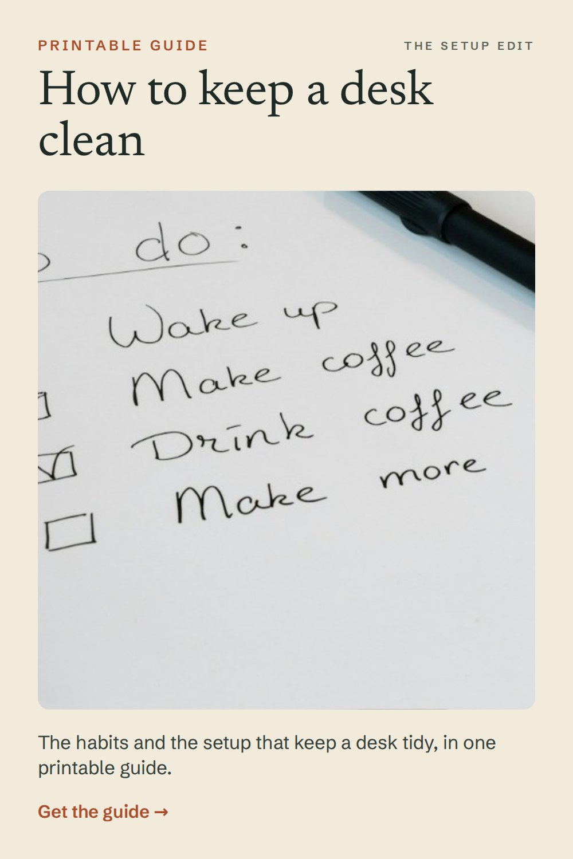
media/b6/b6-188-how-to-keep-a-desk-clean.jpg
