qman122/thesetupedit/media/b6/b6-197-make-the-screen-match-the-desk.jpg

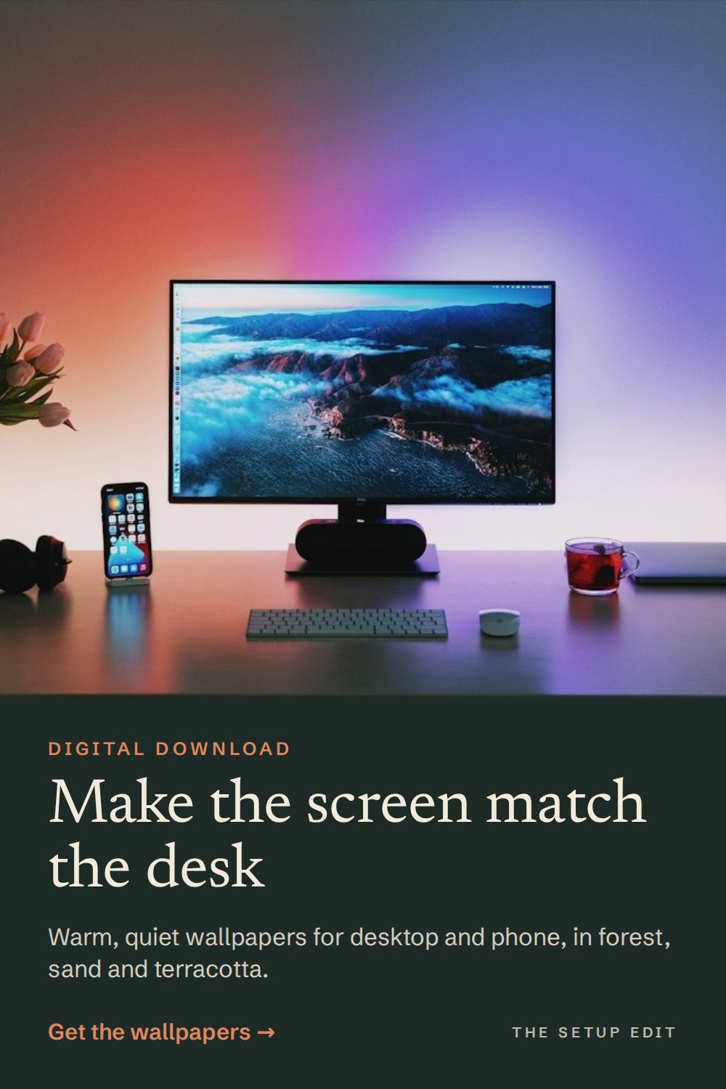
media/b6/b6-197-make-the-screen-match-the-desk.jpg
