qman122/thesetupedit/media/b6/b6-202-print-this-before-you-tidy-your-desk.jpg

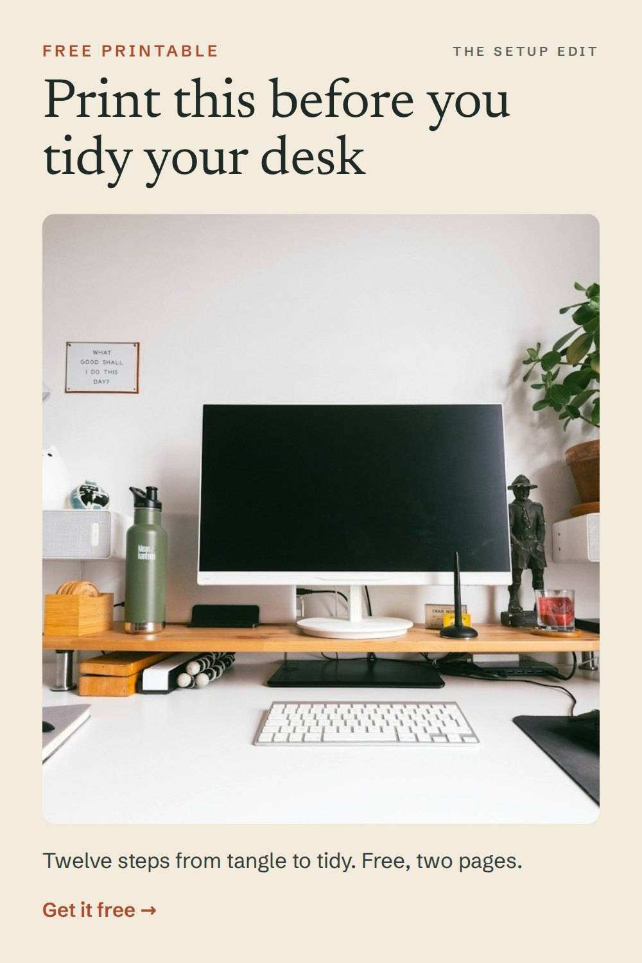
media/b6/b6-202-print-this-before-you-tidy-your-desk.jpg
