qman122/thesetupedit/c5-shroud/diagrams/measure_stock_bezel.png

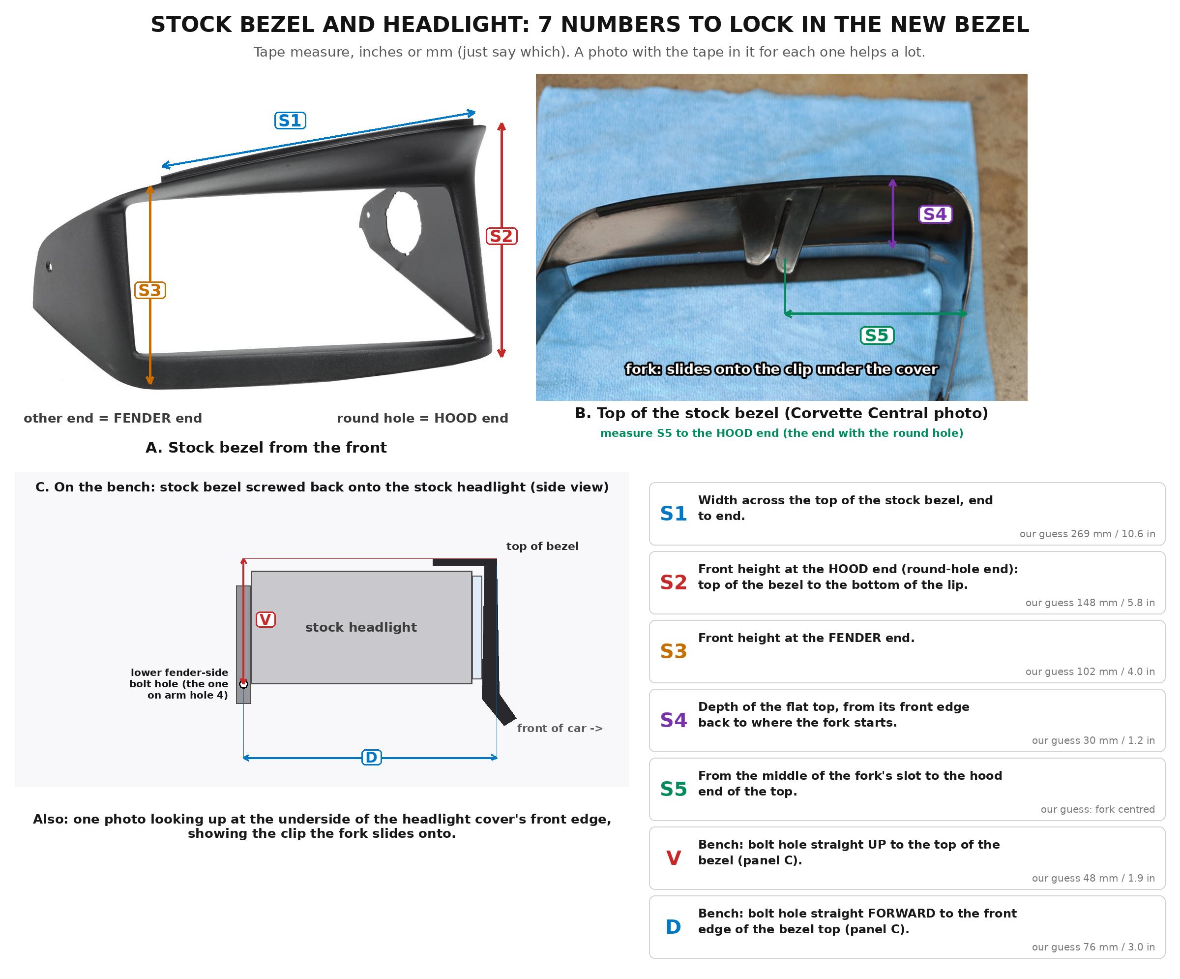
c5-shroud/diagrams/measure_stock_bezel.png
