qman122/thesetupedit/docs/media/b3/b3-12-ba-under-desk-fix.png

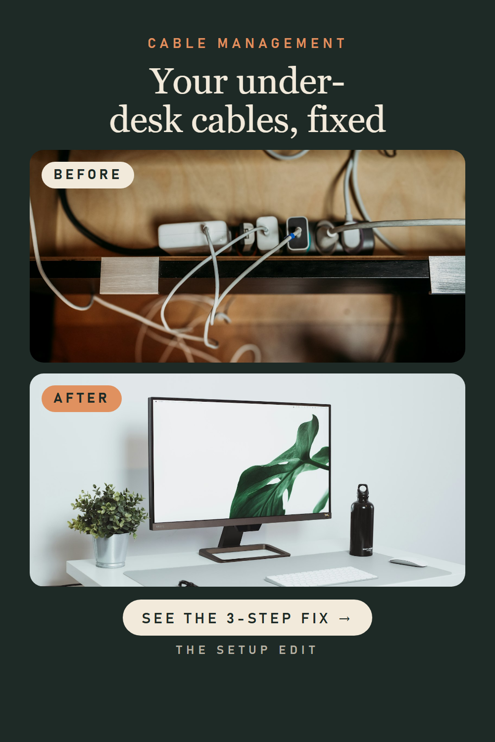
docs/media/b3/b3-12-ba-under-desk-fix.png
