qman122/thesetupedit/docs/media/b4/b4-20-ba-power-strip-fix.png

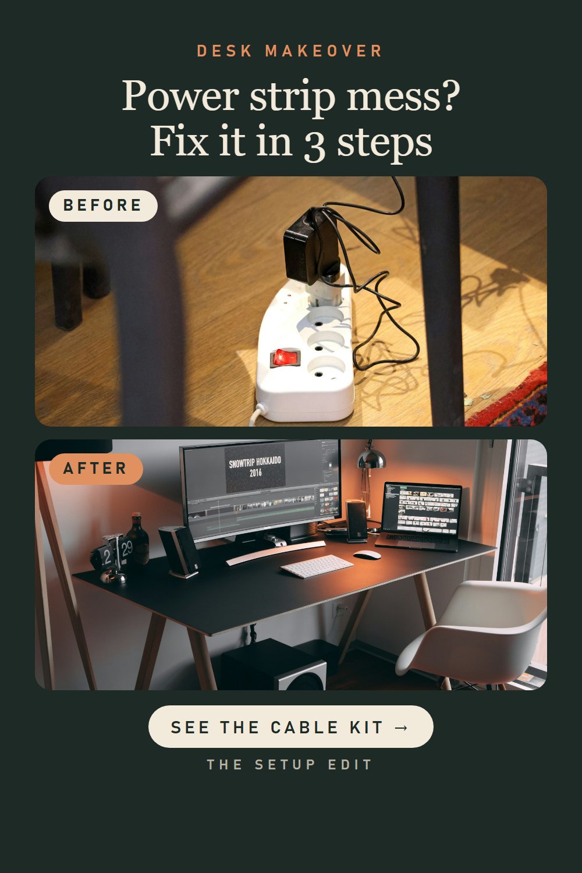
docs/media/b4/b4-20-ba-power-strip-fix.png
