qman122/thesetupedit/(commit log)

2026-09-23 Host pin media for scheduling
2026-09-24 Host batch 3 pin media
2026-09-24 Host batch 4 pin media
2026-09-25 Redesign: product cards, lead magnet, breadcrumbs, 3 new guides
    - Product cards with a clear "View on Amazon" button, role tags and a "Start here" pick per setup
    - Free Cable Checklist promoted site-wide (top bar, home band, in-page promo, sticky call to action)
    - Paid Payhip products featured on home, guides and the disclosure page
    - Breadcrumbs with BreadcrumbList JSON-LD, ItemList JSON-LD on setups, WebSite/Organization on home
    - Setup intros, better meta descriptions, related guides and more-setups blocks, mobile table of contents
    - Faster first paint: async fonts (Schibsted Grotesk + Newsreader), hero image preload,
    IntersectionObserver instead of scroll listeners
    - New guides: standi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
2026-09-25 Host batch 5 pin media
2026-09-27 Host batch 6 pin media
    204 pins: 8 to fill Sept 27-28 and 196 for Nov 13 - Dec 31 (gift
    guides, setups, guides and the Payhip products).
    Claude-Session: https://claude.ai/code/session_01LG9uUADJnas7wXGTu871B6
2026-09-27 Add notes from the C5 sleepy-eye LED headlight install video
    Chapter-by-chapter summary and shroud design takeaways, taken from the
    video's metadata and still frames (the stream itself is blocked from
    cloud IPs).
    Claude-Session: https://claude.ai/code/session_01M5RjfuvJShbeiYoa7cgYgA
2026-09-27 Rewrite C5 sleepy-eye notes from the full audio
    Adds the measurements and instructions from the whole install video
    (5 1/4 in door height at the leading edge, stop hardware per model year,
    mount holes, wiring, resistor heat) and what each means for the shroud.
    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
2026-09-27 Add how the sleepy-eye lights attach, from the video footage
    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
2026-09-27 Add parametric C5 sleepy-eye pod carrier and shroud (v1)
    Three 3x2 in LED pods per side on a carrier that bolts to the stock
    headlight mounting points, plus a front shroud framing the pods.
    Full-size and split STLs, splice plates, a fit-test window, a preview,
    and the generator script with every dimension as a parameter.
    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
    [carrier_driver.stl, carrier_driver_A.stl, carrier_driver_B.stl, carrier_passenger.stl, carrier_passenger_A.stl, carrier_passenger_B.stl, fit_test_window.stl, shroud_driver.stl]
2026-09-27 Size the C5 pod carrier and shroud to the pods' listed 2.9 x 1.8 x 2.8 in
    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
    [carrier_driver.stl, carrier_driver_A.stl, carrier_driver_B.stl, carrier_passenger.stl, carrier_passenger_A.stl, carrier_passenger_B.stl, fit_test_window.stl, shroud_driver.stl]
2026-09-27 C5 pod carrier v2: slotted mounts from measurements, checks
    Places M6 slots for the fender arm (holes 1 and 4) and aiming pad (both
    holes) from the owner's measurements, sizes the shroud to the 11 in
    opening, lengthens the pod slots, fixes the driver/passenger naming,
    and adds a mounting test plate, spacer washers and check.py (38 checks).
    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
    [carrier_driver.stl, carrier_driver_A.stl, carrier_driver_B.stl, carrier_passenger.stl, carrier_passenger_A.stl, carrier_passenger_B.stl, fit_test_mount_driver.stl, fit_test_mount_passenger.stl]
2026-09-27 C5 pod carrier v3: small mounting tabs, snug holes, bigger windows
    The first mount test hit parts next to the holes, so the full back wall
    becomes two small tabs with an open middle, clear of the arm's pivot
    bolt and the pad's square adjuster. Holes are 6.3 mm for M6 with
    shorter slots, shroud windows get 1.3 mm clearance, and the window fit
    test prints four sizes. check.py now runs 40 checks, all passing.
    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
    [carrier_driver.stl, carrier_driver_A.stl, carrier_driver_B.stl, carrier_passenger.stl, carrier_passenger_A.stl, carrier_passenger_B.stl, fit_test_mount_driver.stl, fit_test_mount_passenger.stl]
2026-09-28 Space the window fit test frames 8 mm apart so they print separately
    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
    [fit_test_window.stl]
2026-09-28 Use the pod maker's dimensions and add assembly diagrams
    Face 3.0 x 1.8 in, 1.8 in deep, bracket lifts the body 0.3 in on an
    ~8 mm stud: shroud windows re-centred and resized (1.0 mm clearance),
    floor slots back to 8.6 mm, window fit test ladder 0.6-1.8 mm. Adds
    exploded, front, rear and side assembly diagrams. check.py: 40/40.
    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
    [carrier_driver.stl, carrier_driver_A.stl, carrier_driver_B.stl, carrier_passenger.stl, carrier_passenger_A.stl, carrier_passenger_B.stl, fit_test_window.stl, shroud_driver.stl]
2026-09-28 Size the shroud windows to the fit-test frame that fit (1.8 mm)
    Both mount-test tabs lined up on the car, so the slot positions stay.
    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
    [shroud_driver.stl, shroud_driver_A.stl, shroud_driver_B.stl, shroud_passenger.stl, shroud_passenger_A.stl, shroud_passenger_B.stl, shroud_splice_x2.stl]
2026-09-28 Wider, shorter shroud windows; pad holes 1.3 mm closer
    Window gap is now 2.3 mm at the sides and 1.3 mm top and bottom (the
    4-notch frame fit but wanted to be a bit wider and shorter), with a
    three-frame fit test around that size. The pad test tab showed its
    holes a bit far apart, so H goes from 20.3 to 19.0 mm. README notes a
    flat washer under each M6 nut. check.py: 40/40.
    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
    [carrier_driver.stl, carrier_driver_A.stl, carrier_passenger.stl, carrier_passenger_A.stl, fit_test_mount_driver.stl, fit_test_mount_passenger.stl, fit_test_window.stl, shroud_driver.stl]
2026-09-28 Turn the shroud into a full bezel that encloses the pods
    The front piece now wraps back 78 mm on all four sides so only the
    bezel face and lenses show when the door is up. It screws to the
    carrier at four points (two new rear posts), all in 16 mm forward-only
    slots so it can follow the pods, and has a recess on top for foam
    weatherstrip to seal against the door. Pod slots trimmed to 16 mm
    forward / 10 mm back to match. Diagrams re-rendered. check.py: 45/45.
    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
    [bezel_driver.stl, bezel_driver_A.stl, bezel_driver_B.stl, bezel_passenger.stl, bezel_passenger_A.stl, bezel_passenger_B.stl, bezel_splice_x2.stl, carrier_driver.stl]
2026-09-28 Give each bezel window its own cell around the pod
    Each window gets a 12 mm sleeve around the pod bezel so every lens sits
    in its own recess and the gaps between pods are hidden. Carrier ribs
    now stop behind the cells. check.py: 45/45.
    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
    [bezel_driver.stl, bezel_driver_A.stl, bezel_driver_B.stl, bezel_passenger.stl, bezel_passenger_A.stl, bezel_passenger_B.stl, carrier_driver.stl, carrier_driver_A.stl]
2026-09-28 Put the pods on a curve to follow the headlight opening
    The outer pods sit about 6 mm back and turn out 8 degrees from the middle
    one. The carrier becomes a beam with a pocket per pod (each turned to its
    pod, still sliding straight fore-aft) and angled knees back to the tabs;
    the bezel face gets one flat panel per pod with square windows and cells.
    Drops the small-bed split files. Lenses exported for the mockup and
    diagrams. check.py: 35/35.
    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
    [bezel_driver.stl, bezel_driver_A.stl, bezel_driver_B.stl, bezel_passenger.stl, bezel_passenger_A.stl, bezel_passenger_B.stl, bezel_splice_x2.stl, carrier_driver.stl]
2026-09-28 Stagger the pods like the KDTV Gen 2 bracket
    All three pods now face straight ahead, each set 12 mm behind its
    neighbour, so the row follows the curve of the headlight opening.
    The carrier beam and the bezel face step back with them, and the
    bezel's front screw bosses move beside the outer pods' studs. The
    windows use the 1-notch test frame size (2.0 / 1.6 mm), which fit.
    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
    [bezel_driver.stl, bezel_passenger.stl, carrier_driver.stl, carrier_passenger.stl]
2026-09-28 Restyle the bezel after the KnightDriveTV TripLED bezel
    The bezel front is now one continuous surface that sweeps back along
    the pods' step. A tunnel runs back to each pod, a rolled lip runs
    along the bottom and a top rail carries the foam seal. A side wing at
    each end screws into a new boss on the carrier; those bosses replace
    the carrier's two rear posts for the old boxy wrap. The bezel prints
    upside down on its top rail.
    The mockup now exports the pods and lenses per side, so the driver
    side's stepped pods are no longer drawn mirrored the wrong way. Adds
    a comparison of 6, 9, 12 and 15 mm step sizes.
    Claude-Session: https://claude.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
    [bezel_driver.stl, bezel_passenger.stl, carrier_driver.stl, carrier_passenger.stl]
2026-09-28 Give the bezel the stock C5 bezel's shape and slide-in top
    The stock bezel (GM 10435411/12), which the KnightDriveTV TripLED
    bezel copies, is held by a flat top that slides in under the front
    of the headlight cover, a forked tab on it that slides onto the
    clip under the cover, and screws through ears at both ends. The new
    bezel follows that shape: top blade and fork, a front that is taller
    at the hood end, and a rolled lip along the bottom and up both ends,
    so it reaches all the way down. The tunnels, cells, wing screws and
    under-floor tabs carry over.
    The outline heights are estimates from a head-on video frame scaled
    to the 11 in opening, so this adds a blade-and-fork test strip and a
    mea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
    [bezel_driver.stl, bezel_passenger.stl, fit_test_blade_driver.stl, fit_test_blade_passenger.stl]
2026-09-28 Extend the bezel wings into full side walls
    Like the stock C5 bezel's ears and the KnightDriveTV bezel, the wings
    now run back past the pods to just in front of the arm and the pad,
    and down over the carrier, so the sides are covered. The hood-end
    wing gets an access hole for the aiming adjuster, like the stock ear.
    The nut-clearance check now looks only at the part of the bezel in
    line with the nuts, since the wings pass outside them.
    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
    [bezel_driver.stl, bezel_passenger.stl, fit_test_blade_driver.stl, fit_test_blade_passenger.stl]
2026-09-28 Make the bezel an open frame like the KnightDriveTV bezel
    KnightDriveTV's CAD render and scan show an open frame, not a solid
    face with a tunnel per pod: one opening across the three pods,
    framed by the top rail, end walls and a floor shelf just under the
    pod faces, with a thin round post with flared ends in front of each
    gap between pods. The bezel now follows that. The front line moves
    forward so the posts sit 4 mm behind it, and the under-floor tabs
    now reach forward into the lip.
    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
    [bezel_driver.stl, bezel_passenger.stl, fit_test_blade_driver.stl, fit_test_blade_passenger.stl]
2026-09-28 Recess the pods in a rounded mouth with flared posts
    Following KnightDriveTV's scan: the pods sit 14 mm deeper so the
    lenses glow from a shadowed cavity; the opening is one rounded mouth
    (10 mm corners, flaring 4 mm at the front on the sides and bottom)
    with the top blade left as one clean line; the cavity floor, end
    walls and blade form a continuous shell; the posts are slightly
    elongated front to back with stepped trumpet flares into the shelf
    and blade, trimmed flat behind so they never reach the pods; and the
    lower lip bows forward in the middle. Building the face off the body
    surface still needs a scan of the nose.
    Claude-Session: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
    [bezel_driver.stl, bezel_passenger.stl, fit_test_blade_driver.stl, fit_test_blade_passenger.stl]
2026-09-28 Shorten the apron, smooth the posts and wrap the mouth ends
    - The band below the opening is about half as tall (front 100 mm at
    the hood end, 78 mm at the fender end), with the lower edge rising
    toward the fender, so the opening fills most of the pocket.
    - Each post flare is one smooth trumpet curve, made by warping a
    finely divided extrusion instead of stacking lofts. This also fixes
    the posts being built 18 mm wide instead of 9 mm.
    - The opening is lofted through 13 sections that ease in on a curve:
    9 mm wider at the ends and 4 mm lower along the bottom at the front
    edge, so the ends wrap round with no flat side face.
    - check.py now casts rays from every lens and checks each on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
    [bezel_driver.stl, bezel_passenger.stl, fit_test_blade_driver.stl, fit_test_blade_passenger.stl]
2026-09-28 Rebuild the bezel as a curved face with a slot cut through it
    KnightDriveTV's bezel is a surface with a slot, not a box with a
    front. The bezel now is:
    - a 3 mm face shell with a door-shaped outline (28 mm lower corners,
    10 mm under the door), bowed forward in the middle and forward at
    the bottom;
    - a letterbox slot lofted back to the pods with a 3 mm wall shell;
    - a 6 mm rolled rim down the sides and along the bottom of the slot,
    built as a single swept tube mesh, plus a shadow-line groove under
    the blade;
    - a black mask in front of each pod with holes for the lenses only,
    joined by thin walls at the steps so no pod body shows;
    - posts that spread into the floor like roots and bar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
    [bezel_driver.stl, bezel_passenger.stl, fit_test_blade_driver.stl, fit_test_blade_passenger.stl]
2026-09-28 Add nut channels under the pod slots and round the slot ends
    - From the owner's bracket sketch (square pads with hex holes): two
    rails under each pod slot hold an M8 or 5/16 in nut so it slides
    with the stud but can't turn, so each pod bolts on from above. The
    fender-side rail is trimmed clear of the arm's pivot bolt.
    - The slot's corner radius goes from 10 to 16 mm at the back (25 mm
    at the front edge), for nearly round ends like the reference scan.
    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
    [bezel_driver.stl, bezel_passenger.stl, carrier_driver.stl, carrier_passenger.stl, fit_test_blade_driver.stl, fit_test_blade_passenger.stl]
2026-09-28 Give the bezel face real curves
    - Across the width the face bows 12 mm forward in the middle (was 6).
    - From the side it swells 7 mm forward halfway down and rolls 12 mm
    back at its lower edge, like a chin, instead of a straight slope.
    - The lower edge curves 8 mm down in the middle.
    - A 5 mm rolled edge, swept as one tube mesh, runs right round the
    outside of the face.
    - The slot's lower lip dips 5 mm in the middle, and its rim follows.
    - The wing fronts follow the new side profile.
    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
    [bezel_driver.stl, bezel_passenger.stl, fit_test_blade_driver.stl, fit_test_blade_passenger.stl]
2026-09-28 Add a diagram of how the pods line up on the carrier
    Four views with the bezel hidden: pods lifted over their pockets,
    assembled, from above showing the 12 mm steps, and from underneath
    showing the stud slots and nut rails.
    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
2026-09-28 Add a diagram of how the bezel attaches
    Four labelled views: the bezel pulled forward off the carrier, the
    fork from above, the wing screw from the side, and the two screws up
    through the tabs from underneath.
    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
2026-09-28 Show each pod through one window instead of two lens holes
    The mask in front of each pod now has a single rounded window the
    size of the pod face, with the 1-notch test frame's gap (2.0 mm each
    side, 1.6 mm top and bottom), instead of two round lens holes. The
    step walls between masks still hide the gaps between pods.
    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
    [bezel_driver.stl, bezel_passenger.stl, fit_test_blade_driver.stl, fit_test_blade_passenger.stl]
2026-09-28 Fit the bezel to the owner's model of the headlight doors
    - cover_scan.py measures Covers.stl and places the door on the bezel
    - replace the fork (it stopped short of the clip) with a tongue whose
    skewed groove takes the clip's cross bar, with a chamfered tooth
    - raise the top to follow the door's lip, which drops ~9 mm toward
    the fender; pods, windows and screws stay put
    - tip the bezel for printing so the blade lies as flat as it can
    - fix the blade test print trimming the curved nose
    - 4 new checks (42), cover_fit diagram, README v7
    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
    [bezel_driver.stl, bezel_passenger.stl, fit_test_blade_driver.stl, fit_test_blade_passenger.stl]
2026-09-28 Render the bezel with the headlight door on
    cover_scan.py can also place a lighter copy of the door for rendering;
    diagrams/with_door.png shows four views. The door clears the bracket
    and pods and only touches the blade where its lip sits.
    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
2026-09-28 Screw the bezel ears at the stock location on the headlight door
    Each door side flange has a vertical slot where the stock ear screws
    on. cover_scan.py finds them; the door is now centred on the two
    flanges. A pad on each wing reaches the flange with a pilot hole on
    the slot's line. The fender wing runs back to carry its pad, is
    trimmed under the front of the door's fender flange, and the access
    hole moves clear. Two new checks (44).
    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
    [bezel_driver.stl, bezel_passenger.stl, fit_test_blade_driver.stl, fit_test_blade_passenger.stl]
2026-09-28 Stock-style outside ears, screwed through the door's flange holes
    The owner's photo of a stock headlight shows the ear is a side panel
    outside the door's side flange, held by two screws through its round
    holes, with the aiming access plug. Replace the inside pads with
    separate ear prints that follow the flange (cover_sides.json from
    cover_scan.py), with a hole and boss at every flange hole, a front
    return to the bezel face, the photo's outline, and the plug hole.
    Checks: 48.
    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
    [bezel_driver.stl, bezel_passenger.stl, ear_fender_driver.stl, ear_fender_passenger.stl, ear_hood_driver.stl, ear_hood_passenger.stl, fit_test_blade_driver.stl, fit_test_blade_passenger.stl]
2026-09-28 Re-render assembly diagrams with the ears
    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
2026-09-28 Ears cover the whole door flange, holes flush
    The ear's top edge now runs up under the door's edge, covering the
    flange and all its holes from outside like the stock ear; the bosses
    that stood proud of the face are now flush; the hood ear goes round
    the access plug; cut-through diagram of the screw holes.
    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
    [ear_fender_driver.stl, ear_fender_passenger.stl, ear_hood_driver.stl, ear_hood_passenger.stl]
2026-09-28 Flat bottom and gap-free ears, as marked up by the owner
    Cut the bezel level at z = -18 (just under the carrier lip and screw
    tabs; no sagging chin), smaller lower corners and roll-back. The ears
    now run from the door's painted edge down to the same flat bottom and
    back past the rear screw, with the rear edge rising straight to it.
    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
    [bezel_driver.stl, bezel_passenger.stl, ear_fender_driver.stl, ear_fender_passenger.stl, ear_hood_driver.stl, ear_hood_passenger.stl, fit_test_blade_driver.stl, fit_test_blade_passenger.stl]
2026-09-28 One-piece thin-shell bezel, after the owner's reference photo
    Rebuild the bezel as one continuous 3 mm shell, open at the back:
    U-shaped from above with 30 mm corners into flat tapering ears that
    screw through the door's side-flange holes; three rounded windows with
    posts flaring into the floor and blade; a 7 mm rolled lip into a
    shallow floor (no apron); a flat blade with a front bead that follows
    the door's lip, and a tapered slotted clip tongue.
    - door re-placed 5 mm back (behind the bead); cover_scan.py re-measures
    the flange holes and now maps the door's underside, which the bezel
    is trimmed to (replaces the hand-tuned corner cut)
    - no screws into the carrier; carrier and pods unch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
    [bezel_driver.stl, bezel_driver_fender_piece.stl, bezel_driver_hood_piece.stl, bezel_driver_one_piece.stl, bezel_passenger.stl, bezel_passenger_fender_piece.stl, bezel_passenger_hood_piece.stl, bezel_passenger_one_piece.stl]
2026-09-28 Ears fitted to the stock ear's imprint on the door
    The door's side flanges have a raised band along the top with a 3-5 mm
    recess below it where the stock ear sits. cover_scan.py now measures
    the band's lower edge and fits the recessed surface; each ear's top
    edge runs just under that edge, its inside follows the recess (curved,
    clearing the pocket rims), and it runs back and down to the imprint's
    end - on the fender side sweeping down to the bottom lobe.
    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
    [bezel_driver_fender_piece.stl, bezel_driver_hood_piece.stl, bezel_driver_one_piece.stl, bezel_passenger_fender_piece.stl, bezel_passenger_hood_piece.stl, bezel_passenger_one_piece.stl, fit_test_blade_driver_fender_piece.stl, fit_test_blade_driver_hood_piece.stl]
2026-09-28 Bezel blade 38.1 mm deep to match the stock bezel (S4 = 1.5 in)
    The deeper blade exposed two export problems, now fixed:
    - a one-cell spike in the door underside map notched the hood wall and
    left a pinched edge; single-cell spikes are now filled from their
    neighbours before the clearance cut is built
    - the door cut left a sub-1 mm3 crumb of blade corner floating free;
    pieces under 5 mm3 are dropped
    save() also re-checks that each written STL loads back watertight and
    nudges the centring by microns if float32 rounding pinches it.
    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
    [bezel_driver_fender_piece.stl, bezel_driver_hood_piece.stl, bezel_driver_one_piece.stl, bezel_passenger_fender_piece.stl, bezel_passenger_hood_piece.stl, bezel_passenger_one_piece.stl, fit_test_blade_driver_fender_piece.stl, fit_test_blade_driver_hood_piece.stl]
2026-09-29 Bezel top follows the door's edge round the corners; bottom is one sweep
    - cover_scan measures the door's edge (lowest line of its outer skin)
    round each corner and along each side into cover_sides.json "rim"
    - corner walls, blade ends, bead and ears are trimmed to 0.5 mm under
    it (rim_gap); only the front half of each corner (rim_fade) stays
    higher where the blade and bead come round. The hood ear no longer
    sags below the edge and the fender corner no longer stands above it
    - bottom edge: level round the corner, then a straight sweep to the
    ear tip; the ear turns in over 30 mm (ear_blend), never into the door
    - the door clearance cut now covers the front only, ramping clear at
    i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
    [bezel_driver_fender_piece.stl, bezel_driver_hood_piece.stl, bezel_driver_one_piece.stl, bezel_passenger_fender_piece.stl, bezel_passenger_hood_piece.stl, bezel_passenger_one_piece.stl, fit_test_blade_driver_fender_piece.stl, fit_test_blade_driver_hood_piece.stl]
2026-09-29 Bezel sides: one flat wall from corner to tip, flush with the door's side
    Each side is now a single flat vertical wall fitted to the door's side
    flange (cover_scan saves the plane in cover_sides.json), set just clear
    of the screw tabs, instead of a straight side plus a separate curved ear.
    The corner arc runs tangent into it, so there's no seam. The top still
    follows the door's edge, and at the hood end the tip follows it down to
    a point.
    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
    [bezel_driver_fender_piece.stl, bezel_driver_hood_piece.stl, bezel_driver_one_piece.stl, bezel_passenger_fender_piece.stl, bezel_passenger_hood_piece.stl, bezel_passenger_one_piece.stl, fit_test_blade_driver_fender_piece.stl, fit_test_blade_driver_hood_piece.stl]
2026-09-29 Bezel top flush with the door all round; bottom follows the door's bottom line
    - a thin shelf along the inside of each corner and side, just under the
    door's lip, closes the see-through gap where the lip sits inside the
    wall (up to 15 mm at the corners); it narrows where the door's flange
    hangs down beside the wall. cover_scan records how far inside the wall
    the lip is
    - top edge now 0.05 mm under the door's edge (rim_gap)
    - each side's tip is where the door's edge comes lowest, and the bottom
    runs straight from the corner to it (no foot below the door)
    - door_underside() factored out of door_clearance()
    Claude-Session: https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
    [bezel_driver_fender_piece.stl, bezel_driver_hood_piece.stl, bezel_driver_one_piece.stl, bezel_passenger_fender_piece.stl, bezel_passenger_hood_piece.stl, bezel_passenger_one_piece.stl, fit_test_blade_driver_fender_piece.stl, fit_test_blade_driver_hood_piece.stl]
2026-09-29 Bezel: nothing shows past the door from above; smooth corners
    - the whole bezel is clipped to the door's outline seen from above,
    0.2 mm inside it (outline_gap); cover_scan records the outline
    - each side wall follows that outline; where the door's flange and
    screw tabs come out toward it, the inside is pocketed 0.8 mm clear
    (1 mm grid flange map from cover_scan), min wall 1 mm
    - door front edge 2.5 mm behind the bezel front (cover_edge_n)
    - door clearance cut runs the full width, leaving the pocketed side
    walls alone; corner top trim blends in from the front (no step)
    - tongue taper starts further ahead so the clip bar clears it
    - hole check measures the material in the first mm off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
    [bezel_driver_fender_piece.stl, bezel_driver_hood_piece.stl, bezel_driver_one_piece.stl, bezel_passenger_fender_piece.stl, bezel_passenger_hood_piece.stl, bezel_passenger_one_piece.stl, fit_test_blade_driver_fender_piece.stl, fit_test_blade_driver_hood_piece.stl]
2026-09-29 Pod-sized windows; assembled fit files for both sides
    - one window per pod: the pod face plus the 1-notch test gap
    (2.0 mm each side, 1.6 mm top and bottom), 7.6 mm corners, cut
    straight ahead from each pod; the posts are what's left between
    - stl/assembled/assembly_{passenger,driver}.stl: carrier, bezel and
    pod stand-ins in place on each side, to check the fit
    - check.py: the driver side is the mirror and still fits (56 checks)
    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
    [assembly_driver.stl, assembly_passenger.stl, bezel_driver_fender_piece.stl, bezel_driver_hood_piece.stl, bezel_driver_one_piece.stl, bezel_passenger_fender_piece.stl, bezel_passenger_hood_piece.stl, bezel_passenger_one_piece.stl]
2026-09-29 Pods forward into the windows; bracket reaches back to the same holes
    - each pod comes forward until its face is 3 mm (pod_face_back) behind
    the bezel's front across its window, so the steps follow the front
    (about 12 mm, then 27 mm where it curves into the fender corner);
    the bezel keeps its shape (drawn from pod_layout)
    - the carrier's pod beam comes forward with them; its knees stretch
    back to the unchanged mounting tabs, so the stock holes still line up
    - behind each face the window opens to the pod body's size
    - pockets 2.6 mm deep so they pass under the bezel's floor
    - all 56 checks pass, both sides
    Claude-Session: https: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
    [assembly_driver.stl, assembly_passenger.stl, bezel_driver_fender_piece.stl, bezel_driver_hood_piece.stl, bezel_driver_one_piece.stl, bezel_passenger_fender_piece.stl, bezel_passenger_hood_piece.stl, bezel_passenger_one_piece.stl]
2026-09-29 Window sleeves: each window runs back to meet its pod, flared at the front
    - a 2 mm sleeve round each window from the bezel's front back to its
    pod's face (each pod at its own depth), so there's nothing to see past
    - the opening curves out at the front: 3 mm top and outer ends, 2.5 mm
    bottom, 0.5 mm between pods so the posts stay
    - all 56 checks pass; door clash 0.4 mm3
    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
    [assembly_driver.stl, assembly_passenger.stl, bezel_driver_fender_piece.stl, bezel_driver_hood_piece.stl, bezel_driver_one_piece.stl, bezel_passenger_fender_piece.stl, bezel_passenger_hood_piece.stl, bezel_passenger_one_piece.stl]
2026-09-29 Sleeves wrap each pod; softer curved window openings
    - each window's sleeve carries on 12 mm back past its pod's face
    (sleeve_back), wrapping the pod, the deepest one included
    - the openings curve out more at the front: 4 mm top and bottom, 5 mm
    at the outer ends of the row, 0.5 mm between pods (posts unchanged)
    - no fit changes: pods, windows, door, trims and mounting as before;
    all 56 checks pass, door clash 0.4 mm3
    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
    [assembly_driver.stl, assembly_passenger.stl, bezel_driver_fender_piece.stl, bezel_driver_hood_piece.stl, bezel_driver_one_piece.stl, bezel_passenger_fender_piece.stl, bezel_passenger_hood_piece.stl, bezel_passenger_one_piece.stl]
2026-09-29 Rounder, longer window curves like the reference
    - window corners 10 mm (window_corner_r), still 0.9 mm clear of the pod
    face corners so the pods slide through
    - each opening curves out over 12 mm of depth (sleeve_flare_len): 3.5 mm
    top, 5 mm bottom, 8 mm at the outer ends, 0.5 mm between pods
    - no fit changes; all 56 checks pass, door clash 0.4 mm3
    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
    [assembly_driver.stl, assembly_passenger.stl, bezel_driver_fender_piece.stl, bezel_driver_hood_piece.stl, bezel_driver_one_piece.stl, bezel_passenger_fender_piece.stl, bezel_passenger_hood_piece.stl, bezel_passenger_one_piece.stl]
2026-09-29 Bigger rounded front lip and softer corners, like the reference
    - front lip 12 mm round (lip_r 6); the sides' bottom lines re-slope from
    it to the same tips on the door's line
    - corners turn back round a 45 mm radius (corner_r)
    - carrier trimmed clear of the bigger lip; the corner shelf runs round
    the corner and 45 mm back (the lip sits at the wall further back)
    - nothing past the door from above; all 56 checks pass
    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
    [assembly_driver.stl, assembly_passenger.stl, bezel_driver_fender_piece.stl, bezel_driver_hood_piece.stl, bezel_driver_one_piece.stl, bezel_passenger_fender_piece.stl, bezel_passenger_hood_piece.stl, bezel_passenger_one_piece.stl]
2026-09-29 WIP: CAD bezel builder (build123d) and switch-over in generate.shroud()
    bezel_cad.py lofts one smooth cross-section (rolled lip, floor, 3 mm
    front wall, rail with bead) along one path round the front, 30 mm
    corners and ears, then cuts the windows, tongue, holes and flange
    pockets. generate.shroud() uses its STL when present. Not yet built
    or checked; the STLs in stl/ are unchanged.
    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
2026-09-29 WIP: CAD bezel lofts in runs as surfaces and sews them into one solid
    Fusing separately lofted solids lost most of the body; lofting surface
    runs (halved until OpenCascade takes them) and sewing them along their
    shared section curves keeps it one piece. Still being checked.
    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
2026-09-29 WIP: CAD bezel sections correspond point for point; one loft, no compatibility pass
    Each section gives every corner and edge a fixed number of points so
    the loft can't twist, and OpenCascade's compatibility pass (which
    re-aligned the sections and twisted the corners) is off. The whole U
    now lofts as one surface. Still being built and checked.
    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
2026-09-29 WIP: CAD bezel caches its loft and reports progress through the features
    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
2026-09-29 WIP: CAD bezel shell now one watertight solid
    Lofted in short runs (light surfaces) and sewn along the sections they
    share; the bead always spans the rail top and fades by height, so no
    section folds. Shell exports watertight (133 cm3). Features next.
    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
2026-09-29 Rebuild the bezel as a signed-distance model: one sweep, rounded edges, clean mesh
    The OpenCascade loft folded over itself round the corners and its fillets never
    finished, so bezel_sdf.py builds the same design as a signed distance field and
    meshes it with marching cubes: one spline path, one C section (rolled lip,
    shallow floor, 3 mm wall, thin rail with a bead under the door's lip), ears as
    the flattened ends of the sweep, three 12 mm-corner windows cut through the
    front wall only, a tapered tongue blended into the rail, bosses on the flange
    holes, and the ears cut clear of the door from a sampled door distance field.
    Every edge is rounded 1 mm or more.
    The mesh is snapped onto the exact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
    [bezel_driver_fender_piece.stl, bezel_driver_hood_piece.stl, bezel_passenger_fender_piece.stl, bezel_passenger_hood_piece.stl, fit_test_blade_driver_fender_piece.stl, fit_test_blade_driver_hood_piece.stl, fit_test_blade_passenger_fender_piece.stl, fit_test_blade_passenger_hood_piece.stl]
2026-09-29 Enclose each light in a tunnel from the bezel's front back to the pod
    Each window now runs back as a 3 mm-walled tunnel to 0.5 mm in front of its
    pod's face, so the gaps between the pods, beside the outer pods and under the
    windows are closed. Neighbouring tunnels merge into solid posts and blend into
    the floor and front wall with 2 mm fillets. The solid blocks are blended in
    first and each opening is cut once, so there are no coincident surfaces.
    A final pass relaxes and re-snaps any triangles the simplifier folded, until
    none cross. Still one watertight body with no self-intersections, every
    triangle within 0.04 mm of the surface; pods, carrier, lens views, door and
    outline checks pass. c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
    [bezel_driver_fender_piece.stl, bezel_driver_hood_piece.stl, bezel_passenger_fender_piece.stl, bezel_passenger_hood_piece.stl, fit_test_blade_driver_fender_piece.stl, fit_test_blade_driver_hood_piece.stl, fit_test_blade_passenger_fender_piece.stl, fit_test_blade_passenger_hood_piece.stl]
2026-09-29 Deepen the light tunnels and taper them in to the pods
    Each tunnel now runs 18 mm back past its pod's face, hugging the pod's body
    1 mm clear with 3 mm corners, so the light sits inside it; it stops 6 mm short
    of the pod's bracket, and the pods can still slide 10 mm back. Forward of the
    face the section curves out (a parabola in depth) to the opening at the front:
    12 mm corners, 0.5 mm wider each side, and up to 6 mm taller where the rail
    leaves room. The posts thicken going back.
    The tunnel blocks have flat bottoms on the floor (rounded 15 mm corners there
    left a hollow that cut the post bottoms off), with the blend shrinking to 0.5 mm
    near the floor's underside so it stays flat. One water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
    [bezel_driver_fender_piece.stl, bezel_driver_hood_piece.stl, bezel_passenger_fender_piece.stl, bezel_passenger_hood_piece.stl, fit_test_blade_driver_fender_piece.stl, fit_test_blade_driver_hood_piece.stl, fit_test_blade_passenger_fender_piece.stl, fit_test_blade_passenger_hood_piece.stl]
2026-09-29 Step the pods back evenly: middle pod halfway between the outer two
    The middle pod now sits halfway between the outer two (even_steps), 7.4 mm
    further back than before, so the pods step back in two equal 19.2 mm steps from
    the hood side to the fender side. The carrier's middle step, the middle tunnel
    and the posts follow it. Renders with the headlight cover on added.
    One watertight body, no self-intersections; no clash with the pods, carrier,
    nuts or door; every lens has its clear view. check.py 55/56 (the known 0.40 mm
    lip gap at the hood-side corner).
    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
    [bezel_driver_fender_piece.stl, bezel_driver_hood_piece.stl, bezel_passenger_fender_piece.stl, bezel_passenger_hood_piece.stl, carrier_driver.stl, carrier_passenger.stl, fit_test_blade_driver_fender_piece.stl, fit_test_blade_driver_hood_piece.stl]
2026-09-29 Fit-test rail strip keeps the new rail's full thickness; carrier prints at 45 degrees
    The rail-and-tongue fit test was sliced at the old rail height, so it kept only
    the top 1.4 mm of the new rail (its top now sits 1.3 mm under the door's lip).
    The slice starts 1.3 mm lower. README: the carrier fits the A1 turned 45 degrees
    (229 x 211 mm).
    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
    [fit_test_blade_driver_fender_piece.stl, fit_test_blade_driver_hood_piece.stl, fit_test_blade_passenger_fender_piece.stl, fit_test_blade_passenger_hood_piece.stl]
2026-09-29 Strength pass: fix double-width slots, remove thin slivers, thicken the bezel's weak spots
    Every part was measured for wall thickness (a ray straight through from points
    spread over the surface), aiming for 2.4 mm or more.
    Carrier (now nothing under 2.4 mm):
    - slot_z/slot_y made slots twice as wide as meant (the rectangle was w wide
    before the w/2 round offset): pod stud slots 17.2 mm instead of 8.6, M6
    mounting slots 12.6 instead of 6.3. The nut rails hung on 1.1 mm of floor and
    the pod nut could pull through. Fixed there and in the mount fit test;
    check.py now checks material either side of every slot.
    - removed the unused bosses and upright plates for the old bezel's screws and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
    [bezel_driver_fender_piece.stl, bezel_driver_hood_piece.stl, bezel_passenger_fender_piece.stl, bezel_passenger_hood_piece.stl, carrier_driver.stl, carrier_passenger.stl, fit_test_blade_driver_fender_piece.stl, fit_test_blade_driver_hood_piece.stl]
2026-09-29 One-piece rail fit test; bezel joint with one solid dowel and glue
    - fit_test_blade_{side}_one_piece.stl: the rail/bead/tongue fit test in one
    piece (294 mm long), pre-turned diagonally to fit the A1's bed (229 x 228 mm).
    - The bezel split keeps only the dowel in the floor under the post, where
    there's solid wall round it (96% of a 1 mm ring). The upper hole broke out
    of the 3 mm rail, and no spot on the cut face takes a 12 mm pin with 1 mm of
    wall. The joint is glued over the whole cut face (about 1,230 mm2).
    - check.py checks the dowel hole has wall round it.
    - README: how to join the halves (dry-fit, sand, plastic epoxy, optional
    weld along the inside seam), and the one-piece fi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
    [bezel_driver_fender_piece.stl, bezel_driver_hood_piece.stl, bezel_passenger_fender_piece.stl, bezel_passenger_hood_piece.stl, fit_test_blade_driver_fender_piece.stl, fit_test_blade_driver_hood_piece.stl, fit_test_blade_driver_one_piece.stl, fit_test_blade_passenger_fender_piece.stl]
2026-09-30 Shorten the clip tongue to end where its taper ends (from the car test fit)
    On the owner's test fit the tongue was too long; it clipped on fine once the
    narrow end (the groove for the clip bar and the tooth behind it) was cut off
    where the taper ends. The tongue now ends there, 23 mm behind the rail: 40 mm
    wide at the rail tapering to 23 mm, slot closed 4 mm short of the tip, tip
    chamfered to slide in under the clip. No groove or tooth.
    check.py: the groove/tooth checks are replaced by "the clip's cross bar clears
    the tongue" and "the tongue ends where its taper ends". README: the tongue,
    and to line it up on the moulded line under the headlight door. 58/59 (the
    known 0.40 mm lip gap at the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
    [bezel_driver_fender_piece.stl, bezel_driver_hood_piece.stl, bezel_passenger_fender_piece.stl, bezel_passenger_hood_piece.stl, fit_test_blade_driver_fender_piece.stl, fit_test_blade_driver_hood_piece.stl, fit_test_blade_driver_one_piece.stl, fit_test_blade_passenger_fender_piece.stl]
2026-09-30 Widen the carrier's pod pockets for 3 in wide bracket feet
    The owner's printed carrier had pockets too narrow for the pods (sized for a 43 mm foot).
    Pockets are now 77.7 mm inside (3 in plus 0.75 mm clearance each side); walls go to 3.5 mm
    so neighbouring pockets fuse into one wall instead of leaving a 0.8 mm slit.
    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
    [carrier_driver.stl, carrier_passenger.stl]
2026-10-01 Bezel face styles from the owner's design brief (DRL slots, cut-corner frames, tray and fins)
    bezel_styles.py adds four looks, picked with BEZEL_STYLE (the default build is unchanged):
    A, a light blade along the top under the door's lip; B, raised cut-corner frames round the
    pods with an L-shaped light at each outer end; C, the pods in a recessed tray with tapered fins
    and a lower light bar the fins break into three; BC, B's frames with a lower bar under each pod.
    Each light is a slot through a thin skin with a ledge behind it for a frosted diffuser insert
    and an open-backed channel for the LED strip and wires. build_inserts() meshes the inserts, and
    build(preview=True) makes a quick look. p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
2026-10-02 C7-style bezel face (housing, raked windows and blades, light blade, ladder); open pod pockets
    Code and notes only: the bezel build (bezel_sdf.py, now C7 by default) is still running, and
    the STLs, checks and previews follow in the next commit.
    - bezel_styles.py: the C7 look. The pods sit in a recessed housing with raked ends; the
    windows and the blades between them lean back 10 degrees; a 3 mm light blade runs under
    all three pods, tapering to a point inboard; a ladder of six raked rungs stands past the
    housing at the fender end. Light channels are now described by their profiles (path
    channels, with optional taper, and the ladder's pocket).
    - bezel_sdf.py: tunnels and their blocks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
2026-10-02 Round every edge of the C7 features so the mesh refines and cleans up quickly
    The first full build ran past two hours: a few cut edges were perfectly sharp creases (inside
    the light channels, the housing's floor and the chin's join to the floor), and the refine and
    untangle passes kept splitting at them. Each is now a rounded intersection (0.3 to 1 mm), the
    chin is filleted into the floor's underside, and the light blade's tip tapers to 45% instead of
    30%. untangle logs its progress with the time.
    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
2026-10-02 C7: front-loading light blade, ladder access from behind, chin built into the sweep
    - The light blade's channel is closed at the back by the bezel's floor, so it now loads from
    the front: the 4 mm strip sticks to the channel's back and the frosted diffuser (shaped to
    the tapered opening) presses in flush, 0.3 mm behind the face. A 2.6 mm hole near the
    fender end takes the wires out underneath.
    - The ladder sits 4 mm further round the fender corner (its pocket came within about 1 mm of
    that pod's tunnel) and a raked channel runs straight back from its pocket through the corner
    fill, so its diffuser and strip slide in from behind.
    - The chin is now part of the sweep's own section (Sw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
2026-10-02 C7: clear the last thin spots (housing backing, blade bases, ladder position and channel)
    - the housing's backing runs up into the rail (it stopped 0.5 mm short of it)
    - the blades between the pods are wider than the posts at the housing floor and the windows
    trim them, instead of leaving 0.3 mm ledges
    - the ladder sits 4 mm further round the fender corner: raked, its lower end leaned back
    toward that pod's tunnel; its channel now keeps 2.5 mm of wall to the tunnel at every height
    - the ladder's access channel starts behind the diffuser, not 0.3 mm behind the skin
    Claude-Session: https://claude.ai/code/session_01M5RjfuvJShbeiYoa7cg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
2026-10-02 Styled bezels skip refining and mend any last crossings
    Refining's new points snapped across onto the wrong surface next to the C7 face's thin
    features and folded the mesh, and untangling then fought refining. Styled builds now keep the
    snapped mesh (every vertex on the surface; only flat triangles across the tightest rounds sit
    off it, by less than a print layer), untangle it, and mend() deletes any crossings left with a
    ring round them and closes the holes, leaving one watertight piece. The ladder's access
    channel clears its pocket by 1 mm all round (no thin ledges).
    Claude-Session: https://claude.ai/code/session_01M5RjfuvJShbeiYoa7c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
2026-10-02 C7-style bezel: full build, print files and checks
    - stl/cad/bezel_cad_passenger.stl rebuilt with the C7 face: one watertight piece, no
    self-intersections (a 0.05 mm^3 speck the ladder's channel cut off is dropped; the build now
    does that and mends after)
    - bezel halves, one-piece references, fit-test blades and assemblies regenerated; the carriers
    have the open-fronted pod pockets
    - new stl/drl_diffusers_{passenger,driver}.stl: the light blade's diffuser (247 mm) and the
    ladder's, standing on edge, for natural PCTG
    - check.py: the diffuser file is two pieces on purpose. 60/61 pass; the one left is the known
    0.40 mm gap under the door's lip at the hood-side corner
    - preview/bezel_c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
    [bezel_driver_fender_piece.stl, bezel_driver_hood_piece.stl, bezel_passenger_fender_piece.stl, bezel_passenger_hood_piece.stl, carrier_driver.stl, carrier_passenger.stl, drl_diffusers_driver.stl, drl_diffusers_passenger.stl]
2026-10-02 Three-projector looks (P3J, P3W): three small projectors in square windows, one light strip
    BEZEL_STYLE=P3J: three 1.5 in projectors (46 x 44 mm housings, to confirm) at the pods'
    places, with one front-loading light strip under them that sweeps up past the fender-side
    one (a J). P3W: the strip dips under each projector and peaks in the gaps between them.
    Windows and tunnels are sized to the projectors.
    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
2026-10-02 P3J/P3W: thick light strip, projectors raised 3 mm
    The strip channel is sized for a silicone switchback strip (THICK: 6.5 mm wide, 7 mm deep,
    pressed in flush from the front; it is its own diffuser). The projectors sit 3 mm higher
    than the pods did (PROJ_LIFT) to leave a 9.5 mm band under their windows, and the W's peaks
    start 5 mm clear of each window. Projector housing size (PROJ_W, PROJ_H) is still a guess
    until the real projectors are chosen. Renders: preview/bezel_p3j.png, preview/bezel_p3w.png.
    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
2026-10-02 P3J/P3W sized to the owner's projectors (mini 2.0 in bi-LED, 55 x 48 mm heads)
    From the listing's size drawing: head 55 wide x 48 tall x 50 deep, body 41 wide x 44 deep,
    threaded stem 38 (131 mm overall). The heads sit at z 9.5 to 57.5, between the thick strip and
    the rail (0.5 mm clearance, near-square tunnels); the fender-side head is 8 mm in from the
    pod's place so its body clears the arm's mounting tab, and the middle one halfway for even
    gaps. No overlap with the bezel or the bracket. Renders updated.
    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
2026-10-02 Projector version: bracket with cradles, straps and wiring; bezel tweaks; checks; README
    - generate.py: LIGHTS=projectors builds carrier_projectors(): the same tabs, slots, knees and
    gussets, a beam under three projectors, a cradle round each body (4 mm walls with fan
    windows, bosses for four M4 strap screws, stopping 1 mm in front of the tabs), zip-tie slot
    pairs, and a pad with two M3 holes for a connector or DRL module. projector_straps(),
    projector_dummy(), lights_dummy(). The projector set goes to stl/projectors_<J|W>/.
    bezel_cad_name() picks the bezel model by BEZEL_STYLE.
    - bezel_sdf.py / bezel_styles.py: projector heads sit just behind their tunnels (0.5 mm), the
    strip's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
2026-10-02 Projector sets: P4J (four projectors, bold 10 mm strip), keep-outs and clearances
    - P4J: four heads per side, evenly spaced, each 4 mm behind the face; a 10 mm strip channel
    with an angled sweep up past the fender-side head; the bezel's bottom comes down to -3.5.
    The hood-end projector goes in with its threaded stem off (it would land on the aiming
    pad's bolts); the bracket's beam stops 6.5 mm behind the heads, clear of the lower edge.
    - Cradles stop short of the arm bolts' flange nuts and the pad's square aim adjuster; a short
    cradle gets a rest under the head. P3's hood-side head moves 9.5 mm in so its body clears
    the adjuster.
    - Bezel keeps 2 mm (side) / 0.75 mm (up and down) cl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
2026-10-02 P3J: three projectors in a tight line, bold strip wrapping up the outer end
    Matches the owner's reference render: 6 mm between the heads, the row in the middle of the
    bezel, each front 4 mm behind the face; the bold 10 mm strip under them curves up round the
    fender end (16 mm radius). P3W keeps the spread layout and the 6.5 mm strip.
    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
2026-10-02 Projector print sets P3J and P3W; P4J gets the reference's wide wrap
    - Print files for P3J (three in a line, bold strip) and P3W: carrier, bezel (one piece and
    the two print halves), straps; check.py passes all but the known 0.4 mm lip gap.
    - The bezel's clearance behind each head starts 0.3 mm in front of it (no touching faces).
    - Cradle keep-outs measured to the strap bosses' outside.
    - P4J's strip wraps up the fender end in the same wide curve as P3J.
    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
    [bezel_driver_fender_piece.stl, bezel_driver_hood_piece.stl, bezel_passenger_fender_piece.stl, bezel_passenger_hood_piece.stl, carrier_driver.stl, carrier_passenger.stl, projector_straps_driver.stl, projector_straps_passenger.stl]
2026-10-02 Projector print set P4J (four in a line, bold strip wrapping up the outer end)
    check.py: all pass but the known 0.4 mm lip gap and the hood-end projector's body in the pad
    adjuster's space (documented in the README: check on the car; that projector's stem comes off).
    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
    [bezel_driver_fender_piece.stl, bezel_driver_hood_piece.stl, bezel_passenger_fender_piece.stl, bezel_passenger_hood_piece.stl, carrier_driver.stl, carrier_passenger.stl, projector_straps_driver.stl, projector_straps_passenger.stl]
2026-10-02 P3C: the C7 look round three spread projectors; openings frame the heads
    - P3C: the three heads spread as far as the car allows, in a recessed black housing with
    raked ends and crisp corners (running on past the hood-side head), windows leaning back
    10 degrees, raked fins between them; the bold strip runs under the housing and kicks up
    past its fender end, parallel to it.
    - All projector looks: each opening is 1.5 mm (sides) / 1 mm (top, bottom) smaller than the
    head's face, so the bezel frames it and no gap round the head shows from the front.
    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
2026-10-02 P3J: the owner's goal render, three spread out with the bold strip wrapping up
    The heads move to where P3C's are (as far apart as the car allows, fronts 4 mm behind the
    face), and the strip starts a little before the hood-side one, as in the reference.
    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
2026-10-02 Close the back of the thick and bold strip channels
    The front-loading channels only had walls above and below: their back was left to the bezel's
    floor, which closes the C7's blade but sits above and behind the thick and bold strips, so the
    strip had nothing behind it and the two lips hung free between the ends (on P4J the print split
    left the floor under the first head loose). A 1.5 mm back wall now closes them and ties into
    the floor; the bracket's beam stops 9 mm behind the heads under the bold strip to clear it.
    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
2026-10-02 Projector print sets rebuilt: P3J (the goal), P3C (C7 look), P4J, P3W
    With the framed openings and the closed strip channels. check.py: every set passes all but the
    known 0.4 mm lip gap; P4J also flags its hood-end projector in the pad adjuster's space
    (see the README).
    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
    [bezel_driver_fender_piece.stl, bezel_driver_hood_piece.stl, bezel_passenger_fender_piece.stl, bezel_passenger_hood_piece.stl, carrier_driver.stl, carrier_passenger.stl, projector_straps_driver.stl, projector_straps_passenger.stl]
2026-10-02 P3J: the strip runs the face's full width; strip-choice notes
    The bold strip now starts where the face turns into the hood-side corner. The hook's radius is
    a named setting (HOOK_R) with a note on side-bend strips and their minimum radius.
    check.py: all pass but the known 0.4 mm lip gap.
    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
    [bezel_driver_fender_piece.stl, bezel_driver_hood_piece.stl, bezel_passenger_fender_piece.stl, bezel_passenger_hood_piece.stl]
2026-10-02 Projector stems come off: the listing shows them as a bracket on 4 screws
    The stand-ins leave the stem off by default (proj_stem); the README drops the stem caveats and
    the stems-on depths, and P4J's notes lose the stem requirement.
    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
2026-10-02 J v2: stepped pockets under a sharp brow, thin light line kicking up at both ends
    - Pockets: flat chamfers on the sides (4 mm) and bottom (2.5 mm), narrowing from the face to
    the head; none at the top, a straight sharp brow. Replaces the flared, curved tunnel walls
    that caught the light like slivers.
    - Light line: a 5 mm channel (THIN) the face's full width, kicking up at crisp corners at both
    ends; the bottom edge comes up to -1.2.
    - W and the 4-per-side set are dropped (print files, previews, README); J is the projector set,
    with P3C kept as the C7-styled alternative.
    Claude-Se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
    [bezel_driver_fender_piece.stl, bezel_driver_hood_piece.stl, bezel_passenger_fender_piece.stl, bezel_passenger_hood_piece.stl, carrier_driver.stl, carrier_passenger.stl, projector_straps_driver.stl, projector_straps_passenger.stl]
2026-10-02 J: rounded pocket tops; the light line wraps round the fender corner onto the side
    The pockets' top corners are rounded (4 mm at the head, clear of the lens, to 8 at the face).
    The line's bottom run now carries on round the fender-side corner (a flat bend for the strip)
    and kicks up on the side, short of the ear's screw boss. Preview: the full product.
    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
    [bezel_driver_fender_piece.stl, bezel_driver_hood_piece.stl, bezel_passenger_fender_piece.stl, bezel_passenger_hood_piece.stl]
2026-10-02 J preview: full product sheet with every label in frame
    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
2026-10-02 J: the light line's fender end as a choice of shapes (P3J_END), default unchanged
    hook / crisp / wrap / sweep / corner, for the owner to pick from; the print files keep the
    current wrap round the corner with a kick-up on the side.
    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
2026-10-02 J: the light line curves up at both ends (a 36 mm J at the fender end, 10 mm at the hood end)
    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
    [bezel_driver_fender_piece.stl, bezel_driver_hood_piece.stl, bezel_passenger_fender_piece.stl, bezel_passenger_hood_piece.stl]
2026-10-02 J: recessed face under the rail, shallow bevelled pockets with slim posts
    - The light face (pockets and line) sits 2 mm back in a recess under the top rail, which
    overhangs it like an eyelid; the light line's channel sits in the recess, and the bottom
    edge comes down to -3 with a 1 mm lip under it.
    - The pockets' bevels run from the recess's floor to the head (8 mm sides, 2.5 mm bottom),
    leaving about 8 mm posts between them; the tunnels' solid blocks widen to back them.
    - The wire hole starts from the channel's real back (its depth plus any recess).
    - README: gloss black finish, black screws for the ears (too little plastic to recess them).
    check.py: all pass but the known 0.4 mm lip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
    [bezel_driver_fender_piece.stl, bezel_driver_hood_piece.stl, bezel_passenger_fender_piece.stl, bezel_passenger_hood_piece.stl, drl_inserts_passenger_P3J.stl]
2026-10-02 J: 8 mm diffused light line that wraps the outer pod and runs to the inner edge
    - The line is an 8 mm channel with a printed frosted diffuser pressed in flush
    (drl_diffusers_*.stl, one piece, laid diagonally to fit the bed); the strip sits behind it,
    so it can be cut at the curves without the joins showing.
    - At the fender end it wraps the outer pocket's bottom corner on the same centre (1.2 mm of
    plastic between) and runs straight up beside it; the pockets' bottom corners are rounded to
    match the top ones. At the hood end it runs out onto the corner before curving up.
    - The bracket's beam stops 11 mm behind the heads, clear of the deeper channel.
    - README: satin black as the easy fi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
    [bezel_driver_fender_piece.stl, bezel_driver_hood_piece.stl, bezel_passenger_fender_piece.stl, bezel_passenger_hood_piece.stl, carrier_driver.stl, carrier_passenger.stl, drl_diffusers_driver.stl, drl_diffusers_passenger.stl]
2026-10-02 P3V: the owner's concept sheet, a W light line on J's projector layout
    J's heads, eyelid recess and bevelled pockets (5 mm side bevels, for wider posts), with a 4 mm
    line (LINE4, 5 mm channel, 2 mm frosted diffuser) that runs under the pockets, humps up between
    them round their rounded corners (1.2 mm of plastic all round), leaves the outer pocket's corner
    in a diagonal leg that stops before the tight fender corner, and sweeps up round the curved
    hood-side corner. Preview checks clean; print files to follow.
    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
2026-10-02 W (P3V) print set: the concept sheet's W light line on J's projector layout
    check.py: all pass but the known 0.4 mm lip gap. README section and preview sheet.
    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
    [bezel_driver_fender_piece.stl, bezel_driver_hood_piece.stl, bezel_passenger_fender_piece.stl, bezel_passenger_hood_piece.stl, carrier_driver.stl, carrier_passenger.stl, drl_diffusers_driver.stl, drl_diffusers_passenger.stl]
2026-10-02 J: projectors stand forward of the bezel; swoosh light line
    - The heads come forward 3.5 mm, to 0.5 mm behind the bezel's original face line (the door's
    outline; nothing goes past it, as the assembly swings down into the body), and the light face
    round them is recessed 5 mm (EYELID_J), so they stand up to 4.5 mm proud of it, each in its own
    opening with an even gap (J_LIP: 2 mm sides, 0.75 top and bottom).
    - The light line is one swoosh (P3J_END swoosh, the new default): from the fender-side side
    panel, an S down and forward, round the fender corner low, under the projectors, rising toward
    the hood end. On the side it starts as high and far back as the door's side flange allows. It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
    [bezel_driver_fender_piece.stl, bezel_driver_hood_piece.stl, bezel_passenger_fender_piece.stl, bezel_passenger_hood_piece.stl, carrier_driver.stl, carrier_passenger.stl, drl_diffusers_driver.stl, drl_diffusers_passenger.stl]
2026-10-02 D (P3D): the owner's dual straight DRL concept
    Two light bars (LINE4: 4 mm strips, 5 mm channels, frosted diffusers): one 3 mm under the top
    rail, following it, and one straight below the projectors; both wrap 25 mm onto the hood-side face
    and stop before the tight fender corner. The face covers each head, with a round lens hole
    (LENS_D 42 mm + 2 mm gap). The heads sit 3 mm lower (D_LIFT, proj_lift) to fit the top bar under
    the rail; the bottom edge comes down to -5.7. Preview checks clean; print files to follow.
    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
2026-10-02 D (P3D) print set: dual straight light bars, round lens holes
    check.py: all pass but the known 0.4 mm lip gap. Both bars' diffusers print together, laid
    diagonally (236 x 236 mm).
    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
    [bezel_driver_fender_piece.stl, bezel_driver_hood_piece.stl, bezel_passenger_fender_piece.stl, bezel_passenger_hood_piece.stl, carrier_driver.stl, carrier_passenger.stl, projector_straps_driver.stl, projector_straps_passenger.stl]
2026-10-02 D: squinting, mean eyes
    The top bar runs level across the projectors (no longer following the rail up), then past the
    hood-side projector angles down 35 degrees; the bottom bar angles up 30 degrees over the same
    stretch, so each eye tapers to its inner corner. Preview checks clean; print files to follow.
    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
2026-10-02 D: bevel round each lens hole
    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
2026-10-02 D print set: squinting eyes, bevelled lens holes
    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
    [bezel_driver_fender_piece.stl, bezel_driver_hood_piece.stl, bezel_passenger_fender_piece.stl, bezel_passenger_hood_piece.stl]
2026-10-03 D: the whole eye leans in
    The heads step down toward the hood along a 5 degree slope and both light
    bars run parallel to them, closing to a point at the inner corner. The
    face's bottom edge follows the bottom bar down to the hood-side corner,
    and the bracket's floor steps down under the lowered heads. Each head's
    height is now carried separately through the bezel, bracket and checks.
    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
2026-10-03 D print set: the eye leans in
    Bracket: the step edges sit clear of the feet's outline and each pocket
    covers its whole foot, so the STLs reload watertight. Diffusers: tipped
    back by the tilt so each stands level on its long straight edge. Preview
    re-rendered off the car, without the scanned door.
    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
    [bezel_driver_fender_piece.stl, bezel_driver_hood_piece.stl, bezel_passenger_fender_piece.stl, bezel_passenger_hood_piece.stl, carrier_driver.stl, carrier_passenger.stl, drl_diffusers_driver.stl, drl_diffusers_passenger.stl]
2026-10-03 D: back to the squint (scrap the lean and the sharper wedge)
    The owner didn't like the leaning eye. This restores D as it was at
    b85ab65: level bars, angled in only at the inner end, heads level, the
    plain bracket.
    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
    [bezel_driver_fender_piece.stl, bezel_driver_hood_piece.stl, bezel_passenger_fender_piece.stl, bezel_passenger_hood_piece.stl, carrier_driver.stl, carrier_passenger.stl, drl_diffusers_driver.stl, drl_diffusers_passenger.stl]
2026-10-03 R: Audi R8-style C light line round the three projectors
    D's covered face and bevelled lens holes, with one light line along the
    top, down a leaning round-cornered end at the fender side and back along
    the bottom, open toward the hood, the bottom run reaching further in.
    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
2026-10-03 R print set: C light line, diffuser in two L's
    The C-shaped diffuser is cut across its leaning end into two L's, each
    standing on its long run's straight edge, so neither run prints in the
    air. Preview rendered off the car, without the scanned door.
    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
    [bezel_driver_fender_piece.stl, bezel_driver_hood_piece.stl, bezel_passenger_fender_piece.stl, bezel_passenger_hood_piece.stl, carrier_driver.stl, carrier_passenger.stl, projector_straps_driver.stl, projector_straps_passenger.stl]
2026-10-03 R: recessed housing inside the C, leaning blades between the lenses
    The face steps back 4 mm inside the C (its ends leaning with the C's
    leaning end), so the light line runs on a raised frame, and a slim blade
    stands between each two lenses. The heads move back 4 mm to keep the same
    skin over each. The recess and its fins can now lean on their own, and
    each style can size its fins (C and C7 keep theirs).
    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
2026-10-03 R print set: recessed housing and leaning blades
    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
    [bezel_driver_fender_piece.stl, bezel_driver_hood_piece.stl, bezel_passenger_fender_piece.stl, bezel_passenger_hood_piece.stl, carrier_driver.stl, carrier_passenger.stl, projector_straps_driver.stl, projector_straps_passenger.stl]
2026-10-03 Bezel halves: splice sleeve across the print split, and a joint test print
    On the projector bezels the hood piece carries an L of 2.4 mm plates along
    the inside of the face wall and under the top rail, up to 7 mm into the
    fender piece, which slides onto it: the halves line up and the glue area
    grows several times over. It's trimmed to clear the fender piece's walls
    (0.15 mm) and the projectors. Each projector set also gets a small print
    of the joint to try the fit first.
    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
2026-10-03 Splice sleeve: built from measured wall lines, clean STLs
    The fender-side plates now sit 0.15 mm inside that piece's walls as far
    in as they come along the reach (sampled, conservative between samples,
    chamfered clear of the inside corner's fillet), instead of subtracting
    the walls' rounded outline, which left micro-slivers that pinched the
    saved STLs. The hood-side plates run 0.8 mm into the walls.
    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
2026-10-03 W print set: splice sleeve on the hood piece, joint test print
    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
    [bezel_driver_hood_piece.stl, bezel_joint_test_driver.stl, bezel_joint_test_passenger.stl, bezel_passenger_hood_piece.stl]
2026-10-03 J print set: splice sleeve on the hood piece, joint test print
    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
    [bezel_driver_hood_piece.stl, bezel_joint_test_driver.stl, bezel_joint_test_passenger.stl, bezel_passenger_hood_piece.stl]
2026-10-03 D print set: splice sleeve on the hood piece, joint test print
    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
    [bezel_driver_hood_piece.stl, bezel_joint_test_driver.stl, bezel_joint_test_passenger.stl, bezel_passenger_hood_piece.stl]
2026-10-03 R and C7-look print sets: splice sleeve, joint test print
    The C7-look set also picks up the current bracket and its light line's
    diffusers, which it hadn't been regenerated for.
    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
    [bezel_driver_hood_piece.stl, bezel_joint_test_driver.stl, bezel_joint_test_passenger.stl, bezel_passenger_hood_piece.stl, carrier_driver.stl, carrier_passenger.stl]
2026-10-03 Photoreal render tools: Blender Cycles scene built from the CAD files
    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
2026-10-03 R: sculpting: strakes on the hood-side panel, gills at the fender corner, honeycomb housing
    Grooves are cut into the surfaces with 45 degree sides (nothing passes the
    door's outline), the honeycomb is raised 0.6 mm on the housing's floor,
    clear of its walls and the lens holes. Grooves and honeycomb are generic
    style options (Style.grooves, Style.honey).
    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
2026-10-03 R print set: strakes, gills, honeycomb housing
    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
    [bezel_driver_fender_piece.stl, bezel_driver_hood_piece.stl, bezel_joint_test_driver.stl, bezel_joint_test_passenger.stl, bezel_passenger_fender_piece.stl, bezel_passenger_hood_piece.stl]
2026-10-03 Sculpt map: the face can take a sculpted form (Sweep.relief)
    The style can set relief(a, z), how far back the face sits there; the
    shell's section and everything on the face (light channels, housing, lens
    holes, diffusers) follow it. R has three trial forms behind R_SHAPE
    (visor, wedge, scoop), off by default; its heads move back by the form's
    deepest point over them.
    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
2026-10-03 W and J: round lens openings, extended DRL lines around both corners
    The face now covers each projector head, leaving only a round lens hole.
    W's wave runs around both side panels and J's swoosh runs along the hood
    side and under the fender boss. Visor relief and honeycomb are on by
    default, and the dowel boss follows the visor setback.
    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
2026-10-03 J: light line drawn to rules (one bend radius, constant edge offset)
    The line now runs a constant height over the bottom edge round the face,
    turns up on the hood-side panel as the corner ends, and runs back parallel
    to the hood edge. On the fender side the old Z is replaced by one S that
    ends parallel to the bottom edge, under the screw boss. Every turn uses one
    25 mm radius. The old freehand swoosh stays available as J_LINE=swoosh.
    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
